asrob-uc3m/impresoras-asrob/README.md

# impresoras-asrob
Ficheros de configuración e issues de las impresoras Blacky e Hija Resurrection

Actualmente existe un grupo de trabajo activo trabajando en ellas. Para más información, visitar: [Printer One: A Clone Wars Story](https://asrob.uc3m.es/workgroups/2017-05-28-printer-one.html)
