asrob-uc3m/impresoras-asrob/Spicy/Marlin/RADME.md

Ficheros de configuración para Marlin 1.1.9: https://github.com/MarlinFirmware/Marlin/releases/tag/1.1.9
