asrob-uc3m/impresoras-asrob/Reto Clone Wars OSHWDem 2018/Readme.md

# Reto Clone Wars OSHWDem 2018

En esta carpeta se alojaran los diseños para la OSHWDem 2018
