asrob-uc3m/impresoras-asrob/Backup S.O configuraciones y aplicaciones de equipos de impresion/README.md

## Backup de Sistema Operativo, configuraciones y aplicaciones de los equipos de impresión de Blacky e Hija Resurrection





Este obra está bajo una licencia de [Creative Commons Reconocimiento-NoComercial-CompartirIgual 3.0 Unported.
](http://creativecommons.org/licenses/by-nc-sa/3.0/deed.es_ES)

Para llevar a cabo el proceso de restauración o backup del sistema completo, se ha empleado la herramienta Clonezilla. Clonezilla es un software libre de recuperación ante desastres, sirve para la clonación de discos y particiones. Clonezilla está diseñado por Steven Shaiu y desarrollado por el NCHC Labs en Taiwán.
Durante el proceso de restauración backup, la versión empleada fué "stable - 2.5.2-31", sin embargo, para procesos posteriores de backup y/o restauración, puede emplearse la versión actual, dado que se trata de un sofware retrocompatible.
Clonezilla puede descargarse en caso de ser necesario desde el acceso ( [descargar](http://clonezilla.org/downloads.php) ). 

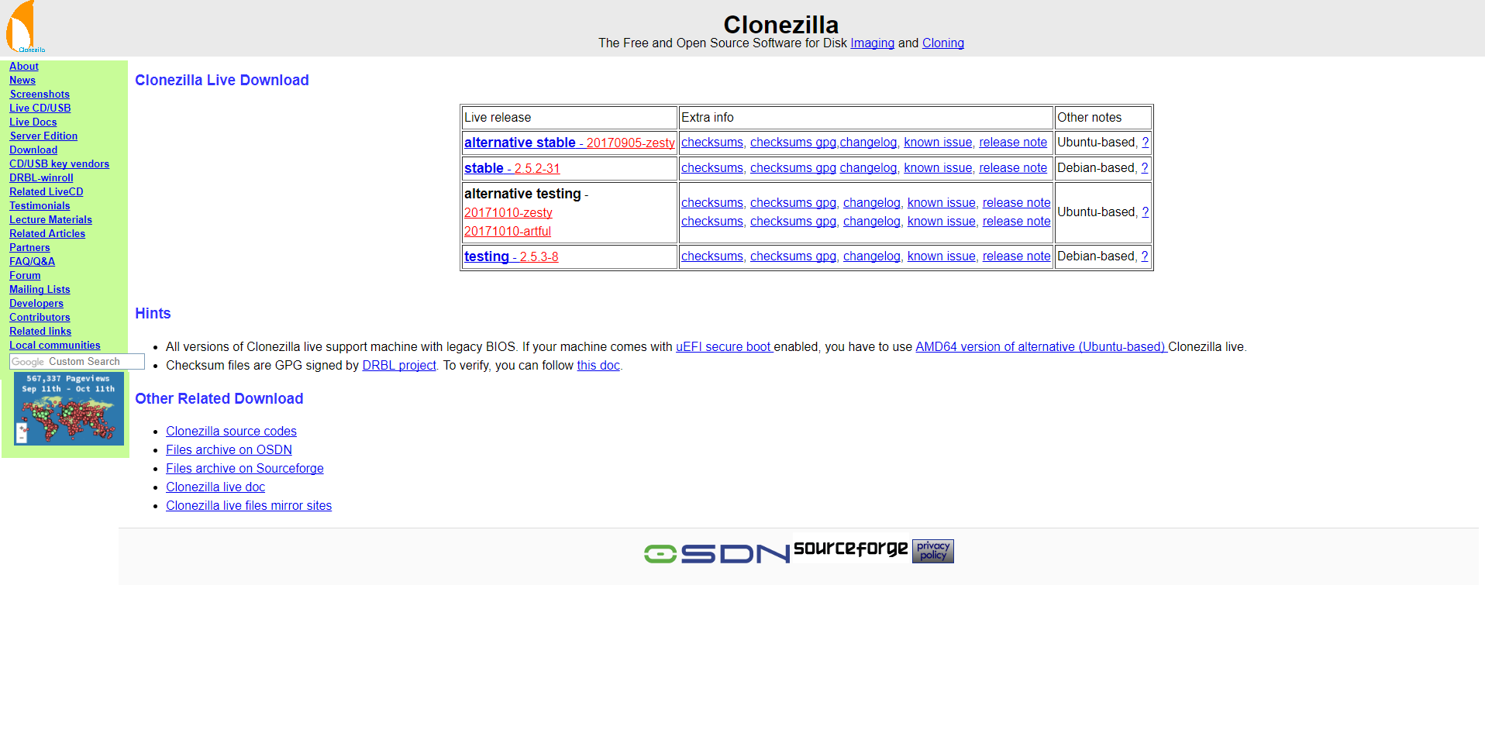
[picture p1: Backup S.O configuraciones y aplicaciones de equipos de impresion/Clonezilla.png]


*Figura 1: Descarga de DVD Live Clonezilla*

### 1- Backup del sistema

Para acceder a la imagen de backup del sistema operativo, configuraciones y aplicaciones de los ordenadores ASROB de control de las impresoras Blacky e Hija Resurrection haga clic ( [descargar](https://sourceforge.net/projects/asrob/files/Backup_OS_3D_Printers_PCs/) ). 

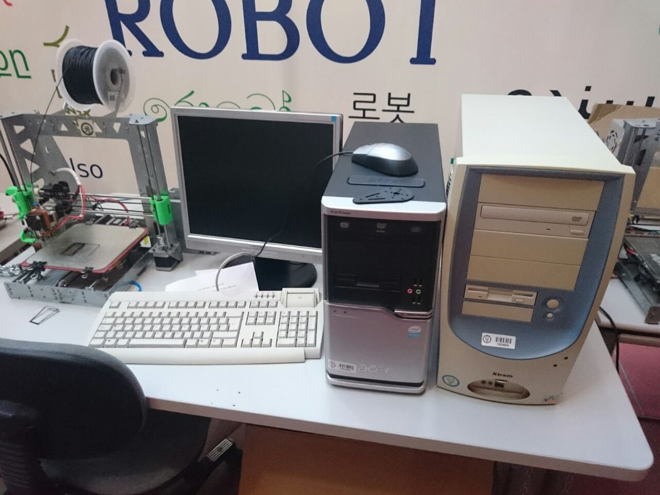
[picture p2: Backup S.O configuraciones y aplicaciones de equipos de impresion/PC.jpg]


*Figura 2: Backup del sistema*

### 2- Reinstalación del backup 

Para llevar a cabo la reinstalación de un Backup ya realizado, por favor, consulte el manual de mantenimiento de las impresoras, en el ANEXO 3, mediante( [acceder](https://github.com/asrob-uc3m/impresoras-maintenance-manual-i3/blob/master/anexo_3_reinstalacion_de_sistema_operativo_software_y_configuraciones_desde_backup.md) )

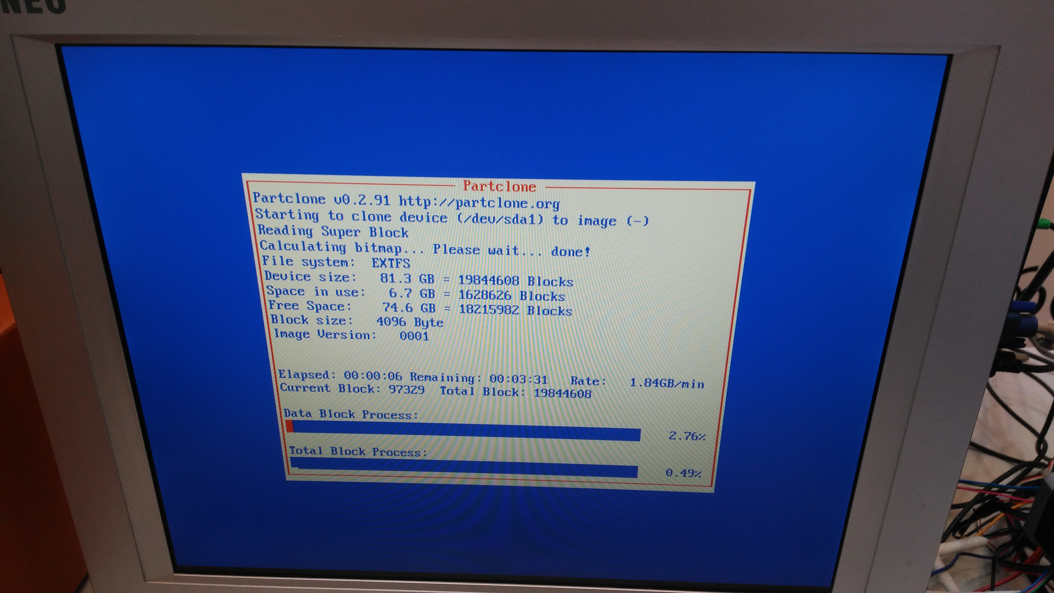
[picture p3: Backup S.O configuraciones y aplicaciones de equipos de impresion/Proceso_de_backup_19.jpg]


*Figura 3: Reinstalación del Backup*

### 3- Realizar un nuevo backup del sistema

Para llevar a cabo la un nuevo  Backup del sistema, por favor, consulte el manual de mantenimiento de las impresoras, en el ANEXO 4, facilitado, mediante( [acceder](https://github.com/asrob-uc3m/impresoras-maintenance-manual-i3/blob/master/anexo_4_proceso_de_backup_del_s.o_configuraciones_y_software.md) )

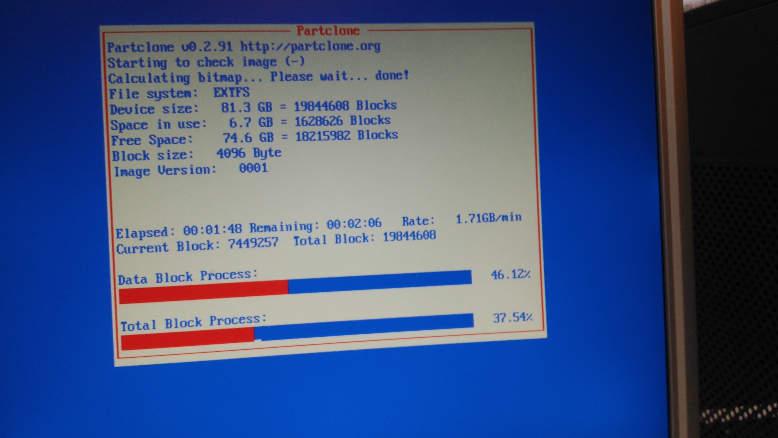
[picture p4: Backup S.O configuraciones y aplicaciones de equipos de impresion/Proceso_de_backup_20.jpg]


*Figura 4: Proceso de backup*

Para más información, fuente ( [Clonezilla](http://clonezilla.org/clonezilla-usage/general-live-use.php) ).
