asrob-uc3m/impresoras-asrob/Backup_Codigo-Web_Operadores/README.md

## Backup código sito web Operadores

Se adjuntan los backup del sitio web de la lista de operadores autorizados.
Adjuntos dos formatos:

1. Sitio web antes del 18/10/2017
2. Sitio web actualizado el 18/10/2017
