asrob-uc3m/impresoras-asrob/Hija Resurrection/README.txt

ARCHIVOS DE CONFIGURACIÓN DE LA IMPRESORA HIJA RESURRECTION:

Configuration.h -> Fichero de configuración de Marlin Firmware (a bordo de la Arduino). Contiene
parámetros imprescindibles para el correcto funcionamiento de la impresora.

config.ini -> Archivo de más importante de configuración de impresión, exportado desde Slic3r,
para usarlo seguir las siguientes instrucciones dentro del programa Repetier-Host ->
Slic3r/Configure/-> File -> Load Config...

slic3r.ini - Repetier-Host
custom.ini -> Repetier-Host/data
mlib.ini -> Repetier-Host/python/Lib/numpy/core/lib/npy-pkg-config
npymath.ini -> Repetier-Host/python/Lib/numpy/core/lib/npy-pkg-config
docutils.conf -> Repetier-Host/python/Lib/numpy ->f2py/docs
ParserDetails.ini -> Repetier-Host/Slic3r/lib/std/XML/SAX

ARCHIVOS DE CONFIGURACIÓN DEL PC DE LA IMPRESORA HIJA RESURRECTION:

guest-session-auto.sh -> Script de generación de usuario en sesión de invitado, creación al inicio de sesión y autodestrución con el logout de la misma.
