asrob-uc3m/impresoras-asrob/Blacky/Slic3r/1.3.0/README.md

Fichero de configuración para Slic3r 1.3.0: https://github.com/slic3r/Slic3r/releases/tag/1.3.0
