asrob-uc3m/impresoras-asrob/Backup S.O configuraciones y aplicaciones de equipos de impresion/proceso_de_backup.png

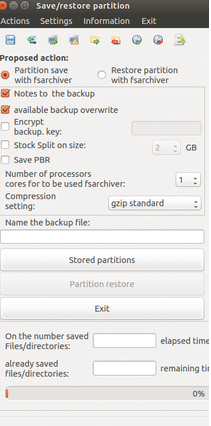
Backup S.O configuraciones y aplicaciones de equipos de impresion/proceso_de_backup.png
