asrob-uc3m/impresoras-asrob/Backup S.O configuraciones y aplicaciones de equipos de impresion/restaurar_backup.png

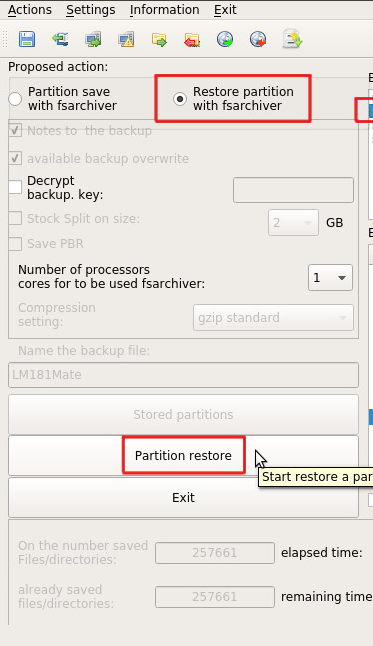
Backup S.O configuraciones y aplicaciones de equipos de impresion/restaurar_backup.png
