asrob-uc3m/impresoras-asrob/Hija Resurrection/Parts/Readme.md

# Información sobre las Piezas (orden alfabético)

* Extruder:
  * Extrusor.

* LCD:
  * Caja pantalla Full Graphic.

* Power Supply:
  * Piezas para la fuente de alimentación.

* X axis: 
  * Tensor eje X.
  * Carro eje X.

* Z axis: 
  * Ajuste fino de altura de Z.
