asrob-uc3m/impresoras-asrob/Dedalo/Parts/Readme.md

# Información sobre las Piezas (orden alfabético)

* 160mm_spool_holder_prusa.stl -> Soportes de sujección de la bobina de filamento. [Thingiverse](https://www.thingiverse.com/thing:91724).

* Bed leveling.stl -> Pieza de calibracion de la cama caliente. En ella van encajadas tuercas M3 para su fácil movimiento, y posterior ajuste de cama. [Thingiverse](https://www.thingiverse.com/thing:2333767).

* Cubierta Ventilador Externo Dédalo.stl -> Es la protección y sujección del ventilador más grande que posee Dédalo, que actualmente se necuentra ventilando la electrónica. (Diseño de [@daavm](https://github.com/daavm)). No disponible en Thingiverse.

* S26_Jonaskuehling_gregs_wade_v3_arcol_jhead_x1.stl -> Cuerpo del extrusor con agujeros para mejor anclaje del extrusor. [Thingiverse](https://www.thingiverse.com/thing:141915).

* frame-vertex-no-foot.stl -> Uniones superiores de las varillas del triángulo. Pendiente añadir enlace a Thingiverse.

* frame-vertex.stl -> Uniones inferiores de las varillas del triángulo. Pendiente añadir enlace a Thingiverse.

* mounting_plate.stl -> Pieza de sujección del extrusor. [Ya no forma parte de Dédalo](https://github.com/asrob-uc3m/impresoras-asrob/issues/31#issuecomment-343311065). Pendiente añadir enlace a Thingiverse.

* wade_custom_obijuan.stl -> Engranaje grande del extrusor. Pendiente de añadir enlace a Thingiverse.

* x-carriage.stl -> Carro del eje X. [Thingiverse](https://www.thingiverse.com/thing:181524). ATENCIÓN, antes de imprimir esta pieza de nuevo, revisar [esto](https://github.com/asrob-uc3m/impresoras-asrob/issues/31#issuecomment-336418170).
