asrob-uc3m/impresoras-asrob/Hija Resurrection/Parts/Extruder/Readme.md

# Información sobre las Piezas (orden alfabético)

* Bearing_Washer.stl -> Arandela para el rodamiento que va junto al engranaje grande. [Thingiverse](https://www.thingiverse.com/thing:512338).

* Blower_duct.stl -> Conducto para el ventilador de capa. Diseñado para blower 40x40x20. [Siotma](https://github.com/Siotma).

* Body_E3dv6_Washer.stl -> Arandela para ajutar el hotend en el hueco. [Siotma](https://github.com/Siotma).

* Gregs_Wade_Big_Gear_47.stl -> Engranaje grande del extrusor.

* Gregs_Wade_Small_Gear_9.stl -> Engranaje pequeño del extrusor.

* Idler.stl -> Apriete del filamento contra el Hobbed Bolt. [Thingiverse](https://www.thingiverse.com/thing:1855673).

* Idler_holder.stl -> Pestaña para ajustar el Idler. [Thingiverse](https://www.thingiverse.com/thing:1855673).

* Wade_L3K_custom_body_1.75_centered.stl -> Cuerpo del extrusor. Remix de [L3K](https://www.thingiverse.com/thing:512338).

* Wade_L3K_custom_flange_1.75_v2_mirrored.stl -> Apriete del hotend. Remix de [L3K](https://www.thingiverse.com/thing:512338).

* Extra: [Enlace a la issue de montaje](https://github.com/asrob-uc3m/impresoras-asrob/issues/84).
