asrob-uc3m/impresoras-asrob/Hija Resurrection/Parts/LCD/Readme.md

# Información sobre las Piezas (orden alfabético)

* case_top.STL -> Tapa superior de la caja de la pantalla LCD Full Graphic. [Thingiverse](https://www.thingiverse.com/thing:638833).

* case-bottom.stl -> Tapa inferior de la caja de la pantalla LCD Full Graphic. [Thingiverse](https://www.thingiverse.com/thing:638833).

* rotary_knob.STL -> Pomo de la ruleta giratoria de la pantalla LCD Full Graphic. [Thingiverse](https://www.thingiverse.com/thing:638833).
