asrob-uc3m/impresoras-asrob/Hija Resurrection/Parts/Power Supply/Readme.md

# Información sobre las Piezas (orden alfabético)

* Power_Supply_cover-P3steel.STL -> Cubierta de los contactos e interruptor de la fuente de alimentación. [Thingiverse](https://www.thingiverse.com/thing:2158480).

* Extra: [enlace a la issue de montaje](https://github.com/asrob-uc3m/impresoras-asrob/issues/68).
