asrob-uc3m/impresoras-asrob/Hija Resurrection/Parts/X axis/Readme.md

# Información sobre las Piezas (orden alfabético)

* x_carriage_holder_jg7.stl -> Apriete de la correa del carro del eje X. [Thingiverse](https://www.thingiverse.com/thing:701087).

* x_carriage_jg7.stl -> Carro del eje X. Hay que insertar una tuerca durante la impresión. [Thingiverse](https://www.thingiverse.com/thing:701087)

* xaxis_idler.stl -> Cuerpo del tensor del eje X. [Thingiverse](https://www.thingiverse.com/thing:247992)

* xaxis_idler_holder_rev02.stl -> Montura de la polea de la correa del eje X. [Thingiverse](https://www.thingiverse.com/thing:247992)

* xaxis_idler_tensioner_rev02.stl -> Tensor del eje X. [Thingiverse](https://www.thingiverse.com/thing:247992)
