asrob-uc3m/impresoras-asrob/Hija Resurrection/Parts/Z axis/Readme.md

# Información sobre las Piezas (orden alfabético)

* Z_Level_Adjstment_Foot_PFM.STL -> Pie del tornillo de ajuste fino de altura. [Thingiverse](https://www.thingiverse.com/thing:1776429).

* Z_Level_Adjstment_Switch_Mount_PFM.STL -> Montura del endstop de ajuste fino de altura. [Thingiverse](https://www.thingiverse.com/thing:1776429).

* Z_level_Fine_Adjustment_Leg_PFM.STL -> Montura del tornillo de ajuste fino de altura. [Thingiverse](https://www.thingiverse.com/thing:1776429).
