asrob-uc3m/impresoras-asrob/Blacky/Parts/README.MD

Aquí podremos encontrar las piezas de recambio para **Blacky**:
https://www.thingiverse.com/thing:371842

_Originalmente son para la impresora "Prusa I3 Hephestos"._
