asrob-uc3m/impresoras-asrob/Blacky/Parts/Extruder/Blower_duct_v2.stl

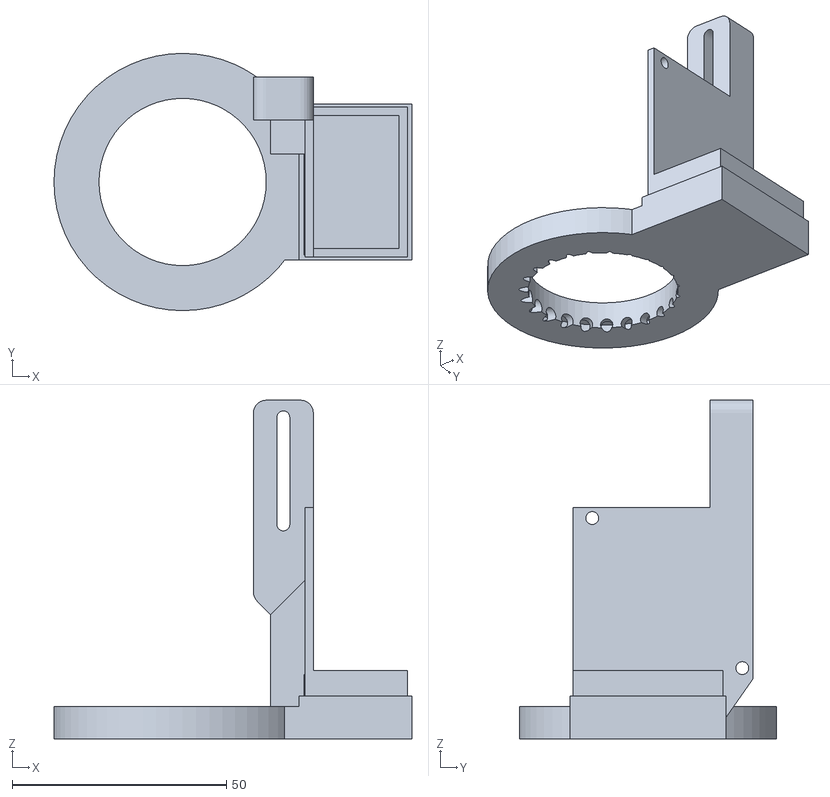
[picture p34: CAD file, 2019-01-30]
Blacky/Parts/Extruder/Blower_duct_v2.stl
83.5 x 60.0 x 79.0
