asrob-uc3m/impresoras-asrob/Blacky/Parts/LCD/lcd-hinge.stl

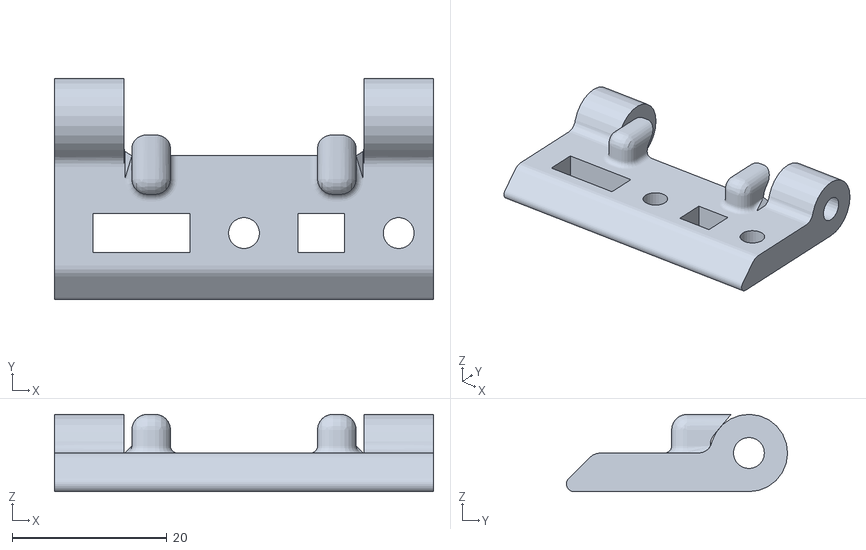
[picture p35: CAD file, 2017-12-14]
Blacky/Parts/LCD/lcd-hinge.stl
49.0 x 28.6 x 10.0
