asrob-uc3m/impresoras-asrob/Dedalo/Parts/S26_Jonaskuehling_gregs_wade_v3_arcol_jhead_x1.stl

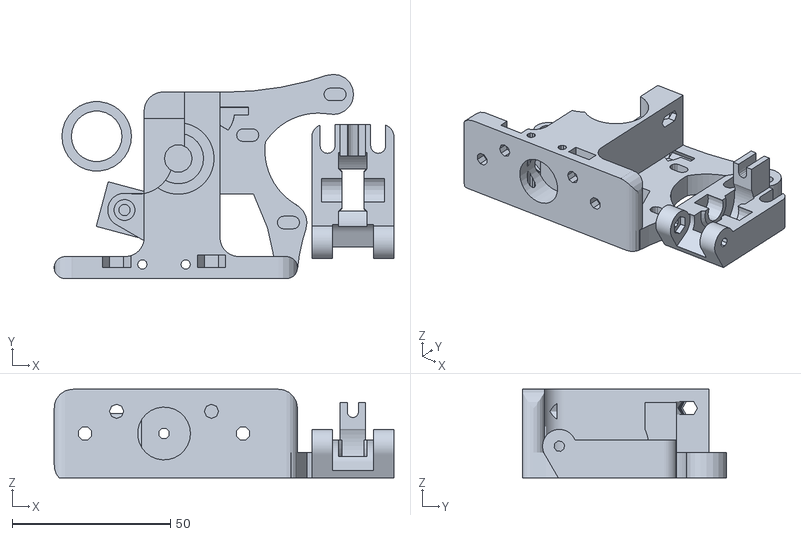
[picture p36: CAD file, 2017-12-09]
Dedalo/Parts/S26_Jonaskuehling_gregs_wade_v3_arcol_jhead_x1.stl
107.5 x 64.6 x 28.0
