asrob-uc3m/impresoras-asrob/Geonosis/Parts/equerre_moteur_X.STL

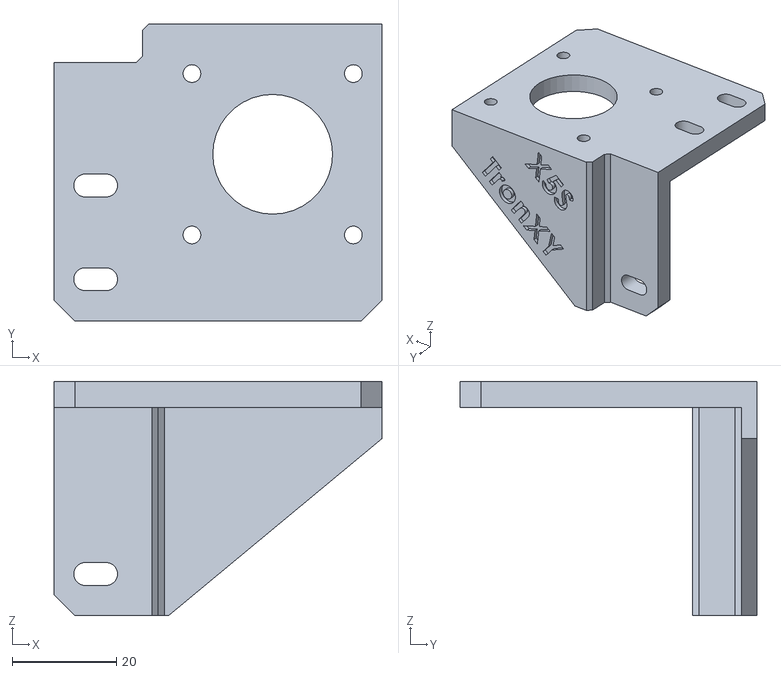
[picture p37: CAD file, 2018-09-19]
Geonosis/Parts/equerre_moteur_X.STL
63.0 x 57.0 x 45.0
