asrob-uc3m/impresoras-asrob/Hija Resurrection/Parts/Extruder/Wade_L3K_custom_flange_1.75_v2_mirrored.stl

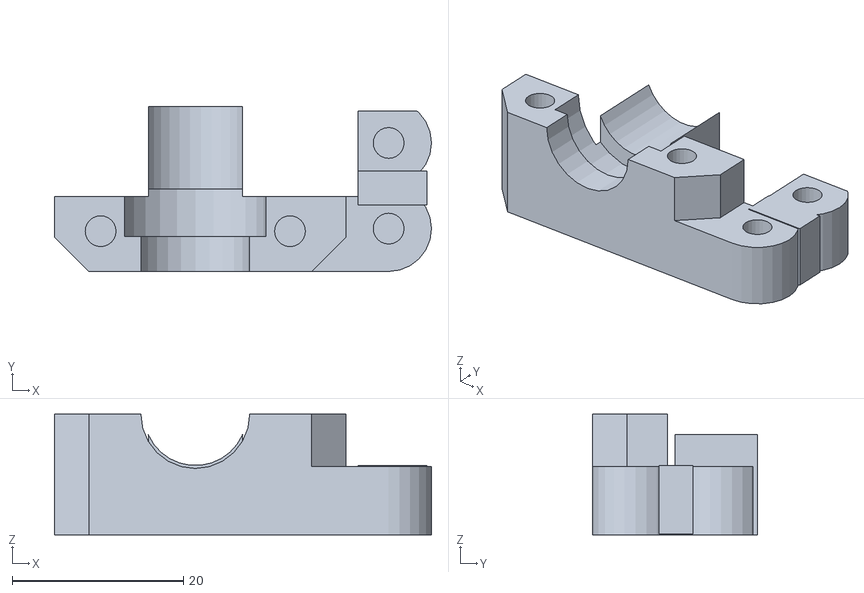
[picture p38: CAD file, 2018-10-14]
Hija Resurrection/Parts/Extruder/Wade_L3K_custom_flange_1.75_v2_mirrored.stl
44.0 x 19.3 x 14.1
