asrob-uc3m/impresoras-asrob/Hija Resurrection/Parts/LCD/case-bottom.stl

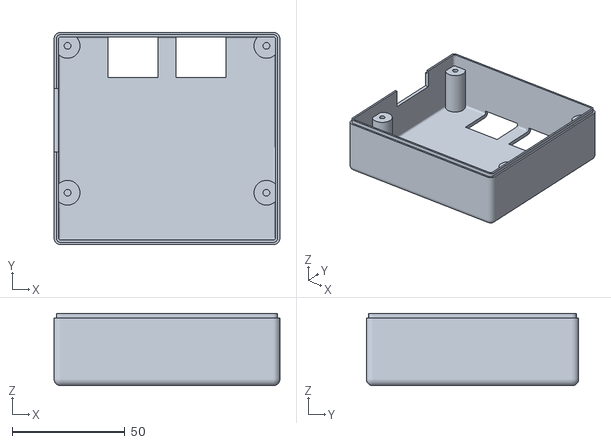
[picture p39: CAD file, 2018-10-14]
Hija Resurrection/Parts/LCD/case-bottom.stl
100.0 x 94.0 x 32.0
