asrob-uc3m/impresoras-asrob/Hija Resurrection/Parts/Power Supply/Power_Supply_cover-P3steel.STL

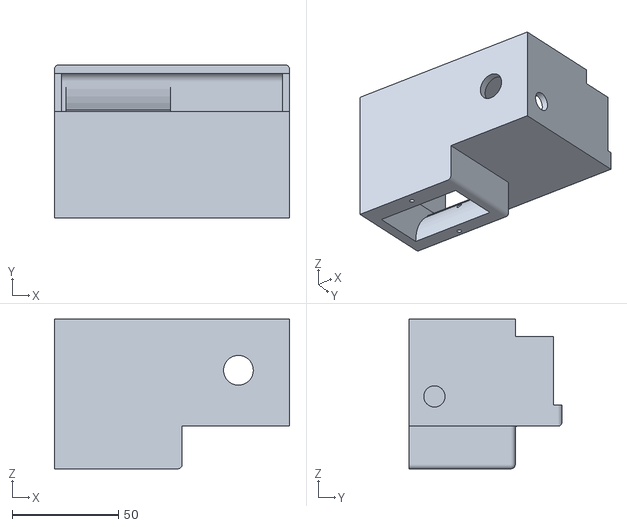
[picture p40: CAD file, 2018-10-14]
Hija Resurrection/Parts/Power Supply/Power_Supply_cover-P3steel.STL
110.4 x 72.0 x 70.3
