asrob-uc3m/impresoras-asrob/Hija Resurrection/Parts/X axis/x_carriage_holder_jg7.stl

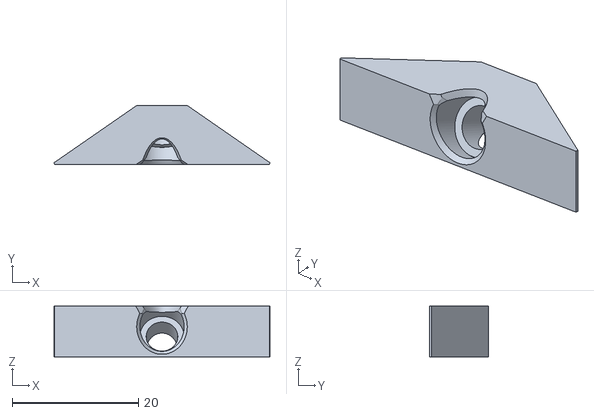
[picture p41: CAD file, 2018-10-14]
Hija Resurrection/Parts/X axis/x_carriage_holder_jg7.stl
34.2 x 9.35 x 8.00
