asrob-uc3m/impresoras-asrob/Hija Resurrection/Parts/Z axis/Z_Level_Adjstment_Foot_PFM.STL

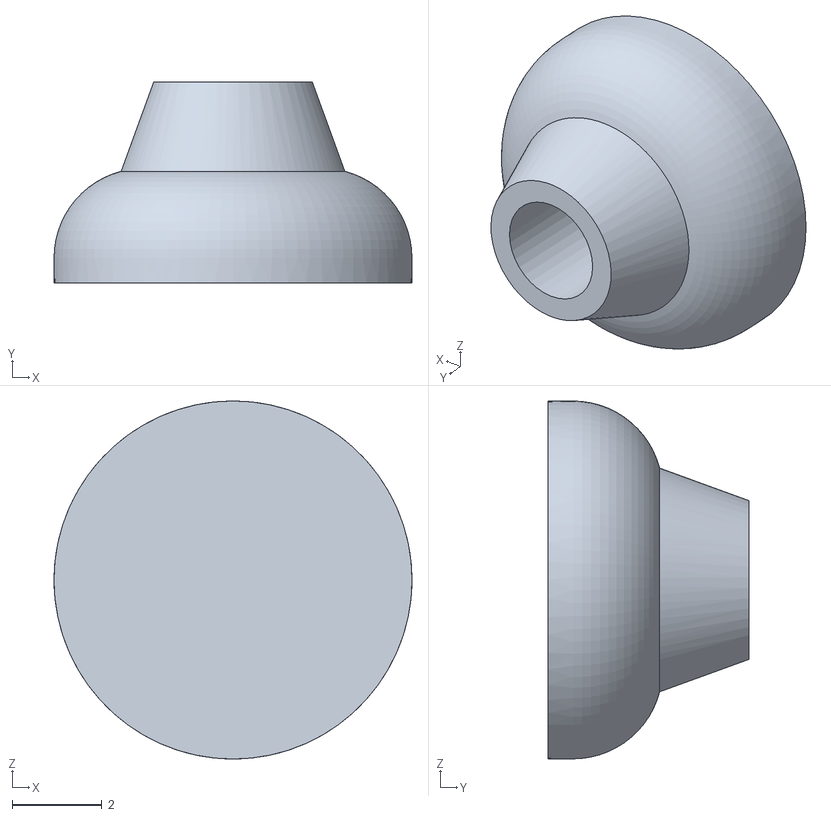
[picture p42: CAD file, 2018-10-14]
Hija Resurrection/Parts/Z axis/Z_Level_Adjstment_Foot_PFM.STL
8.00 x 4.50 x 8.00
