asrob-uc3m/impresoras-asrob/Reto Clone Wars OSHWDem 2018/N-34 ASROB_repaired.3mf

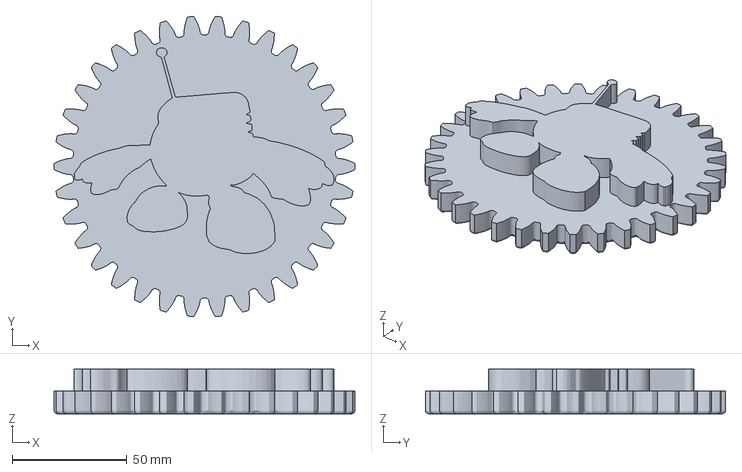
[picture p43: CAD file, 2018-10-24]
Reto Clone Wars OSHWDem 2018/N-34 ASROB_repaired.3mf
131.4 x 131.1 x 19.5 mm
