asrob-uc3m/impresoras-asrob/Spicy/Parts/Anet_A8_Fan_Optimized.stl

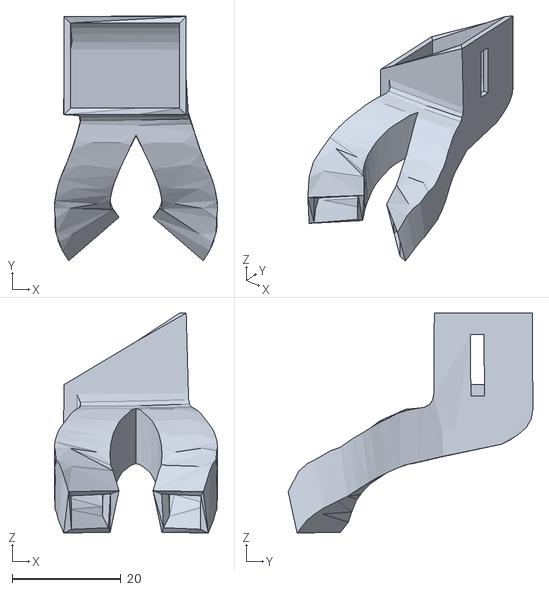
[picture p44: CAD file, 2018-09-19]
Spicy/Parts/Anet_A8_Fan_Optimized.stl
30.0 x 45.0 x 40.4
