asrob-uc3m/impresoras-asrob/Blacky/Parts/LCD/Soporte_lcd.stl

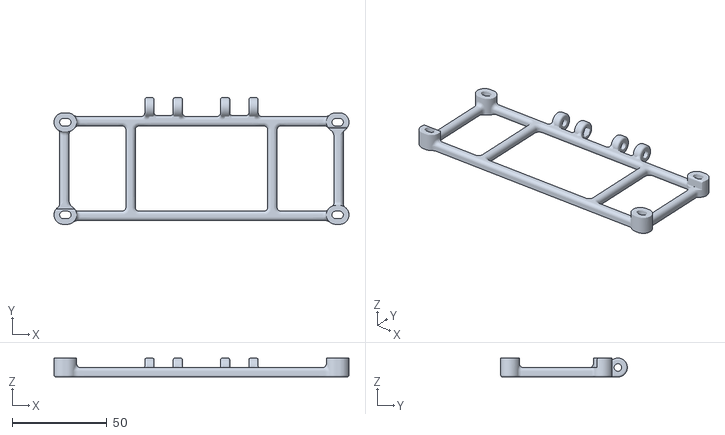
[picture p45: CAD file, 2017-12-14]
Blacky/Parts/LCD/Soporte_lcd.stl
156.0 x 67.0 x 10.0
