asrob-uc3m/impresoras-asrob/Dedalo/Parts/x-carriage.stl

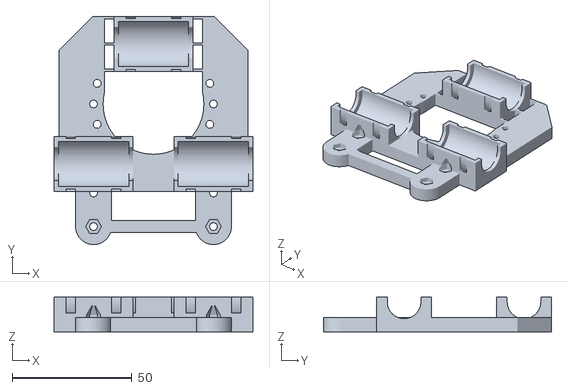
[picture p46: CAD file, 2017-12-09]
Dedalo/Parts/x-carriage.stl
83.0 x 95.2 x 14.5
