asrob-uc3m/impresoras-asrob/Geonosis/Parts/Sym_equerre_moteur_X.STL

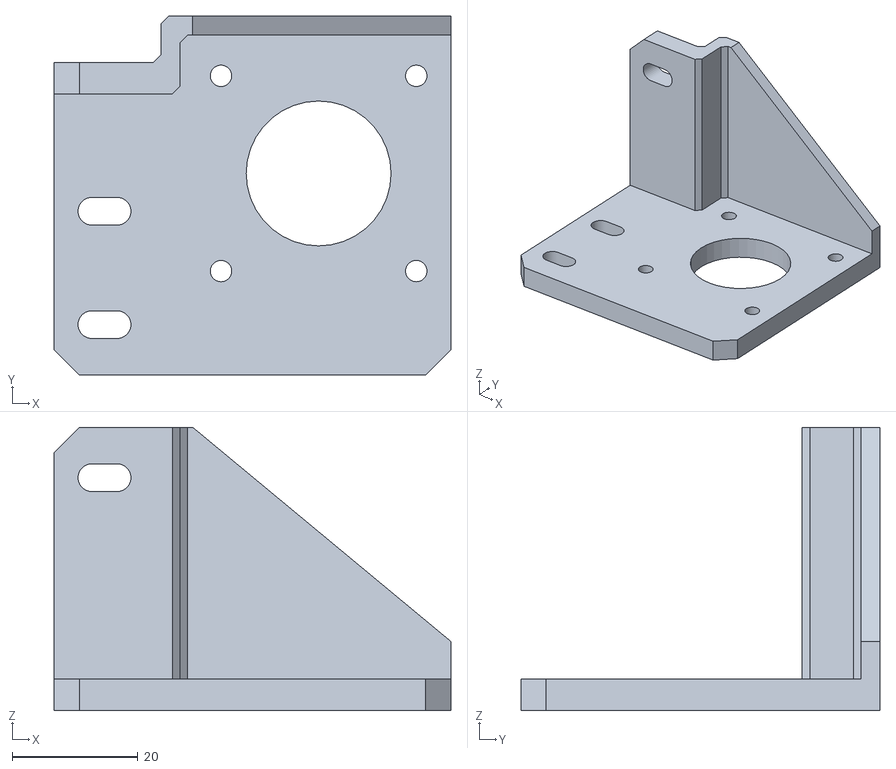
[picture p47: CAD file, 2018-09-19]
Geonosis/Parts/Sym_equerre_moteur_X.STL
63.0 x 57.0 x 45.0
