asrob-uc3m/impresoras-asrob/Hija Resurrection/Parts/Extruder/Wade_L3K_custom_body_1.75_centered.stl

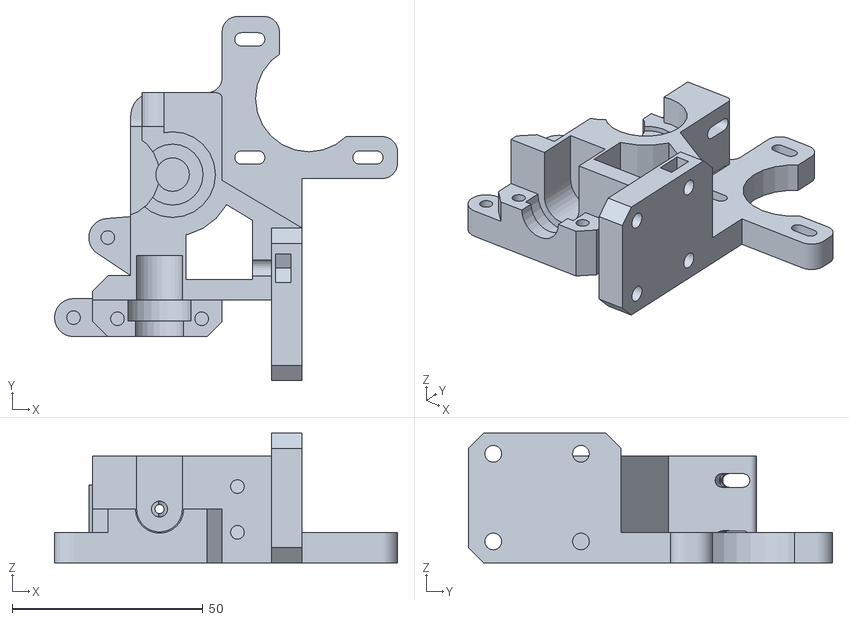
[picture p48: CAD file, 2018-10-14]
Hija Resurrection/Parts/Extruder/Wade_L3K_custom_body_1.75_centered.stl
90.0 x 95.5 x 34.0
