asrob-uc3m/impresoras-asrob/Hija Resurrection/Parts/LCD/case_top.STL

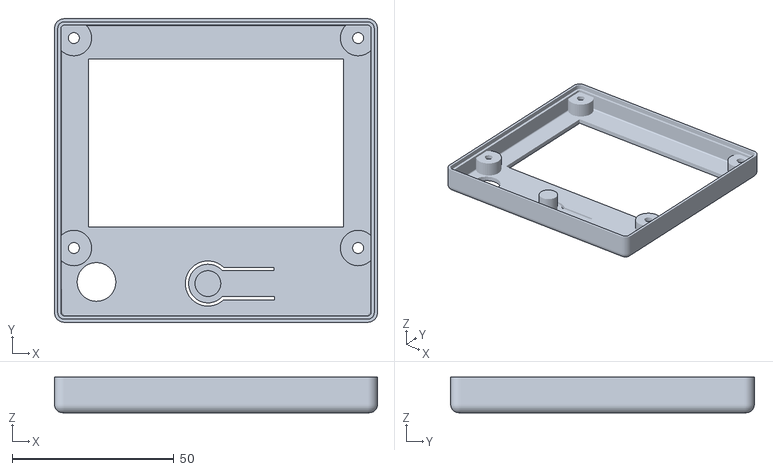
[picture p49: CAD file, 2018-10-14]
Hija Resurrection/Parts/LCD/case_top.STL
100.0 x 94.0 x 11.0
