asrob-uc3m/impresoras-asrob/Hija Resurrection/Parts/X axis/xaxis_idler.stl

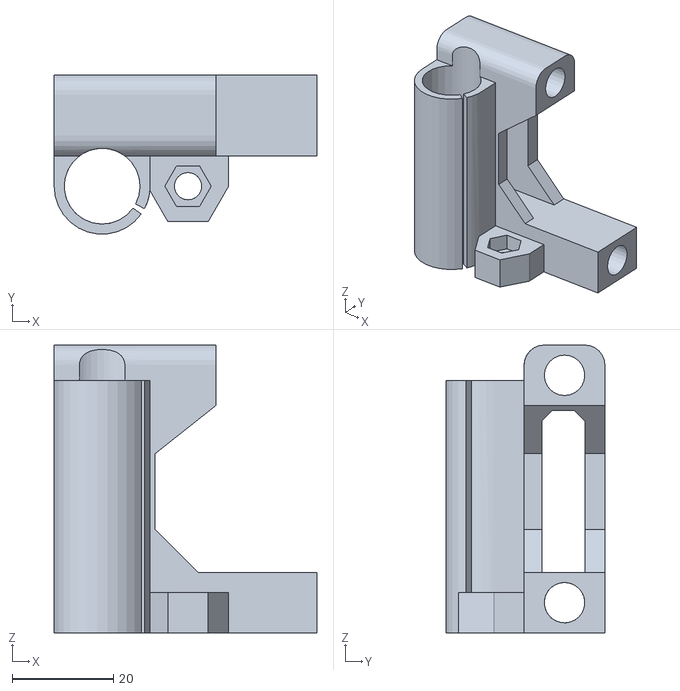
[picture p50: CAD file, 2018-10-14]
Hija Resurrection/Parts/X axis/xaxis_idler.stl
52.0 x 31.5 x 57.0
