asrob-uc3m/impresoras-asrob/Hija Resurrection/Parts/Z axis/Z_level_Fine_Adjustment_Leg_PFM.STL

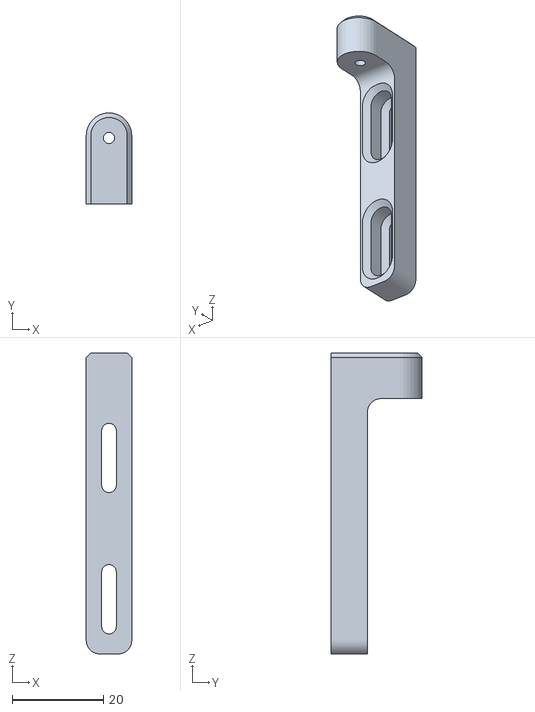
[picture p51: CAD file, 2018-10-14]
Hija Resurrection/Parts/Z axis/Z_level_Fine_Adjustment_Leg_PFM.STL
10.00 x 20.0 x 66.0
