asrob-uc3m/impresoras-asrob/Reto Clone Wars OSHWDem 2018/N-34 Printer_repaired.3mf

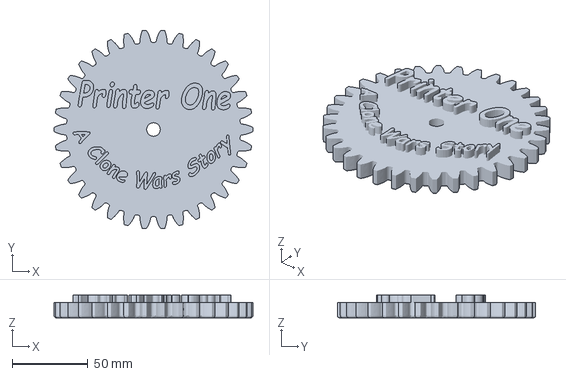
[picture p52: CAD file, 2018-10-24]
Reto Clone Wars OSHWDem 2018/N-34 Printer_repaired.3mf
131.4 x 131.1 x 15.0 mm
