asrob-uc3m/impresoras-asrob/Blacky/Parts/Extruder/Idler_hodler.stl

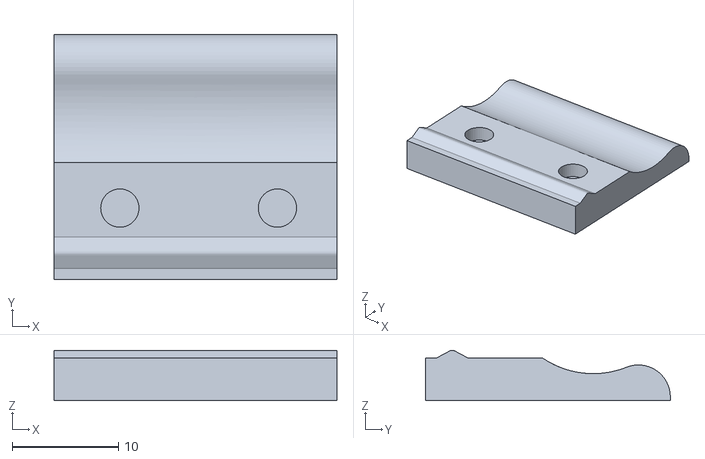
[picture p53: CAD file, 2018-10-14]
Blacky/Parts/Extruder/Idler_hodler.stl
26.6 x 23.0 x 4.73
