asrob-uc3m/impresoras-asrob/Dedalo/Parts/160mm_spool_holder_prusa.stl

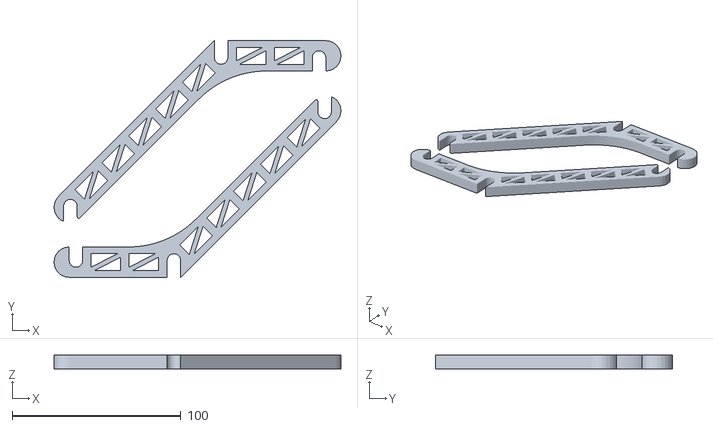
[picture p54: CAD file, 2017-12-09]
Dedalo/Parts/160mm_spool_holder_prusa.stl
169.9 x 140.2 x 8.00
