asrob-uc3m/impresoras-asrob/Hija Resurrection/Parts/LCD/rotary_knob.STL

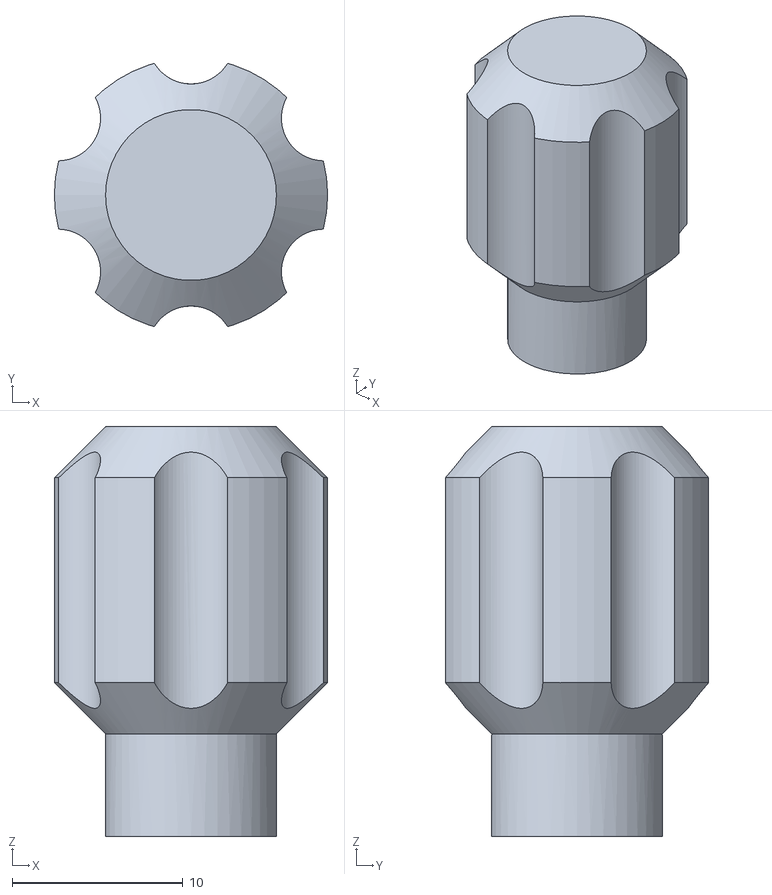
[picture p55: CAD file, 2018-10-14]
Hija Resurrection/Parts/LCD/rotary_knob.STL
16.0 x 15.4 x 24.0
