asrob-uc3m/impresoras-asrob/Hija Resurrection/Parts/X axis/xaxis_idler_holder_rev02.stl

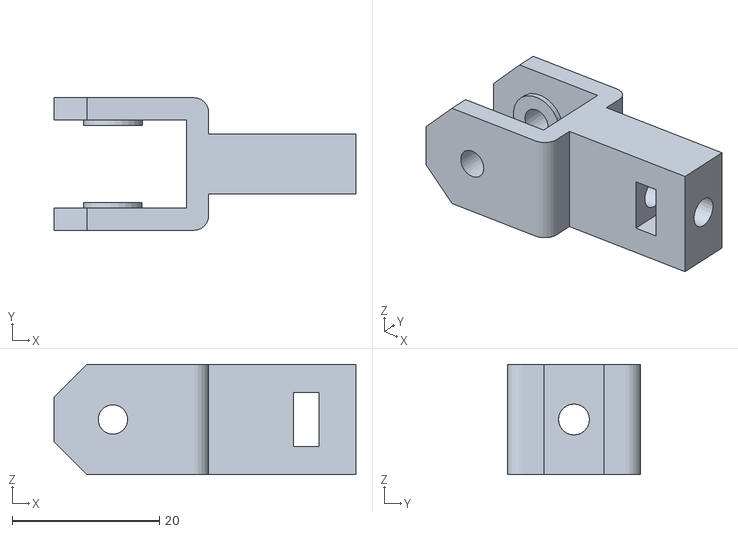
[picture p56: CAD file, 2018-10-14]
Hija Resurrection/Parts/X axis/xaxis_idler_holder_rev02.stl
41.0 x 18.0 x 15.0
