asrob-uc3m/impresoras-asrob/Hija Resurrection/Parts/Z axis/Z_Level_Adjstment_Switch_Mount_PFM.STL

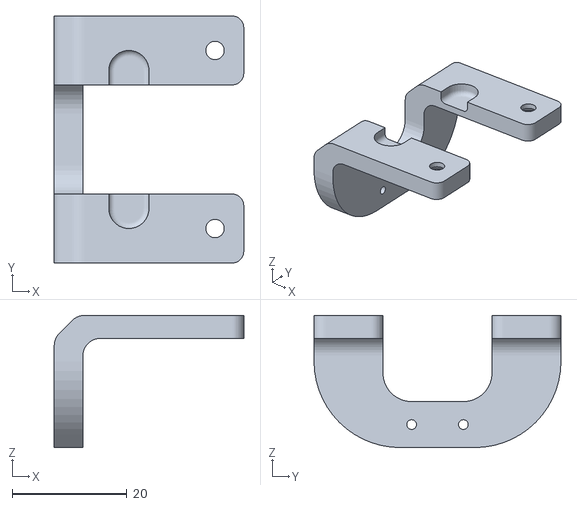
[picture p57: CAD file, 2018-10-14]
Hija Resurrection/Parts/Z axis/Z_Level_Adjstment_Switch_Mount_PFM.STL
33.0 x 43.0 x 23.0
