asrob-uc3m/impresoras-asrob/Reto Clone Wars OSHWDem 2018/N34-ASROB.FCStd

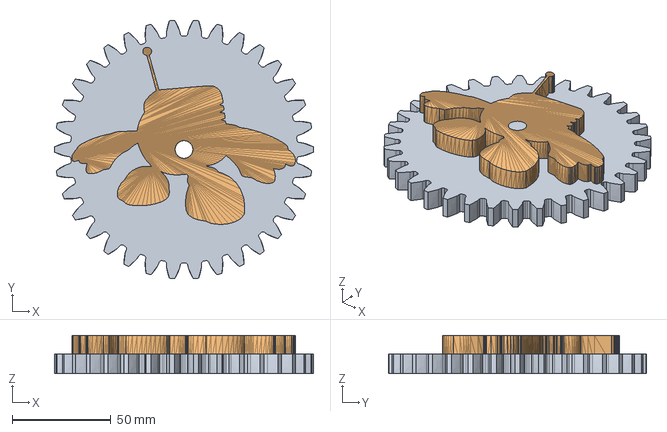
[picture p58: CAD file, 2018-10-24]
Reto Clone Wars OSHWDem 2018/N34-ASROB.FCStd
131.4 x 131.1 x 19.5 mm
