asrob-uc3m/impresoras-asrob/Dedalo/Parts/mounting_plate.stl

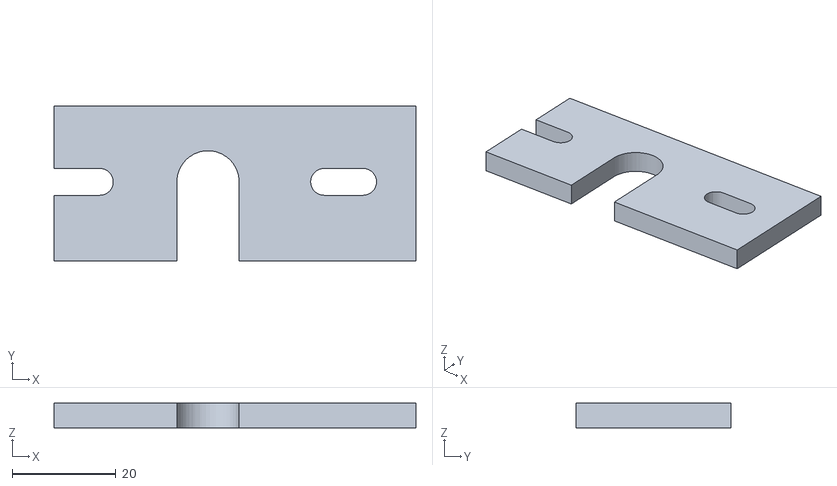
[picture p59: CAD file, 2017-12-06]
Dedalo/Parts/mounting_plate.stl
69.8 x 29.8 x 4.76
