asrob-uc3m/impresoras-asrob/Hija Resurrection/Parts/Extruder/Gregs_Wade_Small_Gear_9.stl

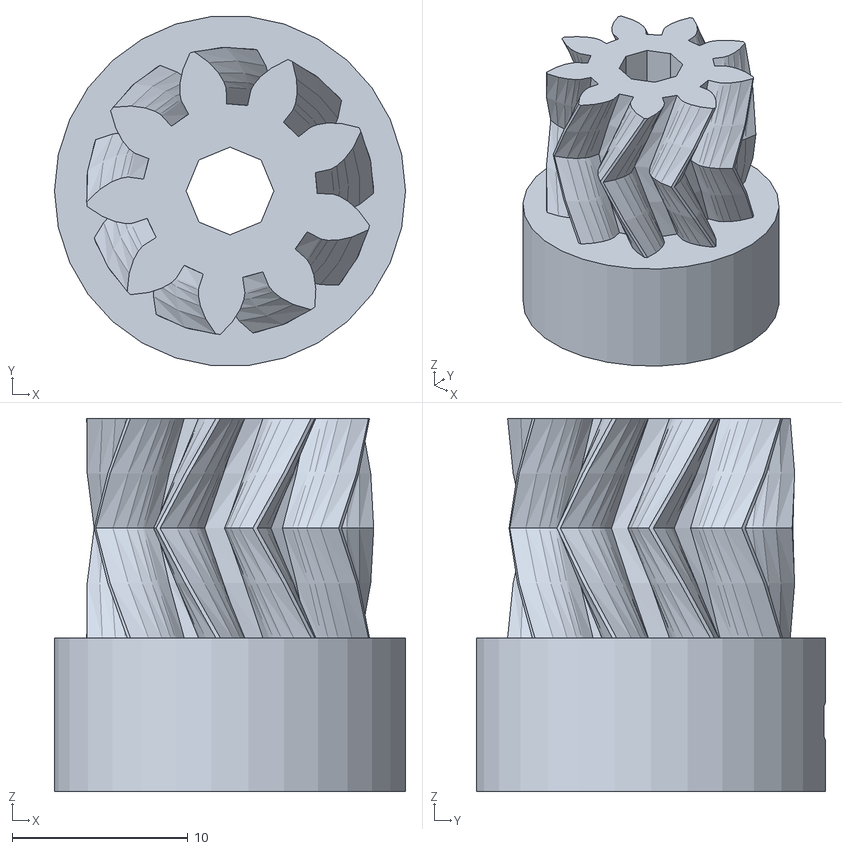
[picture p60: CAD file, 2018-02-02]
Hija Resurrection/Parts/Extruder/Gregs_Wade_Small_Gear_9.stl
20.0 x 19.9 x 21.3
