asrob-uc3m/impresoras-asrob/Hija Resurrection/Parts/X axis/x_carriage_jg7.stl

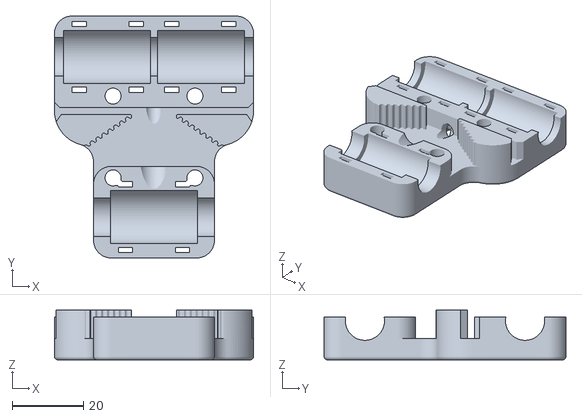
[picture p61: CAD file, 2018-10-14]
Hija Resurrection/Parts/X axis/x_carriage_jg7.stl
56.0 x 68.0 x 14.0
