asrob-uc3m/impresoras-asrob/Reto Clone Wars OSHWDem 2018/N34-Printer.FCStd

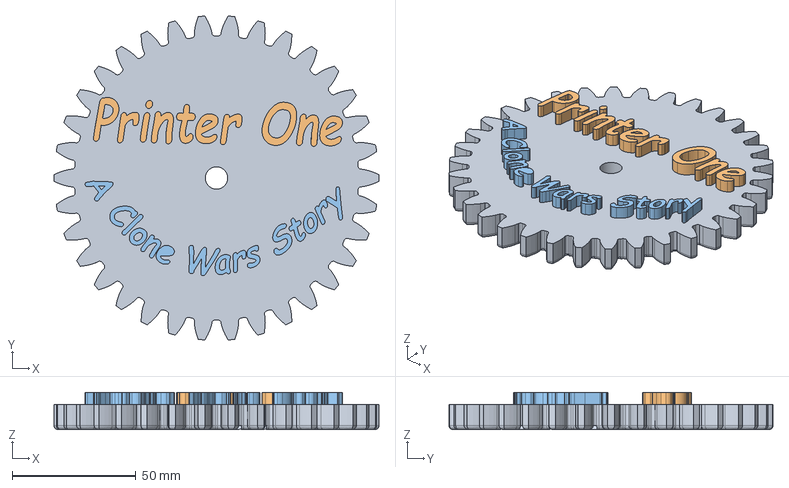
[picture p62: CAD file, 2018-10-24]
Reto Clone Wars OSHWDem 2018/N34-Printer.FCStd
131.4 x 131.1 x 15.1 mm
Clone of Fusion
Clone of Fusion001
