asrob-uc3m/impresoras-asrob/Blacky/Parts/Extruder/Idler.stl

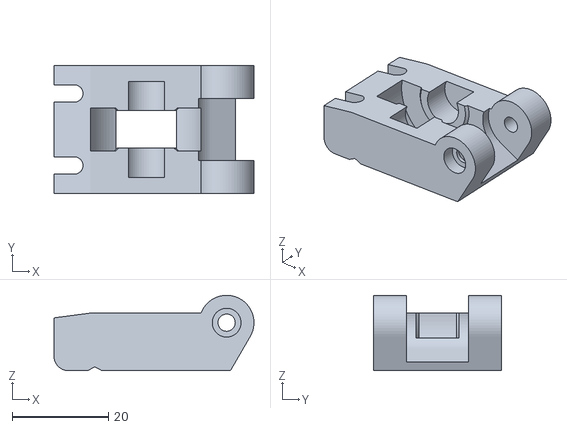
[picture p63: CAD file, 2018-10-14]
Blacky/Parts/Extruder/Idler.stl
41.7 x 26.6 x 15.7
