asrob-uc3m/impresoras-asrob/Dedalo/Parts/wade_custom_obijuan.stl

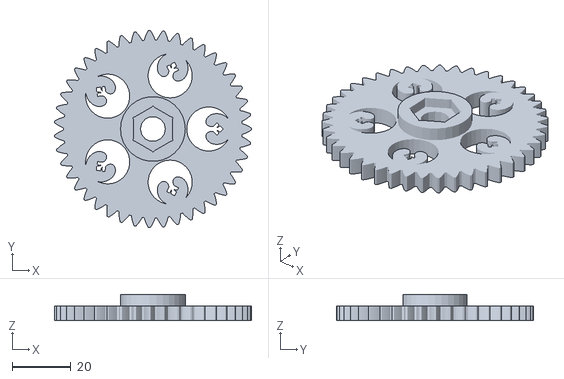
[picture p64: CAD file, 2017-12-06]
Dedalo/Parts/wade_custom_obijuan.stl
66.9 x 67.0 x 9.00
