asrob-uc3m/impresoras-asrob/Hija Resurrection/Parts/Extruder/Gregs_Wade_Big_Gear_47.stl

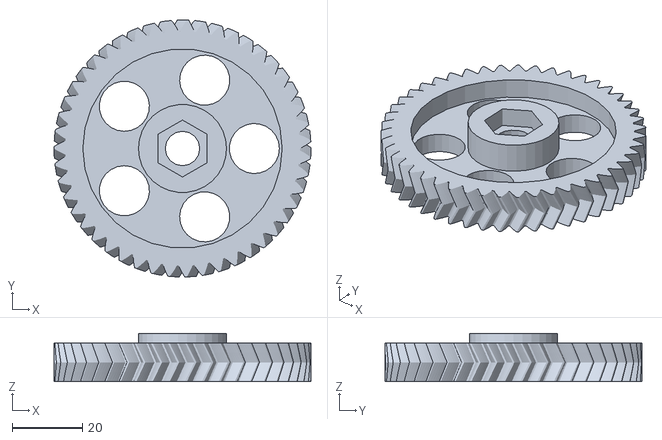
[picture p65: CAD file, 2018-02-02]
Hija Resurrection/Parts/Extruder/Gregs_Wade_Big_Gear_47.stl
73.0 x 73.0 x 13.8
