asrob-uc3m/impresoras-asrob/Hija Resurrection/Parts/X axis/xaxis_idler_tensioner_rev02.stl

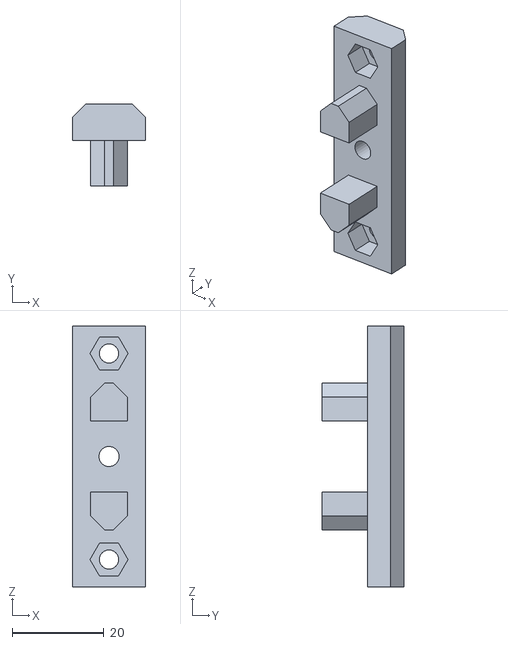
[picture p66: CAD file, 2018-10-14]
Hija Resurrection/Parts/X axis/xaxis_idler_tensioner_rev02.stl
16.0 x 18.0 x 57.0
