asrob-uc3m/impresoras-asrob/Dedalo/Parts/frame-vertex.stl

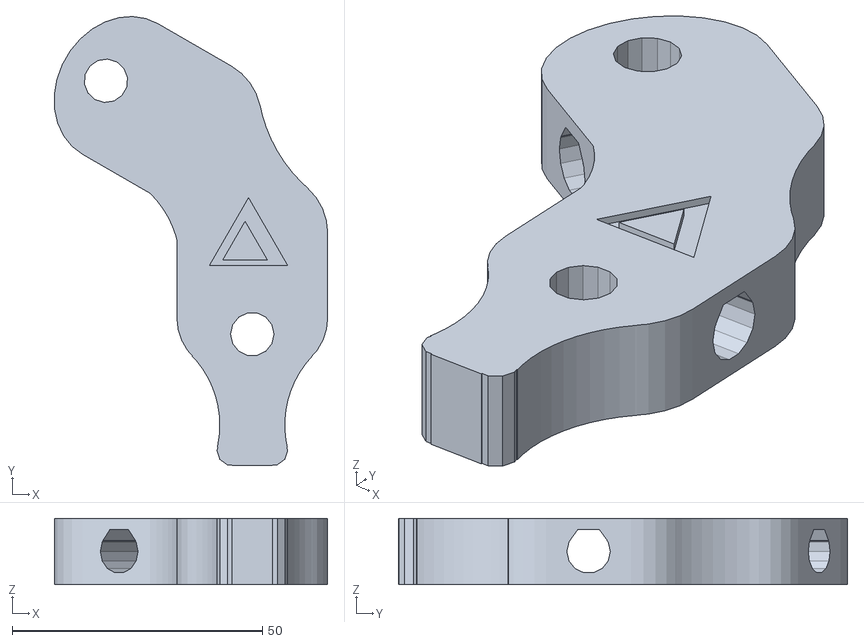
[picture p67: CAD file, 2017-12-06]
Dedalo/Parts/frame-vertex.stl
54.7 x 89.8 x 13.2
