asrob-uc3m/impresoras-asrob/Dedalo/Parts/frame-vertex-no-foot.stl

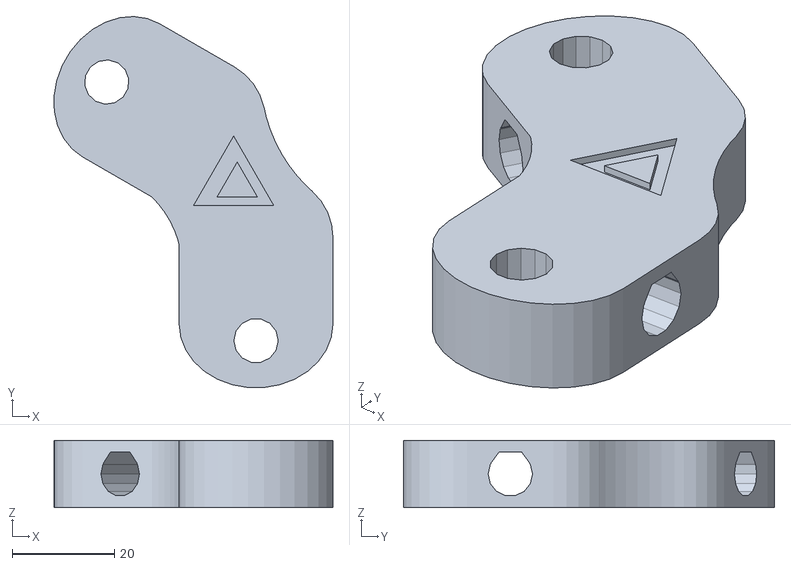
[picture p68: CAD file, 2017-12-06]
Dedalo/Parts/frame-vertex-no-foot.stl
54.7 x 72.7 x 13.2
