asrob-uc3m/impresoras-asrob/Dedalo/Parts/Bed leveling.stl

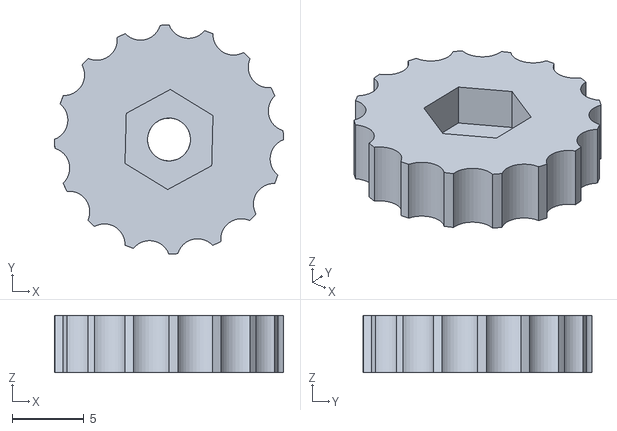
[picture p69: CAD file, 2017-12-06]
Dedalo/Parts/Bed leveling.stl
16.0 x 16.0 x 4.00
