asrob-uc3m/impresoras-asrob/Dedalo/Parts/Cubierta Ventilador Externo Dédalo.stl

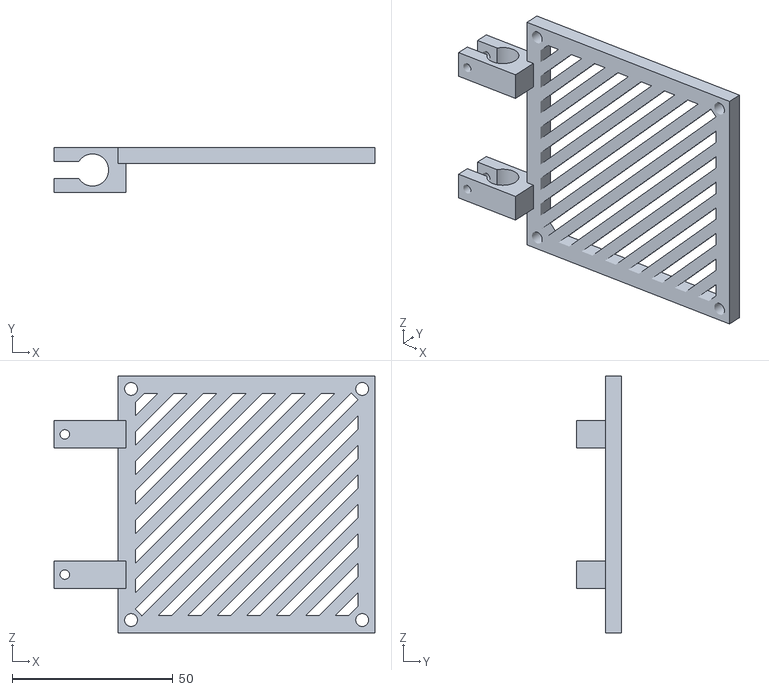
[picture p70: CAD file, 2017-11-13]
Dedalo/Parts/Cubierta Ventilador Externo Dédalo.stl
100.0 x 14.0 x 80.0
