asrob-uc3m/impresoras-asrob/(list of files, cad)

Other CAD files:
Hija Resurrection/Parts/Extruder/Blower_duct.stl
Blacky/Parts/Extruder/Bearing_Washer.stl
Blacky/Parts/Extruder/Body_E3dv6_Washer.stl
Reto Clone Wars OSHWDem 2018/N-34 ASROB.stl
Reto Clone Wars OSHWDem 2018/N-34 Printer.stl
