asrob-uc3m/impresoras-asrob/(threads)

Thread 1 (2016-06-06):

Queremos actualizar versión software de control

kleiren, 2016-06-06:
Las versiones de Repetier y de los generadores de G-Code en los PC de control de las impresoras son bastante antiguas, ¿hay alguna razón para eso? ¿Podrían ser actualizados?.
La cuestión de seguir teniendo Windows XP en esos PC también es discutible.

jgvictores, 2016-06-07:
Hi @kleiren,
En la actualidad estamos mejorando la documentación de lo que existe y funciona: [Manual de usuario de los i3](https://www.gitbook.com/book/asrobuc3m/impresoras-user-manual-i3/details), [Manual de mantenimiento de los i3](https://www.gitbook.com/book/asrobuc3m/impresoras-maintenance-manual-i3/details).
Para llevar a cabo una tarea de actualización, hará falta tener respuesta a las siguientes preguntas:
- [ ] ¿Qué software debemos instalar (OS, generador G-Code...)?
- [ ] ¿Quién lo instala y se encarga de que funcione?
- [ ] ¿Quién lo documenta?

David-Estevez, 2016-06-07:
Dado que los PCs no son exactamente de última generación, yo optaría por GNU/Linux con un gestor de ventanas ligero como [LXDE](http://lxde.org/).

Para el Slicer, lo más user-friendly (y rápido) que conozco es [Cura](https://ultimaker.com/en/products/cura-software), para el que se pueden crear perfiles de configuración de nuestras impresoras y compartirlos, en caso de que alguien quiera generar el gcode en su PC y usar los PCs de la nave sólo como host.

Rodriwp, 2016-06-08:
Me parece perfecto actualizar las impresoras aunque antes haria una copia de seguridad de las configuraciones que subiria al repositorio por si acaso.

Siotma, 2017-02-08:
Propongo actualizar las versiones del Marlin de ambas impresoras. Me ofrezco a configurarlo.

También propongo utilizar Repetier + Slic3r ya que es lo que uso a nivel particular y tengo gran experiencia. También me ofrezco a configurar los perfiles de impresión fileteo de Slic3r.

Documentar su instalación es fácil. Pero a hacer manuales de uso no estoy dispuesto, ya que hay mucha información en las páginas oficiales. Creo que alguien podría hacer estos manuales a modo de ejercicio de iniciación en el mundo de las impresoras.

Lanzo la propuesta de una reunión de gente de la asociación que esté interesada en impresoras en  #12. Pretendo que cuantos más mejor sepamos hace estas cosas.

Siotma, 2017-03-02:
Acabo de commitear el firmware de Hija Resurrection ([Marlin 1.0.2-2](https://github.com/MarlinFirmware/Marlin/releases/tag/1.0.2-2)) dentro de nuestro repositorio para que esté siempre disponible y se pueda trabajar sobre él en la medida de lo necesario hasta que quede perfectamente afinado. La idea más importante es no perder todos los parámetros de configuración únicos que están almacenados en el fichero Configuration.h, pero creo que es interesante guardar una copia de todo por las interrelaciones que pueda tener con otros ficheros y que puedan cambiar en futuras verisones.

Además, he de destacar que tal y como se ha reflejado en #2 , el software instalado en el ordenador de Blacky ha sido Repetier ([RepetierHost 1.6.2](https://www.repetier.com/download-now/)). La idea es usarlo junto a Slic3r pero también tiene integración con Cura. Ahora mismo es perfectamente funcional desde la cuenta de invitado de Lubuntu.

Próximamente trabajaremos en la configuración de los perfiles de fileteo para obtener mejores resultados de impresión.

David-Estevez, 2017-03-02:
Hombre, igual lo más interesante hubiese sido hacer un fork del repositorio. Para tener una versión concreta es suficiente con hacer checkout en el commit que nos interese.

En teoría con tener los Configuration.h de las impresoras y apuntar el commit de esa release deberíamos poder restaurarlo todo a como estaba en caso de fallo catastrófico.

Siotma, 2017-03-05:
Lo he estado valorando y tienes toda la razón.

En breve haré los cambios necesarios para dejarlo como tú dices.

Siotma, 2017-03-06:
Hecho.

Siotma, 2017-10-17:
En el día de hoy, se ha probado la funcionalidad del nuevo ordenador de Hija Resurrection desde la sesión de invitado ( #3 ). Así pues, considero que esta issue está totalmente cubierta:
- Ambos PCs cuentan con Lubuntu 14.4, y está documentada su [instalación](https://asrob-uc3m.gitbooks.io/impresoras-maintenance-manual-i3/content/anexo_1_sistema_operativo_y_sofware.html), [backup](https://asrob-uc3m.gitbooks.io/impresoras-maintenance-manual-i3/content/anexo_4_proceso_de_backup_del_s.o_configuraciones_y_software.html) y de [reinstalación](https://asrob-uc3m.gitbooks.io/impresoras-maintenance-manual-i3/content/anexo_3_reinstalacion_de_sistema_operativo_software_y_configuraciones_desde_backup.html)).
- Ambos PCs cuentan con Repetier 1.6.2, y está documentada su [insatalación](https://asrob-uc3m.gitbooks.io/impresoras-maintenance-manual-i3/content/anexo_1_sistema_operativo_y_sofware.html) y su [utilización](https://asrob-uc3m.gitbooks.io/impresoras-user-manual-i3/content/primeros_pasos.html). En este punto, podría ser interesante actualizar las capturas de pantalla para la nueva versión, pero es un detalle menor porque aunque el aspecto visual es distinto, los controles siguen siendo idénticos. He puesto una issue específica [aquí](https://github.com/asrob-uc3m/impresoras-user-manual-i3/issues/1) para que esto no se olvide.
- Ambos PCs pueden imprimir desde la sesión de invitado, y está documentada su [configuración](https://asrob-uc3m.gitbooks.io/impresoras-maintenance-manual-i3/content/anexo_1_sistema_operativo_y_sofware.html).
- Ambas impresoras cuentan con una versión de Marlin actualizada en marzo de este año, y los ficheros de configuración están en el repositorio.

Dada la antigüedad de esta issue, en caso de que en un futuro se quieran realizar nuevas actualizaciones, se debería abrir una nueva.

Closed 2017-10-17.

Thread 2 (2016-06-30):

Se debe configurar y documentar configuración PC nuevo de Blacky

jgvictores, 2016-06-30:
Se están configurando los PCs nuevos de Blacky e Hija Resurrection (véase [1](https://github.com/asrob-uc3m/impresoras-maintenance-manual-i3/blob/master/anexo_1_archivos_de_configuracion.md) y [2](https://github.com/asrob-uc3m/impresoras-maintenance-manual-i3/blob/master/anexo_2_sistema_operativo_y_sofware.md)).
Tareas pendientes:
- [ ] Documentar chmod (hasta que se haga un rules.d)
- [x] Documentar instalación de Repetier (versión, etc)
- [x] Mejorar resolución de pantalla
- [x] Instalar Slic3r para Repetier

Siotma, 2017-02-19:
Este PC tiene Lubuntu, tal y como se explica en el [manual de mantenimiento](https://github.com/asrob-uc3m/impresoras-maintenance-manual-i3/blob/master/anexo_2_sistema_operativo_y_sofware.md). En el mismo manual también se especifica que tiene instalado el siguiente software:

- Cura. Efectivamente, aparece entre los programas instalados, pero no fui capaz ni siquiera de conectar con la impresora.
- Repetier. O yo soy un negado, o no fui capaz de encontrar el Repetier. Intenté instalarlo el jueves pasado con ayuda de @David-Estevez pero el resultado no fue positivo.

En definitiva, solicito ayuda de alguien experimentado con este sistema operativo que nos pueda ayudar a dejar los programas funcionando sobre este sistema operativo que, por cierto, creo que **es un gran acierto** ya que la sesión de invitado se autodestruye al salir, lo que va en la línea de su utilidad.

David-Estevez, 2017-02-19:
Me dio la sensación de que Repetier se instaló, pero no generó iconos de acceso directo. Porque cuando lo probamos arrancaba.

Siotma, 2017-02-19:
Perdón, no he sido todo lo explicativo que debería:
Efectivamente, corrimos el Script de instalación de Repetier, y llegó a iniciarse. Incluso conectó con la impresora una vez. Sin embargo, poco después de irte, de repente crasheó y se cerró solo. A partir de ese momento, Repetier no duró abierto más de 5 segundos antes de cerrarse súbitamente...
De ello desprendo que la instalación no fue correcta...

David-Estevez, 2017-02-19:
Vale, en ese caso sí que habría que echarle un ojo...

Siotma, 2017-02-19:
Me imagino que la manera más rápida de echarlo a funcionar sería conectar el ordenador a internet y que descargue todos los paquetes que vaya necesitando, el script de la instalación decía que había algo desactualizado en el sistema. No debe ser muy difícil, pero de verdad que yo soy un negado y no quiero hacerlo mal...
Poner en marcha ese ordenador implicaría tener una impresora totalmente operativa, ya que Hija Resurrection podría donar su espejo hasta que reparemos su calentador.

David-Estevez, 2017-02-19:
Para conectarlo se me ocurren dos formas:
* Un cable de red muuuuy largo.
* Mover la torre temporarmente cerca del switch de red más cercano en la nave.

PD: Mono son las librerías que permiten ejecutar programas .NET (cosas de Windows).

Siotma, 2017-02-19:
Yo había pensado en algún pincho WiFi y conectarlo a la red abierta de la universidad.

Vale, pues si necesita esas librerías para funcionar, y las que tiene no le valen, normal que crashee.

Igual que antes, dejo por aquí algo de info que he encontrado: http://www.mono-project.com/docs/getting-started/install/linux/

David-Estevez, 2017-02-19:
Tiene pinta de ser eso, le hacen falta las Mono y se las intenta descargar, pero como no tiene red no puede, y por eso crashea.

Lo del pincho es una buena idea, pero si no lo pilla porque le faltan los drivers no hay interné para bajárselos :sweat_smile: Como es sencilo de probar, sería cosa de intentarlo como primera opción y si no funciona probar con las que he puesto antes.

Siotma, 2017-02-23:
Lamento no haberlo comunicado antes, el trabajo realizado con el PC de Blacky realizado el día 21 de febrero se puede encontrar en #11 , concretamente [aquí](https://github.com/asrob-uc3m/impresoras-asrob/issues/11#issuecomment-281401624).

Siotma, 2017-03-02:
Hoy se ha completado la instalación de Repetier. Ahora mismo se puede lanzar tanto desde la sesión de ASROB como desde la de invitado. Sin embargo, aún no es funcional en la cuenta de invitado.
Tal y como se ha mencionado en #11, el sistema operativo no permite a la sesión de invitado acceder a los puertos serie. Este es el último paso necesario para que la impresora se pueda utilizar por externos.
@jgvictores habla de "crear un fichero rules de udev (por no meter un chmod cutre)"

David-Estevez, 2017-03-02:
¿Y no se podrá resolver añadiendo al usuario invitado al grupo `dialout`? (como hay que hacer con el IDE de Arduino para poder programar las placas sin sudo)

jgvictores, 2017-03-02:
Metí un `/etc/udev/rules.d/80.guest-printer.rules`:
```
SUBSYSTEM=="tty", ATTRS{idVendor}=="0403", ATTRS{idProduct}=="6001", GROUP="dialout", MODE="0666"
```

Y ya conecta desde `guest`!

Siotma, 2017-03-02:
En relación al comentario de @David-Estevez , resaltar el detalle de que la cuenta de invitado se crea una distinta cada vez que se inicia sesión, con distinto nombre de usuario. Por ello no hay ningún usuario al que añadir al grupo, sino que debe ser hecho en cada inicio de sesión. Así pues la solución de @jgvictores es maravillosa.

David-Estevez, 2017-03-02:
no tenía ni idea, gracias por la aclaración!

Siotma, 2017-03-03:
Problemas encontrados con el PC durante la mañana de hoy:

1. La sesión de invitado no puede ver los perfiles de Slic3r creados por la sesión de ASROB, por tanto no se puede imprimir con ellos como invitado. Especifico el problema:
	a. La sesión de invitado sí puede lanzar Repetier.
	b. La sesión de invitado sí puede conectar Repetier con la impresora.
	c. La sesión de invitado sí pude lanzar Slic3r desde Repetier.
	d. La sesión de invitado NO puede utilizar los perfiles creados previamente por el usuario ASROB para Slic3r.

Idealmente, la sesión de invitado debería poder VER y UTILIZAR los perfiles de Slic3r creados y afinados para Blacky, es decir, permisos de lectura, pero no MODIFICARLOS, es decir, de escritura.

2. El PC de Blacky se puede utilizar sin problemas para imprimir usando la sesión de ASROB pero durante la impresión, la sesión se bloquea automáticamente pasado un tiempo. Esto no afecta a la impresión, que continúa aunque la sesión esté bloqueada.
3. Al desbloquear la sesión, el PC de Blacky se ha quedado pillado con la pantalla en blanco permanente, aunque la impresión no se ha detenido.

Así pues, propongo lo siguiente:

- [ ] Eliminar el bloqueo de sesión por tiempo de la configuración de las cuentas de usuario.
- [ ] Permitir de alguna manera que la sesión de invitado pueda acceder a los ajustes de Slic3r. Tal vez con un fichero .ini de por medio, o recurriendo a las rules mágicas de @jgvictores otra vez...

Siotma, 2017-03-03:
Documentación gráfica para el post anterior:

Pieza impresa con la sesión de ASROB (hubo un problema de adhesión a la cama, pero ninguno relacionado con el PC):
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

Pieza impresa con la sesion de invitado:
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

Vídeo del ordenador de Blacky frito con luces de discoteca (perdón por el ZIP, pero GitHub no me deja adjuntar el vídeo tal cual):
[PC_Blacky_frito.zip](https://github.com/asrob-uc3m/impresoras-asrob/files/816538/PC_Blacky_frito.zip)

Siotma, 2017-03-09:
Hoy, @David-Estevez y yo hemos estado intentando enlazar las sesiones de ASROB e invitado con éxito parcial.

Hemos descubierto que existe un script (no recuerdo ahora mismo la ruta ni el nombre) que se ejecuta con cada inicio de sesión de la sesión de invitado. Este script se puede modificar con permisos de sudo y añadir los pasos necesarios para enlazar la configuración de Repetier y Slic3r con la sesión de invitado mediante archivos .ini
Además, también se puede utilizar este script para confeccionar el escritorio de la sesión de invitado de manera que aparezcan por defecto algunas cosas como el acceso directo a Repetier o una carpeta con piezas de ejemplo.

Poco a poco, vamos avanzando.

Siotma, 2017-04-04:
Hoy tenemos reunión de Printer One ( #12 ) y mi idea es retomar lo dicho en el último comenario. Si podéis pasaros @David-Estevez o @jgvictores durante la tarde para repasar esto sería genial.

David-Estevez, 2017-04-04:
Como ya hemos quedado esta tarde en la nave, os puedo echar un cable cuando terminemos la reunión con Javi

Siotma, 2017-04-04:
Creemos que el tema está en copiar los archivos values.xml

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

Se puede añadir código en el script guest-session-auto.sh que está dentro de la carpeta usr/lib/lightdm para realizar las copias siempre que se inicie sesión.

David-Estevez, 2017-04-04:
y no se podría copiar directamente el registry del repetier de un user a otro? y así dejamos de tener que controlar tanto archivo suelto...

Siotma, 2017-04-05:
No sé lo que es el registry... pero cualquier prueba es bienvenida! :D

Yo creo que todos tenemos claro el objetivo:
Que la sesión de invitado inicie Repetier con todo listo para darle al botón de Slic3r y al de imprimir y funcione.

La forma de conseguirlo, es lo que estamos buscando y, por cierto, el primero que lo consiga, se llevará una gran admiración general 🤣

David-Estevez, 2017-04-05:
Seguramente no me expliqué bien. Quería decir la carpeta  `repetier` de dentro de la carpeta `registry` de mono (que según la imagen que has puesto parece que contiene todos los archivos `values.xml`.

Imagino que esta carpeta lo que hace es emular el registro de Windows, que no existe en GNU/Linux.

Siotma, 2017-04-05:
Ah, comprendo, sí sí, totalmente de acuerdo. Yo incidí en los archivos xml porque son lo realmente importante pero obviamente una sola copia de la carpeta repetier cumple con todos los requisitos.

Siotma, 2017-06-07:
Hoy, he conseguido darle vida a la sesión de usuario, tras echarle unas cuantas horas.

Voy a describir lo que he hecho para que no se me olvide. La intención es que se pueda programar un script que lo haga todo automáticamente, pero para eso hoy no tengo tiempo ni conocimiento. Ahí va:

1. La sesión de usuario necesita 3 carpetas:

- `/home/asrob/.Slic3r` Es donde se guardan los perfiles de Slic3r: carpetas print, printer y filament.
- `/home/asrob/.mono/registry/CurrentUser/software/repetier` Es donde se guarda la configuración de Repetier, para que según se abra, todas las opciones aparezcan preseleccionadas.
-  `/home/asrob/.local/share/RepetierHost` Es donde se guarda la configuración de Cura, entre otras cosas. No hace falta para que funcione con Slic3r.

2. Dichas carpetas deben copiarse a una intermedia a la que tenga acceso la cuenta de invitado. En nuestro caso estamos usando `/usr/share/asrob` .

- Para evitar conflictos con las rutas, deben eliminarse los siguientes campos de los siguientes archivos:

| Nombre del campo | Nombre del archivo | Ruta del archivo |
|---|---|---|
| `lastLoadGCodeFolder` | `values.xml` | `~/.mono/registry/CurrentUser/software/repetier` |
| `lastLoadModelFolder` | `values.xml` | `~/.mono/registry/CurrentUser/software/repetier` |
| `workdir` | `values.xml` | `~/.mono/registry/CurrentUser/software/repetier` |
| `soundTemperature` | `values.xml` | `~/.mono/registry/CurrentUser/software/repetier/window` |
| `soundSoundCommand` | `values.xml` | `~/.mono/registry/CurrentUser/software/repetier/window` |
| `fileHistory` | `values.xml` | `~/.mono/registry/CurrentUser/software/repetier/window` |
| `soundError` | `values.xml` | `~/.mono/registry/CurrentUser/software/repetier/window` |
| `soundPrintPaused` | `values.xml` | `~/.mono/registry/CurrentUser/software/repetier/window` |
| `soundPrintFinished` | `values.xml` | `~/.mono/registry/CurrentUser/software/repetier/window` |

- Todos estos valores tienen en común que son rutas a las que no tiene acceso la sesión de invitado. Repetier al detectar que faltan, los regenera con valores correctos en la primera ejecución.

- Todas las tareas descritas en el punto 2 deben automatizarse con un script que se tendría que ejecutar con privilegios de administrador (para realizar las copias y modificaciones de los archivos).

3. Dichas carpetas deben copiarse a la carpeta local del invitado, mediante las siguientes instrucciones al final del script `guest-session-auto.sh`, que es el que crea la sesión de usuario y está localizado en `/usr/lib/lightdm` ; mediante el código:

 `# cp -r /usr/share/asrob/RepetierHost ~/.local/share/ #en principio solo para cura`
 `mkdir -p ~/.mono/registry/CurrentUser/software`
 `cp -r /usr/share/asrob/repetier ~/.mono/registry/CurrentUser/software`
 `cp -r /usr/share/asrob/.Slic3r ~/`

Ahora mismo la sesión de invitado es funcional para imprimir! 🎉

Siotma, 2017-06-08:
Tal y como comenta @pamarinp en https://github.com/asrob-uc3m/impresoras-asrob/issues/12#issuecomment-306917681 , la sesión de invitado tiene activado el auto log-out. Esto hace que sea técnicamente imposible volver a la sesión ya que si se inicia de nuevo como invitado creará otra cuenta distinta. Aunque la impresión sigue funcionando, el Repetier desaparece de la pantalla por lo que no es posible realizar tareas básicas como cancelar o parada de emergencia.

Habría que buscar la línea de comandos necesaria para desactivar el auto logout y añadirla al script de creación de la sesión de invitado `guest-session-auto.sh`.

Siotma, 2017-09-28:
En la reunión de Printer One de la semana pasada, se añadió una línea adicional al script para desactivar al auto-logout; `export TMOUT=0`, tal y como aparece con una búsqueda rápida en Google.

Sin embargo, hoy, @davidvelascogarcia y yo hemos descubierto tras varias pruebas, que esta línea no cancela los temporizadores, que mantienen su valor por defecto (ver foto), por lo que no es válida por si sola.
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

Hemos localizado el comando que controla los temporizadores en el fichero `tmp/guest-xxxxx/.config/autostart/screensaver-settings.desktop` (ver foto) y hemos añadido una nueva línea que los cancela `xset s 0 dpms 0 0 0` en el script de creación de la sesión de invitado `guest-session-auto.sh`. Con esta nueva línea, los temporizadores se desactivan correctamente y el auto-logout ya no salta nunca.

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

En esta issue hay actualmente toda la información necesaria para configurar el PC por lo que ya se puede comenzar con la configuración del PC de Hija Resurrection (ver #3 ).

Únicamente quedan dos mejoras que hacer al script, desde mi punto de vista:
- Programar la copia o creación en el escritorio de la sesión de usuario de un acceso directo a Repetier.
- Programar la copia o creaciónen el escritorio de la sesión de usuario de una carpeta con piezas de muestra y de calibración.

Además, quedaría automatizar la exportación de los perfiles desde la sesión de administrador hasta la sesión de invitado, mediante un script tal y como indiqué en este mensaje: https://github.com/asrob-uc3m/impresoras-asrob/issues/2#issuecomment-306881958

David-Estevez, 2017-10-01:
No sé si esto está hecho ya o no, pero creo que sería bueno tener una copia del script `guest-session-auto.sh` y de todos los archivos de configuración que se hayan modificado en este repo por si las moscas.

davidvelascogarcia, 2017-10-03:
@David-Estevez
El Script guest-session-auto.sh, ya está disponible en el repositorio en el apartado de Blacky, con un añadido además en el readme.txt, comentando la funcionalidad del Script.
El Script se encuentra en el ordenador que controla la impresora Blacky, pero a su vez, dado que se ha clonado el disco duro de este ordenador al nuevo ordenador que controlará Hija Resurrection, también se encuentra incorporado en ese.

davidvelascogarcia, 2017-10-03:
Tras haberlo consultado con @Siotma , podría ser una buena incorporación de seguridad, realizar un backup del sistema operativo con todos los programas instalados y configuraciones en el estado actual, en formato ISO.
En caso de suceder cualquier tipo de problema con alguno de los ordenadores, dado que son clones, se podría re instalar rápidamente para que volvieran a ser funcionales en el menor tiempo posible.

David-Estevez, 2017-10-03:
Ocupa mucho la ISO del PC?

jgvictores, 2017-10-03:
En todo caso, recomiendo fsarchiver (fsa), pese a que en RobotDevastation tiremos por dd. :smile:

davidvelascogarcia, 2017-10-04:
@David-Estevez , creo recordar que con el S.O, datos y configuraciones ocupaba al rededor de 8 GB. Podría servir para luego hacer re-instalaciones desde un USB booteable, o desde un DVD de doble capa.
@jgvictores , sí, además con fsarchiver, no habría ningún problema de licencias al ser open source, y con el añadido de que el resultado lo da en un fichero comprimido. Lo único, como puede dar problemas al hacer un backup desde una unidad montada, habría que usar otro PC de apoyo como con el clonado de disco de Blacky a Hija Resurrection, pero no debería de durar más de 30 minutos el proceso,

David-Estevez, 2017-10-04:
Siendo 8GB, si se podría tener el backup y además tenerlo subido a algún sitio online. (Incluso, a unas malas, subirlo al drive de ASROB en UC3M que tiene espacio infinito).

Gran trabajo, @davidvelascogarcia !! :clap: :clap:

jgvictores, 2017-10-04:
> como puede dar problemas al hacer un backup desde una unidad montada, habría que usar otro PC de apoyo como con el clonado de disco de Blacky a Hija Resurrection, pero no debería de durar más de 30 minutos el proceso

Lo habitual es arrancar de una distro Live (cualquier USB instalador de Ubuntu Xenial o anterior), y hacer el fsa/dd/etc desde ahí. Sobre todo, para no tener que estar conectando/desconectando discos duros. :-)

davidvelascogarcia, 2017-10-04:
@David-Estevez
Si, pienso lo mismo, en un disco duro, DVD o USB, podría acabar perdiéndose. Había pensado que junto al Drive, subirlo al github, pero desconozco la capacidad ahora mismo. Por tenerlo en varios sitios.
@jgvictores
Totalmente de acuerdo, y así hay menos complicaciones.
Ayer tuvimos problemas al bootear desde USB, aunque la placa lo permite. De todos modos acabo de acordarme de que tengo varias distritos de Ubuntu live en DVD RW, por lo que podría llevarlas y añadir alguna versión particular para estar seguros de poder hacerlo a la primera.

David-Estevez, 2017-10-04:
Quizá https://git-lfs.github.com/ ? O el SVN de ASROB, @jgvictores ?

jgvictores, 2017-10-04:
My preferences, de más a menos:
1. https://git-lfs.github.com/ suena bien, a ver si lo podemos usar.
1. Directamente como fichero (sin SVN tan siquiera) en https://sourceforge.net/projects/asrob/files/?source=navbar
1. Ojo que he metido ficheros enormes sin problema en SVN, así que en SVN de https://sourceforge.net/projects/asrob
1. Y ya lo peor, tirar de algo del server que a fecha de hoy aloja asrob.uc3m.es (del que me gustaría dejar de depender).

davidvelascogarcia, 2017-10-09:
@Siotma
En la sesión de hoy, se ha comenzado el proceso de backup del sistema operativo, aplicaciones y configuraciones con el fin de generar una ISO con la cual restaurar los ordenadores, aprovechando la ventaja de ser clones, en caso de que surgiera cualquier tipo de problema.
En un inicio, se comenzó con la carga de un DVD Live, distro Ubuntu 14.04 i686 x32 bit, así como añadió el repositorio de manera temporal con el fin de instalar el fsarchiver del mismo modo. Sin embargo, al no encontrar el packcage, se procedió con el método secundario, la creación de copia desde las unidades de disco, encontrando a su vez el error de ficheros.
Por último, se procedió con un método funcional desde el terminal, la generación de una copia con el comando dd. El proceso de copiado, tuvo que detenerse, dado que en ese método se desconocía el porcentaje de progreso, el cual al finalizar se descubrió que era de aproximadamente el 50%, a costa de un largo tiempo.
Aprovechando la sesión del día de mañana para organización y limpieza, dado que los equipos estarán disponibles, y no se requerirá de supervisión de los mismos, se procederá con el backup en segundo plano.
Para evitar inconvenientes, se ha buscado un sustituto también en CD Live, también Open Source, concretamente, Clonezilla, que permitirá realizar el backup en formato ISO, y así será más sencilla su reinstalación.
Tras haber consultado los manuales del software, en principio mañana no deberían de surgir problemas adicionales, y podría guardarse el backup en los servidores.

Morgloz, 2017-10-09:
Hay un par de opciones para monitorizar el comando dd, nunca recuerdo cuál, en la próxima reunión las explico

jgvictores, 2017-10-09:
De memoria, diría que `ddrescue` con alguna opción verbose `-v`, aunque también había hacks de consola sobre `dd`.
`fsarchiver`, pese a que Clonezilla no está mal, me sigue pareciendo la mejor opción. En trusty (14.04) simplemente hay que tener activados loa repositorios Universe, ¿podéis comprobarlo?

David-Estevez, 2017-10-09:
A `dd` le puedes mandar una señal SIGUSER1 para que te muestre el progreso.

Conociendo

David-Estevez, 2017-10-09:
Fallo mío, confundí "close" con "cancel" :sweat_smile:

davidvelascogarcia, 2017-10-11:
@jgvictores @Siotma @David-Estevez
En la sesión extraordinaria de ayer, en paralelo con la limpieza y organización, se continuó con el proceso de backup, esta vez de forma exitosa. Dado que ayer aún no entendía del todo bien, como emplear fsarchiver, con vistas a una medida temporal, hasta entender como emplearlo procedí con el backup desde Clonezilla.
Se realizó el backup del PC de Hija Resurrectión, posteriormente, tras cambiar el lector del DVD del ordenador antiguo de Hija Resurrection al de Blacky dado que este lector estaba dañado, se procedió con el backup de Blacky.
Tras comprobar que en PC de Blacky funcionaba con ambas impresoras correctamente, y con el fin de probar que funcionan correctamente los backups, y aprovechando que son clones, se restauró el PC de Hija Resurection con el backup de Blacky, sin dar ningún problema.
Actualmente ambos ordenadores controlan sin problemas ambas impresoras en modo administrador, por otro lado en modo invitado Blacky controla ambas, pero Hija Resurrection, solo la impresora de Blaky y no la de Hija Resurrection.
En la próxima sesión se podría realizar el backup adicionalmente con fsarchiver, que había sido la primera idea, dado que he conseguido entender un poco mejor el funcionamiento.
De todos modos, por seguridad podría guardarse además el backup hecho con Clonezilla que solo ocupa 2.1 GB.
He intentado subirlo a sourgeforge, pero no tengo usuario ASROB en esa plataforma, por otro lado, en  https://git-lfs.github.com/ , no entiendo muy bien como hacerlo.
De momento he optado por subirlo al drive de alumno de la universidad, por si hubiera un drive de ASROB, pasarlo directamente o compartirlo.
Por cierto, he documentado el ANEXO 3 y el ANEXO 4 explicando con detalle el proceso de backup y de restauración en el manual de mantenimiento, y en la carpeta de backup de impresoras hecho un índice para redirigir a la descarga cuando este del backup y los anexos.
Quedo a la espera de vuestra respuesta.
Un saludo.

Siotma, 2017-10-13:
Añadir que la imagen ya se encuentra en el Drive de ASROB (dominio UC3M) y se ha enlazado desde el repo vía 4679c574c4e6e30baf7de19aec925fd5b912a3cf .

Siotma, 2017-10-17:
A mi ver, lo único que queda para tener los ordenadores perfectamente configurados es que la sesión de invitado se inicie con un par de cosas en el escritorio:
- Un accceso directo a Repetier, con logo y todo, para que se vea bien.
- Una carpeta con piezas de prueba. Pueden ser piezas típicas de calibración y como mucho alguna figura pequeña.

jgvictores, 2017-10-17:
Re @davidvelascogarcia
> He intentado subirlo a sourgeforge, pero no tengo usuario ASROB en esa plataforma, por otro lado, en https://git-lfs.github.com/ , no entiendo muy bien como hacerlo.

Si te creas un usuario en sf.net, te puedo agregar al proyecto.

Re @Siotma
> Un accceso directo a Repetier, con logo y todo, para que se vea bien.

En robotDevastation, usamos un `.desktop` en `~/Desktop`: véase [robotDevastation.desktop](https://github.com/asrob-uc3m/robotDevastation/blob/2646b3079ac4d84904a2a8a3d8bd992293fb3718/scripts/gnome/robotDevastation.desktop) que a su vez enlaza con el [icono 64x64](rd-icon-64x64.png) (que debería instalarse en otro lado, pero así nos es más cómodo por cómo está montado).

Siotma, 2017-10-18:
Sí, el .desktop de Repetier ya existe, lo crea automáticamente con la instalación. La cosa es sacar un ratillo para configurar el script del inicio de sesión para que se copie en el escritorio. Gracias aún así por el apunte!

davidvelascogarcia, 2017-10-18:
@jgvictores
He creado el usuario en Sourceforge. El nombre de usuario es davidvelascogar.
Link:
https://sourceforge.net/u/davidvelascogar/profile/

Un saludo y gracias.

jgvictores, 2017-10-18:
Añadido!

davidvelascogarcia, 2017-10-18:
@jgvictores
Perfecto, muchas gracias.

jgvictores, 2017-10-28:
Respecto a [mis propuestas para almacenar ficheros grandes](https://github.com/roboticslab-uc3m/tiago-lfs), resulta que https://git-lfs.github.com/ no es excesivamente difícil de usar (se instala, se define mediante una línea de comando la extensión del tipo de fichero que va a ser grande, y luego es git vía consola normal), pero tiene una **limitación de 1-2 GB por fichero** (más comentarios míos [aquí](https://github.com/roboticslab-uc3m/best-practices/issues/13)). No nos valdría.
Por tanto, https://sourceforge.net/projects/asrob/ sigue teniendo sentido de momento.

davidvelascogarcia, 2017-10-29:
@jgvictores he creado una carpeta en Sourceforge, con nombre Backup_OS_3D_Printers_PC, para subir ahí el backup.
Los ficheros de configuración de la copia ya están subidos, sin embargo da limitación con el fichero grande de 2 GB, lo he dividido en 3 partes de 700 MB y una de 27 MB, ya está en proceso de subida.
Solo habría que descomprimir para unir esos 4 ficheros.
[https://sourceforge.net/projects/asrob/files/Backup_OS_3D_Printers_PCs/](url)

jgvictores, 2017-10-29:
¿Estás a tiempo de detener la subida? La limitación (que yo sepa/recuerde) es en GitHub, no en Sourceforge... 😅

davidvelascogarcia, 2017-10-29:
Está aproximadamente, como al 60%.

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

Lo subo dónde prefiráis. :)

jgvictores, 2017-10-29:
Bueno, está bien. No conocía esa limitación de la subida vía interfaz web. De todas formas, dará menos problemas a la hora de descargárselo.

davidvelascogarcia, 2017-10-29:
Me ha dado problemas con la subida, respuesta del servidor con código 0.

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

jgvictores, 2017-10-29:
Ahora mismo veo un poco de caos en https://sourceforge.net/projects/asrob/files/Backup_OS_3D_Printers_PCs/
¿Podrías instalarte el Cliente de FTP de Filezilla (https://filezilla-project.org/download.php?type=client) y tratar de gestionar todo desde ahí?

De https://sourceforge.net/p/forge/documentation/SFTP/ entiendo que el servidor al que te conectas es **frs.sourceforge.net** y las credenciales las tuyas.

davidvelascogarcia, 2017-10-29:
He hecho limpieza en la carpeta del backup, he borrado todos los ficheros.
Lo estoy subiendo todo en un único Zip como el de Drive,  desde el cliente Filezilla.
Tardará un poco, tengo poca velocidad de subida.
@jgvictores , tienes razón, desde subida FTP, no hay limitaciones de tamaño, al menos no me ha notificado nada al subirlo.
He tardado un poco, porque no me aparecía directamente la carpeta del proyecto.
La ruta era /home/pfs/project/asrob/...
:).

jgvictores, 2017-10-29:
Cierto! Una vez conectado, hay que dar un par de rodeos en la estructura de carpetas del servidor hasta encontrar el proyecto en cuestión... ¡Bien visto!

davidvelascogarcia, 2017-10-29:
Ya esta subido.

davidvelascogarcia, 2017-11-16:
Copio el otro hilo dado que es el mismo para los dos.

@Siotma
El nuevo backup de los ordenadores de ASROB, ya se encuentra disponible en Sourceforge. A su vez, se ha modificado el link del readme del repositorio de impresoras de Github para la descarga y sustituir la descarga de drive por la del repositorio de Sourceforge.
He aprovechado, y he pasado los anexos 3 y 4 del manual, de como realizar el backup o restaurar, a ficheros PDF, intentando dejarlos algo más preparados y subido al repositorio de Sourceforge junto al backup. A su vez,también hay una copia en el repo de Github de impresoras.

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

Figura 1. Ficheros Sourceforge

Adjunto los links:

Backup en Sourceforge:
[Backup](https://sourceforge.net/projects/asrob/files/Backup_OS_3D_Printers_PCs/?upload_just_completed=true)

Fichero PDF de proceso de Backup
[PDF](https://github.com/asrob-uc3m/impresoras-asrob/blob/master/Backup%20S.O%20configuraciones%20y%20aplicaciones%20de%20equipos%20de%20impresion/Proceso%20de%20backup.pd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)

Fichero PDF de restauración de Backup
[PDF](https://github.com/asrob-uc3m/impresoras-asrob/blob/master/Backup%20S.O%20configuraciones%20y%20aplicaciones%20de%20equipos%20de%20impresion/Reinstalacion%20de%20sis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)

jgvictores, 2017-11-16:
@davidvelascogarcia Todo esto formato petición/recomendación....
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

Thread 3 (2016-06-30):

Se debe configurar y documentar PC nuevo de Hija Resurrection

jgvictores, 2016-06-30:
Se están configurando los PCs nuevos de Blacky e Hija Resurrection (véase [1](https://github.com/asrob-uc3m/impresoras-maintenance-manual-i3/blob/master/anexo_1_archivos_de_configuracion.md) y [2](https://github.com/asrob-uc3m/impresoras-maintenance-manual-i3/blob/master/anexo_2_sistema_operativo_y_sofware.md)).
Tareas pendientes:
- [x] Replicar lo hecho hasta ahora en Blacky.
- [ ] Replicar lo que se haga en #2.

Siotma, 2017-02-19:
Si con "replicar lo hecho hasta ahora en Blacky", se pretende instalar Lubuntu y quitar Windows, me parece bien, ya que el sistema de sesiones de invitado es una gran ventaja.
Aún así, creo que es mejor primero completar la configuración del PC de Blacky y documentarlo bien, ya que al menos este PC ahora funciona.

jgvictores, 2017-02-19:
@Siotma Sí, se pretendía instalar Lubuntu y quitar Windows. Totalmente de acuerdo, primero completar la configuración del PC de Blacky y documentarlo bien.

Siotma, 2017-06-24:
Ahora que ya sabemos configurar Lubuntu ( #2 ), resucito este hilo para hacer lo propio con el PC de Hija Resurrection.

jgvictores, 2017-06-24:
Ok, en uno de los armarios debería estar un PC similar al que ahora mismo tiene Lubuntu, para replicar el proceso (y dar de baja el equipo que ahora mismo lleva Windows).

David-Estevez, 2017-06-26:
El PC del armario tiene RAM? No se la llevó el ex-tesorero al recibir la donación?

jgvictores, 2017-06-26:
Mmm creo que había ocurrido eso, y entre Fernando el técnico y yo lo habíamos tratado de solucionar. Por favor revisadlo, y si no, volvemos a comentar con Fernando.

Siotma, 2017-09-28:
Esto hay que resucitarlo urgentemente. Ahora que tenemos gente en Printer One hay muchas manos para pocas cosas que hacer, podríamos encargarnos de esto en la próxima reunión.

Si hay que utilizar un nuevo equipo, agradecería que se nos indicara cual es, y también dónde localizar el disco o los medios de instalación del sistema operativo Lubuntu.

Siotma, 2017-09-30:
@David-Estevez y @jgvictores . Necesitaríamos de vuestra colaboración!

jgvictores, 2017-09-30:
Hi!
Lo comentado arriba: en uno de los armarios debería estar un PC similar al que ahora mismo tiene Lubuntu. Sólo hay que revisar si tiene RAM. En cuanto a cómo instalar el sistema operativo, aquí enlace: https://asrob-uc3m.gitbooks.io/impresoras-maintenance-manual-i3/content/anexo_1_sistema_operativo_y_sofware.html

daavm, 2017-10-03:
Holi,
Tras clonar los discos y conseguir que Lubuntu funcionase en la nueva torre, y tras ver que Repetier no conectaba con la impresora, hemos optado por instalarlo de nuevo (Repetier) y aprovechar para poner una versión más actualizada (2.0.5). El problema después ha sido el hacerlo funcionar en la sesión de invitado. Al haberlo instalado usando el AppImage (fallo por mi parte, porque necesita permisos para ejecutar), ha sido un dolor de cabeza que no he sabido resolver.
Sin embargo, creo tener la solución y espero que el próximo dia podamos solucionarlo. Con esto, y si no me equivoco, creo que el PC estaría listo para su uso y disfrute.

Siotma, 2017-10-05:
El contenido de este mensaje se sitúa cronológicamente antes que el de @daavm.

En la [última reunión de Printer One](http://asrob.uc3m.es/index.php/Printer_One:_A_Clone_Wars_Story:_Cuaderno_de_Bitacora#3_de_octubre_de_2017) decidimos sacar el nuevo PC de Hija Resurrection y empezar a configurarlo.

En primer lugar lo abrimos para comprobar que es exactamente igual que el de Blacky:
- Torre Acer con 1GB de RAM DDR2 (2 ranuras, queda una libre); y procesador Pentium D de doble núcleo a 3GHz.
- Venía con WinXP, procedente de los laboratorios de los autómatas industriales. Se ha intentado instalar [Lubuntu](https://help.ubuntu.com/community/Lubuntu/GetLubuntu) mediante USB bootable pero no ha sido posible al no poder ejecutarlo durante el arranque.
- finalmente, se ha optado por clonar el Disco Duro que tiene el PC de Blacky, dado que ambas torres son idénticas. Para ello se ha utilizado un tercer PC con winXP y Easeus TODO Backup. Satisfactoriamente.
- La versión clonada de Lubuntu es totalmente funcional salvo porque al intentar conectar con Hija Resurrection esto no ha sido posible. Por ello se ha optado por sustituir la antigua versión de Repetier por una más moderna, y más facil de manejar, en formato AppImage. Actualmente estamos trabajando en la puesta a punto de esta, tal y como explica @daavm en el anterior comentario.

Actualmente, ambas torres se encuentran sobre la mea de Hija Resurrection.

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

Siotma, 2017-10-13:
Dicho por @daavm :

> En la sesión del lunes 9, y dado que usando el appimage de Repetier no estaba dando resultados, nos decidimos por reinstalarlo con la versión habitual. Se consiguió poner un ".sh" en el escritorio de la cuenta guest pero el acceso directo no acababa de funcionar como queríamos, así que el próximo día se pretende o terminar de apañar el sh o buscar otra solución.
El martes 10, dado que al final restauramos todo el sistema del pc de blacky, la cuenta guest ya tiene repetier totalmente funcional. Nos falta darle acceso a la cuenta al usb de la impresora hija a través del archivo rules, lo cual haremos en la próxima reunión.

Ambos PCs vuelven a ser clones ya que se usó Clonezilla para restaurar la imagen obtenida del PC de Blacky. Hija Resurrection conecta perfectamente desde la sesión de administrador, pero no desde la sesión de invitado. Enseguida nos hemos dado cuente de que se trata de un problema de permisos y nos hemos acordado del fichero rules.

Hemos utilizado como inspiración [este maravilloso comentario](https://github.com/asrob-uc3m/impresoras-asrob/issues/2#issuecomment-283737116) de @jgvictores .

El problema que hemos encontrado es que, mientras que la placa Arduino de Blacky se reconoce como un dispositivo `dev/tty/USB0`, la placa Arduino de Hija Resurrection aparece con un nombre mucho más largo, algo así como `serial/usb/by-id/XXXXXXXXXXXXXXXXXXXXXXXXXXXXXXXXXXXXX`. Hemos actualizado los números de idProducto y de idVendor, pero no ha sido suficiente. Yo imagino que en vez de poner `SUBSYSTEM=="tty"` habrá que poner otra cosa, pero no hemos sido capaces de acertar con lo que poner en el fichero rules para que se active al conectar la impresora.

¿Ideas @David-Estevez @jgvictores @Morgloz ?

jgvictores, 2017-10-15:
¿Habéis probado con simplemente omitir `SUBSYSTEM=="tty", `?

Siotma, 2017-10-15:
🤣 No, eso no lo probamos. Gracias por la idea 😊

daavm, 2017-10-17:
Dicho por @jgvictores:

>¿Habéis probado con simplemente omitir SUBSYSTEM=="tty", (además de actualizar los números de idProduct y idVendor)?

Efectivamente, hemos quitado el atributo SUBSYSTEM y la cuanta guest ya ha reconocido y conectado a la impresora. Así mismo, se ha probado a mandar una impresión y la ha empezado. La impresora hija quedaría totalmente funcional pendiente del cambio/arreglo de la fuente.

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

Siotma, 2017-10-17:
Además de lo dicho en https://github.com/asrob-uc3m/impresoras-asrob/issues/2#issuecomment-337302357 , en este PC queda también por hacer:
- Actualizar los perfiles de impresión de Slic3r por los que hemos recuperado de su antiguo PC. Creo que al final nos hemos ido sin hacerlo @daavm corrígeme si me equivoco.

davidvelascogarcia, 2017-10-18:
@Siotma
No sabía muy bien donde comentarlo, dado que no hay una issue como tal para ello.
Respecto a lo que estuvimos hablando el último día respecto de la nueva fuente para Hija Resurrection, la fuente de alimentación que era igual a la de Blacky.
Durante la sesión, se comprobó que la alimentación, era la correcta en todos los canales 3.3, 5, 12 V.
Tras separar el ventilador de la fuente, se comprobó que el fallo y el ruido era electrónico, y que al volver a soldar el ventilador, se incrementaba.
El ruido, me recordaba al de la bobinas a altas frecuencias, sin embargo, el fallo típico suele ser por condensadores, aunque a simple vista no estaban hinchados ni dañados.
Se me ha ocurrido, si os parece bien, para la próxima reunión.

1.  Aprovechando el osciloscopio de la nave, medir los condensadores y ver si hay picos en la señal y el condensador esta dañado y no filtra correctamente.
2. En caso de no ser el condensador, y ser las bobinas, intentar identificar el origen del ruido y calzar el solenoide en cuestión para disminuir el ruido.

¿Que os parece?.

jgvictores, 2017-10-18:
En el armario hay más fuentes, preferiría que se usasen frente al peligro de uno `refurbished`. ¿Serviría alguno del armario?

Siotma, 2017-10-19:
Como dice @jgvictores , la opción de utilizar la fuente tras haberla manipulado, a mi tampoco me convence. Las impresoras manejan mucha potencia y no queremos que constituyan un peligro. Las fuentes seleccionadas son las que mayor potencia nominal tienen en el canal de 12V, y por tanto si funcionan correctamente son las que menor peligro representan ya que creo que son las únicas que cubren totalmente las necesidades de las impresoras.

He leído en foros, que las fuentes de alimentación a veces producen sonidos electrónicos cuando trabajan sin carga porque les cuesta estabilizarse. Aprovechando las resistencias que ha traído @JorFru en https://github.com/asrob-uc3m/impresoras-asrob/issues/33#issuecomment-337376829 , podemos comprobar este hecho, y si la fuente de alimentación sigue sonando seguramente acabemos buscando otra aunque no tenga tanta potencia.

JorFru, 2017-10-19:
En la siguiente reunión instalaremos las resistencias y comprobaremos con
osciloscopio si la salida de la fuente está bien regulada.
Las fuentes funcionan oscilando y algunos componentes pueden vibrar. En
principio estás vibraciones están fuera de rango audible, generalmente por
encima de los 300KHz.
Es posible que lo que estemos escuchando sea un subharmónico de la
frecuencia de oscilación. Lo comprobaremos próximamente.

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

davidvelascogarcia, 2017-10-19:
Perfecto, se puede probar a conectar con carga. Quizá lo que propuso @Siotma del lector de DVD también pueda servir para esta prueba.
Por mí parte @JorFru , si no te importa me uno a las comprobaciones y en lo que pueda te echo una mano. Así aprovecho, aprendo y aplicó desde un plano más práctico.

Siotma, 2017-10-30:
Respecto a lo que se ha venido comentando en los últimos comentarios, mejor seguir en #35 .

Vengo a contar que hoy, después de un buen rato, he conseguido perfeccionar el [script de la sesión de invitado de Hija Resurrection](https://github.com/asrob-uc3m/impresoras-asrob/blob/master/Hija Resurrection/guest-session-auto.sh).

Ahora, el script copia en el escritorio una carpeta con piezas de calibración de ejemplo, y también un acceso directo funcional a Repetier. Además, he perfeccionado el mensaje de aviso de que se trata de una sesión temporal.

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

La única cosa fea que tiene la sesión de invitado es que nada más crearse, envía un mensaje de error diciendo que no se encuentra un proceso con un PID determinado (cada vez uno distinto).

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

No he sido capaz de hacer que este mensaje no aparezca, pero no da problemas, simplementa se da en Ok y la sesión es totalmente funcional.

Si os gusta cómo lo he dejado, el próximo día se puede replicar en Blacky en mucho menos tiempo.

Lo único que le queda a este PC es hacerle un backup en Clonezilla 😊

davidvelascogarcia, 2017-11-16:
@Siotma
El nuevo backup de los ordenadores de ASROB, ya se encuentra disponible en Sourceforge. A su vez, se ha modificado el link del readme del repositorio de impresoras de Github para la descarga y sustituir la descarga de drive por la del repositorio de Sourceforge.
He aprovechado, y he pasado los anexos 3 y 4 del manual, de como realizar el backup o restaurar, a ficheros PDF, intentando dejarlos algo más preparados y subido al repositorio de Sourceforge junto al backup. A su vez,también hay una copia en el repo de Github de impresoras.

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

Figura 1. Ficheros Sourceforge

Adjunto los links:

Backup en Sourceforge:
[https://sourceforge.net/projects/asrob/files/Backup_OS_3D_Printers_PCs/?upload_just_completed=true](url)

Fichero PDF de proceso de Backup
[https://github.com/asrob-uc3m/impresoras-asrob/blob/master/Backup%20S.O%20configuraciones%20y%20aplicaciones%20de%20equipos%20de%20impresion/Proceso%20de%20backup.pd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](url)

Fichero PDF de restauración de Backup
[https://github.com/asrob-uc3m/impresoras-asrob/blob/master/Backup%20S.O%20configuraciones%20y%20aplicaciones%20de%20equipos%20de%20impresion/Reinstalacion%20de%20sis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](url)

davidvelascogarcia, 2017-12-06:
@jgvictores El README.md esta actualizado. He borrado la carpeta, y he dejado solamente el README.md con los ficheros de backup, adjunto [link](https://sourceforge.net/projects/asrob/files/Backup_OS_3D_Printers_PCs/).

jgvictores, 2017-12-07:
> El README.md esta actualizado. He borrado la carpeta, y he dejado solamente el README.md con los ficheros de backup, adjunto [link](https://sourceforge.net/projects/asrob/files/Backup_OS_3D_Printers_PCs/).

@davidvelascogarcia Está realmente genial. Gracias!

davidvelascogarcia, 2017-12-07:
Me alegro. Con tal de ayudar.

dmarcosm, 2018-09-19:
Para evitar tener issues duplicadas, cierro esta issue y continuamos en https://github.com/asrob-uc3m/impresoras-asrob/issues/78, donde seguiremos con la configuración y documentación del PC que tenemos actualmente.

Closed 2018-09-19.

Thread 4 (2016-11-30):

HIJA RESURRECTION problema con pasos por mm

jgvictores, 2016-11-30:
Nota: Issue puesta hace 28 días por @jorgerc21 migrada desde https://github.com/asrob-uc3m/impresoras-maintenance-manual-i3/issues/2

Today @Rodriwp and me have been testing Hija Resurrection trying to fix it, these are the problems we have found:

- Excesive amount of material extruded: To solve it we have decreased the extrusion speed (From 250 to 150 -recommended value- and then to 50) It improved the printing quality, but not enough.

- Second layer is printed "inside" the first one, the extrusor does not lift to keep printing.

- Noisy motors

- Printer miss-recognizes dimensions

@Siotma suggested changing some config in Configuración/Configurar Firmware EEPROM in the fields Pasos por mm form 80-80-400-775 to 160-160-8000-315 and it worked perfectly, but these changes although being saved, are dismissed when the printer is reconnected.

Additionally, we have replaced the init files in the PC by the ones in the guide before knowing this info.

Pending to be done:

- [ ] Make EEPROM changes persistent

- [ ] Get further information of why this problem happen and document it

jgvictores, 2016-11-30:
Esto es, la solución actual es: cambiar `Configuración/Configurar Firmware EEPROM` en los campos `Pasos por mm` de `80-80-4000-775` a `160-160-8000-315`. Esto debe hacerse cada vez que se reinicia el PC.

David-Estevez, 2016-11-30:
Curiosamente, la configuración actual es de `165-165-4200-800`, pero sigue sin poder cambiarse... ¿Ha cambiado alguien dicha configuración?

UAVs --> @andrespy
City of ... --> @Rodriwp

Rodriwp, 2016-11-30:
City of Robots no ha cambiado configuraciones en la impresora en su horario de reunion.

David-Estevez, 2016-11-30:
:+1:

Es sobretodo para que nos diga cómo diantres lo ha conseguido, que estamos intrigados :joy:

Dani191995, 2016-12-01:
Estuve un par de dias intentando arregrarlas lo que hice fue meterles el marlin que hay en kitprinter, y usar pronterface y cura, con respecto al marlin la impresora extruia mucho por lo que le cambie los valores que no podeis cambiar, lo que me fije es que el eje z no subia lo necesario cambiase lo que cambiase, el eje x e y parecen ir bien, el tema de que no lo podais cambiar me imagio que es usando repetier o pronter si no me equivoco, entonces a lo mejor no os deja cambiarlo  por algo en el codigo, no se porque no os deja cambiar los valores.

Siotma, 2017-02-08:
Hoy he probado Hija Resurrection y no parece que siga teniendo este problema. Aún así no lo he comprobado del todo. Sugiero que alguien lo compruebe y cierre esta Issue.

David-Estevez, 2017-02-08:
Mencionaremos a nuestro actual responsable ( @jorgerc21 ) para que se pase por allí cuando pueda y lo compruebe.

Siotma, 2017-02-16:
Efectivamente, la configuración actual es 165, 165, 4200. Los ejes X e Y imprimen bien aunque un pelín grandes (yo creo que lo suyo es 160), y el eje Z imprime aproximadamente la mitad, por lo que yo apostaría por 8000.

@Dani191995 entonces, ¿tú cogiste y pusiste un firmware que pillaste por ahí o como? ¿Tienes una copia del firmware que pusiste?

Dani191995, 2017-02-16:
Cogí el firmware de la página kitprinter, porque iban mal los pasos y
después como iba igual cambie los valores.

El 16 feb. 2017 4:29 p. m., "Manu" <notifications@github.com> escribió:

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

Siotma, 2017-02-16:
De acuerdo, gracias por aclararlo. Esto enlaza con la issue #1. Desconozco si los firmware de las impresoras están documentados en algún sitio. En caso negativo, en el grupo de trabajo ( #12 ) lo tenemos como uno de los objetivos principales.

Siotma, 2017-03-02:
Hoy, hemos flasheado este código a Hija Resurrection.

No hemos podido realizar pruebas de impresión aún, pero animamos a todos los usuarios a que las hagan.
[Marlin-1.0.2-2_Hija_Resurrection_2_Marzo.zip](https://github.com/asrob-uc3m/impresoras-asrob/files/814002/Marlin-1.0.2-2_Hija_Resurrection_2_Marzo.zip)

Siotma, 2017-03-02:
Las pruebas de impresión realizadas por @JorFru y reflejadas en #11 demuestran que el problema finalmente se ha subsanado al flashear el nuevo firmware.

Closed 2017-03-02.

Thread 5 (2016-11-30):

HIJA RESURRECTION Impresora atascada

jgvictores, 2016-11-30:
Nota: Issue puesta hoy por @David-Estevez migrada desde asrob-uc3m/impresoras-maintenance-manual-i3#3

La  impresora que no es negra (la Steel) está atascada.

Cuando llegamos el racor de la entrada estaba quitado.

Al intentar colocar el nuevo filamento, nos dimos cuenta de que ya había uno colocado, pero cortado a una altura justo por debajo de los engranajes. Calentando el hotend a 200ºC e intentando sacar / meter el trozo de filamento que hay dentro, el filamento no se mueve en absoluto.

Lo que viene siendo un atasco total.

jorgerc21, 2017-02-01:
Impresora desatascada, queda pendiente comprobar si funciona correctamente, reordenar el cableado y de algún modo enganchar la tapa del ventilador del extrusor que está suelta en la parte superior. Abro issue para arreglar el resto de problemas.

Closed 2017-02-01.

Thread 6 (2016-11-30):

BLACKY no se sabe lo que le pasa

jgvictores, 2016-11-30:
En fin, que no se sabe lo que le pasa.

Siotma, 2017-02-08:
Ya se sabe lo que le pasa. Consultar #11. Cierro.

JorFru, 2017-03-07:
Blacky dió problemas las dos veces que fui a imprimir con ella.
La primera capa la imprime bien. Al pasar a la segunda, parece que no sube lo suficiente en el eje Z. Atropella lo que había impreso antes, y cuando intenta hacer la tercera capa todavía peor. Parada de emergencia antes de romper algo.
Se probó cambiando la altura de capa a casi el doble y nada. Se revisó la configuración de pasos/mm y no aparecían valores en la pantalla. Se puso en pasos/mm del eje Z el mismo valor que tiene Hija y tampoco hemos conseguido que suba de altura para hacer la segunda y sucesivas capas.

Actualmente inoperativa a no ser que quieras imprimir algo de una capa.

andrespy, 2017-03-07:
Los pasos por mm estan bien puestos en el Marlin? Podria ser una causa

Siotma, 2017-03-07:
La cuestión es que el viernes pasado estuve imprimiendo sin errores,
entonces es un fallo que ha aparecido entre el viernes por la mañana y el
lunes.
Este jueves investigaremos y probablemente le flashearemos un firmware
nuevo para tener las dos impresoras con la misma versión.

Enviado desde Android

El 7 mar. 2017 15:29, "andrespy" <notifications@github.com> escribió:

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

Morgloz, 2017-03-09:
Era un problema con Slicer, estaba configurado con un offset de -4. Ya está corregido
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

JorFru, 2017-03-09:
Ayer probé a imprimir con un perfil de Slic3r que hice a posta y llamé
JorFru-prueba. Ajusté el parámetro Zoffset a 0 y aunque mejoró un poco la
cosa, seguía arrastrando mucho el extrusor por la pieza. Parada de
emergencia a la tercera capa por riesgo de rotura.

Si decís que está bien cojonudo. Igual que el problema llegó, se puede ir:
fugazmente.

Qué desajustes más raros le ocurren a esa máquina...

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

Closed 2017-03-09.

Thread 7 (2016-11-30):

Mejoras en página de "Gestión de Impresoras" de asrob.uc3m.es

jgvictores, 2016-11-30:
Estamos mejorando http://asrob.uc3m.es/index.php/Gestión_Impresoras

- [x] Enlazar con el grupo de Telegram
- [x] Implementando algo como el diagrama de flujo de la figura.
- [x] Implementando scripts que automaticen este proceso ( #8 )

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

andrespy, 2016-12-01:
Ya es hora de contribuya un pelin
Aqui esta el diagrama:
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

Si alguien quiere dejarlo más bonito, tengo el archivo del programa dia, que es software gratuito.

andrespy, 2016-12-01:
Ya es hora de que contribuya un pelin
Aqui dejo el diagrama:
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

Esta hecho con el programa dia que es software gratuito asi que si alguien quiere mejorar el diagrama cuando sepa donde poner el archivo lo subo para que lo haga.

jgvictores, 2016-12-05:
Enlazado con grupo de telegram en wiki: http://asrob.uc3m.es/index.php/Gesti%C3%B3n_Impresoras

Siotma, 2017-12-09:
@David-Estevez , @jgvictores . Esta issue es muy antigua y no está en el repo que debe. Sin embargo creo que a día de hoy, ya está más que resuelta.

David-Estevez, 2017-12-10:
Yo movería los "enlaces útiles" al manual de usuario, pondría el cartel enlazando a la nueva página y con eso daría esta issue por cerrada.

jgvictores, 2017-12-10:
1. Teníamos la idea de sólo poder reservar si está logueado un operario. ¿Esto está hecho?

2. Nunca hice nada parecido, pero en GitBook puedes acceder con una cuenta de GitHub (aparte de Google, etc). Si lo de (1) no está hecho, sería una opción, no?

Siotma, 2017-12-10:
> Teníamos la idea de sólo poder reservar si está logueado un operario. ¿Esto está hecho?

Actualmente, está hecho que únicamente personas identificadas con una cuenta de correo UC3M en Google pueden reservar.

> Nunca hice nada parecido, pero en GitBook puedes acceder con una cuenta de GitHub (aparte de Google, etc). Si lo de (1) no está hecho, sería una opción, no?

No entiendo cuál es el objetivo de utilizar cuentas de GitBook. Sin embargo, creo que las propuestas para perfeccionar el sistema de reservas deberían hacerse [aquí](https://github.com/asrob-uc3m/printers-status-webpage/issues/4).

jgvictores, 2017-12-10:
> No entiendo cuál es el objetivo de utilizar cuentas de GitBook. Sin embargo, creo que las propuestas para perfeccionar el sistema de reservas deberían hacerse [aquí](https://github.com/asrob-uc3m/printers-status-webpage/issues/4).

Sí, me referí a GitBook pero el del Issue mover es igual, como propones [en la issue correspondiente](https://github.com/asrob-uc3m/printers-status-webpage/issues/4#issuecomment-350535856). Totalmente de acuerdo con seguir los desarrollos ahí.

@Siotma Cierra esta issue sin problema, ¡gracias!

Siotma, 2017-12-10:
Wiki actualizada: http://asrob.uc3m.es/index.php/Gesti%C3%B3n_Impresoras

Manual de usuario actualiado: https://asrob-uc3m.gitbooks.io/impresoras-user-manual-i3/content/enlaces_utiles.html

Closed 2017-12-10.

Thread 8 (2016-11-30):

Software de automatización de estado de impresoras

David-Estevez, 2016-11-30:
Se desea desarrollar un software que corra en el servidor de ASROB y que realice la laboriosa tarea de automatizar la página de impresoras de la wiki (ver issue #7 ).

Para ello, propongo desarrollar un bot que viva en el servidor de ASROB. Su funcionamiento será muy sencillo:

1. Cuando se estropee una impresora, el usuario deberá poner una issue en este repositorio, con las etiquetas "no funciona" y la etiqueta de la impresora.
2. Github notificará con un webhook a nuestro bot que se ha creado una issue nueva.
3. El bot usa la API pública de Github para encontrar los datos de la issue, y los escribe en dos páginas plantilla (template) de la wiki, una por cada impresora actual. En esa template se escribirá un número:
    * Si la impresora funciona correctamente, -1
    * Si la impresora no funciona, el número de la issue en la que se detalla el error (Siempre >0)
4. La wiki usa esa plantilla para generar automáticamente una página según lo descrito en #7

David-Estevez, 2017-04-11:
A modo de primera aproximación, he creado https://github.com/asrob-uc3m/printers-status-webpage

Es una web estática, lo que significa que habría que hacer un cron job periódico para mantenerla actualizada. Como sólo implica una petición a la api de github, no creo que haya problema por actualizar la página 3/4 veces al día.

En el futuro se podría integrar con los webhooks de GitHub para que GitHub informase de nuevas issues o issues resueltas y la página se actualizase al nuevo estado.

Si os mola la página, me coordino con @jgvictores para integrarla lo antes posible en la web de ASROB.

David-Estevez, 2017-04-12:
Ya lo tenemos funcionando! http://asrob.uc3m.es/printers/

Se debería actualizar cada hora de las 8h a 22h (por si hay alguna incidencia durante el día). No es instantáneo pero debería servir por ahora.

Siotma, 2017-04-15:
Pequeños comentarios al trabajo realizado:

1. La web es una pasada total. Me encanta el aspecto, lo bien que se maneja con el móvil... todo!
2. El texto correspondiente al apartado "manual de operador" no es el adecuado, ya que es el mismo que el de "incidencias".
3. La hoja de excel a la que dirigen los botones de reserva es en ambos casos la misma, esto puede permitir que la gente realice reservas en una impresora no disponible.
4. La hoja de excel está desactualizada en fecha y en disponibilidad de impresoras.

5. Pese a que el sistema de la hoja de cálculo ha demostrado históricamente cumplir con su cometido, se trata de algo totalmente arcaico, y ya que hemos dado un lavado de cara a la página de gestión, propongo ir más allá y mejorar esa parte también.

Ideas:

- Programar una página con un formulario (por ejemplo, en [html](https://www.w3schools.com/html/default.asp)) en el que sea necesario introducir un correo de dominio uc3m. Se enviará un correo de confirmación a esa dirección para confirmar la reserva. De esta manera llevaremos un control de quién y cuánto uso se hace de las impresoras. En caso de que alguien sin cuenta uc3m quiera utilizar las impresoras, el usuario deberá incluir un texto explicando el motivo del uso y el sistema además de enviar el correo de confirmación, remitirá otro correo a algún miembro de ASROB para obtener autorización.
- Crear una base de datos que será atacada desde los formularios para realizar las reservas. En esta base de datos estará almacenada la información histórica de las reservas desde el momento de su creación. Cada semana, se programará la creación de nuevas entradas en la base de datos para dar cabida a las reservas de la siguiente semana.
- Esta base de datos será leida cada vez que la página del formulario se cargue, y mostrará en una tabla similar al documento excel los huecos libres para cada impresora. Sería genial que la forma de reservar fuera pulsando sobre las distintas celdas de la tabla, al igual que se seleccionan las fechas de una estancia en un hotel, o un viaje...

Logrando esto, habremos conseguido realmente automatizar la gestión de las impresoras y la cerveza que nos tomemos sabrá mucho mejor.

David-Estevez, 2017-04-15:
Muchas gracias por los halagos, @Siotma , realmente animan a seguir trabajando en ello :smile:

Sobre los fallos que comentas (2, 3 y 4), voy a crear issues correspondientes en el [repositorio de la web de impresoras](https://github.com/asrob-uc3m/printers-status-webpage) para tenerlas centralizadas.

Sobre el punto 5, también pondré una issue, pero seguramente no se lleve a cabo de forma inmediata. Te explico, en mi opinión, por qué no es tan fácil de implementar:

* Al depender del correo, se introduce una dependencia en una persona de la asociación, que se tiene que encargar de ello. Si ya nos cuesta llevar al día el correo y las redes sociales, o incluso mantener al día la hoja de reservas, introducir una nueva responsabilidad creo que va a ser contraproducente.
* La base de datos ya existe (la hoja de reservas antigua) y no me consta que se haya consultado ninguna vez para un uso a posteriori (análisis, investigación de incidencias...).
* La página actual es una página estática. Se genera automáticamente cada hora a partir de las issues de GitHub. Las mejoras que tú dices estarían muy bien, pero tendríamos que pasar a una página dinámica, con un backend y una web. Habría que buscar o pensar en una buena interfaz para la reserva. Que sea intuitiva y que ya esté hecha, a ser posible. En definitiva, no es un "hotfix", es algo que llevaría bastante curro.

Por todo ello, creo que el sistema que propones molaría, pero no es algo que vaya a estar listo a corto plazo. Crear una página nueva de forma semanal es algo que lleva muy poco tiempo (y que se podría incluso automatizar). Como solución intermedia, si deseamos un mayor control de las reservas, mi propuesta es crear la hoja de reservas en la cuenta de la uni de ASROB, lo cual permite que sólo personas con cuenta UC3M puedan acceder al documento de reserva. O que se pueda ver de forma pública, pero sólo editar por gente de la UC3M.

¿Qué te parece esta propuesta?

Siotma, 2017-04-18:
@David-Estevez , no era consciente de que la página tuviera su propio repositorio, a futuro realizaré los comentarios en las issues correspondientes.

Suscribo totalmente los comentarios que haces. Yo hacía las propuestas con vistas a futuro, y obviamente sujetas a debate previo, pensando en que en la asociación hay gente no solo de electrónica y automática, sino también de informática y otras disciplinas para los que realizar algo como lo descrito puede requerir mucho menos esfuerzo.

En un futuro optimista, con un grupo de trabajo activo en impresoras y un sistema de gestión más optimizado, las impresoras tendrán mucho más uso del que tienen ahora y por tanto, limitar el uso a personas de la UC3M tendría valor de cara a poder usar un seguimiento de las reservas e identificar los usuarios más activos y los menos activos. Utilizando las cuentas de correo UC3M se evita que un usuario cree múltiples cuentas para reservar un número de horas mayor, y el sistema de correos de confirmación refuerza este filtro de forma activa (que tal vez se pudiera automatizar) limitando las horas de reserva y comprobando que el usuario que pretende reservar es un operador o no. Fuera de la ventaja de evitar duplicación de cuentas, no tiene mayor sentido limitar el acceso a la hoja de reservas, máxime cuando no hemos tenido problemas de este tipo todavía. Como ya he explicado, esta propuesta hace frente a problemas que aún no han surgido, pero que si conseguimos atraer más gente a usar las impresoras, puede que surjan. Por ello no veo necesario restringir el acceso a la hoja en este momento.

Por otro lado, sí existe una clara ventaja en sacar estadísticas de uso de impresoras, ya que podría valer para justificar los gastos relacionados con ellas, pedir subvenciones, obtener financiación desde el Departamento, optimizar su rendimiento (detectar problemas más frecuentes, escuchar sugerencias de usuarios), e incluso plantear mejoras funcionales o ampliación del número de impresoras disponibles.

En mi línea de coordinador de grupo de trabajo de Printer One, quiero aprovechar este nuevo tirón de gente para implementar cualquier mejora que pueda facilitar el acceso a las impresoras y reducir las tareas de mantenimiento para intentar garantizar buena salud para las mismas durante mucho tiempo.

David-Estevez, 2017-04-18:
No problem! Yo me ofrezco para todas estas cosillas informáticas, pero son cosas que se irán haciendo muuuuy poco a poco (en los ratos libres que tenga, básicamente :sweat_smile: ).

¿Damos pues por cerrada esta issue?

Siotma, 2017-04-18:
Cierra sí 👍 ya duplico yo lo que he escrito en su sitio, y que esta Issue descanse en paz.

David-Estevez, 2017-04-18:
Guay! Cerrando issue entonces...

Closed 2017-04-18.

Thread 9 (2017-02-01):

Problemas pendientes en la reparación de HIJA

jorgerc21, 2017-02-01:
Solucionado el problema del atasco en el extrusor, queda pendiente comprobar si funciona correctamente, reordenar el cableado que ha habido que desensamblar y de algún modo enganchar la tapa del ventilador del extrusor que está suelta en la parte superior.

jorgerc21, 2017-02-01:
PD: Problema anterior: #5

Siotma, 2017-02-08:
Hay una lista más detallada de problemas en #11

Closed 2017-02-08.

Thread 10 (2017-02-02):

Cambiar el cable de alimentación del extrusor

Morgloz, 2017-02-02:
Tras tener que desatornillar el extrusor para desatascarlo llegamos a la conclusión de que habríamos tardado la mitad si el cable que va del circuito al extrusor acabara en un conector, en vez de ir directamente al extrusor.

David-Estevez, 2017-02-04:
¿¿¿El cable estaba soldado a la placa???

Morgloz, 2017-02-07:
No, estaba conectado a una clema, pero el cable atravesaba el armazón y estaba sujeto con bridas en varios puntos. Sacarlo nos costó más de 20 minutos, y ponerlo de vuelta más o menos lo mismo.

David-Estevez, 2017-02-07:
Ah, pues entonces la clema hace de conector :wink:

Desmontar el extrusor es algo que no se hace muy a menudo (o no debería hacerse a menudo en condiciones normales), por lo que 20 minutos no me parece demasiado tiempo. Ahora que sabéis cómo va conectado seguramente tardéis menos incluso.

El problema de añadir un conector es que se añade también otra forma en la que puede fallar la impresora, ya sea de tanto conectar/desconectar o en las uniones del cable con el conector. Me da la impresión que a la larga daría más problemas de los que solucionaría.

Siotma, 2017-02-08:
Imagino que esta Issue es para Hija Resurrection.

En vez de cambiar el cable, hoy he estado haciendo pruebas y he comprobado que el cable está dañado, puesto que dependiendo de su curvatura el calentador calienta o no. Esa es la causa de los atascos: durante la impresión al desplazarse el eje X, el cable se mueve y la temperatura oscila. Tengo una foto que lo demuestra.
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

Sugiero hacer pruebas con el extrusor desmontado y un polímetro para medir resistencia. En caso de que sea muy difícil localizar o reparar el problema sugiero comprar un nuevo calentador.

Siotma, 2017-02-19:
Tal y como comenté en #11 , hemos confirmado que el calentador del extrusor está dañado, por lo que se debe proceder a su sustitución.

JorFru, 2017-02-21:
He hecho uso de un multímetro y he hallado que el problema estaba en los cables. @Siotma me ha ayudado a encontrarlo.

He saneado los cables, retirando la parte que daba problemas (roto el cable por dentro) y poniendo un fragmento nuevo.

He probado durante diez minutos con la impresora en movimiento y parece que ya no da problemas.

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

Ahora bien, he puesto una clema para sujetar la cinta de kapton vieja y que a su vez sujeta el termistor. Habría que ponerle cinta nueva antes de que mi solución temporal salga ardiendo.

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

Siotma, 2017-02-21:
Gracias, @JorFru.

jgvictores, 2017-02-22:
@JorFru Thanks!!!

Closed 2017-02-21.

Thread 11 (2017-02-08):

Revisión minuciosa de impresoras

Siotma, 2017-02-08:
En la mañana de hoy realicé lo siguiente:

Pasos realizados con Hija Resurrection.

	1. Introducción del filamento en Hija Resurrection
	2. Recolocación del Endstop Y de Hija Resurrection para que no estorbe al cable de alimentación de la base caliente.
	3. Recolocación de los cables del termistor de Hija Resurrection para que no toquen con la cama durante la impresión.
	3. Prueba de impresión de Hija Resurrection: fallida por atasco.
	4. Observo que el filamento se extruye con dificultad. Subo la temperatura de impresión a 200 ºC.
	4. Advierto que la temperatura del extrusor de Hija Resurrection cae a pesar de tener la consigna de calentar.
	5. Tras varias pruebas, confirmo que el calentador del extrusor de Hija Resurrection está dañado y dependiendo de la posición de los cables funciona o no: ¿Cable seccionado?
	6. Tras asegurar el cable procedo a una nueva prueba de impresión.
	7. Prueba de impresión satisfactoria.

El diagnóstico de Hija Resurrection es:
- [x] 1. Cable del calentador del extrusor dañado: recomiendo desmontarlo y evaluar daños y/o cambiarlo por uno nuevo.
- [x] 2. Temperatura de impresión demasiado baja: recomiendo usar 200ºC
- [x] 3. También recomiendo fijar el termistor del extrusor con Kapton ya que se mueve mucho en su agujero y eso puede falsear las lecturas de temperatura. Pese a ello estoy seguro de que el cable del Extrusor está dañado (he usado los dedos para asegurarme).
- [ ] 4. Además, el ventilador de la electrónica está suelto.
- [x] 5. Además, el ventilador del extrusor está semi suelto.

Pasos realizados con Blacky.

	1. Introducción de filamento: fallido: extrusor atascado.
	2. Desatasco del extrusor con el siguiente proceso.
		1. Retirar el ventilador del disipador.
		2. Aumentar la temperatura del extrusor.
		3. Introducción repetida de un alambre fino por la parte superior para eliminar el atasco.
		4. Pruebo a introducir de nuevo el filamento: éxito. Saco el filamento ya que el extrusor está muy caliente.
		5. Recoloco el ventilador y procedo a enfriar el extrusor antes de meter de nuevo el filamento.
	3. Con el extrusor frío introduzco de nuevo el filamento: éxito.
	4. Prueba de impresión utilizando la siguiente configuración:
		a. Mi propio ordenador portátil, ya que el suyo no se puede utilizar porque el monitor no tiene fuente de alimentación.
		b. El cristal de la base de Hija Resurrection porque Blacky no tenía cuando llegué.
		c. El soporte de filamento de Hija Resurrection porque Blacky no tenía cuando llegué.
	5. Éxito de la prueba de impresión.

El diagnóstico de Blacky es:
- [x] 1. Le falta el cristal de la base.
- [x] 2. Le falta un soporte para el filamento.
- [x] 3. No se puede utilizar su ordenador al carecer el monitor de fuente de alimentación.
- [x] 4. La impresora estaba atascada, la he desatascado.
- [x] 5. La prueba de impresión ha demostrado que la base de Blacky y/o el eje X están desnivelados
- [ ] 6. Además, Blacky carece de ventilador para la electrónica.
- [x] 7. Además, el cable del Endstop Y de Blacky está muy tirante y estorba el movimiento de la base.

David-Estevez, 2017-02-08:
Simplemente decir que esta issue es de lo mejorcito en calidad que hemos tenido en ASROB en mucho tiempo. :clap: :clap: :clap:

Muchas gracias por acercarte a echarnos un cable con las impresoras, @Siotma

Siotma, 2017-02-16:
Esto es lo que hemos hecho hoy con Hija Resurrection:

1. Yo, he donado una bobina de filamento ABS verde a HIJA RESURRECTION. Imprimir a 220ºC extrusor y 100ºC base.
2. Prueba del extrusor de HIJA RESURRECTION con polímetro. No parece estar dañado. Hemos mejorado las conexiones en la placa: cable saneado y estañado.
3. Prueba de impresión de HIJA RESURRECTION: éxito parcial
	Los pasos por mm del eje Z siguen estando mal, se deben cambiar a 8400 pasos por mm, ver #4
	La base está desnivelada. La he nivelado.
4. Hemos sujetado bien el termistor utilizando Kapton que he llevado yo.
5. Prueba de impresión de HIJA RESURRECTION: éxito.
6. Tras sucesivas pruebas, el error del calentador del extrusor ha vuelto a aparecer, por lo que vamos a pedir uno nuevo. Jorge se encargará de realizar el pedido.
7. Hemos afianzado el ventilador del extrusor.

Y con Blacky:
1. Colocación del filamento ABS amarillo de ASROB a Blacky, y del soporte de madera.
2. Se han realizado pruebas positivas de impresión con Blacky utilizando el ABS amarillo, por lo que lo hemos dejado puesto.
3. Aún no se puede utilizar porque carece de cristal en la base.
4. Hemos conectado la fuente de alimentación (12V, 3.3A) al monitor previa consulta a Rodrigo, quien asegura que es la suya. No he sido capaz de encontrar ninguna referencia al monitor por internet.
5. El PC carece de software de impresión (o al menos no lo hemos encontrado), por tanto hay que hacer caso a #2

jgvictores, 2017-02-16:
Re: Blacky (4):
- Buscar buscar buscar.
- https://www.alibaba.com/product-detail/17-Inch-LCD-Monitor_10801015.html
- http://www.freewtc.com/products/17-inch-lcd-monitor-528134-61531.htm
- Y no pensar en hacer cosas como: http://www.forosdeelectronica.com/f27/monitor-necesita-transformador-12v-puedo-ponerle-uno-19v-45988/

Siotma, 2017-02-21:
Hoy, de 13:00 a 15:00, hemos estado trabajando con Blacky:

1. La base donada por @jgvictores queda preciosa en Blacky. Le hemos quitado el Kapton y limpiado con limpiacristales. Ya le hemos echado bien de laca y funciona a la perfección. Cuidémoslo entre todos para que dure!
2. He donado 3 pinzas para sujetar el cristal a la base, pues solo había puesta en Blacky cuando llegamos.
3. Hemos cambiado de lado el endstop del eje Y, y alargado el cable utilizando un alargador de servos para evitar enganches durante la impresión.

Además, hemos trabajado con su ordenador:

1. Hemos descargado las librerías Mono utilizando [este tuto](http://www.mono-project.com/docs/getting-started/install/linux/#debian-ubuntu-and-derivatives).
2. Luego las hemos instalado `apt install mono-complete`.
3. Tras su instalación, el instalador de Repetier aún detectaba un problema con la versión, por lo que hemos limpiado instalaciones anteriores.
4. Hemos realizado sucesivas pruebas con Repetier y crasheaba siempre. Lo hemos lanzado con la consola y parecía ser un problema con las librerías X (XRead...).
5. Hemos añadido el usuario asrob al grupo dialout con `sudo usermod -a -G dialout asrob`
6. Hemos vuelto a lanzar Repetier desde la consola y no ha habido problema: en su directorio creo que hay que ejecutar `mono RepetierHost.exe`.
7. Comportamiento absolutamente estable del programa y prueba de impresión positiva utilizando Cura por defecto.
8. Durante la impresión hemos descargado Slic3r y lo hemos dejado listo para empezar a calibrar la impresora y a configurar los perfiles de impresión.

Hay que destacar, que no estamos seguros de qué era lo que fallaba, ni si volverá a hacerlo.

Créditos a @Morgloz y a @Honru por su ayuda e ideas durante este proceso.

Siotma, 2017-02-21:
No quito la etiqueta de Blacky porque, aunque ya funciona, aún no debe ser utilizada por externos, ya que no se encuentra configurada. De esta forma no se permitirá realizar reservas.

JorFru, 2017-03-02:
En la reunió de hoy se ha flasheado [este](https://github.com/asrob-uc3m/impresoras-asrob/issues/4#issuecomment-283662186) firmware a Hija Resurrection.
Se han nivelado las camas de ambas, Hija y Blacky.
El ajuste de pasos por mm de Hija se ha resuelto y ya imprime con las dimensiones correctas.
Y se han hecho algunas pruebas de impresión y se añaden las fotos a continuación.
Respecto al software del ordenador de blacky, se sigue trabajando en ello, falta por terminar de configurar Slicer para trabajar en el usuario invitado.
Se ha descubierto un error en Hija que consiste en que salta error de temperatura de la cama por salirse fuera del rango de trabajo (ahora puesto a 100°). Pensamos que es por el uso de un relé para controlar la resistencia, por eso la temperatura cambia de forma abrupta y por eso detecta error.
La calidad de la impresión en mejorable. Y por eso estamos aquí!

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

JorFru, 2017-03-02:
Las piezas están saliendo bien en cuanto a medidas.
El problema de error en la temperatura creemos que está ya resuelto. Hemos cambiado el tiempo de refresco de la lectura de temperatura de la cama (de 5000 a 1000ms) y hemos activado la función de histéresis para que el control sea mejor.
Damos por cerrada la issue, ya que esto funciona y abriremos otra para añadir mejoras y pijadas a las máquinas.

Closed 2017-03-02.

Thread 12 (2017-02-08):

Reunión de gente interesada en impresoras.

Siotma, 2017-02-08:
Creo que las impresoras nos gustan a todos los miembros de ASROB, pero me temo que por miedo o desconocimiento no disfrutamos de ellas todo lo que se podría.

Propongo una reunión de gente interesada en este asunto, conmigo como instructor y resolvedor de dudas. En caso de tener tirón se podría crear grupo de trabajo activo y creo que sería justificable que tuviéramos pleno acceso a las impresoras para perfeccionarlas y trastear todo lo que queramos... que van súper lentas XD.

Mi disponibilidad es de cualquier día (preferiblemente miércoles) por la mañana. Dentro de dos meses también podré por la tarde pero hasta entonces no...

Contestad con vuestra opinión y/o disponibilidad. En caso necesario crearé un Doodle para acordar una fecha.

Saludos.

Morgloz, 2017-02-08:
Yo puedo por las mañanas también

Siotma, 2017-02-10:
Hola, @Morgloz. Gracias por tu respuesta!

En vista de que la issue no ha tenido mucho tirón he creado un Doodle donde podemos concretar la primera reunión. De esta manera espero que pueda llegar a más gente.

Utiliza el siguiente enlace para especificar tu disponibilidad.

http://doodle.com/poll/nt87w6ppyrppas5m

Siotma, 2017-02-13:
El doodle se ha cerrado ya.

La fecha seleccionada es el próximo jueves día 16 de febrero.

Yo estaré en la nave desde las 9:00 horas. De esta manera, podré dedicar un buen tiempo tanto a Jorge como a Alejandro explicando cosas. De 13:00 a 14:00 horas será la "reunión de grupo" para tratar temas como los intereses, líneas de investigación y disponibilidad de los miembros.

¡Animo a todo el mundo a pasarse por la nave durante la mañana!

Se informará por esta issue de los resultados.

Siotma, 2017-02-16:
Tras la reunión de hoy, hemos llegado a la conclusión de que hay gente en ASROB que está interesada en:

1. Aprender más sobre impresoras.
2. Mejorar las impresoras de la asociación.
3. Llevar un seguimiento de su estado, y ser capaces de realizar un mantenimiento.
4. Documentar todo lo anterior.

En concreto, entre otras cosas hemos hablado de:

1. Documentar y actualizar el firmware de las impresoras.
2. Calibrar los pasos por mm de los ejes de las impresoras.
3. Realizar mejoras estructurales como la colocación de ventiladores

Hemos propuesto una segunda reunión para el próximo martes a las 13:00, aunque voy a dejar un Doodle por aquí: http://doodle.com/poll/2idnnvxa5dbhb95s

Siotma, 2017-02-20:
El doodle se ha cerrado. La reunión tendrá lugar mañana de 13:00 a 15:00 en la nave 1.0.B06.
Recuerdo que en caso de que lleguéis y esté cerrado, os asoméis por la barandilla del primer piso para comprobar si estamos dentro y avisarnos para que se os abra.
Será útil que traigáis vuestros portátiles, en la medida de lo posible.

Como siempre, todo el que quiera venir está invitado!

Los resultados se postearán aquí.

Siotma, 2017-02-21:
En la reunión de hoy se ha trabajado con Blacky (ver #11).

Hemos trabajado en la estructura de la impresora y también hemos estado jugando con Linux para instalar las librerías y echar a andar Repetier.

Además, @JorFru ha estado trabajando con el calentador del extrusor de Blacky.

Habrá una reunión la semana que viene. Doodle: http://doodle.com/poll/cgp9r294tnbk23f8

Siotma, 2017-02-27:
El doodle se ha cerrado. La reunión tendrá lugar el jueves día 2 de marzo de 13:00 a 15:00 en la nave 1.0.B06.
Recuerdo que en caso de que lleguéis y esté cerrado, os asoméis por la barandilla del primer piso para comprobar si estamos dentro y avisarnos para que se os abra.
Será útil que traigáis vuestros portátiles, en la medida de lo posible.

Trabajaremos en la calibración de ambas impresoras con el objetivo de dejarlas operativas:

- Aprenderemos a configurar los parámetros de Repetier y Slic3r para obtener buenos resultados en las impresiones.
- Aprenderemos a configurar el firmware de las impresoras (Marlin) y flashearemos la última versión para corregir los pasos por mm de Hija Resurrection.

Como siempre, todo el que quiera venir está invitado!

Los resultados se postearán aquí.

Siotma, 2017-03-02:
En la reunión de hoy se ha trabajado con ambas impresoras (ver #11 )
@Morgloz , @jorgercobo , @LuciaHonrubia y @JorFru (menciono para que se suscriban automáticamente al hilo) hemos estado nivelando las impresoras y mejorando la instalación de Repetier en Linux. Además hemos aprendido a configurar el firmware de Hija Resurrection para arreglar el problema de pasos por mm, aunque ha aparecido otro nuevo relacionado con un sistema de seguridad que se activa de manera demasiado estricta ante cambios de temperatura en la base de impresión. Seguimos trabajando en ello.

Para ello he hecho un nuevo **Doodle** para la semana que viene: http://doodle.com/poll/7u782whypyuacmp8

Adicionalmente, y a nivel personal, mañana estaré durante la mañana en la nave haciendo pruebas con las impresoras, aproximadamente de 10 a 13 horas. Todo el que pueda acercarse será bienvenido :)

David-Estevez, 2017-03-02:
Llamadme pesado, pero... http://goo.gl/forms/movrqVPe6k :see_no_evil:

Siotma, 2017-03-05:
El doodle se ha cerrado. La reunión tendrá lugar el jueves día 2 de marzo de 13:00 a 15:00 en la nave 1.0.B06.
Recuerdo que en caso de que lleguéis y esté cerrado, os asoméis por la barandilla del primer piso para comprobar si estamos dentro y avisarnos para que se os abra.
Será útil que traigáis vuestros portátiles, en la medida de lo posible.

Trabajaremos en la calibración de ambas impresoras con el objetivo de mejorar su funcionamiento:

1. Aprenderemos a configurar los parámetros de Repetier y Slic3r para obtener buenos resultados en las impresiones.
2. Debatiremos las posibilidades de formalizar el grupo de trabajo activo #16

Como siempre, todo el que quiera venir está invitado!

Los resultados se postearán aquí.

Siotma, 2017-03-09:
En la reunión de hoy hemos hecho lo siguiente:

- Nos hemos constituido como grupo de trabajo activo, tras valorar si teníamos la motivación y cumplíamos los estatutos (ver #16 ).

- Realizado una prueba de impresión en Hija Resurrection. El resultado ha sido satisfactorio salvo porque la impresión se ha interrumpido debido a un nudo en el filamento. Ya ha sido resuelto, y esperamos que no vuelva a pasar.

- Investigado los motivos por los que a Blacky no se sabía lo que le pasaba ( #6 ). El problema ha resultado ser el offset de Z en los perfiles de slic3r. Slic3r generaba el gcode para que la impresión empezara en la coordenada Z=-4, sin embargo la impresora está configurada para nunca alcanzar una posición de Z menor que 0, lo cual es muy lógico y necesario si tenemos en cuenta que existe un límite físico llamado endstop.
Así pues, cuando el gcode envía la impresora a una posición menor que 0, esta se limita a no moverse. De esta manera, hemos calculado que las primeras 15 capas aproximadamente se imprimirían al mismo nivel, hasta que la coordenada Z del gcode fuera superior a 0 y la impresora comenzara a subir.
Lo desconcertante es que este parámetro ya había sido cambiado en reuniones anteriores, por lo que debemos hacer es descubrir por qué ha vuelto a ponerse mal.
Tras solucionar el problema, se ha realizado una prueba de impresión satisfactoria.
- Además, se ha añadido a la base de impresión de Blacky, una pieza de cartón por debajo, a modo de aislante, de manera que se acelere el proceso de calentamiento de la base antes de una impresión.
- Por último, hemos estado repasando algunos conceptos importantes de los perfiles de Slic3r que seguiremos comentando en la próxima reunión.

En la próxima reunión:

- Hablaremos mucho de Slic3r por lo que recomiendo leer acerca de este programa en el siguiente enlace: http://manual.slic3r.org/ , o ver algún vídeo en youtube como https://www.youtube.com/watch?v=AVf6GUcxiJU.
Incluso podéis descargar el programa en http://slic3r.org/ , instalarlo e investigar en los distintos menús para familiarizaros con su aspecto. La interfaz es bastante autoexplicativa.

- Además, flashearemos la última versión de Marlin en Blacky, dados los problemas encontrados a la hora de obtener sus ajustes.

He creado un nuevo Doodle, al que se puede acceder en dos formatos:

- Tabla: http://doodle.com/poll/kq2rzkfu3ykmm7ys#table
- Calendario: http://doodle.com/poll/kq2rzkfu3ykmm7ys#calendar

Animo a todos los interesados a participar en la votación.

Siotma, 2017-03-13:
El doodle se ha cerrado. La reunión tendrá lugar el martes día 14 de marzo de 13:00 a 15:00 en la nave 1.0.B06. Además, he seleccionado el día de hoy y el jueves en el mismo horario como días adicionales para que otros miembros del grupo de trabajo puedan acercarse a trastear con Slic3r.

Recuerdo que en caso de que lleguéis y esté cerrado, os asoméis por la barandilla del primer piso para comprobar si estamos dentro y avisarnos para que se os abra. Si no os es posible acceder en los horarios marcados, pedid ayuda por el grupo horizontal para que alguien pueda abriros.

Será útil que traigáis vuestros portátiles, en la medida de lo posible, sobre todo el martes.

- Trabajaremos en la configuración de los parámetros de Repetier y Slic3r para obtener buenos resultados en las impresiones.

- El martes, también, flashearemos un nuevo Marlin en Blacky

Como siempre, todo el que quiera venir está invitado!

Los resultados se postearán aquí, y en el [Cuaderno de Bitácora](http://asrob.uc3m.es/index.php/Printer_One:_A_Clone_Wars_Story:_Cuaderno_de_Bitacora).

jgvictores, 2017-03-13:
@Siotma Enhorabuena por la cantidad de curro que le estáis echando, y sobre todo... ¡Muchas Muchas GRACIAS y ENHORABUENA por estar documentando con tanto detalle!

cc: @Morgloz @jorgercobo @LuciaHonrubia @JorFru et al. [at] Printer One.

David-Estevez, 2017-03-13:
Su cuaderno de bitácora tiene muchísima mejor pinta que el nuestro... habrá que aprender de ellos!!

Siotma, 2017-03-14:
En la reunión de hoy, hemos trabajado con ambas impresoras:
En Blacky:
- Hemos flasheado la última versión de Marlin.
- Hemos realizado una prueba de impresión satisfactoria.

En Hija Resurrection:
- Hemos realizado dos pruebas de impresión satisfactorias (ver imagen)
- Hemos colocado el cartón por debajo de la base para reducir la pérdida de energía.
- Hemos retirado la brida y hemos puesto un trozo nuevo de kapton en el extrusor para sujetar el termistor.

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

En la próxima reunión veremos lo siguiente:

- Mejorar los finales de carrera.
- Aprender a editar la Wiki.
- Dejar unos perfiles de Slic3r definitivos, haciendo hincapié en la impresión de puentes.

El link del doodle es:
- Tabla: http://doodle.com/poll/kwbv2gz54ewt5vym#table
- Calendario: http://doodle.com/poll/kwbv2gz54ewt5vym#calendar

Todos a votar.

Siotma, 2017-03-19:
El doodle se ha cerrado. La reunión tendrá lugar el viernes día 24 de marzo de 13:00 a 15:00 en la nave 1.0.B06.

Recuerdo que en caso de que lleguéis y esté cerrado, os asoméis por la barandilla del primer piso para comprobar si estamos dentro y avisarnos para que se os abra.

Será útil que traigáis vuestros portátiles, en la medida de lo posible.

    Trabajaremos en la configuración de los parámetros de Repetier y Slic3r para obtener buenos resultados en las impresiones. También realizaremos trabajos estructurales en cuanto a la ubicación de los finales de carrera, y aprenderemos a editar la Wiki.

Como siempre, todo el que quiera venir está invitado!

Los resultados se postearán aquí, y en el [Cuaderno de Bitácora](http://asrob.uc3m.es/index.php/Printer_One:_A_Clone_Wars_Story:_Cuaderno_de_Bitacora).

Siotma, 2017-03-24:
En la reunión de hoy, hemos trabajado con ambas impresoras:
En Blacky:

1. Hoy hemos nivelado el final de carrera de Z.
2. Impresión de pieza de calibración para comprobar que las dimensiones de impresión son correctas y los ángulos entre el eje X y Y están a 90º.
3. Se comprueba que los ejes están a 90º y las dimensiones tienen un error menor del 0.7%. (ver imagen)

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

En Hija de Resurreción:

1. Se ha visto que el Kapton recientemente adquirido se ha quemado a temperaturas a las que esto no debería ocurrir (220 grados). (ver imagen)
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

2. Impresión de pieza de calibración para comprobar que las dimensiones de impresion son correctas y los ángulos entre el eje X y Y están a 90º.
3. Se comprueba que los ejes están a 90º y las dimensiones tienen un error menor del 0.6%. (ver imagen)

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

Además, hemos buscado ideas en Thingiverse para mejorar los finales de carrera. Próximamente se intentarán implementar estas mejoras.

Siotma, 2017-03-27:
He creado un Doodle para la presente semana.
Como ya comenté, esta semana me será imposible acudir a la reunión, aun así ya acordamos que yo no soy tan importante y que podéis tirar sin mi  :stuck_out_tongue_winking_eye:

He propuesto dos objetivos para que sigamos avanzando, aunque al final la última palabra la tendréis los que vayáis:

- Mejorar los textos de la Wiki y adaptarla al formato de otros grupos.
- Realizar nuevas pruebas de impresión y mejorar los perfiles de Slic3r.

El link del nuevo Doodle es: http://doodle.com/poll/72dbbxw5ssk2wzgq

Siotma, 2017-03-30:
El doodle se ha cerrado. La reunión tendrá lugar mañana viernes día 31 de marzo de 13:00 a 16:00 en la nave 1.0.B06.

Recuerdo que en caso de que lleguéis y esté cerrado, os asoméis por la barandilla del primer piso para comprobar si estamos dentro y avisarnos para que se os abra.

Será útil que traigáis vuestros portátiles, en la medida de lo posible.

Trabajaremos en la configuración de los parámetros de Repetier y Slic3r para obtener buenos resultados en las impresiones. También se trabajará en mejorar la información proporcionada por la página de la Wiki del grupo de trabajo: http://asrob.uc3m.es/index.php/Printer_One:_A_Clone_Wars_Story

Como siempre, todo el que quiera venir está invitado!

Los resultados se postearán aquí, y en el [Cuaderno de Bitácora](http://asrob.uc3m.es/index.php/Printer_One:_A_Clone_Wars_Story:_Cuaderno_de_Bitacora).

jorgercobo, 2017-03-31:
En la reunión de hoy, hemos trabajado en:

- En la wiki:
 Hemos puesto a Printer One y a G.A.M.E en portada como grupos activos
- En Hija de Resurreción:
1. Prueba de impresión con soportes generados por Slicer fallida.
    Cambio de configuración en Slicer: Interface layers: de 3 a 0.
2. Segunda prueba de impresión con soportes generados por Slicer. Soportes impresos correctamente, aunque debido a un fallo ha habido que pararla.
    **Problema**: Solo la última capa del soporte se hace maciza. Al imprimirse la primera capa apoyada, esta capa de soporte se suelta.
    **Ñapa/solución**: poner un punto de pegamento termofusible para que se imprima sobre este.
    **Solución fetén**: que las x últimas capas de soporte sean macizas para que no se suelten.
    **PENDIENTE DE IMPLEMENTACIÓN**

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

David-Estevez, 2017-03-31:
> Ñapa/solución: poner un punto de pegamento termofusible para que se imprima sobre este - @JorFru

Como habréis descubierto empíricamente, esa solución no funciona muy bien. Dado que estáis imprimiendo en ABS, hay un par de soluciones más eficaces y extendidas entre la comunidad:
1. Usar la famosa "pasta de acetona". Disolver un trozo de ABS en acetona (lo más pura posible) y aplicar, o bien a la base antes de imprimir, o bien a la pieza en la zona que se está despegando. Al secarse se funde con el ABS y se pega que da gusto.
2. Configurar el slicer para hacer la pieza con "Raft" o "Brim". "Raft" es una base extensa de ABS que cubre todo el inferior de la pieza y ayuda a que se pegue cuando la pieza tiene poca superficie de contacto (como vuestro pinguino de la imagen). "Brim" son perímetros extra en la primera capa, que aumentan la superficie de contacto y evitan el warping, ya que lo que warpea es el "Brim" y no la pieza.

Siotma, 2017-04-01:
Mis experiencias con ABS confirman que el Brim es una muy buena opción para mejorar la adhesión a la base de impresión.

He creado un Doodle para semana que viene.
Esta semana mi disponibilidad cambia y tengo algunas tardes libres, lo que hará que podamos realizar reuniones más extensas.

Como objetivos podemos tener los siguientes:

- Mejorar los textos de la Wiki y adaptarla al formato de otros grupos.
- Realizar nuevas pruebas de impresión y mejorar los perfiles de Slic3r. Probar la opción de Brim.
- Completar la instalación de Repetier en Linux y su integración con la sesión de invitado.

El link del nuevo Doodle es: http://doodle.com/poll/mhnrae4u2cgdpg42

Siotma, 2017-04-01:
Asimismo, puntualizo que al haber sustituido el enlace de la portada, la antigua página de impresoras se ha quedado huérfana (http://asrob.uc3m.es/index.php/Impresora-3D_Open_Source).

Además de utilizar la información que contiene para crear la nuestra, habría que enlazarla desde la sección antiguos proyectos...

Siotma, 2017-04-04:
El doodle se ha cerrado. La reunión tendrá lugar hoy martes 4 de abril de 13:00 a 19:00 en la nave 1.0.B06.

Puntualizar que no es necesario venir durante todo el horario, que cada uno se acerque según vaya pudiendo. Yo, por ejemplo, iré a las 14:00.

Recuerdo que en caso de que lleguéis y esté cerrado, os asoméis por la barandilla del primer piso para comprobar si estamos dentro y avisarnos para que se os abra.

Será útil que traigáis vuestros portátiles, en la medida de lo posible.

Trabajaremos en la configuración de los parámetros de Repetier y Slic3r para obtener buenos resultados en las impresiones. También se trabajará en mejorar la información proporcionada por la página de la Wiki del grupo de trabajo: http://asrob.uc3m.es/index.php/Printer_One:_A_Clone_Wars_Story
Además, intentaremos completar la instalación de Repetier en Linux y su integración con la sesión de invitado

Como siempre, todo el que quiera venir está invitado!

Los resultados se postearán aquí, y en el [Cuaderno de Bitácora](http://asrob.uc3m.es/index.php/Printer_One:_A_Clone_Wars_Story:_Cuaderno_de_Bitacora).

jorgercobo, 2017-04-05:
En la reunión de hoy (14:00 a 21:00 horas), hemos trabajado en:
- En Blacky:
1. Se ha avanzado en la configuración de su PC. #2
2. Se ha intentado imprimir un Hairy Lion: el tiempo de fileteado tardaba demasiado, así que hemos optado por no seguir. Posible tema de reunión: Modelos 3D y tiempo de fileteado.
3. Prueba de impresión satisfactoria: tornillo y tuerca moleteados.
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

- En Hija Resurrection: Mejora en el endstop del eje Z
1. Comprobamos que la escala de las piezas era la correcta imprimiendo las primeras capas de cada pieza y tomando medidas.
2. Hemos impreso las piezas para el montaje.
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

3. Se han desatornillado de los puntos necesarios: el motor izquierdo del eje Z y 2 puntos del motor del eje Y. Una de las uniones del primero estaba desgastada y sujeta por una vara de metrica tres. Se ha repuesto la tapa superior de este motor con un recambio de Andres, que muy amablemente nos ha cedido esa parte y un tornillo que era necesario. Tambien se ha soltado el primer motor para trabajar con él.
4. Hemos hecho que los tornillos necesarios para la regulación se ajustasen a la pieza: se escoje un tornillo de metrica superior al agujero y se calienta con el soldador y se atornilla --force. Se ha realizado tanto para la zapata como para el soporte superior.
5. Hemos colocado y atornillado las piezas y el motor.
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

6. Hemos recalibrado manualmente el eje Z y hemos impreso dos cubos de calibrado con resultado satisfactorio.

- Tambien hemos ayudado en la limpieza del armario de la asociación.

jorgercobo, 2017-04-17:
El doodle se ha cerrado. La reunión tendrá lugar el miercoles 19 de abril a partir de las 16:00 en la nave 1.0.B06.

Recuerdo que en caso de que lleguéis y esté cerrado, os asoméis por la barandilla del primer piso para comprobar si estamos dentro y avisarnos para que se os abra.

Será útil que traigáis vuestros portátiles, en la medida de lo posible.

Trabajaremos en la configuración de los parámetros de Repetier y Slic3r para obtener buenos resultados en las impresiones. También se trabajará en ajustar el movimiento y los finales de carrera de la cama para conseguir la máxima área de impresión e indicarle a la máquina lo que realmente mide el espejo para que no pueda imprimir fuera. Además, intentaremos completar la instalación de Repetier en Linux y su integración con la sesión de invitado

Como siempre, todo el que quiera venir está invitado!

Los resultados se postearán aquí, y en el [Cuaderno de Bitácora](http://asrob.uc3m.es/index.php/Printer_One:_A_Clone_Wars_Story:_Cuaderno_de_Bitacora).

Siotma, 2017-04-24:
En la última reunión (miércoles 19 de 17:00 a 21:00) trabajamos en lo siguiente:

En Blacky:

- Se ha querido imprimir una pierna de Zowi: el resultado ha sido erróneo dos veces:
1. La primera vez el ordenador cerró sesión por tiempo de inactividad y al recuperarla el proceso Repetier crasheó. Se han deshabilitado todos los temporizadores de inactividad en este PC para que esto no vuelva a ocurrir. Antes de fallar, además, esta impresión se estaba deformando por no usar Brim.
2. La segunda vez, la impresora perdió pasos (ver siguiente foto).

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

En Hija Resurrection:

- Se imprimió un Hairy Lion, con resultado satisfactorio salvo por una pérdida de pasos. en la mitad de la impresión (ver siguientes fotos)

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

Ambas pérdidas de pasos pueden relacionarse en mi opinión con una nula o insuficiente ventilación de la electrónica de la impresora (Pololus muy calientes pierden precisión).

He creado un Doodle para la presente semana.

Como objetivos podemos tener los siguientes:

- Poner y fijar ventiladores a la electrónica de ambas impresoras.
- Modificar los perfiles de Slic3r para que todos tengan Brim.
- Ajustar el movimiento y los finales de carrera de la cama para conseguir la máxima área de impresión. Indicarle a la máquina lo que realmente mide el espejo para que no pueda imprimir fuera.
- Investigar el error de thermal runaway y en caso necesario desactivarlo.

El link del nuevo Doodle es: http://doodle.com/poll/m9372rahkarexukr#table

Siotma, 2017-04-26:
El doodle se ha cerrado. La reunión tendrá lugar el viernes 28 de abril de 15:00 a 17:00 en la nave 1.0.B06.

Puntualizar que no es necesario venir durante todo el horario, que cada uno se acerque según vaya pudiendo. Si alguien va a llegar entre las 13:00 y las 15:00 que avise para que se le abra. Yo calculo que me quedaré hasta las 19.

Recuerdo que en caso de que lleguéis y esté cerrado, os asoméis por la barandilla del primer piso para comprobar si estamos dentro y avisarnos para que se os abra.

Será útil que traigáis vuestros portátiles, en la medida de lo posible.

Como objetivos podemos tener los siguientes:
- Poner y fijar ventiladores a la electrónica de ambas impresoras.
- Ajustar el movimiento y los finales de carrera de la cama para conseguir la máxima área de impresión. Indicarle a la máquina lo que realmente mide el espejo para que no pueda imprimir fuera.
- Investigar el error de thermal runaway y en caso necesario desactivarlo.

Como siempre, todo el que quiera venir está invitado!

Los resultados se postearán aquí, y en el [Cuaderno de Bitácora](http://asrob.uc3m.es/index.php/Printer_One:_A_Clone_Wars_Story:_Cuaderno_de_Bitacora).

Siotma, 2017-04-28:
En la reunión de hoy (de 15:00 a 19:00) trabajamos en lo siguiente:

En Blacky:

- Se han querido imprimir soportes para ventilador de electrónica:
1. Se ha impreso [este](https://www.thingiverse.com/thing:770533) modelo para usarlo con el ventilador de 80mm de Hija Resurrection, pero es un diseño para 60mm por lo que no servirá.
2. Luego se ha impreso [este otro](https://www.thingiverse.com/thing:704418/#files) que sí es para 80mm y tiene buena pinta. Pendiente ponerlo en la siguiente reunión.

En Hija Resurrection:

- Se ha modificado el Marlin:
1. Se ha aumentado la tolerancia de la detección de Thermal Runaway a 10 grados durante 60 segundos, por lo que ya no debería volver a saltar fuera de contexto.
2. Se han ajustado las dimensiones de impresión, perfeccionando también la posición de los finales de carrera. Actualmente puede imprimir en XY = 200x180mm. Se podría aumentar a 200x200 pero esto implicaría cambiar el carro del extrusor.

- Se han realizado dos pruebas de impresión:
1. Una cadeneta portacables. El resultado ha sido impresionante, si no fuera porque el ABS utilizado (bobina negra puesta recientemente en #13 ) parece plastilina. Las paredes finas se han deshecho y la pieza se ha roto por completo.
2. Un carro de eje X para @andrespy . Próximamente se actualizará el post con el resultado.

Asrobot ha creado un Doodle para la semana que viene: http://doodle.com/poll/svq5wypfp7bp2pb6#table

Como objetivos podemos tener los siguientes:

1. Terminar de imprimir las piezas de sujección y montar los ventiladores en la electrónica. Se proponen estas piezas:

        Blacky: Dos ventiladores de 40mm usando: http://www.thingiverse.com/thing:1052196

        Hija Resurrection: Un ventilador de 80mm que ya está conectado: https://www.thingiverse.com/thing:704418/#files

2. Replicar en Blacky lo hecho en Hija Resurrection para el Thermal Runaway y las dimensiones de impresión.

El link del nuevo Doodle es: http://doodle.com/poll/svq5wypfp7bp2pb6#table

Siotma, 2017-05-03:
En la reunión de hoy (de 17:00 a 19:00) trabajamos en lo siguiente:

En Blacky:

- Se han terminado de imprimir los soportes para ventilador de electrónica:

1. Se ha impreso [este](http://www.thingiverse.com/thing:1052196) que soporta dos ventiladores de 40mm y tiene buena pinta. Pendiente de colocar de momento.

- Se ha modificado el Marlin:
1. Se ha aumentado la tolerancia de la detección de Thermal Runaway a 10 grados durante 60 segundos, por lo que ya no debería volver a saltar fuera de contexto.
2. Se han ajustado las dimensiones de impresión, perfeccionando también la posición de los finales de carrera. Actualmente puede imprimir en XY = 188x158mm. Se podría aumentar a 200x200 pero esto implicaría cambiar el carro del extrusor y redistribuir la estructura de la impresora.

En Hija Resurrection:

- Se ha colocado el ventilador de la electrónica con las [piezas impresas el último día en versión 80x80mm](https://www.thingiverse.com/thing:704418/#files):

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

- Se ha aumentado la temperatura de impresión del ABS negro a 240º en vez de 220.
- Se ha realizado una prueba de impresión (pendiente de ver resultado) de una pieza diseñada por @andrespy para hacer concéntrico el rollo de filamento con el eje de sujección y facilitar el giro:

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

Siotma, 2017-05-04:
Asrobot ha creado un Doodle para la semana que viene: http://doodle.com/poll/vvu9witzzwbe4mre#table

Como objetivos podemos tener los siguientes:

1. Buscar el mejor lugar para soldar, soldar y colocar los ventiladores de la electrónica de Blacky.

2. Imprimir un final de carrera de Z  como [este ](http://www.thingiverse.com/thing:1776429) para Blacky. Igual que el que le pusimos a Hija Resurrection. Y colocarlo y calibrarlo.

3. Imprimir alguna pieza de Zowi: https://github.com/asrob-uc3m/zowi/issues/3

El link del nuevo Doodle es: http://doodle.com/poll/vvu9witzzwbe4mre#table

jgvictores, 2017-05-08:
¿Sería mucho pedir que entre los objetivos se fuese sumando el mejorar/actualizar los manuales? :smile:
- https://www.gitbook.com/book/asrob-uc3m/impresoras-user-manual-i3
- https://www.gitbook.com/book/asrob-uc3m/impresoras-maintenance-manual-i3

jorgercobo, 2017-05-09:
Como se nos van acumulando objetivos poco a poco, he creado un proyecto en este repositorio en el que organizar los objetivos: [Printer One: A Clone Wars Story](https://github.com/asrob-uc3m/impresoras-asrob/projects/1)

David-Estevez, 2017-05-09:
Mola!! Pro tip: puedes importar también directamente issues que ya estén creadas al tablón, y te muestra el estado (abierta o cerrada) de la issue, y te pone el link automáticamente :wink:

jorgercobo, 2017-05-09:
Muchas gracias, queda mucho mejor así

Siotma, 2017-05-09:
Me encanta :')
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

Thread 13 (2017-02-08):

Faltan filamentos

Siotma, 2017-02-08:
Esta Issue puede valer para informar de cuándo falta filamento en alguna impresora.

Siotma, 2017-02-08:
En este momento, no hay filamento ni en Blacky ni en Hija Resurrection.

David-Estevez, 2017-02-08:
Hay ABS amarillo, pero va a ser un infierno conseguir imprimir con eso, creo yo. Se debería comprar algo de PLA, que es muchísimo más sencillo de usar para newbies.

Siotma, 2017-02-10:
Estoy totalmente de acuerdo con David, mi experiencia con PLA supera de lejos al ABS.

En mi impresora propia utilizo PLA de bq, que creo tiene una excelente relación calidad precio, y mucha variedad de colores. Además lo imprimo a 160ºC, lo que reduce el consumo energético y el esfuerzo de la electrónica de potencia para alimentar el extrusor.

Propongo que se realice un pedido a bq con cargo a la asociación de una bobina para cada impresora.

Siotma, 2017-02-16:
A este respecto, debo decir que esta mañana hemos dotado de filamento a las dos impresoras:

- Blacky está utilizando el rollo de ABS amarillo de ASROB, con el soporte de madera, queda pendiente hacer pruebas para calibrar las temperaturas óptimas de impresión.
- HIJA RESURRECTION está utilizando un rollo de ABS verde que he donado a la asociación. Imprimir a 220ºC extrusor y 100ºC base.

Tenemos la intención de utilizar estos filamentos al menos de forma provisional hasta que ambas impresoras funcionen correctamente. Una vez logrado, procederemos a realizar un pedido de PLA previa consulta para que se autorice la compra.

Siotma, 2017-02-16:
Cierro hasta que vuelva a faltar filamento.

Siotma, 2017-04-22:
El filamento que doné a Hija Resurrection está en sus últimos metros. Cómo podemos conseguir más?

David-Estevez, 2017-04-22:
Asigno a Juan para que nos diga cómo proceder.

Por cierto, cuidado con las etiquetas de las issues, porque con un "NO FUNCIONA" se desactivan las impresoras en la web :wink:

jgvictores, 2017-04-22:
1. Entiendo que hablamos de rollo de ABS verde (mencionado para HIJA RESURRECTION arriba).
1. Serviría el de [la foto](https://cloud.githubusercontent.com/assets/4448588/24302566/64402598-10b3-11e7-8e00-5488756174ad.jpg) de https://github.com/asrob-uc3m/actas/issues/69?

Siotma, 2017-04-23:
¡¡Claro que serviría!!

Había olvidado que existía. El primero que acabe con el rollo actual que ponga ese.

Gracias Juan, qué velocidad para dar soluciones!

jgvictores, 2017-04-24:
Cerrar issue? 😄

JorFru, 2017-04-24:
Me nombro responsable de gastar hasta el último centímetro!
Y también de reponerlo. Esta tarde cae!

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

JorFru, 2017-04-24:
Prueba de que el filamento antiguo se ha gastado
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
Prueba de que el filamento nuevo se ha instalado.
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

Closed 2017-04-24.

Thread 14 (2017-02-08):

El bote de laca está vacío.

Siotma, 2017-02-08:
Pues eso. Si lo que tenemos en la nave es ABS, un bote de laca es primordial.

David-Estevez, 2017-02-08:
El rollo amarillo de la nave es ABS, comprobado al 100% por mi.

jgvictores, 2017-02-09:
Yo disponía de un bote pequeño de laca, pero le faltaba la pieza de salida (plástico blanco difusor). He donado este bote y le he puesto la pieza de salida del bote grande vacío. Ahí queda en la nave para su uso con las impresoras de ASROB.

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

Closed 2017-02-09.

Thread 15 (2017-02-17):

Uso externo de las impresoras

kleiren, 2017-02-17:
Buenas,
un compañero del departamento de materiales me pregunta si podría utilizar las impresoras de la asociación. Necesita una pieza para su tesis y la quiere imprimir en polipropileno, se traería el filamento él.
¿Sería posible?

Siotma, 2017-02-17:
Ahora mismo ninguna impresora es funcional, estamos intentando ponerlas en marcha pero estaban muy dejadas.
Si es algo urgente me temo que va a tener que buscar otra impresora, en caso de que pueda esperar, es posible que en una semana o 2 se pueda usar una de ellas.

Distinto es el tema de las condiciones de uso de nuestras impresoras que no estoy seguro de cuáles son.

jgvictores, 2017-02-17:
Cierro, migrando issue a actas para debate general: https://github.com/asrob-uc3m/actas/issues/61

Closed 2017-02-17.

Thread 16 (2017-02-24):

Formalización de grupo de trabajo activo

jgvictores, 2017-02-24:
Reuniones periódicas, documentación... ¡este grupo lo está haciendo muy bien!

Propongo que:
- [x] Se rellene [el formulario correspondiente](http://goo.gl/forms/movrqVPe6k).
- [x] Si el grupo cumple [los criterios de los Estatutos](https://asrob-uc3m.gitbooks.io/estatutos/content/definiciones.html#grupo-de-trabajo-activo), suba a tal categoría en [la wiki](http://asrob.uc3m.es/index.php/Main_Page).

Siotma, 2017-02-24:
Hola Juan!
Te agradezco la propuesta, actualmente es algo que valoramos. Lo comentaremos en la siguiente reunión.

David-Estevez, 2017-02-28:
Yo también os animo a que os constituyáis como grupo activo, tenéis mucho potencial y estáis haciendo las cosas realmente bien, realmente os merecéis todas las ventajas de ser un grupo activo.

De todas formas, y aunque no seáis grupo activo todavía, os he incluído en la portada de la wiki de ASROB junto a G.A.M.E para que tengáis la visibilidad que os merecéis: http://asrob.uc3m.es/index.php/Main_Page

(He puesto la fecha de la próxima reunión y la página antigua del grupo de impresoras, si no os mola podéis actualizarla :smile: )

Siotma, 2017-03-02:
Con retraso, te agradezco mucho el detalle David. De momento estamos documentando con Issues porque es más rápido y no tenemos mucho tiempo. Por ese mismo motivo, hoy no hemos podido comentar este tema. Próximamente tendréis más noticias nuestras.

Luciahonrubia, 2017-03-09:
En la reunión de hoy, hemos comentado la idea de formalizar un grupo de trabajo. Todos hemos estado de acuerdo; el responsable de impresoras será Jorge y el del grupo será Manuel.
Se espera buena cooperación entre nosotros y progreso en el grupo.

JorFru, 2017-03-09:
No estuve en la reunión pero apoyo la idea! MAGA

On Mar 9, 2017 15:23, "Luciahonrubia" <notifications@github.com> wrote:

En la reunión de hoy, hemos comentado la idea de formalizar un grupo de
trabajo. Todos hemos estado de acuerdo; el responsable de impresoras será
Jorge y el del grupo será Manuel.
Se espera buena cooperación entre nosotros y progreso en el grupo.

—
You are receiving this because you are subscribed to this thread.
Reply to this email directly, view it on GitHub
<https://github.com/asrob-uc3m/impresoras-asrob/issues/16#issuecomment-285364104>,
or mute the thread
<https://github.com/notifications/unsubscribe-auth/AKgbgNtsTJPa84Hc6VsqFScWLG9apQ9Oks5rkAtQgaJpZM4MLCph>
.

David-Estevez, 2017-03-09:
Genial!! :clap: :clap:  para finalizar el proceso, seguid los pasos que se explican en #68

Closed 2017-03-09.

Thread 17 (2017-03-03):

El bote de laca ha desaparecido

Siotma, 2017-03-03:
Esto es un serio problema, ya que es de los pocos recursos de la asociación que se dejan fuera del armario...

Hasta hoy no recuerdo que hubiera pasado nunca, pero ayer ya no estaba, y no lo encuentro en ningún armario.

David-Estevez, 2017-03-03:
El bote se lo dejé yo el otro día a los del departamento, que habían comprado laca que no era Nelly y la suya no pegaba nada... Pero se nos olvidó bajarla después de usarla :sweaty_smile:

Estoy gestionando si devolución.

Siotma, 2017-03-03:
Sin problema, David, lo importante es saber dónde está. Mi preocupación era que alguien la hubiera mangado pero ya veo que no :)

La laca ha sido devuelta, la he dejado junto a las impresoras.

Issue cerrada en tiempo récord.

Closed 2017-03-03.

Thread 18 (2017-03-16):

Logo para wiki y otras cosas

Rodriwp, 2017-03-16:
He estado jugueteando con gimp, y tengo dos propuesta de logo para la wiki ? Que os parecen ?

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

Hacemos un doodle para votar cual poner en la wiki de asrob? 1, 2 o ninguno ?

David-Estevez, 2017-03-16:
:open_mouth:  Molan!!

El segundo se lee un poco mal, ¿no? Yo probaría a cambiar el color de las letras de "printer one" o difuminar un poco el fondo a ver si se lee mejor :smile:

Siotma, 2017-03-16:
Creo que la primera está genial por ahora.

Contemplaría la posibilidad de hacer algo del estilo de la segunda pero creo que para eso deberíamos desanclar las impresoras y ponerlas con un fondo más uniforme. Se me ocurre imprimir alguna nave o soldado y ponerla también en forma decorativa.

David-Estevez, 2017-03-16:
Recordad subir los archivos fuente / vectorizados del logo molón a [recursos digitales](https://github.com/asrob-uc3m/recursos-digitales) para que se puedan usar en carteles, stickers y memorias cuando se necesite.

Siotma, 2017-04-01:
He añadido el logo a la página de la wiki.

http://asrob.uc3m.es/index.php/Printer_One:_A_Clone_Wars_Story

Siotma, 2017-04-15:
Me gusta mucho la idea del segundo logo, que también contenga las fotos de las impresoras, pero habría que hacerlo con un fondo uniforme que no despiste tanto.

Siotma, 2018-04-21:
Creo que el primer logo es perfecto tal y como está. Por el tiempo que lleva en uso, yo lo consideraría definitivo y en todo caso si se quiere cambiar abriría una nueva issue.

Lo he subido a https://github.com/asrob-uc3m/recursos-digitales/tree/develop/logos , pero creo que la he liado, porque lo de "develop" no me suena muy bien :sweat_smile:

@David-Estevez @jgvictores ayuda en esto último por favor! En el momento en que quede resuelto se podrá cerrar la issue.

David-Estevez, 2018-04-21:
Arreglado, siéntete libre de cerrar la issue :smile:

jgvictores, 2018-04-22:
> lo de "develop" no me suena muy bien

@Siotma Lo has hecho genial. Siguiendo [estas guías](https://github.com/roboticslab-uc3m/developer-manual/blob/22d4b931270712b12196f81bd32ec4233ce7c6ed/version-control.md) solemos seguir la metodología "gitflow" con un `develop` que luego va pasando a `master`.

En la misma guía, decimos que para respositorios que no son de código pueden ir con sólo `master`. Aprovechando que @David-Estevez hizo el merge de `develop` a `master`, hice el paso. En este repo, nos quedamos con `master` exclusivamente (aunque por supuesto, se pueden abrir branches para desarrollos específicos).

Thanks!

Closed 2018-04-21.

Thread 19 (2017-03-25):

Sensor autolevel

David-Estevez, 2017-03-25:
Ayer @Siotma me comentó que estábais interesados en ponerle un sensor capacitivo como el de la M-Prime (y muchas otras) a las impresoras para implementar un auto-nivelado.

He estado hablando con Diego Trapero, que fue el que me vendió la impresora, y que ha dicho que ya no le quedan en stock. Pero me ha dado el número de referencia del sensor: LJ12A3-4-Z/BY

Siotma, 2017-03-27:
Por lo que he leído, este modelo es de tipo inductivo:
- https://www.amazon.com/LJ12A3-4-Z-DC6-36V-Inductive-Proximity-Detection/dp/B01LWOS1VA
- http://www.marchantdice.com/worldofcnc/pdf/homeswitch_wiring.pdf
- http://www.ebay.es/itm/LJ12A3-4-Z-BY-Inductive-Proximity-Sensor-Detection-Switch-PNP-DC6-36V-/290671992278

Esto no tendría que ser un problema en sí mismo, ya que de dar buen resultado se puede comprar. He mirado capacitivos y creo que deben ser casi hermanos, aunque estos son más caros:
- http://www.ebay.es/itm/LJC18A3-H-Z-BX-1-10mm-Capacitance-Proximity-Sensor-Switch-NPN-NO-DC-6-36V-300mA-/142166146397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

Si finalmente nos decidimos por alguno, en 3DEspana tienen ambos tipos. Es una tienda que está aquí al lado y siempre da muy buena atención: www.3despana.com/74-sensores-autonivel

Tienen el Inductivo a 4€ y el capacitivo a 15€

David-Estevez, 2017-03-27:
Eso explicaría por qué la cama de la M-Prime es metálica... :sweat_smile:

Creo que con la configuración actual que tenemos el inductivo no funcionaría, pero la verdad es que me pierdo un poco con estos sensores.

Siotma, 2017-03-27:
Jajajajaja claro, con una cama metálica seguro que funciona a las mil maravillas. No obstante, el metal que llevan los espejos o las pistas de la propia cama caliente es posible que pudieran ser detectadas.

Yo creo que lo más sensato es hacer pruebas con algún sensor que pudiéramos pillar prestado y en función de los resultados programar la compra del que mejor nos venga.

Siotma, 2017-04-05:
De momento estamos mejorando los finales de carrera mecánicos que tenemos ( ver [este comentario](https://github.com/asrob-uc3m/impresoras-asrob/issues/12#issuecomment-291723846), con muy buenos resultados.
A futuro, cuando otras mejoras más urgentes estén completas, se acometerá la investigación de este tipo de sensores.

Siotma, 2017-04-15:
Dejo este enlace por aquí ya que parece una buena opción. Al ser mecánico nos olvidamos de los problemas derivados del material de la cama.

**http://www.3despana.com/sensores-autonivel/494-sensor-autonivel-3dtouch-bltouch-servo-switch.html**

David-Estevez, 2017-04-15:
Hombre, si queréis algo mecánico y más artesanal, hay servos de 9g en el armario, y finales de carrera. Y thingiverse tiene diseños de autolevel para ellos:
    - http://www.thingiverse.com/thing:330162
    - http://www.thingiverse.com/thing:1703665
Lo digo sobretodo por el valor didáctico de diseñar/montar tu propio sensor :wink:

daavm, 2018-03-08:
Estaría bien retomar esto como tarea para la próxima reunión. Si tenemos finales de carrera y 9g en el armario... Me lo pido!

Siotma, 2018-03-10:
Hay muchos servos pequeños en el armario, y finales de carrera seguro que también!

Todo tuyo :wink:

Siotma, 2018-04-29:
He encontrado dos modelos de sensor inductivo de un proveedor de confianza de eBay:

- [Uno](https://www.ebay.es/itm/M12-Sensor-Proximidad-Inductivo-PNP-DC-6-36V-LJ12A3-4-Z-BY-3D-Impresora-S0036-/201916693496)
- [Dos](https://www.ebay.es/itm/M18-Sensor-Proximidad-Inductivo-8mm-NPN-NO-DC-6-36V-LJ18A3-8-Z-BX-Arduino-S0042-/201993387311)

dmarcosm, 2018-05-06:
Estoy pensando que estos sensores funcionan por... detección del metal? distancia? Lo digo sobre todo por la tronxy, que la base es de acrílico

Siotma, 2018-05-06:
Los sensores inductivos como esos son sensibles a la presencia de otros metales.

La base de la tronXY es de plástico, pero debajo la cama tiene pistas de metal, y además creo recordar que estaba recubierta de una superficie lisa de aluminio. Yo apuesto por que sería perfectamente compatible.

David-Estevez, 2018-05-06:
También existen sensores capacitivos, que no requieren un material metálico para funcionar. Ejemplo: http://store.thingibox.com/es/electricidad/224-sensor_capacitivo.html

Siotma, 2018-05-11:
Recibí el paquete el miércoles, y el jueves llevé [el sensor](https://www.ebay.es/itm/M12-Sensor-Proximidad-Inductivo-PNP-DC-6-36V-LJ12A3-4-Z-BY-3D-Impresora-S0036-/201916693496) a la nave. Está disponible dentro de una caja en la balda de Printer One.

Siotma, 2018-10-11:
Teniendo en cuenta la antigüedad de la Issue, y teniendo en cuenta la [nueva política de issues](https://github.com/asrob-uc3m/impresoras-asrob/issues/89#issuecomment-422891053), doy la compra por finalizada. Para la instalación del sensor en las impresoras se deberá abrir una nueva.

Closed 2018-10-11.

Thread 20 (2017-04-08):

reajuste de pid de la cama caliente

andrespy, 2017-04-08:
La mejora de ponerle un material aislante térmico en la parte inferior de la impresora me parece muy buena idea para disminuir la disipación por la parte inferior y llegar a la temperatura "meta" más rápido.

Ayer imprimiendo, algunas piezas se despegaban y diría que es debido a que al no ser igual la disipacion por la parte superior de la impresora que por debajo el NTC mide una temperatura que ya no es comparable a la superior y por tanto propongo:

* aumentar la temperatura "meta", para ello estudiaría la temperatura superior con respecto de la inferior con un sensor aparte.

* cambiaría la temperatura en marlin para que no salte el error thermal runaway al imprimir

* volveria a correr el comando de gcode en el que la cama prueba su dinamica y saca unos valores de kp ki kd. http://reprap.org/wiki/PID_Tuning
Y los cargaría en el marlin

Siotma, 2017-04-15:
Lo que comentas de comprobar las temperaturas de superficie y bajo la cama caliente me parece muy interesante, se podría hacer con otro termistor.

Respecto al Thermal Runaway, si ha vuelto a saltar, se debería seguir ampliando la tolerancia sí.

Pero en cuanto al PID de la cama, me temo que es imposible puesto que va con relé y por ese motivo el PID está desactivado. Activar el PID de la cama convertiría la impresora en un timbre y el relé se estropearía rápidamente. Me temo que esta mejora no va a poder implementarse.

Las dos primeras, son grandes ideas para nuestras próximas reuniones. Muchas gracias Andrés! 👍

Siotma, 2017-05-28:
Esta issue se está volviendo un poco antigua. De las tres propuestas, dos ya se han resuelto:

- [x] Ya se amplió la tolerancia del thermal runaway en https://github.com/asrob-uc3m/impresoras-asrob/issues/12#issuecomment-298057269 y en https://github.com/asrob-uc3m/impresoras-asrob/issues/12#issuecomment-298969157

- [x] El PID de la cama caliente se encuentra desactivado y no se debe activar para evitar un rápido desgaste del relé.

- [ ] Faltaría hacer la prueba de temperatura de la cama caliente con un segundo termistor.

Yo tengo un termistor en casa con cables y todo que podría servir para esto. Voy a añadir la tarea al proyecto.
Añadido al proyecto.

Siotma, 2018-04-21:
Los problemas descritos en esta issue ya no se dan. Además, en caso de querer incrementar la temperatura superior de la cama, siempre se puede incrementar la temperatura objetivo. La misión del termistor no es, en mi opinión, tener exactitud en la medida, sino control.

Cerrado por antigüedad.

Closed 2018-04-21.

Thread 21 (2017-05-09):

Diseñar a medida e imprimir soportes de motores de Blacky

jorgercobo, 2017-05-09:
Una de las piezas que sujetan los motores de Blacky para evitar que vibren ha desaparecido. Creo que el diseño era de @Siotma

Siotma, 2017-05-09:
En efecto, el diseño inicial es mío, ya que yo diseñe [estas piezas](https://github.com/Siotma/developrints/tree/master/Soporte%20motor%20Z) para mi impresora.

Sin embargo, no ha desaparecido nada, puesto que únicamente se imprimió una pieza, no dos.

El motivo de que solo se imprimiera una es que por aquel entonces, Hija Resurrection tenía el problema de pasos por mm ( #4 ), y de hecho las medidas de la pieza que hay son erróneas, y la pieza es más grande de lo debido.

Por otra parte, para imprimir la pieza para Blacky, hay que escalarla en Z, ya que los motores están mucho más cerca de la mesa que en el caso de mi impresora.

Propongo como ejercicio, rediseñar la pieza en FreeCAD ahora que sabemos :P y hacerla a medida de Blacky.

jorgercobo, 2017-05-09:
Pues creo que está cambiada de sitio y al verla vibrar me he hecho un lio 😅

Siotma, 2017-05-18:
Hoy, he roto el único soporte que había, ya que ha demostrado ser demasiado grueso y desequilibrar a Blacky, actualizo la tarea a "Diseñar a medida e imprimir soportes de motores de Blacky".

Siotma, 2017-05-25:
Hoy hemos medido la distancia entre los motores y la mesa: 2mm aproximadamente, y he diseñado esta pieza: [Soporte motor Z Blacky.zip](https://github.com/asrob-uc3m/impresoras-asrob/files/1028841/Soporte.motor.Z.Blacky.zip)

Hemos impreso uno con Hija Resurrection (para que sea negro y haga juego con el resto de las piezas de Blacky):

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

Quedaría por imprimir otro idéntico. El archivo está en el ordenador de Hija Resurrection dentro de la carpeta Printer One, que está en el Escritorio:

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

Planeado para la siguiente sesión.

Siotma, 2017-06-07:
Hoy, se ha impreso la base que faltaba: https://github.com/asrob-uc3m/impresoras-asrob/issues/12#issuecomment-306869765

Closed 2017-06-07.

Thread 22 (2017-05-09):

Recalibrar Blacky y mejorar final de carrera

jorgercobo, 2017-05-09:
La cama caliente de Blacky está ligeramente desnivelada y es dificil recalibrarla ya que en la posición correcta los tornillos que la regulan:

- El delantero izquierdo necesita estar muy suelto por lo que la cama puede vibrar.
- El delantero derecho necesita estar muy apretado por lo que no deja libertad para ajustarlo.

Ademas el final de carrera cada día está más suelto y es necesario reposicionarlo en cada impresión.
Creo que es necesario aumentar la prioridad de mejorar el final de carrera del eje Z de Blacky y solucionar el tema de los tornillos.

Siotma, 2017-05-09:
Si mal no recuerdo, @andrespy ya imprimió las piezas para equiparar el final de carrera de Z de Blacky al de Hija Resurrection.

Como bien dices, primero final de carrera, y segundo nivelado de la impresora

Siotma, 2017-05-10:
Hoy he montado las piezas que imprimió @andrespy para el final de carrera, sin embargo, presentan dificultades que han impedido dejarlo funcionando.

Ahora mismo Blacky está sin rollo de filamento por seguridad (está en el armario). En la próxima reunión lo vemos más detenidamente.

Siotma, 2017-05-18:
En la reunión exprés de hoy (18:00 - 19:30), @andrespy y yo hemos terminado de colocar el final de carrera y nivelado correctamente la impresora. Ver https://github.com/asrob-uc3m/impresoras-asrob/issues/12#issuecomment-302496980

Closed 2017-05-18.

Thread 23 (2017-05-18):

Thermal runaway

pamarinp, 2017-05-18:
Mientras imprimia 4 ruedas del protobot se ha detenido la impresión a los 20 minutos aproximadamente en la segunda da capa. El fallo es debido a una caída de temperatura por parte del termistor del extrusor.
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

He intentado continuar la impresión sin éxito puesto que el programa se queda en calentando la impresión y no responder de ni a control manual de los motores.

Siotma, 2017-05-18:
Es un fallo que ha sido recurrente últimamente, ya que detecta variaciones grandes en las temperaturas y realiza una parada de emergencia para evitar que la impresora se autodestruya.

Aunque las últimas veces se había activado la protección de forma demasiado rigurosa ( #20 , https://github.com/asrob-uc3m/impresoras-asrob/issues/12#issuecomment-298057269 , https://github.com/asrob-uc3m/impresoras-asrob/issues/12#issuecomment-298969157 ); en este caso yo creo que se ha activado correctamente, a la vista de la gráfica de temperatura 🎉

Sospecho que el Kapton que sujeta el termistor del extrusor está cada vez más deteriorado y el termistor está empezando a moverse durante la impresión.

Recomiendo que se cambie el Kapton del extrusor por un trozo nuevo.

Gracias por la documentación @pamarinp , nos ponemos con ello!

Siotma, 2017-05-25:
Hoy hemos repuesto el Kapton en Hija Resurrection. He traído un poco del mío mientras se adquiere el de la asociación ( https://github.com/asrob-uc3m/actas/issues/62 ).

Ha quedado muy bien, afianza el termistor firmemente y sobre todo ¡¡No se chamusca!! XD

Adjunto imagen que muestra el estado en que se encontraba el extrusor:
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

Y ahora:
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

La impresora ha estado imprimiendo dos horas seguidas sin errores, por lo que damos por validado el arreglo:

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

Closed 2017-05-25.

Thread 24 (2017-05-25):

Soldar y colocar los ventiladores de la electrónica de Blacky

Siotma, 2017-05-25:
La posición más óptima parece ser crimpado directamente a los cables de la fuente de alimentación correspondientes al conector de 5A ( [ver imagen](http://www.reprap.org/wiki/File:Arduinomega1-4connectors.png) )

Siotma, 2017-10-13:
Dado que se cambió la fuente de alimentación ( #28 ), ahora debería ser mucho más fácil añadir los ventiladores utilizando una nueva línea de 12V y conectores apropiados.

GioSunrider, 2017-10-30:
Se han soldado y colocado los ventiladores a la electrónica.  Se han soldado a la fuente en paralelo en un extremo de un canal de 12V. Adjunto fotos de la colocación.
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

Siotma, 2017-10-30:
¿Qué ha pasado en esta Issue? Aparece un tal @ghost 😕  y se ha perdido el comentario de @GioSunrider...

Jorge, has eliminado tu usuario?

No entiendo nada...

Siotma, 2017-10-30:
Ya me aparece todo bien. Habrá sido un fallo de GitHub.

Lo has hecho fantástico: Asignar, cerrar y mover la ficha a Done.

GioSunrider, 2017-10-30:
Gracias 😊😊

Thread 26 (2017-05-31):

Thermal Runaway 2 en Hija Resurrection y problema de fijación de espejo en Blacky

pamarinp, 2017-05-31:
Incluso con el nuevo kapton y lo bien fijo que está el termistor, al imprimir dos ruedas del protobot, ha saltado el mensaje de thermal runaway de nuevo. Siento no haber hecho más fotos. Cerré el programa y lo volví a abrir rápido para aprovechar y poner sólo una rueda y funcionó bien.
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

Fijáos bien siempre antes de imprimir que el espejo de la plataforma esté fijo si no os va a pasar como a mi
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

Siotma, 2017-06-04:
Gracias por dejar constancia de este problema.

Dado que la captura del error de Thermal Runaway está hecha en Windows, deduzco que has intercambiado los nombres de las impresoras en el título de la issue:
- Hija Resurrection imprime en negro y usa windows xp.
- Blacky imprime en amarillo y usa lubuntu.

Tras un Thermal Runaway lo más importante es **registrar la curva de temperatura** para poder saber si se trata de un error de interpretación del software o si por el contrario el software ha actuado bien protegiendo a la impresora de un mal funcionamiento de algún componente.

Tengo entendido que en las últimas impresiones que habéis realizado no ha vuelto a aparecer este mensaje por lo que no hay razones para pensar que la impresora no funcione.

Propongo dejar esta issue abierta durante una semana más, y en caso de que se vuelva a producir un error, os ruego que capturéis la forma de la curva de temperatura.

Respecto al problema con la fijación del espejo, sin duda es para tenerlo en cuenta y que no nos pase 🤣

Siotma, 2017-06-24:
Ayer durante el taller de Zowimanoides me fue imposible imprimir piezas con Hija Resurrection por el problema de Thermal Runaway. Olvidé hacer fotos, pero describo lo que observé:

- El extrusor y la cama caliente son capaces de alcanza correctamente las temperaturas consignadas y las mantienen.

- Al comenzar a imprimir, y por tanto, a moverse la impresora, la curva de temperatura del extrusor fluctúa significativamente, lo que hace saltar el error.

- Hice una prueba extensiva, manteniendo la impresora caliente más de media hora, pero sin imprimir, y mantuvo las temperaturas correctamente.

Urge, por tanto, revisar la impresora para identificar el problema.

jgvictores, 2017-09-21:
@Siotma ¿Crees que esto se merece un "label: NO FUNCIONA"? ¿Quizás deberíamos añadir una etiqueta de valor intermedio estilo WARNING?

Siotma, 2017-09-22:
Gracias por retomar el hilo, @jgvictores .

En absoluto. Una etiqueta WARNING no tiene sentido, ya que en última instancia significaría lo mismo que la etiqueta NO FUNCIONA, es decir, que la impresora no puede ser utilizada por el público. Olvidé por completo colocar la etiqueta antes de irnos de vacaciones pero ya mismo lo hago.

Recalcar que en la [última reunión de Printer One](http://asrob.uc3m.es/index.php/Printer_One:_A_Clone_Wars_Story:_Cuaderno_de_Bitacora#15_de_septiembre_de_2017) tratamos de imprimir dos piezas con resultado erróneo, por tanto, procede colocar la etiqueta "No funciona"

Siotma, 2017-09-28:
Hoy se han hecho nuevas pruebas en Hija Resurrection.

Se ha descubierto una posible causa del problema del Thermal Runaway, y es que la fuente de alimentación de Hija Resurrection únicamente tiene 17A en el canal de 12V. Este amperaje es muy reducido para alimentar cama caliente y extrusor, que llegan a demandar corrientes cercanas a los 30A.

Ello se puede comprobar en la siguiente imagen, en la que se ve cómo el sistema es incapaz de mantener el extrusor caliente mientras se calienta la cama; tardando todo ello mucho tiempo.

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
Además, se ha comprobado que la impresora no es capaz de alcanzar 240 grados en el extrusor, siendo únicamente posible alcanzar 210, de lo que se deduce también falta de potencia.
Teniendo esto en cuenta, se ha analizado el comportamiento de las temperaturas en cama caliente y extrusor y se ha detectado que en los intervalos de tiempo en los que el relé está activo, la temperatura del extrusor cae, y únicamente se recupera en los intervalos del relé apagado. Ello se observa bien en la siguiente imagen.
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

Así pues proponemos como solución al Thermal Runaway cambiar la fuente de alimentación por otra idéntica a la utilizada en #28 , que ha demostrado tener potencia suficiente para calentar Blacky sin problemas.

Siotma, 2017-11-13:
Hoy se ha colocado una nueva fuente de alimentación en Hija Resurrection ( ver https://github.com/asrob-uc3m/impresoras-asrob/issues/35#issuecomment-344007565 ).

Se ha modificado la configuración de Marlin vía 83d843e02ac85237739cad3ec4fa42780e4ceed3 para aumentar la frecuencia de refresco de la temperatura de la cama.

Se han realizado dos pruebas de impresión, la primera de un cubo, satisfactoria:

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

La segunda prueba de impresión de una pieza de calibración, ha sido insatisfactoria por desplazamiento del eje Y:

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

Sin embargo, en ninguna de las dos ocasiones ha saltado el error de Thermal Runaway, y a la luz de las curvas de temperatura parece que también se ha corregido la falta de potencia:

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

Siotma, 2017-11-13:
Dada la antigüedad de esta Issue, queda sustituida por #35

Closed 2017-11-13.

Thread 27 (2017-06-07):

Error de envío de datos por puerto USB

pamarinp, 2017-06-07:
Esta vez ha sido un error de conexión. A mitad de la impresión ha saltado el siguiente error.
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

Siotma, 2017-06-24:
Los errores de conexión son mucho más comunes al imprimir desde el PC. Imprimiendo desde tarjeta SD se suelen minimizar.

También creo que sería interesante actualizar la versión de Repetier a la última versión ya que creo que tienen mejoras para evitar estos errores.

David-Estevez, 2017-06-26:
En el caso de mi impresora de casa, los errores de conexión se resolvieron al usar cables USB con ferrita. No me he fijado en si los cables de las impresoras de la nave tienen o no ferrita, pero si no la tienen debería mejorar la conexión al cambiarlos.

Siotma, 2017-09-22:
Este error se volvió a manifestar en la [última reunión de Printer One](http://asrob.uc3m.es/index.php/Printer_One:_A_Clone_Wars_Story:_Cuaderno_de_Bitacora#15_de_septiembre_de_2017). Por tanto, urge repararlo.

Siotma, 2017-10-24:
La actualización en el software del ordenador de Hija Resurrection ( #3 ) debería haber solucionado este problema.

Closed 2017-10-24.

Thread 28 (2017-09-15):

La fuente de Blacky ha muerto

Siotma, 2017-09-15:
La fuente de alimentación de PC que estaba instalada en Blacky, ha dejado de funcionar.

Hemos intentado imprimir con la impresora, pero la fuente no se encendía.

Hemos identificado que la fuente estaba rota y la hemos tirado a la basura.

Recomendamos, cambiar la fuente por una nueva del armario.

Siotma, 2017-09-16:
Aprovechando el cambio de la fuente de alimentación, sería bueno mejorar el uso de los cables, en la línea de lo que comenzó a hacer @Morgloz ayer.

En la fuente antigua únicamente se habían dejado dos canales de 12V que llegaban directamente a la RAMPS. Sin embargo, las necesidades de 12V de la impresora también pasan por la conexión de ventiladores y el relé de la cama caliente. Por ello, se había recurrido a puentear las conexiones, soldando varios cables en paralelo bajo el conector. Este tipo de instalaciones dificultan el mantenimiento de la impresora.

De esta forma, sería bueno aprovechar los múltiples cables de 12V de la nueva fuente para que cada uno de servicio a un sistema concreto de la impresora. Además, sería muy positivo utilizar conectores para facilitar la desconexión o sustitución de algún componente en caso de mantenimiento.

Asimismo, recuerdo la intención de poner ventiladores a la electrónica de Blacky #24 , por lo que recomiendo que esto se tenga en cuenta a la hora de dejar un canal de 12V libre y accesible para este fin.

Siotma, 2017-09-28:
Se ha colocado una nueva fuente de alimentación en Blacky.

No se ha utilizado la fuente que comenzó a modificar @Morgloz, ya que aquella tenía poca potencia en el canal de 12V, solamente 21A. La fuente finalmente utilizada estaba en el armario y tiene dos canales de 12V de 18A cada uno, lo que hacen un total de 36A, por lo que tiene potencia suficiente para calentar cama y extrusor rápidamente. Por comparar con la fuente anterior, tenía únicamente 20A en el canal de 12V.

La única pega es que la fuente nueva tarda en encenderse desde que se activa el interruptor, y por eso puede parecer que algo está mal conectado. Únicamente se debe tener paciencia y esperar unos segundos.

La siguiente imagen muestra la curva de temperatura de un calentamiento simultáneo de cama y extrusor, y se puede comprobar la gran velocidad a la que se produce.
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

Finalmente, se ha impreso satisfactoriamente un cubo de calibración, que se muestra a continuación.
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

Siotma, 2017-09-28:
Créditos a @JorFru por coordinar el proceso de soldado y realizar el cable management. Creo que te has ganado cerrar esta issue.

JorFru, 2017-09-28:
Blacky ya funciona!

Siotma, 2017-11-29:
Finalmente, Blacky ha vuelto a un funcionamiento fiable con una fuente de alimentación distinta a la documentada en esta issue (ver problemas y resolución en #33 )

Closed 2017-09-28.

Thread 29 (2017-09-21):

Actualizar lista de operadores

jgvictores, 2017-09-21:
La [lista de operadores](http://asrob.uc3m.es/index.php/Operadores) no parece muy actualizada. Deberíamos de actualizarla. :-)

davidvelascogarcia, 2017-10-07:
@jgvictores
Perfecto, por mí parte podría encargarme de ello si no hay nadie disponible.
Comentándolo con @Siotma lo único que necesitaría sería una cuenta para poder editar, el listado de nuevas incorporaciones y creo que nada más dado que @Siotma , me ha facilitado un documento con el lenguaje para editarlo.

jgvictores, 2017-10-08:
@davidvelascogarcia Te he creado una cuenta wiki con el mismo nombre de usuario que el de github, te llegará un email con contraseña aleatoria a cambiar al email que tengo asociado a tí.

davidvelascogarcia, 2017-10-08:
@jgvictores Perfecto, muchas gracias. He seguido el proceso de configuración, me he estado adaptando al entorno de la wiki y al lenguaje de edición. He empezado a actualizar la lista de operadores, de momento solo me he incluido porque no tengo los datos del resto de las nuevas incorporaciones a la lista. No obstante, ya se manejarme un poco con la edición, así que podría incorporar todos los demás datos en cuanto consiga el listado.
Por lo demás, si se requiere alguna modificación adicional a parte de actualizar el listado, podría encargarme de ello.
Un saludo.

Siotma, 2017-10-13:
Hoy, me he tomado la libertad de auto-añadirme a la lista.

jgvictores, 2017-10-13:
Gracias @davidvelascogarcia @Siotma !!

Creo que la lista aun así no está actualizada del todo. Ideas:
1. Orden: ((Invertir la lista daría más visibilidad a los más nuevos y por tanto mayor posibilidad de seguir activos... peero debemos fiarnos de que se siga esta práctica, que editando la wiki es un lío de cuidado, es mucho más fácil anexar al final)). Mi propuesta es ordenar un operario por fila, y se pueden poner más datos, como fecha de hacerse operario, operarios formados, y por último definir la tabla como class="wikitable sortable", véase https://www.mediawiki.org/wiki/Help:Sorting#Sorting_rows_of_a_table
1. Limpieza: Enviar emails a los operarios preguntando si quieren seguir. Puede ser largo y tedioso, creo que con implementar el punto anterior bastaría.

¿Cómo lo veis?

David-Estevez, 2017-10-13:
> Limpieza: Enviar emails a los operarios preguntando si quieren seguir. Puede ser largo y tedioso, creo que con implementar el punto anterior bastaría.

Existe una lista de [antiguos miembros](http://asrob.uc3m.es/index.php/Antiguos_Miembros) en la que encontrar a gente que estuvo en la asociación y ya no está. Se puede usar como punto de partida para quitar a esa gente de la lista de operadores y evitar mandar tanto email.

davidvelascogarcia, 2017-10-13:
@jgvictores  @Siotma  @David-Estevez

Por mi parte, estoy de acuerdo con las propuestas, me parece muy interesante añadir datos como el número de operarios formados o la fecha de fin de formación. Al situarlo por filas, puede parecer más organizado, lo único siendo tantos puede extenderse mucho la longitud en la web, a lo mejor de dos en dos.
He preparado un boceto, para ver que os parece algo del estilo.

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

Figura 1. Boceto lista de operadores

Respecto al orden, e invertirlo, puede ser buena idea, pero quizá, no solo situar por novedad, sino por disponibilidad y actividad, me refiero:
En el momento que un nuevo interesado, quiera formarse como operador, bien por tener acceso a las impresoras, para proyectos o derivados, o que quiera formar posteriormente a nuevas incorporaciones, se desplazará a la web y por comodidad salvo que conozca a alguno de los operadores previamente, es posible que se decante por las primeras líneas.
Dado que hay antiguos miembros en la lista, quizá el orden en sentido descendente pueda ser de mayor a menor nivel de actividad y disponibilidad, para reducir los tiempos.
En el punto de limpieza, podría usarse la lista de antiguos miembros y preguntar si siguen interesados y si retomaran el papel de operador y si están interesados en formar...

Siotma, 2017-10-13:
El formato de la tabla que propones me parece muy bueno. Tal vez se puede añadir un nuevo campo que contenga la última actividad del operador, y que ese sea el criterio de ordenación descendente. En caso de que el operador se encuentre inactivo durante mucho tiempo, este mismo parámetro puede servir para sacarlo de la lista y que ésta se auto-mantenga fácilmente. La disponibilidad siempre es un poco relativa, y creo que es mejor que cada persona interesada la consulte en el momento del contacto.

jgvictores, 2017-10-13:
Si veis el tipo de tabla que propongo (en el móvil sólo me funciona en modo PC), está guai porque lo puedes reordenar según el criterio que quieras. Pero claro, sería un operario por fila. https://www.mediawiki.org/wiki/Help:Sorting#Sorting_rows_of_a_table

Siotma, 2017-10-14:
Me gusta mucho ese tipo de tabla. Sería muy interesante probar qué se puede hacer con él.

davidvelascogarcia, 2017-10-18:
@jgvictores @Siotma @David-Estevez

He estado mirando el formato de tabla propuesta por @jgvictores , y he preparado un pequeño boceto y un poco el código, basado en la propuesta para ver que os parece como punto de partida. Tiene usuario por linea.

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
Figura 1. Boceto operadores

Aproximadamente, el código podría ser como el siguiente:

`{| class="wikitable sortable"
|-
! style="background-color:navajowhite" | Foto!! style="background-color:navajowhite" | Nombre!! style="background-color:navajowhite" | Apellidos!! style="background-color:navajowhite" | Correo!! style="background-color:navajowhite" | Sitio web!! style="background-color:navajowhite" | Fecha de formación!! style="background-color:navajowhite" | Nº de operadores formados
|-
| 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 || Nombre1 || Apellido1 Apellido2 || Correo1 || [http://example.com] || 18/10/2017|| 1
|-
| 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 || Nombre2 || Apellido12 Apellido22 || Correo2 || [http://example.com]|| 18/10/2017 || 6
|-
| 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 || Nombre3 || Apellido13 Apellido23 || Correo3 || [http://example.com]|| 18/10/2017 || 7
|-
| 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 || Nombre4 || Apellido14 Apellido24 || Correo4 || [http://example.com]|| 18/10/2017 || 15
...
|}`

jgvictores, 2017-10-18:
@davidvelascogarcia Buena pinta!
PD: Te edité el markdown en tu comentario, de comilla simple a triple, que es el que sirve para múltiples líneas.

davidvelascogarcia, 2017-10-18:
@jgvictores
Perfecto, muchas gracias.
Lo estoy mirando en previsualización, sin tocar el código original, pero de todos modos he hecho un backup de todo el código por si acaso.

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

Figura 1. Tabla en previsualización

Voy a finalizar el código con los datos de todos los operadores para dejarlo listo con este formato, que en 15 minutos aproximadamente esta terminado, y subo por este hilo una previsualización de como sería.
Me quedo a la espera de vuestra respuesta, para ver si lo termino de subir, o dejo el formato actual y debajo el nuevo...

jgvictores, 2017-10-18:
Muy buena pinta. Dale sin miedo, en wiki queda el histórico y es fácil de revertir (rollback) en caso de hacer algo mal.

davidvelascogarcia, 2017-10-18:
@jgvictores
Perfecto, muchas gracias. Voy a extenderlo a todos los operadores.
He estado haciendo pruebas y funciona todo bien, correos y sitios web incluídos.

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

Figura 1. Prueba de tablas

davidvelascogarcia, 2017-10-18:
@jgvictores @Siotma  @David-Estevez

He terminado con las actualizaciones de la web de operadores. Añado una foto y adjunto el link, para ver que os parece. He estado haciendo pruebas y en principio funciona todo correctamente, si encontráis algo extraño se cambia en un momento.

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

Figura 1. Web de operadores

Link:
http://ieee.uc3m.es/index.php/Operadores#Operadores_Autorizados

Lo único que haría falta ahora serían las fechas de formación y número de formados, aunque fuera orientativo.

jgvictores, 2017-10-18:
Está genial!
Como única mejora, bajar los honoríficos al final, que confunde un poco.

davidvelascogarcia, 2017-10-18:
Muchas gracias.
Listo, ya esta actualizado.

davidvelascogarcia, 2017-10-18:
@jgvictores Por cierto, he hecho un par de backups del antes y el después por seguridad, no vaya a ser que haya algo mal, aunque se puede revertir. Son 14.7 KB, como ocupa nada, esta en un txt, lo he subido en una carpeta a Sourceforge y en otra en Impresoras en Github.
Espero que no os importe, sino lo borro.

Siotma, 2017-10-19:
Me encanta el resultado!! Sin embargo, creo que sigue siendo necesario una limpieza de esta lista, ya que aunque todos los operadores que figuran en ella supieron, en algún momento, utilizar las impresoras, creo que es importante resaltar el detalle de que las impresoras disponibles actualmente, así como los softwares que las controlan han cambiado desde que ellos se formaron.

Tal vez podamos implantar algún modelo de "reválida" aprovechando la casilla "Fecha de formación", de manera que ningún operador pueda tener una antigüedad superior a un año, por ejemplo. Para renovar el rango, podemos plantear una pequeña prueba bajo la supervisión de algún otro operador con rango en vigor, de que efectivamente sabe manejar las impresoras. De esta forma, en caso de haberse producido cambios en el manejo, el operador puede ponerse al día con la ayuda del otro. Tras pasar la prueba, la fecha de formación se actualizaría.

Este es solo un ejemplo, pero creo que podría servir. Siempre pienso que este tipo de cosas que se hacen una vez pero según pasa el tiempo se quedan obsoletas necesitan un método de automantenimiento definido, de forma que los que vengan después puedan mantenerlas actualizadas para que sigan cumpliendo su función.

En caso de aprobarse algo así, debería reflejarse en los [Estatutos de la Asociación](https://asrob-uc3m.gitbooks.io/estatutos/content/definiciones.html) y notificarse a todos los operadores de la lista.

Qué os parece.

David-Estevez, 2017-10-19:
Por lo que veo, de toda esa lista en activo sólo hay 4 personas, las demás dejaron la Asociación/Universidad/no han impreso nunca con nuestras impresoras. Esto se puede comprobar mirando la lista de [antiguos miembros](http://asrob.uc3m.es/index.php/Antiguos_Miembros) y comparando nombres y correos.

Respecto a lo que propone @Siotma, me parece bien que "caduque" el título de operador, pero no por fecha de formación, sino por fecha de última impresión. No tiene mucho sentido que alguien que se formó hace un año pero ha impreso de forma asídua y sabe como funcionan las impresoras pierda el título de operador porque sí que sabe hacer uso de ellas.

PD: kudos a @davidvelascogarcia por el curro de la nueva tabla

davidvelascogarcia, 2017-10-19:
@Siotma @David-Estevez

Muchas gracias, me alegro de que os guste.

Coincido con los dos,  podría aprovecharse las casillas de formación.
Respecto a la limpieza estoy de acuerdo. Lo siento, no tenía conocimiento de que la gran mayoría ya no se encuentran en la universidad y por lo tanto no están disponibles para realizar formaciones ni tener constancia de las actualizaciones del software, método de uso...
Podrían pasarse a una nueva pestaña como antiguos operadores, sería muy simple y el código el mismo. Y así dejar la web de operadores para activos.
Sugiero la web de antiguos operadores que sin problema podría encargarme yo, suponiendo que posiblemente algunos operadores en su momento fueron muy activos y formaron a muchos miembros y aportaron a la asociación, por otorgarles un reconocimiento.
Me podría poner en contacto con ellos para preguntarles por el número de miembros que han formado y fechas orientativas.
¿Qué os parece?.

Siotma, 2017-10-19:
> me parece bien que "caduque" el título de operador, pero no por fecha de formación, sino por fecha de última impresión.

La idea, es que la renovación del título de operador la realice un tercero, de manera que haya más control. Controlar el momento en que una persona realizó su primera impresión es difícil. Si hay un supervisor que "da fé" puede ser más fácil.

> Podrían pasarse a una nueva pestaña como antiguos operadores, sería muy simple y el código el mismo. Y así dejar la web de operadores para activos.

A favor de una página de antiguos operadores, y que se trate de dar crédito a cada uno de ellos por sus contribuciones.

Como aportación propia, y aprovechando que ya se ha hablado de migrar la página de operadores a la [Web](http://asrob-uc3m.github.io/), quiero compartir una idea que se me ha ocurrido: A lo mejor es deformación, pero creo que las Issues serían un sistema ideal para gestionar la formación y renovación de operadores. Todos los interesados podrían abrir una issue para solicitar formación, los operadores disponibles se podrían poner en contacto para concertar la sesiones y se podrían subir fotos de las impresiones realizadas durante el proceso. Por eso, si finalmente se hiciera una página de operadores en la [Web](http://asrob-uc3m.github.io/), propongo que se haga al estilo de la [página de impresoras](http://asrob.uc3m.es/printers/), de manera que haya un repo dedicado donde se encuentre el código de la página así como las issues que gestionen la formación de los operadores.

David-Estevez, 2017-10-19:
Entendido, en ese sentido estoy totalmente de acuerdo con tu idea.

La [página de impresoras](http://asrob.uc3m.es/printers/), como tú dices, podría ampliarse para mostrar información sobre los operadores  y tomar esa información de un repositorio. Ahora mismo estoy a tope con subvenciones y memorias, pero cuando pase la tempestad se puede mirar cómo implementar esa mejora. Es más, si tú tienes ya alguna idea de cómo sería, lo puedes proponer en ese repo mediante [una issue](https://github.com/asrob-uc3m/printers-status-webpage/issues).

davidvelascogarcia, 2017-10-19:
Durante la tarde, he estado preparando la página de Antiguos Operadores, basándome en la propuesta de @David-Estevez  de la lista de antiguos miembros.
Link: [http://ieee.uc3m.es/index.php/Antiguos_Miembros](url)

Todos los operadores incluidos en Antiguos Miembros, han sido trasladados a la página Antiguos Operadores.
Link: [http://asrob.uc3m.es/index.php/Antiguos_Operadores](url)

Ahora están separados en dos web.
Operadores, para los no incluidos en antiguos miembros.
Link: [http://ieee.uc3m.es/index.php/Operadores](url)

¿Qué os parece?¿se os ocurre alguna mejora hasta incorporar el código y las issues?

davidvelascogarcia, 2017-10-20:
Acabo de añadir un enlace en cada una las páginas para poder acceder de una a otra sin problema.
Gracias por la revisión @Siotma .

Siotma, 2017-11-29:
La [nueva página de operadores](http://asrob.uc3m.es/printers/operators.html) está activa y funcionando.

En este momento, nos enfrentamos a un proceso de transición en el que se abren distintas tareas:

- [ ] Hacemos el cambio ya o damos un tiempo de latencia para detectar bugs?
- [ ] Si se decide hacer la transición, habría que indicar con una nota en la antigua página que ya no se actualizará más, y poner un link a la nueva.
- [ ] Si se decide hacer la transición, habría que establecer una fecha límite para que los operadores que figuran en la actual lista migren automáticamente a la nueva al estilo de https://github.com/asrob-uc3m/operadores/issues/4
- [ ] Asimismo, habría que establecer la duración máxima del título de operador entre renovaciones.
- [ ] Por último, habría que detallar, el procedimiento de formación, tanto para el nuevo operador como para el formador, e indicarlo claramente en la web y en el repo de https://github.com/asrob-uc3m/operadores/

Pregunta: ¿migramos esta discusión a https://github.com/asrob-uc3m/operadores/ ?

jgvictores, 2017-11-29:
> Pregunta: ¿migramos esta discusión a https://github.com/asrob-uc3m/operadores/ ?

Sin duda! https://github-issue-mover.appspot.com/ funciona muy bien!

jgvictores, 2017-11-29:
PD: Soy muy dado a hacer la transición, para forzar a ponernos en modo beta-testers. :-)

Siotma, 2017-11-29:
> Sin duda! https://github-issue-mover.appspot.com/ funciona muy bien!

No me refería tanto a migrar totalmente la issue, sino a cerrar esta dándola por finalizada y abrir otra en https://github.com/asrob-uc3m/operadores/ para aclarar los puntos de https://github.com/asrob-uc3m/impresoras-asrob/issues/29#issuecomment-347841784

Siotma, 2017-11-29:
Discusión migrada a: https://github.com/asrob-uc3m/operadores/issues/14

 Creo que @davidvelascogarcia tiene el derecho más que ganado de cerrar esta issue.

davidvelascogarcia, 2017-11-29:
@Siotma muchas gracias. Dado que se ha migrado y estamos de acuerdo, cierro la issue.

Closed 2017-11-29.

Thread 30 (2017-09-30):

Propuesta: Préstamo de uso de Dédalo

David-Estevez, 2017-09-30:
Actualmente tengo una Prusa i2 ([clon 28, Dédalo](http://reprap.org/wiki/Clone_Wars:_El_imperio_de_los_clones/es#Jedis)) cogiendo polvo en casa porque desde que me compré una [m-prime](http://mprime.io/) ya no la uso.

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

Usa plástico de 3mm y necesita un buen calibrado, pero por lo demás funciona. El principal problema que tiene es que, al usar plástico de 3mm, la fuerza del hilo de plástico al entrar en el hotend hace que el mismo oscile, dejando un patrón característico en las piezas que imprime.

Abro este hilo para preguntaros si estaríais interesados en un préstamo de la misma y para negociar las condiciones del mismo. Mi propuesta es la siguiente:

* Yo cedería temporalmente la impresora y todo el plástico de 3mm que me queda a ASROB para uso y disfrute de los miembros de la Asociación. Pero me reservo el derecho a terminar la cesión y llevarme la impresora cuando me apetezca.
* Si en su estado actual no se puede imprimir con ella, o consideráis que necesita alguna mejora como cambiar el hotend para usar hilo de 1.75mm o añadir LCD, yo correría con los gastos de la mejora, previa consulta a mi persona de dichos gastos.
* Los gastos de mantenimiento derivados de su uso en la Asociación correrían a cargo de la Asociación. (Estoy abierto a otras propuestas para este punto)

Comentadme qué opináis sobre la propuesta.

Siotma, 2017-10-01:
Teniendo en cuenta la gran cantidad de gente interesada en impresoras este año, cualquier nueva contribución es bienvenida. Lo más importante es disponer de la máquina y de filamento. Estoy de acuerdo con los criterios que propones, al fin y al cabo, quien pague cada cosa será su propietario.

Por otra, parte, en caso de que lo creas necesario, te recomendaría que hiciersas una copia de seguridad de los archivos de configuración si aún los tienes así como los parámetros de impresión, para que los guardes y también para nosotros podamos utilizarlos como punto de partida.

Sobre el tema de modificaciones te quería hablar. En Printer One una de las máximas es que se pueden realizar abiertamente modificaciones en la impresora a nivel de software o de hardware siempre que:
1. Sean reversibles.
2. Se documenten los motivos, pasos realizados y resultado final.

Me gustaría que lo valorases, ya que creo que, si finalmente prestases la impresora, su utilidad más clara sería utilizarla para investigar el uso de distintas piezas o configuraciones, así como aprendizaje de los nuevos.

Dado que dices que necesita un buen calibrado, imagino que estarás de acuerdo en que se pueda modificar su firmware, y ajustar la mecánica, pero igual quieres acotar las posibles modificaciones a nivel de hardware (piezas, electrónica, etc) que se practiquen sobre ella.

David-Estevez, 2017-10-01:
Totalmente de acuerdo con la experimentación! Como ya he dicho, es una impresora que ya prácticamente no uso, así que podéis experimentar con ella todo lo que queráis. Eso incluye cambiar piezas y mecánica, ajustes, etc.

Con el firmware, lo mismo, yo os busco el `Configuration.h` de la impresora y vosotros hacéis las modificaciones que veáis oportunas. Hace tanto que no toco el firmware que ya ni me acuerdo de cómo estaba configurado, así que cambiad todo a vuestro gusto.

Respecto a limitaciones de modificaciones, la única que tengo es el presupuesto que le puedo dedicar a esta impresora. Por ello, lo mejor es que me comuniquéis las mejoras que proponéis y negociamos quién se hace cargo del gasto. Como criterio preeliminar propongo lo que os he comentado antes, que los gastos necesarios para el funcionamiento inicial (cambio de hotend, pantalla LCD, etc) corran a cargo mío y el mantenimiento derivado de su uso a cargo de ASROB. Para modificaciones que no sean ni una cosa ni la otra siempre podemos negociar quién lo financia.

¿Estáis de acuerdo con estas condiciones?

David-Estevez, 2017-10-04:
Aquí os dejo el Configuration.h de mi impresora. Al final resulta que iba a 115200 baudios (my bad).

[Configuration.h.tar.gz](https://github.com/asrob-uc3m/impresoras-asrob/files/1355328/Configuration.h.tar.gz)

Tratádmela con cariño!!

Siotma, 2017-10-05:
> ¿Estáis de acuerdo con estas condiciones?

Totalmente! 🎉

> Aquí os dejo el Configuration.h de mi impresora. Al final resulta que iba a 115200 baudios (my bad).

¡Muchas gracias por buscarlo!, como puedes ver [aquí](https://github.com/asrob-uc3m/impresoras-asrob/tree/master/Dedalo) , ayer ya estuvimos trasteando y sacamos algunos valores por si no encontrabas ese fichero 👍 Lo suyo sería disponer de ese fichero en la carpeta correspondiente del Repo. Súbelo tú mejor para que quede constancia de que es el original.

> Tratádmela con cariño!!

Pues claro! De hecho, voy a abrir una nueva Issue para gestionar su puesta a punto.

Dado que el préstamo ya se ha realizado, cierro esta Issue.

David-Estevez, 2017-10-05:
Archivo subido en fe378824ab6218fd56dc411012a1c01a6bfdb569

David-Estevez, 2017-10-05:
Resulta que en la wiki de ASROB hay más información sobre la impresora!

http://asrob.uc3m.es/index.php/Clone_wars:Impresora_Dedalo

Siotma, 2017-10-07:
Enlazado desde el [cuaderno de Bitácora](http://asrob.uc3m.es/index.php/Printer_One:_A_Clone_Wars_Story:_Cuaderno_de_Bitacora#3_de_octubre_de_2017)

Closed 2017-10-05.

Thread 31 (2017-10-05):

Puesta a punto de Dédalo

Siotma, 2017-10-05:
Tras el préstamo de la impresora, descrito en #30 , es momento de comenzar a trabajar con ella.

En esta Issue se debe centralizar el trabajo hecho sobre Dédalo hasta que se encuentre operativa.

En la última reunión se propusieron las siguientes líneas de trabajo iniciales:

- [x] Investigar la placa: versión, firmware que lleva incorporado y configuración.
- [x] Perfeccionar la mecánica: el carro del eje X oscila mucho y ello es inadmisible en una impresora 3D.

Además, cuando la impresora cobre vida, también sería importante:

- [x] Calibrarla, para que los movimientos de los ejes sean fieles a las dimensiones reales.
- [ ] Limpiarla: quitarle el polvo y engrasar los ejes.
- [x] Realizar pruebas de impresión.

EDIT, más cosas que hacer dichas en https://github.com/asrob-uc3m/impresoras-asrob/issues/31#issuecomment-338821130 :

- [x] Tensar correas, ya que están algo sueltas y creemos que puede afectar a la impresión
- [x] Cambio pieza de una de las varillas del eje Z, que básicamente, se cae y está medio suelta
- [x] Revisión motores eje Z. Revisaremos la configuración de Marlin, ya que sospechamos que la aceleración puede estar causando algunos problemas.
- [x] Mejora de calibración cama caliente. Quizá usar muelles en lugar del sistema que tiene ahora ayudaría a la hora de calibrar más rápido y mejor.

EDIT2, aún más cosas que hacer dichas en https://github.com/asrob-uc3m/impresoras-asrob/issues/31#issuecomment-339027099 :

- [x] Flashear la última versión de Marlin con los parámetros óptimos encontrados.

EDIT3, aún más cosas que hacer dichas en https://github.com/asrob-uc3m/impresoras-asrob/issues/31#issuecomment-339178313 :

- [x] Revisar eje Y para intentar evitar ese movimiento en las impresiones.
- [ ] Configurar Rules de PC para Dédalo.
- [x] Imprimir o buscar un soporte para el filamento, para colocárselo a Dédalo. Tener el filamento colgado de uno de los motores...no es una opción D:
- [ ]  Estaría bien añadir algún tipo de tensor a la correa del eje Y. Lo de darle la vuelta a la impresora y pelearse con los tornillos me parece un poco chapuza. Seguro que hay alguna pieza por ahí que nos ayudaría ;)

Si me he dejado algo, habría que añadirlo en este mensaje para que queden todas las tareas a realizar juntas.

Siotma, 2017-10-05:
En la [última reunión de Printer One](http://asrob.uc3m.es/index.php/Printer_One:_A_Clone_Wars_Story:_Cuaderno_de_Bitacora#3_de_octubre_de_2017) comenzamos a trabajar con Dédalo:
- Se sabe que dispone de una placa Sanguinololu de las primeras versiones.
- Se ha investigado al configuración del firmware que tiene actualmente esta placa:
-- Funciona a 115200 Baudios
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
-- Aquí se relacionan los parámetros del Configuration.h obtenidos a través de Repetier
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
- Asimismo, se han comenzado los trabajos para sustituir el carro del eje X por uno más estable. @gonzalojs1 y @mmartinezt49 han encontrado [estas piezas](https://www.thingiverse.com/thing:181524/#files) y ya hemos impreso la primera con Blacky.

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

gonzalojs1, 2017-10-12:
Después de imprimir el carro para el eje x, se fijó este a Dédalo junto con unas patillas nuevas para juntar la correa a dicho carro. La falta de estabilidad en ela dirección x ya esta solucionada para esta impresora.

Siotma, 2017-10-13:
Efectivamente, se montaron las nuevas piezas y también se imprimió una nueva polea para la correa del eje X. Lamentablemente, el montaje realizado provocó que la correa roce con el motor del extrusor y hubo que insertar una tuerca adicional (ver imágenes).

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

Sin embargo, yo solo me he auto resuelto este problema, dándome cuenta de que los extrusores de las impresoras Prusa-i2 van casi siempre torcidos (ver [aquí](http://asrob.uc3m.es/images/thumb/2/24/Dedalo_final.JPG/602px-Dedalo_final.JPG)). Rotar el extrusor debería resolver el problema.

Por otra parte, aunque el carro de X ahora no baila, el extrusor sí lo hace, ya que la fijación es muy pobre, yo propondría imprimir una nueva pieza de extrusor como [esta](https://www.thingiverse.com/download:279662) sacada de [aquí](https://www.thingiverse.com/thing:141915/#files) que permita la fijación mediante tornillos.

Siotma, 2017-10-13:
Como apunte, destacar que la pieza del eje X impresa, sacada de [aquí](https://www.thingiverse.com/thing:181524/#files), está diseñada para rodamientos LM10UU, mientras que los de Dédalo son LM8UU. He encontrado [estas otras piezas](https://www.thingiverse.com/thing:173339), que parecen ser las mismas, pero para los rodamientos correctos, de manera que de ahora en adelante sería mejor imprimir estas.

GioSunrider, 2017-10-17:
Hoy @Sulphie, @carlosmgomezj y @metroid2010 y yo, hemos solucionado el problema de rozamiento del motor con la correa. Para ello se ha cambiado de posicion el lado derecho (segun foto adjunta) colocandolo en el agujero delantero.

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

Una vez colocado esto @Siotma se ha percatado de que la correa no estaba alineada y se han colocado nuevos tornillos mas largos con unas tuercas para ejercer presión y fijar de nuevo el motor.

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

De esta manera la correa tampoco roza con las paredes laterales, evitando su desgaste.
Posteriormente se ha procedido a su encendido, se ha probado con el Repetier, el movimiento de los motores manualmente (con la útima version de cura no se podia), y a calentar la cama caliente y el extrusor, que aparentemente funciona correctamente. Nos hemos quedado a medias de la configuración de la misma en uno de los portátiles.
También al final de la sesión, nos hemos percatado del estado de la pieza que encaja en el rodamiento del eje Z, contrario a donde se encuentra la placa.

daavm, 2017-10-23:
Hoy hemos calibrado la cama e impreso las primeras pruebas. Con esta impresión nos hemos dado cuenta de algunos cambios y revisiones que todavía necesita Dedalo para su puesta a punto:
- Tensar correas, ya que están algo sueltas y creemos que puede afectar a la impresión
- Cambio pieza de una de las varillas del eje Z, que básicamente, se cae y está medio suelta
- Revisión motores eje Z. Mañana revisaremos la configuración de Marlin, ya que sospechamos que la aceleración puede estar causando algunos problemas.
- Mejora de calibración cama caliente. Quizá usar muelles en lugar del sistema que tiene ahora ayudaría a la hora de calibrar más rápido y mejor.
Posiblemente me deje algo, en tal caso lo añadimos mañana tras la reunión!

David-Estevez, 2017-10-23:
No sé si lo comenté, pero tengo un par de acoples de estos para el eje Z (una mejora que nunca llegué a instalar). Mañana los llevo para que los podáis usar.

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

De hecho debería revisar la caja de repuestos por si hubiese algo más que daros.

Siotma, 2017-10-24:
Sin duda estos acoples mejorarían el funcionamiento del eje Z 😊

Siotma, 2017-10-24:
Para solucionar el patinaje del eje Z, he estado mirando el fichero [Configuration.h](https://github.com/asrob-uc3m/impresoras-asrob/blob/master/Dedalo/Configuration.h) disponible en este repositorio, concretamente esta parte:

```
#define DEFAULT_AXIS_STEPS_PER_UNIT   {80.0801, 79.9306, 2560 , 568.18*15/11}  // default steps per unit for ultimaker
#define DEFAULT_MAX_FEEDRATE          {500, 500, 5, 45}    // (mm/sec)
#define DEFAULT_MAX_ACCELERATION {5000,3000 /*5000*/,50,5000} // X, Y, Z, E maximum start speed for accelerated moves. E default values are good for skeinforge 40+, for older versions raise them a lot.
```

Según veo, el valor de aceleración del eje Z es conservador, solo 50 mm/s2. Podría bajarse más para evitar patinajes, pero yo creo que lo más crítico es la velocidad máxima, que está puesta en 5mm/sec.

Yo recomendaría bajar la velocidad a 1mm/sec antes de tocar la aceleración.

Para flashearle un nuevo firmware:
1. Entrad en el [repositorio de Marlin](https://github.com/MarlinFirmware/Marlin/releases) y descargad la última Release (1.1.6).
2. Una vez descargada, descomprimid todo en una carpeta y abrid el fichero Marlin.ino con la IDE de Arduino.
3. En el fichero Configuration.h que se abrirá, copiad todos los valores del fichero que tenemos en el Repositorio.
4. Subir el firmware en la placa de la impresora, por USB, conectada como si fuera un Arduino Mega.
5. Comprobad si los cambios han corregido el problema.

daavm, 2017-10-25:
En la sesión de hoy hemos avanzado bastante con dédalo:

- @metroid2010 ha instalado los nuevos acoples del eje Z que @David-Estevez ha traído. Este cambio ha parecido mejorar el movimiento del eje z. Anteriormente, este eje se bloqueaba cuando lo intentabamos desplazar en incrementos de 10 a traves de Repetier. Esto ahora no pasa.

- Hemos tensado las correas del eje Y, ya que se veían ciertas ondulaciones en las impresiones en dicho eje. Se ha impreso otra pieza de prueba y, aunque esas ondulaciones ya no estaban, hemos notado cómo el eje Y parecía desplazarse poco a poco (ver foto). De momento desconocemos por qué pasa esto (el extrusor está un poco suelto quizá?)

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

- Uno de los cables de alimentación de la placa (el amarillo, creo recordar), se ha roto. Tenía fácil solución así que ya está arreglado.

- Hemos probado a disminuir la velocidad y aceleración del eje Z, pero a través de la configuración EEPROM del Firmware, en Repetier. En mi opinión la impresion ha mejorado, pero tampoco teníamos muchas pruebas anteriores con las que comparar.

- Respecto a las pruebas de impresión de ayer lunes, el resultado final es notablemente mejor, veanse videos y fotos:

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
(No juzguéis la calidad del GIF, si queréis el video está en telegram!)

Dejamos para la próxima reunión pendiente de hacer:

- Revisar eje Y para intentar evitar ese movimiento en las impresiones
- Buscar PC para Dédalo. Hemos hablado @davidvelascogarcia y yo de la posibilidad de usar el que estaba antes con la impresora hija. No tiene mucha ram (1GB) y el lector de discos no funciona, pero podríamos intentar meterle Linux y usarlo de forma provisional para Dédalo.
- Imprimir o buscar un soporte para el filamento, para colocárselo a Dédalo. Tener el filamento colgado de uno de los motores...no es una opción D:

De momento no creo dejarme nada, corregidme los que habéis estado hoy si no! :+1:

JorFru, 2017-10-25:
Sugiero destensar un pelín la correa de Y. Puede que ese problema de
desplazamiento sea a causa de pérdida de pasos porque el carro no corre
bien al tener la correa tan tensa.

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

davidvelascogarcia, 2017-10-25:
Lo comento, a ver que os parece.
Ayer, @daavm y yo , hablamos del hecho de que dado que no hay otro tercer monitor para el futuro PC que controlará Dédalo, se podría utilizar un KVM, y emplear el mismo monitor, teclado y ratón que controla o bien Hija Resturrection o bien Blacky, y alternar de uno a otro con una sola tecla.

Siotma, 2017-10-25:
Muy buen trabajo chicos.

He condensado todas las tareas que habéis ido escribiendo en el primer comentario. Al utilizar el formato de task list cualquiera puede ir marcando las tareas como completadas.

Creo poder aportar luz en la parte de las imprecisiones del eje Y. Hay que tener en cuenta lo siguiente:
- El extrusor oscila un poco, por lo que puede producir errores si se mueve durante la impresión, para eso habría que imprimir un soporte con agujueros para anclarlo con tornillos como [este](https://www.thingiverse.com/download:279662) sacado de [aquí](https://www.thingiverse.com/thing:141915/#files).
- La correa de un eje debe estar tensa pero sin pasarse, como bien dice @JorFru más arriba.
- La corriente que suministra el pololu al motor debe ser suficiente como para que este no pierda pasos. Creo que [este vídeo de Obijuan](https://www.youtube.com/watch?v=iEf7EnCCUao) es perfecto para ello.

Estas tres mismas circunstancias pueden afectar igualmente al eje X. Sería interesante evaluarlo también.

GioSunrider, 2017-10-25:
He añadido a la lista de cosas de por hacer, la mejora que comentamos @daavm y yo que era buscar la manera de mejorar la calibracion de la cama con muelles, porque lo de los tornillos que hay ahora nos ha estando dando guerra en las dos sesiones de esta semana.

David-Estevez, 2017-10-25:
Dos cosillas:

* Respecto al eje Y, le he echado un ojo y lo que parece es que la correa roza con uno de los idlers (el que está por la parte de atrás del extrusor) por lo que se engancha y le cuesta más moverse. Esta puede ser una causa para los problemas en ese eje.

* Respecto a lo de la pantalla + KVM, yo propongo desempolvar el display LCD que hay en el armario y colocárselo a alguna de las dos impresoras que tienen RAMPS. De esta forma se podría empezar a experimentar con la idea que se gestó [aquí](https://github.com/asrob-uc3m/actas/issues/93#issuecomment-335903419) (y que muy probablemente se debería convertir en una issue independiente) y se liberaría un PC que se podría usar en Dédalo. Esto es importante sobre todo porque la idea es reducir el número de PCs, no aumentarlo :sweat_smile:

GioSunrider, 2017-10-30:
Voy por partes que hoy ha sido provechoso, lo primero que he estado haciendo ha sido mirar la configuración de Marlin, he bajado la nueva version y he pasado lo valores uno a uno. Adjunto el nuevo Configuration.h para que simplemente se copie para futuras pruebas. Ya que no se ha conseguido subirlo a la placa, debido a que daba error de velocidad. Se estaba cargando con el IDE de Arduino con la placa Sanguino de Configuracion y a distitas velocidades (16 y 8 MHz). El procesador de la placa es un Sanguino 644p, suponemos que la mejor velocidad es la de 16, pero no hemos conseguido subirlo. Los cambios realizados en Marin vienen marcados con un //DEDALO
```
/**
 * Marlin 3D Printer Firmware
 * Copyright (C) 2016 MarlinFirmware [https://github.com/MarlinFirmware/Marlin]
 *
 * Based on Sprinter and grbl.
 * Copyright (C) 2011 Camiel Gubbels / Erik van der Zalm
 *
 * This program is free software: you can redistribute it and/or modify
 * it under the terms of the GNU General Public License as published by
 * the Free Software Foundation, either version 3 of the License, or
 * (at your option) any later version.
 *
 * This program is distributed in the hope that it will be useful,
 * but WITHOUT ANY WARRANTY; without even the implied warranty of
 * MERCHANTABILITY or FITNESS FOR A PARTICULAR PURPOSE.  See the
 * GNU General Public License for more details.
 *
 * You should have received a copy of the GNU General Public License
 * along with this program.  If not, see <http://www.gnu.org/licenses/>.
 *
 */

/**
 * Configuration.h
 *
 * Basic settings such as:
 *
 * - Type of electronics
 * - Type of temperature sensor
 * - Printer geometry
 * - Endstop configuration
 * - LCD controller
 * - Extra features
 *
 * Advanced settings can be found in Configuration_adv.h
 *
 */
#ifndef CONFIGURATION_H
#define CONFIGURATION_H
#define CONFIGURATION_H_VERSION 010100

//===========================================================================
//============================= Getting Started =============================
//===========================================================================

/**
 * Here are some standard links for getting your machine calibrated:
 *
 * http://reprap.org/wiki/Calibration
 * http://youtu.be/wAL9d7FgInk
 * http://calculator.josefprusa.cz
 * http://reprap.org/wiki/Triffid_Hunter%27s_Calibration_Guide
 * http://www.thingiverse.com/thing:5573
 * https://sites.google.com/site/repraplogphase/calibration-of-your-reprap
 * http://www.thingiverse.com/thing:298812
 */

//===========================================================================
//============================= DELTA Printer ===============================
//===========================================================================
// For a Delta printer start with one of the configuration files in the
// example_configurations/delta directory and customize for your machine.
//

//===========================================================================
//============================= SCARA Printer ===============================
//===========================================================================
// For a SCARA printer start with the configuration files in
// example_configurations/SCARA and customize for your machine.
//

// @section info

// User-specified version info of this build to display in [Pronterface, etc] terminal window during
// startup. Implementation of an idea by Prof Braino to inform user that any changes made to this
// build by the user have been successfully uploaded into firmware.
#define STRING_CONFIG_H_AUTHOR "GioSunrider" // Who made the changes. //DEDALO
#define STRING_VERSION_CONFIG_H "2017-10-30" //Personal revision number for changes to THIS file. //DEDALO
#define SHOW_BOOTSCREEN
#define STRING_SPLASH_LINE1 SHORT_BUILD_VERSION // will be shown during bootup in line 1
#define STRING_SPLASH_LINE2 WEBSITE_URL         // will be shown during bootup in line 2

//
// *** VENDORS PLEASE READ *****************************************************
//
// Marlin now allow you to have a vendor boot image to be displayed on machine
// start. When SHOW_CUSTOM_BOOTSCREEN is defined Marlin will first show your
// custom boot image and then the default Marlin boot image is shown.
//
// We suggest for you to take advantage of this new feature and keep the Marlin
// boot image unmodified. For an example have a look at the bq Hephestos 2
// example configuration folder.
//
//#define SHOW_CUSTOM_BOOTSCREEN
// @section machine

/**
 * Select which serial port on the board will be used for communication with the host.
 * This allows the connection of wireless adapters (for instance) to non-default port pins.
 * Serial port 0 is always used by the Arduino bootloader regardless of this setting.
 *
 * :[0, 1, 2, 3, 4, 5, 6, 7]
 */
#define SERIAL_PORT 0

/**
 * This setting determines the communication speed of the printer.
 *
 * 250000 works in most cases, but you might try a lower speed if
 * you commonly experience drop-outs during host printing.
 * You may try up to 1000000 to speed up SD file transfer.
 *
 * :[2400, 9600, 19200, 38400, 57600, 115200, 250000, 500000, 1000000]
 */
//define BAUDRATE 250000 //DEDALO
#define BAUDRATE 115200 //DEDALO

// Enable the Bluetooth serial interface on AT90USB devices
//#define BLUETOOTH

// The following define selects which electronics board you have.
// Please choose the name from boards.h that matches your setup
#ifndef MOTHERBOARD
  #define MOTHERBOARD 62 //DEDALO
#endif

// Optional custom name for your RepStrap or other custom machine
// Displayed in the LCD "Ready" message
//#define CUSTOM_MACHINE_NAME "3D Printer"

// Define this to set a unique identifier for this printer, (Used by some programs to differentiate between machines)
// You can use an online service to generate a random UUID. (eg http://www.uuidgenerator.net/version4)
//#define MACHINE_UUID "00000000-0000-0000-0000-000000000000"

// @section extruder

// This defines the number of extruders
// :[1, 2, 3, 4, 5]
#define EXTRUDERS 1

// For Cyclops or any "multi-extruder" that shares a single nozzle.
//#define SINGLENOZZLE

/**
 * Průša MK2 Single Nozzle Multi-Material Multiplexer, and variants.
 *
 * This device allows one stepper driver on a control board to drive
 * two to eight stepper motors, one at a time, in a manner suitable
 * for extruders.
 *
 * This option only allows the multiplexer to switch on tool-change.
 * Additional options to configure custom E moves are pending.
 */
//#define MK2_MULTIPLEXER
#if ENABLED(MK2_MULTIPLEXER)
  // Override the default DIO selector pins here, if needed.
  // Some pins files may provide defaults for these pins.
  //#define E_MUX0_PIN 40  // Always Required
  //#define E_MUX1_PIN 42  // Needed for 3 to 8 steppers
  //#define E_MUX2_PIN 44  // Needed for 5 to 8 steppers
#endif

// A dual extruder that uses a single stepper motor
//#define SWITCHING_EXTRUDER
#if ENABLED(SWITCHING_EXTRUDER)
  #define SWITCHING_EXTRUDER_SERVO_NR 0
  #define SWITCHING_EXTRUDER_SERVO_ANGLES { 0, 90 } // Angles for E0, E1[, E2, E3]
  #if EXTRUDERS > 3
    #define SWITCHING_EXTRUDER_E23_SERVO_NR 1
  #endif
#endif

// A dual-nozzle that uses a servomotor to raise/lower one of the nozzles
//#define SWITCHING_NOZZLE
#if ENABLED(SWITCHING_NOZZLE)
  #define SWITCHING_NOZZLE_SERVO_NR 0
  #define SWITCHING_NOZZLE_SERVO_ANGLES { 0, 90 }   // Angles for E0, E1
  //#define HOTEND_OFFSET_Z { 0.0, 0.0 }
#endif

/**
 * Two separate X-carriages with extruders that connect to a moving part
 * via a magnetic docking mechanism. Requires SOL1_PIN and SOL2_PIN.
 */
//#define PARKING_EXTRUDER
#if ENABLED(PARKING_EXTRUDER)
  #define PARKING_EXTRUDER_SOLENOIDS_INVERT           // If enabled, the solenoid is NOT magnetized with applied voltage
  #define PARKING_EXTRUDER_SOLENOIDS_PINS_ACTIVE LOW  // LOW or HIGH pin signal energizes the coil
  #define PARKING_EXTRUDER_SOLENOIDS_DELAY 250        // Delay (ms) for magnetic field. No delay if 0 or not defined.
  #define PARKING_EXTRUDER_PARKING_X { -78, 184 }     // X positions for parking the extruders
  #define PARKING_EXTRUDER_GRAB_DISTANCE 1            // mm to move beyond the parking point to grab the extruder
  #define PARKING_EXTRUDER_SECURITY_RAISE 5           // Z-raise before parking
  #define HOTEND_OFFSET_Z { 0.0, 1.3 }                // Z-offsets of the two hotends. The first must be 0.
#endif

/**
 * "Mixing Extruder"
 *   - Adds a new code, M165, to set the current mix factors.
 *   - Extends the stepping routines to move multiple steppers in proportion to the mix.
 *   - Optional support for Repetier Firmware M163, M164, and virtual extruder.
 *   - This implementation supports only a single extruder.
 *   - Enable DIRECT_MIXING_IN_G1 for Pia Taubert's reference implementation
 */
//#define MIXING_EXTRUDER
#if ENABLED(MIXING_EXTRUDER)
  #define MIXING_STEPPERS 2        // Number of steppers in your mixing extruder
  #define MIXING_VIRTUAL_TOOLS 16  // Use the Virtual Tool method with M163 and M164
  //#define DIRECT_MIXING_IN_G1    // Allow ABCDHI mix factors in G1 movement commands
#endif

// Offset of the extruders (uncomment if using more than one and relying on firmware to position when changing).
// The offset has to be X=0, Y=0 for the extruder 0 hotend (default extruder).
// For the other hotends it is their distance from the extruder 0 hotend.
//#define HOTEND_OFFSET_X {0.0, 20.00} // (in mm) for each extruder, offset of the hotend on the X axis
//#define HOTEND_OFFSET_Y {0.0, 5.00}  // (in mm) for each extruder, offset of the hotend on the Y axis

// @section machine

/**
 * Select your power supply here. Use 0 if you haven't connected the PS_ON_PIN
 *
 * 0 = No Power Switch
 * 1 = ATX
 * 2 = X-Box 360 203Watts (the blue wire connected to PS_ON and the red wire to VCC)
 *
 * :{ 0:'No power switch', 1:'ATX', 2:'X-Box 360' }
 */
#define POWER_SUPPLY 0

#if POWER_SUPPLY > 0
  // Enable this option to leave the PSU off at startup.
  // Power to steppers and heaters will need to be turned on with M80.
  //#define PS_DEFAULT_OFF
#endif

// @section temperature

//===========================================================================
//============================= Thermal Settings ============================
//===========================================================================

/**
 * --NORMAL IS 4.7kohm PULLUP!-- 1kohm pullup can be used on hotend sensor, using correct resistor and table
 *
 * Temperature sensors available:
 *
 *    -3 : thermocouple with MAX31855 (only for sensor 0)
 *    -2 : thermocouple with MAX6675 (only for sensor 0)
 *    -1 : thermocouple with AD595
 *     0 : not used
 *     1 : 100k thermistor - best choice for EPCOS 100k (4.7k pullup)
 *     2 : 200k thermistor - ATC Semitec 204GT-2 (4.7k pullup)
 *     3 : Mendel-parts thermistor (4.7k pullup)
 *     4 : 10k thermistor !! do not use it for a hotend. It gives bad resolution at high temp. !!
 *     5 : 100K thermistor - ATC Semitec 104GT-2 (Used in ParCan & J-Head) (4.7k pullup)
 *     6 : 100k EPCOS - Not as accurate as table 1 (created using a fluke thermocouple) (4.7k pullup)
 *     7 : 100k Honeywell thermistor 135-104LAG-J01 (4.7k pullup)
 *    71 : 100k Honeywell thermistor 135-104LAF-J01 (4.7k pullup)
 *     8 : 100k 0603 SMD Vishay NTCS0603E3104FXT (4.7k pullup)
 *     9 : 100k GE Sensing AL03006-58.2K-97-G1 (4.7k pullup)
 *    10 : 100k RS thermistor 198-961 (4.7k pullup)
 *    11 : 100k beta 3950 1% thermistor (4.7k pullup)
 *    12 : 100k 0603 SMD Vishay NTCS0603E3104FXT (4.7k pullup) (calibrated for Makibox hot bed)
 *    13 : 100k Hisens 3950  1% up to 300°C for hotend "Simple ONE " & "Hotend "All In ONE"
 *    20 : the PT100 circuit found in the Ultimainboard V2.x
 *    60 : 100k Maker's Tool Works Kapton Bed Thermistor beta=3950
 *    66 : 4.7M High Temperature thermistor from Dyze Design
 *    70 : the 100K thermistor found in the bq Hephestos 2
 *    75 : 100k Generic Silicon Heat Pad with NTC 100K MGB18-104F39050L32 thermistor
 *
 *       1k ohm pullup tables - This is atypical, and requires changing out the 4.7k pullup for 1k.
 *                              (but gives greater accuracy and more stable PID)
 *    51 : 100k thermistor - EPCOS (1k pullup)
 *    52 : 200k thermistor - ATC Semitec 204GT-2 (1k pullup)
 *    55 : 100k
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

Thread 32 (2017-10-13):

Mejorar la precisión de las impresoras utilizando la compensación en XY

Siotma, 2017-10-13:
@carlosmgomezj y @diegodevigo propusieron en la [última reunión](http://asrob.uc3m.es/index.php/Printer_One:_A_Clone_Wars_Story:_Cuaderno_de_Bitacora#9_de_octubre_de_2017) mejorar el ajuste de la compensación en XY para conseguir medidas más precisas para las piezas impresas, lo cual es una gran idea.
Se pueden hacer pruebas por ejemplo con [esta pieza](https://www.thingiverse.com/thing:916214) hasta conseguir que la moneda encaje correctamente.

diegotrap, 2017-11-16:
Veo que este issue va a estar programado para los próximas sesiones, así que me gustaría dar mi opinión.

Yo creo que este tipo de calibración es incorrecta, para los ejes X, Y lo mejor es usar los valores nominales de steps per mm. Es un tema que suele salir de vez en cuando en impresión 3D y hay dos escuelas de pensamiento, pero dejo el vídeo de Thomas Sanladerer donde justifica por qué no es una buena manera de calibrar los ejes: https://www.youtube.com/watch?v=Mbn1ckR86Z8

Siotma, 2017-11-16:
He visto el vídeo entero y ahora entiendo bien tu comentario. Como dices, los pasos por mm no deben ser modificados, y no es nuestra intención hacerlo.

Lo que queremos utilizar es la opción de Slic3r de "Compensación en XY", la cual es mencionada en el vídeo al final como "la forma correcta de realizar la calibración".

Probablemente, el poco texto que hay en el primer comentario te haya conducido a error.

Aun así, muchísimas gracias por el vídeo, he visto que tiene algunos consejos y enlaces muy interesantes! 👍

diegotrap, 2017-11-16:
Vaya, pues ahora yo quiero aprender a usar esa función de Slic3r =)

Siotma, 2018-01-27:
Creo que ahora que Blacky y Dédalo funcionan tan bien, sería muy interesante comenzar a investigar en esta issue.

GioSunrider, 2019-11-15:
Actualmente Blacky no imprime en las medidas correctas porlo que esto podria ser la solucion correcta.

JorFru, 2019-11-16:
Compensación en XY se llama "horizontal expansion" en Cura. Hay ajuste de expansión para la primera capa, que corrige el "pie de elefante", y para el resto de capas, que corrige el tamaño de los agujeros.

Adjunto un pequeño croquis, sacado de https://www.spainlabs.com/foros/tema-Ender-3D

- cubo grande + agujero grande = muchos pasos
- cubo pequeño + agujero pequeño = pocos pasos

- cubo grande + agujero pequeño = poca compensación XY
- cubo pequeño + agujeros grande = mucha compensación XY

Modificar pasos/mm actua en todas las dimensiones de la pieza, es un multiplicador de dimensiones.
Compensación en XY (expansión horizontal) lo que hace es mover las paredes hacia dentro o hacia fuera, el número son milímetros. El signo define si es hacia dentro o hacia fuera.

JorFru, 2019-11-16:
Habría que identificar qué es lo que necesitamos.

Closed 2023-09-28.

Thread 33 (2017-10-13):

Investigar el encendido de la nueva fuente de alimentación de Blacky

Siotma, 2017-10-13:
La nueva fuente de alimentación de Blacky (instalada en #28 ) parece requerir un mínimo de carga para arrancar. Se debe comprobar cuál la resistencia necesaria (probablemente lo sean en el canal de 5V, según he encontrado en [el paso 10 de este tutorial](https://makezine.com/projects/computer-power-supply-to-bench-power-supply-adapter/)) e instalarla para que la fuente sea fácilmente utilizable.

La instalación de la resistencia debería realizarse preferiblemente de manera interna para reducir las posibilidades de rotura y al mismo tiempo facilitar la ventilación.

Solo para cerciorarme, @David-Estevez @jgvictores , ¿habría posibilidad de obtener una resistencia de potencia de 10ohm / 10W de la asociación o del departamento? ¿O debería abrir una issue para comprarla?

Siotma, 2017-10-13:
Cuando se realicen estas pruebas, sería interesante replicarlas en la otra fuente de alimentación idéntica a la de Blacky que hay en el armario. Una vez se haya resuelto esta incidencia, el siguiente paso será colocar la nueva fuente en Hija Resurrection.

David-Estevez, 2017-10-13:
He estado mirando en RS y no son muy caras, yo creo que sí que sería posible conseguir una del departamento. Pero que nos confirme @jgvictores a ver qué le parece a él.

JorFru, 2017-10-15:
Yo dono las resistencias.
Serán dos de 4R7 10W

No puedo comprometerme a llevarlas la próxima reunión, pero será pronto.

On Oct 13, 2017 13:58, "David Estévez Fernández" <notifications@github.com>
wrote:

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

JorFru, 2017-10-15:
Llevo cuatro. Dos para cada máquina.

On Oct 15, 2017 12:36, "JORGE FRUTOS DE MINGO" <100317402@alumnos.uc3m.es>
wrote:

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

Siotma, 2017-10-17:
Hoy se han realizado pruebas con la fuente de alimentación, aunque no se ha dispuesto de las resistencias de potencia que prometió @JorFru.

En su lugar, se ha probado con resistencias de 470ohm / 1W disponibles en el armario. Se han realizado pruebas colocando estas resistencias en los distintos canales de la fuente de alimentación, incluso se han conectado varias en paralelo, pero sin éxito.

La mayor carga que podemos conectar a la fuente ahora mismo es la propia impresora, y se ha determinado un comportamiento curioso:
- Tras largo tiempo sin usarla si se intenta encender la fuente mediante el interruptor incorporado, ésta no se inmuta, permaneciendo apagada.
- Si se activa el calentador del extrusor, tras varios intentos de activación - desactivación la fuente acaba arrancando.
- Si se activa el calentador de la cama caliente en este momento, se puede comprobar cómo el relé no engancha y empieza a sonar.
- Tras varios intentos de activación y desactivación de la cama caliente, al fin el relé engancha y la impresora es funcional.
- Una vez alcanzado este punto, no pasa nada por apagar y encender la fuente en un corto espacio de tiempo, ya que la fuente de alimentación seguirá funcionando correctamente.

Da por tanto la sensación de que la fuente tiene algún tipo de memoria que condiciona su comportamiento. Por tanto, **para realizar una correcta resolución de esta Issue, se debe valorar el arreglo con un largo tiempo de inactividad de por medio.**

Finalmente, leyendo algunos foros, he encontrado una idea provisional para poner una carga en la fuente: conectar un disco duro o una unidad de CD. Este tipo de unidades deberían demandar suficiente corriente como para que la fuente de alimentación arranque. Se puede añadir esta ide a la idea de la resistencia previamente comentada.

JorFru, 2017-10-17:
Hay disponibles ahora mismo dos resistencias en la caja de Printer One,
dentro del armario.

Una de 47Ohm 10W, pensada para instalarse en el raíl de 12V
Una de 10Ohm 10W, pensada para el raíl de 5V.

Acabo de acordarme de que esa fuente lleva dos raíles de 12V, igual hace
falta otra de 47. Probaremos.

PD: despiste remediado y promocionado por Jupi, su tienda de desconfianza.

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

Siotma, 2017-10-18:
Gracias, JorFru!

Siotma, 2017-10-24:
En la reunión de ayer estuvimos haciendo más pruebas con esta fuente de alimentación. A continuación voy a intentar exponer los descubrimientos más importantes, y en mi opinión, más fiables.

En primer lugar quiero incidir en los dos problemas conocidos que tiene actualmente esta fuente:

1. No sabemos exactamente qué requiere la fuente de alimentación para encenderse.
2. Una vez encendida, la fuente de alimentación no siempre es capaz de entregar potencia suficiente para alimentar la cama caliente, provocando un sonido de timbre en el relé.

Durante la reunión de ayer realicé innumerables pruebas, casi todas infructuosas, sin embargo saqué algunas conclusiones y hoy he vuelto 10 minutos esta mañana para contrastar los resultados de ayer. Son los siguientes:

- La fuente de alimentación de Blacky no necesita ninguna carga para encenderse.
- Para encenderse, la fuente parece requerir un orden específico de acontecimientos:
1. Encendido del interruptor de la fuente. El puente entre el cable verde y negro del [conector ATX](https://es.wikipedia.org/wiki/ATX) **no** debe estar hecho.
2. Espera de un tiempo, unos 30 segundos.
3. Conexión del puente entre el cable verde y negro. La fuente debe arrancar y el ventilador empezará a girar.
4. Si no arranca, es que el tiempo de espera ha sido corto. Sacar el puente, esperar otro poco y volver al paso 3.

*Este comportamiento concuerda con un uso habitual de la fuente de alimentación, ya que cuando está instalada en un PC, la fuente siempre tiene el interruptor activado y es el cable verde del botón de encendido el que la activa. Por tanto, es posible que la fuente necesite un tiempo para prepararse hasta que pueda entregar potencia, y que hasta que no esté preparada, el cable verde no funciona, o incluso puede que _evite_ que funcione.

*No lo he comprobado, pero es posible que el momento en que la fuente pueda ser encendida, coincida con un valor correcto en el cable violeta (5Vsb) del [conector ATX](https://es.wikipedia.org/wiki/ATX).

*Sí he comprobado que una vez la fuente ha arrancado, el valor de cable gris (Power OK) del [conector ATX](https://es.wikipedia.org/wiki/ATX) toma un valor de 5V.

- Una vez en marcha, siguiendo el proceso anterior, se debe probar a calentar la impresora, pueden ocurrir diferentes escenarios:
1. Si se intenta calentar solamente el extrusor, es posible que lo haga, aunque también es posible que la fuente se apague al detectar un pico de consumo muy alto.
2. Si se intenta calentar solamente la cama caliente, seguramente la fuente se apague al detectar el pico de consumo.
3. Es posible que al intentar calentar la cama caliente, el relé suene como un timbre. Esto se produce porque la fuente de alimentación en vez de apagarse, se queda reiniciándose continuamente debido al súbito pico de consumo que supone la cama caliente. Este escenario debe evitarse rápidamente si se produce ya que puede dañar la fuente.
4. Si se intentan calentar ambas partes simultáneamente, puede ocurrir cualquier combinación de lo anterior.
5. Si el relé de la cama caliente se queda fijo, es señal de que la protección de pico de corriente no ha saltado y que la fuente sigue encendida.
6. Para comprobar que la fuente es capaz de alimentar correctamente la impresora, se debe verificar que puede calentar simultáneamente el extrusor y la cama (sin que el relé suene como un timbre), y además mover los motores. Para un comprobación más fiable, se puede incluso imprimir una pieza pequeña.

*Sin embargo, el único escenario que debería darse es el número 6, evitando todos los anteriores, por ello se realizaron pruebas

- Se ha comprobado que se puede propiciar el escenario 6 colocando cargas en los raíles de la fuente, concretamente:
1. 10ohm en el raíl de +5V
2. 47ohm en el raíl de +12V2 con cables negros y amarillos
3. 3 resistencias en paralelo de 470ohm en el raíl de +12V1 con cables totalmente amarillos
4. Un lector de CD conectado al conector de alimentación SATA que utiliza tensiones de +5V, +3,3V y +12V1

*Es posible que el lector de CD no sea necesario si se coloca una carga mayor en el raíl de +12V1. Sin embargo, el lector es útil para conocer el comportamiento dinámico de la fuente ya que se abre y se cierra cada vez que la fuente se reinicia.

Este lector de CD se encuentra en la balda de Printer One, y las resistencias expuestas anteriormente se encuentran en la caja de recambios.

Además, abrí la fuente de alimentación hermana de esta y estuve haciendo peluquería de cables, aunque soldé el cable verde al negro antes de saber que esto iba a ser un problema, ahora mismo esta fuente no puede arrancar, lo que concuerda con el proceso de encendido expuesto al principio del mensaje. Lo que sí saqué en claro cuando abrí la fuente y quité unos cuantos cables, es que los raíles de 12V1 y 12V2 son efectivamente independientes, por lo que para debe utilizarse una resistencia para cada uno.

Ruego que en la reunión de hoy comprobéis el contenido de este comentario, pero aún no realicéis modificaciones irrecuperables en el cableado de la fuente de alimentación de Blacky. Postead las conclusiones y el próximo día, tras un triple check, la metemos mano.

Recuerdo el hecho de que una vez que la fuente ha arrancado del todo, es más fácil volver a hacerla arrancar, de modo que una vez que esté en marcha las pruebas que se hagan no serán tan fiables como las primeras. Por ello recomiendo que tras haberse pegado un poco con esto, se de paso a #32

Siotma, 2017-10-24:
A continuación, un poco de imagen a tanto texto.

Lector de CDs utilizado:

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

Durante la peluquería de la fuente de alimentación que tiene sonido electrónico, únicamente aprecié a nivel visual un condensador hinchado:

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

Finalmente, también pude comprobar cómo la fuente de alimentación tiene espacio suficiente en el interior para colocar las resistencias de carga que decidamos instalar finalmente:

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

David-Estevez, 2017-10-24:
@Siotma  Me quito el sombrero ante tu capacidad de documentación... :tophat:

JorFru, 2017-10-25:
Leñe!
Estuve leyendo todas las issues mientras comía, pero no leí esta, es posterior.
Lamento comunicaros que: Hemos perdido el tiempo realizando las comprobaciones que tú habías hecho por la mañana.

Sin embargo, algo más en claro habremos sacado, esperemos...
Hemos hecho prácticamente todo lo que tú has probado.
Resistencias de carga de la siguiente manera:
- 10Ohm en 12V1
- 10Ohm en 12V2
- 4.7Ohm en 5V

Como diferencia no hemos instalado la disquetera, aunque la carga resistiva era mayor que la de Manu.
Pues bien, no hemos notado ninguna mejoría respecto a que el ventilador gire cuando se lo pides, ni tampoco a la fiesta que se monta el relé.

PERO! Ahora que te leo, a posteriori y con detenimiento, todo me encaja.
La fuente se está reseteando continuamente. Ideas para solucionarlo:
1. Instalar una resistencia en serie con la cama para restarle potencia. No me convence, poco eficiente.
2. Instalar una bobina en serie con la cama. Lo cual aporta alta impedancia durante la avalancha de corriente al encender, y no lastra el rendimiento de la cama en régimen estacionario. Contras: desconocemos el comportamiento de la fuente frente a cargas inductivas (no debería de comportarse mal en teoría). posiblemente la bobina a instalar sea bastante grande queda pendiente calcular el tamaño.

@davidvelascogarcia estuvo conmigo y quizás pueda aportar algo que se me escape.

JorFru, 2017-10-25:
Le he dado más vueltas al asunto.
Ayer comprobé con el osciloscopio lo que pasaba en el raíl de 12V de la fuente cuando el relé oscilaba. No tengo foto de ello. Pero era un pico de 10-11V seguido de silencio a 0V. Por supuesto al mismo ritmo del clickeo.

Me percaté de que el LED que lleva la RAMPS y que indica que la salida del MOSFET está activada también parpadeaba al mismo ritmo. ¡Entonces empecé a pensar que era el propio Arduino que le mandaba encenderse y apagarse todo el rato! Pero acabo de buscar el esquemático de la RAMPS y me he heshecho de esa idea.
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
El Arduino se alimenta con el ordenador, no se va a apagar durante el reseteo de la fuente, y el mosfet que activa el relé funciona correctamente.
La luz se enciende cuando el mosfet cierra el circuito, sin embargo, cuando no hay 12V en la fuente, el LED no se puede encender ni aunque el mosfet esté cerrado. Esto explicaría este funcionamiento.
El contactor del relé tiene un muelle que fuerza a la posición abierta el relé, desconecta la cama y la fuente se vuelve a encender pensndo que el peligro ha pasado.
La fuente se resetea porque a priori ve un cortocircuito.
Esto en cuanto al problema del clickeo.

Sobre el problema de que a veces le cuesta arrancar, leyendo lo que dice David y Manu, la fuente tiene que estar conectada durante unos segundos antes de estar peparada para puentear el cable verde.
Sugiero instalar un interruptor nuevo qu puentee el cable verde y sirva para encender la fuente fácilmente. El interruptor que corta la alimentación AC se puede quedar siempre activado por comdidad o se puede desactivar cada vez, pero anotando el "modus operandi" para los no informados.

Sobre el tema de si son necesarias o no la cagas resistivas (o lector de discos) todavía no está comprobado. Pero estando al tanto de que el osciloscopio de ASROB funciona bien, se podría comprobar el rizado de la alimentación en ambos casos. Lo propongo para la siguiente reunión.

JorFru, 2017-10-25:
El gran Iceflow, Aisflow, me comenta por el canal de Telegram de
Staticboards que es muy recomendable instalar un diodo en serie con la
cama. Así lo monta la RAMPS1.4SB de diseño nacional.
No garantiza un arranque más suave, sin embargo garantiza que la corriente
no circule en el sentido contrario, lo cual puede dejar KO la fuente. Y
esto puedo ocurrir si la carga (la cama) tiene algo de componente
inductiva, lo cual seguro que es cierto viendo que el circuito de la cama
caliente parece un pantallazo del Snake en el último nivel.
Igual con  esta solución deja de reiniciarse.
Se probará en la siguiente reunión.

Saludos!

On Oct 25, 2017 1:14 PM, "David Velasco Garcia" <notifications@github.com>
wrote:

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

Siotma, 2017-10-25:
Veo que en líneas generales estamos todos de acuerdo. Comentarios:

@davidvelascogarcia dijo:
> Para encender la fuente, como comentas, en caso de que no arranque a la primera, desconectar el puente y volverlo a poner, y funciona sin problema.

Hurra, hemos conseguido encenderla!

@davidvelascogarcia dijo:
>  invirtiendo el orden de encendido, no da ningún problema, me refiero, a encender primero el extrusor, y posteriormente la cama, habiendo esperado al menos que el extrusor alcance los 45-50ºC.
Es un tanto curioso, que únicamente por encender uno antes que el otro salte o no.

Me alegro de que hayais encontrado esta situación. Desde mi punto de vista no es en absoluto curioso, sino que puede explicarse con el mismo motivo por el que yo identifiqué que la fuente se apaga súbitamente cuando pides calentar. Debe tener algún tipo de protección contra picos de corriente, o si no, un apagado automático cuando detecta que no es capaz de dar la tensión nominal (ie detección de cortocircuito). Teniendo en cuenta que el extrusor demanda unos 3A y la cama unos 10A, como mínimo; si la fuente arranca en vacío, un pico súbito de 0->10A le puede ser más difícil de realizar que si es de 3->13A.

Por eso yo tengo fe en que al usar resistencias de carga que demanden una cantidad notable de corriente, estos escalones desde vacío se eliminen y funcione siempre, aunque según dijo @JorFru:

> 10Ohm en 12V1; 10Ohm en 12V2; 4.7Ohm en 5V
Como diferencia no hemos instalado la disquetera, aunque la carga resistiva era mayor que la de Manu.
Pues bien, no hemos notado ninguna mejoría respecto a que el ventilador gire cuando se lo pides, ni tampoco a la fiesta que se monta el relé.

No parece que las resistencias eliminen el problema.

@JorFru dijo:
> El contactor del relé tiene un muelle que fuerza a la posición abierta el relé, desconecta la cama y la fuente se vuelve a encender pensndo que el peligro ha pasado.

Eso mismo pienso yo. Al encenderse el peligro regresa y entra en bucle.

@JorFru dijo:
> Sugiero instalar un interruptor nuevo qu puentee el cable verde y sirva para encender la fuente fácilmente. El interruptor que corta la alimentación AC se puede quedar siempre activado por comdidad o se puede desactivar cada vez, pero anotando el "modus operandi" para los no informados.

Yo también había pensado en colocar un nuevo interruptor. En mi opinión el que ya hay se puede dejar encendido y tapado con una pieza de plástico. En caso de emergencia se tira del cable y listo.
También colocaría un par de leds de estado para simplificar su uso si confirmamos la función de los cables violeta y gris:
- Led "Ready" rojo de baja luminosidad conectado al cable violeta del [conector ATX](https://es.wikipedia.org/wiki/ATX), que indicaría que la fuente está preparada para encenderse.
- Lez "ON" verde de alta luminosidad conectado al cable gris del [conector ATX](https://es.wikipedia.org/wiki/ATX), que indicaría que la fuente está funcionando correctamente y las tensiones están en rango.

@JorFru dijo:
> es muy recomendable instalar un diodo en serie con la cama.

En serie me parece raro, ya que debería admitir más de 10A y un diodo de 10A es muy gordo y se calienta con unos `10A * 0,7V = 7W 😨` . Imagino que te refieres a un diodo en antiparalelo para que descargue la cama al apagarse. Sin embargo, es posible que el relé ya disponga de un diodo de este tipo, ya que los relés suelen tener diodos para evitar chispazos cuando conectan y desconectan motores u otras cargas inductivas.

Siotma, 2017-10-25:
En mi opinión, la idea del interruptor en el cable verde unida a la bobina en serie con la cama más diodo en antiparalelo son nuestra mejor baza. Aunque me gustaría prescindir de la bobina en serie, no sé si vamos a poder prescindir de ella...

David-Estevez, 2017-10-25:
Pregunta tonta... la carga inductiva que hace saltar la fuente es la cama o la bobina del relé? el relé tiene actualmente algún diodo de flyback?

Siotma, 2017-10-26:
A eso me refiero con diodo en antiparalelo. Es cierto que el relé también es una carga inductiva, aunque está activado por un mosfet así que la fuente no lo tan directamente como la cama. Aun así, revisaremos ambas cosas.

JorFru, 2017-10-26:
Esto dice Javier de Staticboards

"@JorFru el diodo hace que la carga electrica tenga un camino de retorno y
no salga de la cama caliente
se queda atrapada dentro de la cama caliente hasta que desaparece."

Con tranquilidad asimilaré estas palabras.

On Oct 26, 2017 20:04, "Manu" <notifications@github.com> wrote:

A eso me refiero con diodo en antiparalelo. Es cierto que el relé también
es una carga inductiva, aunque está activado por un mosfet así que la
fuente no lo tan directamente como la cama. Aun así, revisaremos ambas
cosas.

—
You are receiving this because you were mentioned.

Reply to this email directly, view it on GitHub
<https://github.com/asrob-uc3m/impresoras-asrob/issues/33#issuecomment-339749950>,
or mute the thread
<https://github.com/notifications/unsubscribe-auth/AKgbgMCnrnRZaw06rBW0MGVD7S3pO_9Dks5swMnKgaJpZM4P4VgO>
.

Siotma, 2017-10-29:
Eso me suena a diodo en antiparalelo.

jgvictores, 2017-10-29:
Sólo viendo estas referencias en diagonal...

- https://en.wikipedia.org/wiki/Flyback_diode
- https://en.wikipedia.org/wiki/Antiparallel_(electronics)

...diría que la terminología correcta es la que usa @David-Estevez (flyback). Yo lo conocía como freewheeling, que esa entrada de wikipedia pone como sinónimo. La intención y el efecto será parecido, sólo que antiparalelo tiene más sentido con algo que tiene polaridad (p.ej. un transistor), y un poco menos en una carga inductiva tipo bobina.

Siotma, 2017-10-29:
Comprendo, y coincido contigo @jgvictores 👍

Al final, todos nos referíamos a lo mismo, pero es más correcto llamarlo por su nombre ☺️

Siotma, 2017-10-30:
Hoy no hemos conseguido que el relé enganche en toda la mañana.

Eso ha podido ocurrir porque se ha partido una de las patas de una de las resistencias y no hemos podido utilizarla... Además, tampoco tenemos diodos de potencia en el armario, que yo pensaba que sí.

En la próxima sesión se podrán seguir haciendo pruebas, pero cada vez me desmotiva más esta fuente de alimentación ya que está lastrando el uso de Blacky.

En caso de mantenerse esta situación habrá que cambiar otra vez la fuente de alimentación.

Siotma, 2017-11-03:
Ayer por la mañana me pasé por la nave e hice lo siguiente:

1. Quitar el puente de la fuente de alimentación.
2. Encender el interruptor de la fuente de alimentación.
3. Esperar mucho tiempo, al menos 20 minutos.
4. Poner el puente. La fuente arrancó a la primera.
5. Calentar el extrusor.
6. Cuando el extrusor iba por 50 grados, puse a calentar la cama.

La impresora calentó maravillosamente, sin saltar el relé ni una vez:

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

Seguiremos investigando.

Siotma, 2017-11-10:
Ayer en la reunión de Printer One, hice lo siguiente:

1. Quitar el puente de la fuente de alimentación.
2. Encender el interruptor de la fuente de alimentación.
3. Esperar mucho tiempo, al menos 30 minutos.
4. Poner el puente. La fuente arrancó a la primera.
5. Encender el ordenador.
6. Conectar Repetier a la impresora y poner a calentar la cama.

El relé enganchó a la primera ante mi atónita mirada. @javii9 y yo imprimimos una pieza para celebrarlo:

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

Por tanto, la teoría de que la fuente necesita estar encendida largo tiempo para "prepararse", "cargar condensadores", "inicializarse", o lo que sea, cobra mucha fuerza.

Así pues, @javii9 y yo hemos hecho un poco de bricolaje a la fuente con intención de que este proceso sea más sencillo para el usuario:

1. Hemos soldado un interruptor entre el cable verde y negro.
2. Hemos soldado unos leds (con sus resistencias de 680ohm):
- Led azul al cable violeta (5Vsb). Este led se enciende mientras la fuente esté enchufada y con el interruptor principal encendido. Tarda unos segundos en encenderse.
- Led verde al cable gris (Power Ok). Este led se enciende cuando la fuente está en marcha.

La idea es que la fuente quede finalmente con el interruptor principal permanentemente encendido y con una pieza de plástico evitando que nadie lo toque. El interruptor del cable verde puesto ayer, estará montado de forma firme en la fuente para que cualquiera que lo vea entienda que es ese el que debe usarse. Además, los leds darán en todo momento feedback del estado de la fuente, lo cual teniendo en cuenta los problemas que nos ha dado, sería muy útil.

Merece la pena decir que no es buena idea soldar los leds porque se estropean con el calor, así que habrá que crimparlos en un futuro si los queremos dejar puestos.

Al irnos, por precaución, ayer dejamos ambos interruptores apagados, de modo que para encender la fuente el próximo día habría que encender primero el general y un rato después el nuevo. Si la próxima sesión somos capaces de replicar el proceso de encendido, haremos permanentes los cambios.

Y ahora, unas fotitos:

Interruptor apagado: modo ready con led azul encendido.

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

Interruptor encendido: modo on con ambos led encendidos.

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

JorFru, 2017-11-13:
Genial trabajo.
Muy buena documentación

Siotma, 2017-11-13:
En la reunión de hoy, ha sido totalmente imposible que enganche el relé, así que seguimos sin saber cómo usar la fuente. Menuda decepción, a este paso, tendremos que desechar esta y utilizar otra con menos potencia...

Siotma, 2017-11-16:
En la reunión de ayer, tras varios intentos, el relé enganchó y se imprimieron unos soportes para filamento para Dédalo.

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

Siotma, 2017-11-23:
Ayer, sustituimos la fuente de alimentación por una distinta que había en el armario, con las siguientes características:

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

Thread 34 (2017-10-17):

Smooth con baño de acetona.

carlosmgomezj, 2017-10-17:
En esta sección se testeará con diferentes métodos de realizar el baño de acetona con las piezas de abs.
Principalmente se usará el suavizado por medio del contacto del vapor de acetona en vez de contacto directo con ésta.

carlosmgomezj, 2017-10-17:
En la primera sesión se ha usado un bote de conservas normal de cristal como contenedor para el baño, hay que tener cuidado al ser la base convexa de fijar bien la base a la que se colocará la pieza.
Este método ha consistido en:
1: Rellenar el fondo del bote a una altura de unos 5mm con Acetona industrial líquida.
2: Colocación de una base metálica para aislar la pieza del contacto directo.
3: Poner la pieza
4: Tapar el botte.
5: Esperar....y esperar.

Durante el proceso se ha observado que el vapor de acetona ataca de manera mucho más significante la mitad inferior de la pieza, por lo que se ha dado la vuelta para igualar resultados. Pasado un tiempo se cayó accidentalmente la pieza dentro de la acetona, convirtiéndolo en un verdadero "baño de acetona", se ha sacado rápidamente la pieza y dejado secar.
La suerte ha hecho que el Link (pieza en ABS) haya quedado al límite en lo que a observabilidad de detalles se refiere.

En la próxima sesión se probará a meter la pieza directamente en acetona en vez de esperar tanto tiempo.
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

carlosmgomezj, 2017-10-17:
ERROR!!

Despues de que @diegodevigo  imprimiera un par de piezas diseñadas por él mismo asemejando a dos "LEGOS" que no encajaban para nada, se ha intentado hacer un  suavizado con acetona metiéndo la pieza directamente y luego sacarla para el secado.

No hay ningún tipo de control fino con éste método y ha ocurrido además el problema de que la acetona se ha quedado atascada en algunos huecos interiores, derritiendo todo el ABS a su paso.

El resultado final ha  sido pésimo y se ha confirmado que tiene que ser siempre que se pueda con vapor.

carlosmgomezj, 2017-10-17:
Hoy se ha aplicado un nuevo método, siguiendo las instrucciones de este video: [Smooth ABS](https://www.youtube.com/watch?v=6xFUNFG-UKE)
Consiste en que la acetona esté en la parte de arriba de la pieza, por lo que el vapor ( más pesado que el aire) bajará hasta abajo sin salir gracias a una capa de agua en la base.

Se ha realizado con el mismo bote de vidrio de las pruebas anteriores colocando papel de cocina en la parte inferior y dándole la vuelta. Después de aproximadamente dos horas de contacto con el vapor ( no estaba herméticamente cerrado) el resultado ha sido mejor del esperado.

Una cosa a tener en cuenta es que el proceso termina bastante después del paso de sacarlo del bote, con la precaución importante de no tocar la pieza ya que en ese momento es fácilmente moldeable o sensible a huellas, etc.

En la siguiente sesión se intentará hacer una base parecida a la del video con un ventilador que haga que sea más uniforme el suavizado y más rápido.

En las siguientes fotos se ve como el baño de acetona ha ayudado además a disimular la cicatriz de unión entre las dos mitades del Pokémon:

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

Siotma, 2018-04-21:
Cerrando por inactividad. Si se retoman las actividades con acetona se podrá reabrir.

Closed 2018-04-21.

Thread 35 (2017-10-26):

Problemas de potencia en Hija Resurrection

Siotma, 2017-10-26:
Creemos que la solución a #26 pasa por aumentar la potencia de alimentación de Hija Resurrection. Vistas las dificultades encontradas en #33 con la nueva fuente de alimentación de Blacky, y teniendo en cuenta que la fuente hermana de esta hace ruido electrónico y no nos podemos fiar de ella para la impresora, propongo, aunque sea de forma temporal:

# Instalar una segunda fuente de alimentación en Hija Resurrection.

Mi idea es que la nueva fuente únicamente alimente el secundario del relé para calentar la cama cuando la Ramps lo requiera. De esta manera se libera a la fuente actual de más de 100W, por lo que el resultado debería ser un calentamiento más ágil y la desaparición de errores de Thermal Runaway.

Para esta actuación se puede utilizar una fuente de alimentación que @Morgloz dejó casi preparada para Blacky en su día. Está en el armario en la balda inferior a la izquierda. Creo que esta issue se puede resolver en una sola sesión y ganaríamos una impresora que funciona y está calibrada, pero que ahora mismo no estamos utilizando en absoluto por los problemas de alimentación que tiene.

Siotma, 2017-11-13:
En la reunión de hoy, se ha instalado una nueva fuente de alimentación en Hija Resurrection.

Se trata de una fuente de alimentación con 8A para el canal 12V1 y 14A para el canal 12V2.

He conectado el canal 12V2 a la cama caliente de Hija Resurrecion utilizando bananas de 3,5mm disponibles en el armario.

La fuente antigua de Hija Resurrection aún alimenta el resto de elementos (incluido el relé), por tanto ahora hay dos fuentes en Hija Resurrection.

La nueva fuente de alimentación carece de interruptor y por tanto para encenderla es necesario poner el puente.

Además, se ha modificado la configuración de Marlin vía 83d843e02ac85237739cad3ec4fa42780e4ceed3 para aumentar la frecuencia de refresco de la temperatura de la cama.

Se han realizado dos pruebas de impresión, la primera de un cubo, satisfactoria:

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

La segunda prueba de impresión de una pieza de calibración, ha sido insatisfactoria por desplazamiento del eje Y:

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

Sin embargo, en ninguna de las dos ocasiones ha saltado el error de Thermal Runaway, y a la luz de las curvas de temperatura parece que también se ha corregido la falta de potencia:

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

Únicamente es notable un escalón en las medidas de temperatura en el momento en que comienza la impresión. Se me ha ocurrido que el momento en que empiezan a moverse los motores, haga caer la potencia de la fuente antigua, y que eso tumbe las referencias de los ADCs. Esto además concuerda con el desplazamiento del eje Y...

Seguiremos haciendo pruebas. Aunque, al menos parece, que hemos cerrado #26

Siotma, 2017-11-13:
Aunque esta impresora continúa teniendo la etiqueta "NO FUNCIONA", con los resultados de hoy estaríamos cerca de tenerla operativa.

Lo que necesita ahora es, sin duda, **pruebas de impresión**. Así que... AL TURRÓN!

Siotma, 2017-11-16:
En la reunión de ayer se realizaron nuevas pruebas de impresión: un cubo y una polea dentada, ambas satisfactorias.

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

Además, adjunto una imagen de la configuración actual de la impresora con las dos fuentes de alimentación. Ayer utilizamos un carrete vacío que llevé para enrollar un poco de filamento amarillo que tiene bastante mejor calidad de impresión que el negro que había antes.

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

Siotma, 2017-11-29:
En la reunión de ayer, se comenzó el proceso para soldar conectores a la nueva fuente de alimentación para dejar a Hija Resurrection con una sola de ellas. Sin embargo, no dio tiempo a completar el proceso por lo que actualmente se encuentra sin fuente (están en el armario, en la balda de Printer One).

Siotma, 2017-11-29:
Asimismo, se realizó una revisión minuciosa de los sensores de temperatura que incluyó un re-soldado, y re-termorretractilado del termistor del extrusor, y la colocación de una pieza de cartón bajo la cama caliente para disminuir la disipación. El sensor de temperatura de la cama caliente pareció estar en buen estado y por tanto no fue necesario realizar ninguna operación sobre él.

Relacionado con esto, los cables de ambos sensores de temperatura estaban realmente tirantes y puede que ello fuera la causa de los problemas de lectura de temperatura. Se descubrió que estos cables se encontraban enrollados adrede para reducir su longitud, aunque tal vez demasiado. Se ha dado un poco más de juego a los cables de ambos sensores para reducir su tensión y las posibilidades de desconexión fortuita y/o rotura.

Siotma, 2017-12-02:
Ante la posibilidad de necesitar las impresoras para formar nuevos operadores la próxima semana, ayer me acerqué un rato a la nave para finalizar la instalación de la nueva fuente de alimentación de Hija Resurrection y así dejarla operativa. Sin embargo, aunque parecía sencillo en un principio no resultó serlo tanto:

- Tras conectorizar la fuente de alimentación y conectarla a la impresora, realicé una prueba de calentamiento insatisfactoria: el calentador del extrusor no funcionaba, como ya pasó en otra ocasión. Dado que pretendemos que la impresora sea fiable y aprovechando que teníamos otro calentador nuevecito en el armario, lo cambié.

- Para cambiarlo, me tocó desmontar el extrusor puesto que el prisionero que afianza el calentador era inaccesible ya que estaba orientado hacia arriba. Finalmente, monté el extrusor de nuevo, dejando el prisionero orientado hacia abajo para facilitar su accesibilidad en un futuro.

- Realicé una nueva prueba de calentamiento de cama y extrusor, satisfactoria, aunque el extrusor calentaba muy lentamente.

- Lo más preocupante vino cuando intenté mover los motores: al moverse, provocan una caída de potencia considerable en el resto de la impresora, y mientras están alimentados, la fuente de alimentación emite un ruido poco recomendable. Incluso, si se insiste mucho con el movimiento, la fuente acaba apagándose, imagino que por seguridad.

Con la información de los dos últimos puntos, me he dado cuenta de que nunca hemos evaluado la calidad de la electrónica de esta impresora: calidad de la RAMPS, calidad de los MOSFET  y calidad de los pololu, principalmente. Sospecho que unos MOSFET de baja calidad pueden provocar un calentamiento lento e ineficiente del extrusor y que si alguno, de los pololu estuviera defectuoso podría interferir en el funcionamiento del resto de los componentes.

Dado que tenemos en el armario otra RAMPS nuevecita de BQ (tiene 5 pololu y hasta pantalla LCD), he pensado que podemos evaluar la posibilidad de sustituir la actual por esa y ver si cambia el comportamiento de la impresora. Tengo confianza en que el cambio mejore globalmente el funcionamiento de nuestra querida Hija Resurrection. En dicho caso, además, podríamos dejar preparada la impresora para utilizarla con pantalla LCD y liberar un PC para Dédalo, por ejemplo.

Siotma, 2017-12-06:
En la reunión de ayer comprobamos que el problema de potencia no estaba relacionado con la RAMPS sino con la fuente de alimentación: la tensión cae enormemente cuando se enciende la cama caliente y ello perjudica el funcionamiento de los drivers paso a paso provocando fallos en el movimiento.

Se cambió la fuente por otra igual pero con mejores valores de tensión de salida. Asimismo se observó que el funcionamiento de la fuente mejoraba añadiendo una resistencia de 10Ohm al canal de 5V, por lo que se ha dejado conectada internamente.

Ahora mismo, Hija Resurrection dispone de una fuente de alimentación operativa y está lista para realizar pruebas de impresión.

Siotma, 2017-12-14:
Hoy, he realizado un agujero en el bloque calentador de Hija Resurrection para fijar el termistor con un tornillo y prescindir del Kapton. Ha quedado de maravilla:

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

Además, @danielo16 ha realizado varias pruebas de impresión satisfactorias. Los problemas de potencia han desaparecido tal y como muestra la siguiente curva de calentamiento. Se puede comprobar cómo la curva de calentamiento del extrusor es mucho más estable al estar el termistor bien sujeto.

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

Hija Resurrection ha vuelto a la vida, valga la redundancia 🤣

Issue cerrada

JorFru, 2017-12-15:
Mera curiosidad,
Me imagino que el agujero lo has hecho con las nuevas herramientas
rotativas de ASROB
Pero cómo has hecho la rosca? Tenemos machos de rosca y yo no lo sabía?

El 14 de diciembre de 2017, 19:53, Manuel Peña Fernández <
notifications@github.com> escribió:

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

--
*Jorge Frutos de Mingo*

Ingeniería Electrónica Industrial y Automática.
Asociación de estudiantes UC3Music.
Universidad Carlos III de Madrid.

Siotma, 2017-12-15:
El agujero con la rosca ya estaba hecho. Curiosamente este tipo de agujero en todas las impresoras que yo he visto viene roscado. Yo hice uno un poco más abajo para introducir el termistor. Y ese no necesita rosca.

JorFru, 2017-12-16:
Todo entendido!
Gracias Manu

2017-12-15 19:47 GMT+01:00 Manuel Peña Fernández <notifications@github.com>:

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

--
*Jorge Frutos de Mingo*

Ingeniería Electrónica Industrial y Automática.
Asociación de estudiantes UC3Music.
Universidad Carlos III de Madrid.

Closed 2017-12-14.

Thread 36 (2017-11-13):

Mejorar la calidad de nuestras impresiones

JorFru, 2017-11-13:
Creo que mejoraríamos notablemente nuestra calidad de impresión si cambiamos a plásticos PLA. Opino que el ABS está anticuado y además es muy difícil de imprimir.

Printer One lleva muchos meses trabajando en preparar las impresoras y ajustarlas para imprimir con calidad. Creo que hemos llegado al momento en el que el material nos limita para seguir mejorando.

Quizás @David-Estevez o @jgvictores nos pueden ayudar a conseguirlos a través del departamento.
¿Hacemos votación para decidir si continuamos con esta idea? ¿Votación del color?

David-Estevez, 2017-11-13:
Si consideráis que no se puede imprimir con suficiente calidad usando ABS, veo razonable pedir PLA. Se puede buscar incluso algún distribuidor de calidad y barato, como el plástico de BQ que vendían en PCComponentes, a ~15€/kg.

Links de ejemplo:
* https://www.pccomponentes.com/bq-bobina-de-filamento-pla-1-75-mm-azul-topacio
* https://www.pccomponentes.com/bq-bobina-de-filamento-pla-1-75-mm-violeta
* https://www.pccomponentes.com/bq-pla-premium-1-75-mm-amarillo-1kg-fabricado-en-espa-a

¿Qué opinas, @jgvictores ?

Siotma, 2017-11-16:
A mi me gusta mucho esta idea. Ayer @diegotrap nos ofreció traer recortes de PLA la próxima semana (Gracias Diego!). Podemos empezar por ahí, ya que no sabemos si los extrusores de las impresoras estarían preparados para PLA...

diegotrap, 2017-11-16:
Llevaré unos restos de bobinas que tengo por aquí, espero que no se me olvide.

Siotma, 2018-01-09:
Hoy, hemos colocado una bobina [Smartfil PLA Cobalt](http://smartmaterials3d.com/es/tienda-smart/51-smartfil-pla-cobalt.html#/tamano-m_750g/diametro-1_75_mm_0_03) adquirida en la última convocatoria de asociaciones en Blacky.

De momento hemos hecho una primera prueba con una pieza para la pantalla de Hija Resurrection, con muy buen resultado:

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

Como digo, se trata solo de una prueba:
- Hemos cambiado las temperaturas de extrusión a 210ºC extrusor y 50ºC cama caliente.
- Queda pendiente generar un perfil más ajustado, sobre todo para quitarle el Brim.

El resultado de hoy promete grandes impresiones con PLA en el futuro!

daavm, 2018-02-09:
La semana pasada probamos a usar el filamento flexible de 3mm que llevó @David-Estevez en Dédalo. No tuvimos que cambiar mucho, y las pruebas que hicimos (un cohete) salieron bastante bien. Subiré fotos cuando las tenga ^^

GioSunrider, 2018-09-13:
Esta issue me parece la mas indicada para plantear un nuevo metodo este año, idea de @Siotma. Se van a proponer retos semanales de impresion para asi mejorar la calidad de nuestras impresiones. De esta amnera en nuestra casa imprimiremos piezas necesarias para la implementacion de piezas en las impresoras. Todo se debe a que la calidad de las impresiones en nuestras casa es muy superior a la de la nave, y asi no estamos de brazos cruzados esperando a las impresiones terminesn, asi que doy por inaugurado el label de RETOS DE IMPRESION.

Siotma, 2018-09-14:
Acabo de crear un Project para gestionar los retos: https://github.com/asrob-uc3m/impresoras-asrob/projects/3

 También está disponible el primer reto en: https://github.com/asrob-uc3m/impresoras-asrob/issues/84

Siotma, 2018-11-09:
Hoy he subido perfiles para [Blacky](https://github.com/asrob-uc3m/impresoras-asrob/commit/5345085ce4c570454549ff38569d3621a9ac8971) e [Hija Resurrection](https://github.com/asrob-uc3m/impresoras-asrob/commit/b976956694d1994c347750beb9f09c914ec9e575) diseñados para Slic3r 1.3.0

Adjunto resultados de cada uno:

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

Thread 37 (2017-11-28):

Formacion de Operador

GioSunrider, 2017-11-28:
Hola, me gustaria constatar como operador de las impresoras, he hablado hoy con @Siotma del tema. En la actualidad formo parte del grupo de trabajo y con la formacion de Manu, he impreso alguna que otra pieza, mientras poniamos a punto a dedalo. Adjunto foto de tres de las piezas.

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

GioSunrider, 2017-11-28:
Vale, la he liado, me he equivocado de repositorio. cierro y la reabro en el otro lado.

Closed 2017-11-28.

Thread 38 (2017-11-29):

Problema de generación de nuevos perfiles de impresión

davidvelascogarcia, 2017-11-29:
Se ha detectado en los ordenadores de las impresoras Blacky e Hija Resurrection, que no permite la generación y almacenamiento de nuevos perfiles de impresión, tanto en los perfiles de invitado como en el perfil de administrador Asrob. Permite rellenar los campos y exportar el perfil, sin embargo no su almacenamiento.

davidvelascogarcia, 2017-11-29:
En la sesión de ayer @daavm , detecto que la ruta de almacenamiento, no era correcta y ni siquiera existía.

daavm, 2017-12-07:
En la última reunión este problema quedó resuelto. @Siotma y yo nos pusimos con ello y, aunque no descubrimos el fallo en concreto, al eliminar la carpeta .Slic3r de '/home/asrob' y forzar al propio Slic3r a crear esa carpeta de configuración de nuevo, se arregló el problema. En resumen, si vuelve a pasar, con reconfigurar Slic3r debería solucionarse.

Closed 2017-12-07.

Thread 39 (2017-11-30):

Incluir Piezas en los Archivos de Configuracion de las Impresoras

GioSunrider, 2017-11-30:
Como he propuesto en [#31](https://github.com/asrob-uc3m/impresoras-asrob/issues/31) creo que seria necesario incluir en el `master` de cada impreso las piezas de cada una. En Dedalo ya hay una carpeta `parts` dedicada a ello.
La finalidad de esto no es otra que en caso de rotura, mal-funcionamiento o aunque improbable perdida de alguna pieza, sepamos con exactitud la pieza que se encontraba. De esta manera, ademas de ser mas fácil encontrar las piezas, se evitan errores de cambio de piezas, facilitando así la reparación de las mismas impresoras.

Siotma, 2017-12-01:
A mi me parece muy buena idea. La mayor dificultad sería conocer qué piezas exactamente llevaban las impresoras antes de iniciarse Printer One. Sin embargo, todas las piezas que hemos instalado desde entonces sí que sería muy recomendable guardarlas 👍

En caso de que sean piezas sacadas de Thingiverse, yo también dejaría un enlace de la fuente de cada una (por ejemplo, en el [Readme](https://github.com/asrob-uc3m/impresoras-asrob/blob/master/Dedalo/Parts/Readme.md)) por si en un futuro se quisieran comprobar mejoras o nuevas versiones.

GioSunrider, 2017-12-03:
Pues solo queda manos a la obra. Creo que lo más difícil es como dices, conocer las piezas que se encuentran instaladas, pero bueno, poco a poco, la única que podríamos "completar" sería Dédalo, el resto abra que apañarselas.

David-Estevez, 2017-12-04:
De Dédalo tengo yo por ahí guardados un par de STLs de las piezas que yo personalicé. Son sólo modificaciones estéticas, pero puedo subirlas también si queréis tener todas las piezas originales.

GioSunrider, 2017-12-04:
Estaría bien, sobre todo por ver cuáles hemos cambiado y cuáles no, y dejar las que ahora mismo están instaladas. Sobretodo por si por ejemplo se parte una rueda dentada o algo, aunque improbable puede pasar.

davidvelascogarcia, 2017-12-06:
@GioSunrider Subo al repo el STL de las bed leveling, adunto [link](https://github.com/asrob-uc3m/impresoras-asrob/blob/master/Dedalo/Parts/Bed%20leveling.stl).

GioSunrider, 2017-12-06:
Perfecto, @Siotma ¿puedes también subir la pieza de sujeción del extrusor de Dedalo? Esa que imprimiste en casa.

David-Estevez, 2017-12-06:
Subidas las partes de Dédalo modificadas por mi (https://github.com/asrob-uc3m/impresoras-asrob/commit/d79c3a6ed4321783ab0c38bb067298bb184c71cd).

También he encontrado este zip, que imagino que serán las piezas de la i2 tal cual las descargué para imprimirlas:
[prusajr-PrusaMendel-d2fde50.zip](https://github.com/asrob-uc3m/impresoras-asrob/files/1536801/prusajr-PrusaMendel-d2fde50.zip)

Y un Configuration.h, que no puedo asegurar que fuese la última versión que usé:
[Configuration.h.zip](https://github.com/asrob-uc3m/impresoras-asrob/files/1536811/Configuration.h.zip)

Y como bonus, el gcode de la marcha imperial!
[imperial.gcode.zip](https://github.com/asrob-uc3m/impresoras-asrob/files/1536812/imperial.gcode.zip)

GioSunrider, 2017-12-06:
El Configuración.h dejaría el actual, ya que seguro que le tenemos actualizado y no da problemas por el momento y el resto genial, sobre todo el bonus track ajajajaja

David-Estevez, 2017-12-06:
Totalmente de acuerdo, si la versión que hay ahora funciona es mejor que se quede esa.

Siotma, 2017-12-09:
Del hilo de #31 he sacado las siguientes piezas (igual me he dejado alguna más)

- Carro X: https://github.com/asrob-uc3m/impresoras-asrob/issues/31#issuecomment-334395480 . Tener en cuenta [esto](https://github.com/asrob-uc3m/impresoras-asrob/issues/31#issuecomment-336418170).

- Extrusor: https://github.com/asrob-uc3m/impresoras-asrob/issues/31#issuecomment-342093484 .

- Soporte de filamento: https://github.com/asrob-uc3m/impresoras-asrob/issues/31#issuecomment-345018044 .

- Ruedas de nivelación de la cama: https://github.com/asrob-uc3m/impresoras-asrob/issues/31#issuecomment-347659805 (no sé de dónde los sacó @davidvelascogarcia, le invoco para que la añada ).

- Ventilador de capa: https://github.com/asrob-uc3m/impresoras-asrob/issues/31#issuecomment-346937941 (no sé de dónde lo sacó @daavm, le invoco para que la añada ).

He subido las tres primeras via 318703f53975232296e441800cad2fe794a34a0a .

Readme actualizado via 7072c2cc6ab2d733ed316ab6299c90debbba9c4e

dmarcosm, 2018-09-19:
Todas las impresoras tienen ya su carpeta de piezas con las piezas que hemos sabido reconocer, por lo que procedo a cerrar esta issue.

Closed 2018-09-19.

Thread 40 (2017-12-07):

LCD para las Impresoras

dmarcosm, 2017-12-07:
En la última reunión, decidimos ponerle una pantalla de BQ que teníamos en el armario. Se editó el Configuration.h (pendiente subir el actualizado) y se subió el nuevo firmware.

- [x] Actualizar el Configuration.h en GitHub.

Todo funcionó bien, pero a la hora de apagar el ordenador que controla a Blacky, la pantalla sigue encendida, ya que se alimenta a través del USB de la torre del ordenador. Trasteé un poco en la BIOS, pero no conseguí hacer que los puertos USB no reciban alimentación una vez el ordenador está apagado. Si alguien tiene idea de como evitar esto, que lo diga. La pantalla se queda encendida si no solucionamos eso, por lo que ahora mismo está desconectada y guardada en la caja blanca de Printer One.

- [x] Configurar el apagado de los USB de los PC.

- [x] LCD en Blacky
- [x] LCD en Hija
- [x] LCD en Dedalo

GioSunrider, 2017-12-14:
Para la proxima sesion imprimir el recubrimiento del LCD que ira en Hija Resurrection, en [este enlace](https://www.thingiverse.com/thing:275352/#files) se pueden encontrar.

GioSunrider, 2017-12-15:
Se imprimió y se coloco el LCD de Blacky. Adjunto fotos del soporte, que a su vez queda añadido a la carpeta de `parts` de Blacky, y del LCD instalado.
Admas se probo su funcionamiento y no da ningun problema.

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

daavm, 2017-12-15:
A la hora de intentar solucionar el tema de la alimentación de la placa cuando el ordenador está apagado, decidimos optar por modificar los cables de las impresoras para que fuesen data-only.
Para hacer esto, no hay más que abrir el cable, y sabiendo que de los 4 cables que tiene dentro (blanco, negro, verde y rojo?), el rojo es VCC, procedimos a cortar el rojo, cubrir los 2 trozos que quedan tras cortar con termoretractil, y cerrar el cable con cinta.
Tras hacer una prueba y ver que funcionaba, lo hicimos para las 3 impresoras.
Sin embargo, en la impresora hija no funcionó, imaginamos que por la placa, así que la propuesta fue que si no conseguimos que funcione, cambiar la placa por la nueva de BQ que hay en el armario, ya que tenemos una pantalla que queríamos poner en hija. No sin antes probar que la pantalla efectivamente se queda encendida al apagar el ordenador.

Siotma, 2017-12-15:
Respecto a la colocación de la pantalla sobre el marco de la impresora, yo puedo aportar que en mi experiencia **es un mal sitio**: si se interactúa con la pantalla durante la impresión es muy fácil hacer oscilar el marco de metacrilato, y ello puede hacer que el extrusor se mueva (suba o baje), dejando imperfecciones en la pieza. Este tipo de montajes son más apropiados para estructuras más robustas como la de Hija Resurrection o Dédalo. El problema de oscilación del marco es inherente al modelo de impresora, yo hace poco puse [estas piezas](https://www.thingiverse.com/thing:603953) a la mía para afianzar el marco.

Respecto al problema de alimentación de la RAMPS de Hija Resurrection por USB, habría que hacer pruebas pero a mi me pasó algo muy parecido y el problema era de la MEGA. No funcionaba correctamente el pin de Vin y por tanto los 12V no la encendían. Creo que antes de cambiar la placa deberíamos revisar con el multímetro tensiones en algunos puntos: http://www.reprap.org/wiki/RAMPS_1.4/es#D1.2C_D2_-_Diodos

Siotma, 2017-12-24:
En la reunión del día 21, pusimos a Blacky a imprimir desde la SD, obteniendo muy buenos resultados:

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

Ahora mismo, Blacky es totalmente funcional mediante la LCD, por tanto, urge, actualizar el [manual de usuario](https://github.com/asrob-uc3m/impresoras-user-manual-i3), ver la issue correpondiente: https://github.com/asrob-uc3m/impresoras-user-manual-i3/issues/4

daavm, 2017-12-27:
En la sesión del pasado jueves instalamos también la pantalla de Hija, en este caso una full graphics. Actualizamos el firmware y los nuevos archivos de configuración quedaron subidos al repo. El próximo día añado fotos :D

daavm, 2017-12-28:
Añado foto de Hija con pantalla :)

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

Siotma, 2018-01-04:
Alguna noticia del [LCD de Dédalo](https://github.com/asrob-uc3m/impresoras-asrob/issues/31#issuecomment-344561347) @David-Estevez ?

David-Estevez, 2018-01-04:
Pues algo me dice que la traerán los Reyes Magos....

David-Estevez, 2018-01-08:
Ya tenéis vuestro regalo de Reyes en el armario :wink:

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

Siotma, 2018-01-09:
> Ya tenéis vuestro regalo de Reyes en el armario 😉

Muchas gracias!

Hemos venido entusiasmados a la reunión para poder probarla, pero nos hemos dado cuenta enseguida de que no vamos a poder usarla con la Sanguinololu. En realidad, no sabemos si la pantalla es compatible o no, pero el adaptador, es decir, la pieza pequeña blanca señalada en la siguiente imagen, es para RAMPS. Además, en la pegatina del paquete de la pantalla también se indica que es una kit para RAMPS.

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

La dejamos donde estaba, no la hemos llegado a abrir. Seguramente puedas poner una reclamación al vendedor para que te envíe el adaptador correcto. Algo como esto:

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

Con un adaptador adecuado, tal vez esta pantalla funcione. Nos vas contando @David-Estevez .

David-Estevez, 2018-01-10:
Disputa abierta con el vendedor, le he pedido que me envíe el adaptador correcto o que me devuelva 3€ para que me pueda comprar otro a otro vendedor. Os mantengo informados de lo que me vaya diciendo.

Siotma, 2018-01-11:
En la última reunión, se imprimieron [estas piezas](https://www.thingiverse.com/thing:638833/#files) para hacerle una carcasa a la pantalla de Hija Resurrection.

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

Además, se practicó un agujero en la parte inferior de la carcasa para dejar la pantalla atornillada sobre la impresora:

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

David-Estevez, 2018-01-11:
El vendedor aceptó el reembolsarme 3€, con los que he comprado otro adaptador distinto en Aliexpress. En lo que llega os dejo la placa otra vez en el armario, por si se la queréis poner temporalmente a otra impresora o algo.

GioSunrider, 2018-02-20:
Issue que queda en stand-by, debido a que la pobre placa de dedalo cuando se le conecto la pantalla, el adaptador tenia los pines desalineados e hizo una mala conexion y salio ardiendo como se refleja en [#46](https://github.com/asrob-uc3m/impresoras-asrob/issues/46). Cuando evaluemos el problema se vera que hacer en esta issue.

GioSunrider, 2018-04-26:
Hoy hemos montado la placa de Dédalo (#48) y hemos conectado la pantalla que llevaba 2 meses en el armario. ~10 asrobcoins para @dmarcosm

Siotma, 2018-10-14:
Piezas LCD Hija actualizadas via 0363e391158485261eb205cfc239e86b738a5702

Closed 2018-04-26.

Thread 41 (2017-12-09):

Aprovechamiento de los nuevos puntos de luz y puertos Ethernet de la nave

Siotma, 2017-12-09:
Recientemente se ha añadido una instalación nuevecita en la nave, la cual incluye varias torres ancladas al suelo, cada una de ellas con:
- Enchufes de 220V.
- Puertos Ethernet.

Actualmente, las impresoras y los PCs que las controlan están enchufados mediante un árbol de regletas bastante poco robusto. Además, los PCs carecen de internet a no ser que se tire un cable de 20 metros. Se quiere mejorar la actual configuración de los PCs de las impresoras, aprovechando las nuevas posibilidades de la nave, para ello se debe:

- [x] Enchufar cada impresora a un punto de luz independiente cercano.
- [ ] Conectar cada PC a internet a través de un puerto Ethernet cercano.

Siotma, 2017-12-09:
En la última reunión, @jgvictores y yo modificamos la infraestructura de enchufes dejando la siguiente configuración:
- Monitor de Blacky, PC de Blacky, y Blacky, enchufados a un punto de luz **único** mediante una regleta de 4 tomas sin interruptor.
- Monitor de Hija Resurrection, PC de Hija Resurrection, e Hija Resurrection, enchufados a un punto de luz **distinto** mediante una regleta de 3 tomas con interruptor.

El enchufe del que colgaban antes ambas impresoras está libre y disponible para ser utilizado con mucha mayor libertad durante las reuniones.

Siotma, 2017-12-09:
Faltaría solicitar IPs al servicio de informática para poder conectar los PCs. Lo puedes mover tú @jgvictores ?

jgvictores, 2017-12-10:
Sí, me encargaré!

jgvictores, 2017-12-14:
Petición lanzada.

Siotma, 2017-12-14:
Ya disponemos de las IPs. No las pongo aquí por seguridad ¿Verdad @jgvictores?

Hoy, hemos conectado un PC con uno de los cables ethernet del router y hemos configurado la primera IP. Es muy sencillo. Hay que ir a:

`Inicio -> preferences -> network connections -> add -> Ethernet -> create -> ipv4 settings -> manual -> add address.`

Allí escribir: `address = IP asignada`. `Netmask = 255.255.255.0`. `Gateway = 163.117.150.2`

Clic en save y funciona.

Siotma, 2017-12-14:
Faltaría pedir un par de cables Ethernet al departamento. Ya que los que tenemos actualmente se usan para el router, y además, tienen las pestañas rotas por lo que no son muy robustos.

¿ Hace falta poner una issue en actas @David-Estevez @jgvictores ? O se puede gestionar internamente con el departamento...

Siotma, 2017-12-14:
Acaba de llegar @jgvictores con dos cables Ethernet como si fuera Moisés con las tablas de la ley.

Ya se encuentran ambos PCs configurados mediante el perfil Ethernet Connection 2 y conectados a internet correctamente.

Issue cerrada.

Closed 2017-12-14.

Thread 42 (2018-01-10):

Puesta a Punto de Hija

GioSunrider, 2018-01-10:
Visto el buen resultado que nos dio esta misma issue, abrimos una para Hija.
Antes de Navidad, se imprimieron dos árboles de navidad ([ver en issue #40](https://github.com/asrob-uc3m/impresoras-asrob/issues/40)) y comparando el impreso con Blacky y el de Hija se notó un gran cambio de calidad con el de Hija.
Por ello @Siotma ha propuesto una solución, ya que nos comentó el cambio de pasos por milímetro que anteriormente se cambió en Hija.

[EDIT]
Los cambios propuestos son los siguientes:
 - [x] Cambiar la placa, con los mínimos cambios posibles en el Marlin.
 - [x] Imprimir el mismo g-code exacto con Blacky e Hija para comprobar el resultado.
 - [ ] Cambio de la polea de la correa del eje X para que la correa vaya siempre en horizontal.
 - [x] Añadir un [tensor para el eje X](https://www.thingiverse.com/thing:247992).
 - [ ] Añadir un tensor para el eje Y.
 - [x] Ajustar el extrusor, que ahora mismo tiene fugas de plástico.
 - [x] Reducir holguras, si las hay, en la sujección del extrusor al eje X, que pueden ser también la fuente de la baja calidad de las impresiones.
 - [x] En caso de no poder mejorar la calidad de las impresiones, cambiar el extrusor directo actual por uno [tipo geared](https://www.thingiverse.com/thing:512338).
 - [ ] Replantear el cableado.

[EDIT 2]
 - [ ] Cambio de extrusor

Una vez realizado estos cambios y comprobación de validará la puesta a punto de Hija.

Siotma, 2018-01-11:
En realidad se pueden plantear aún más cambios:
- Cambio de la polea de la correa del eje X para que la correa vaya siempre en horizontal.
- Añadir un tensor para el eje X [este](https://www.thingiverse.com/thing:247992) va muy bien.
- Añadir un tensor para el eje Y.
- Ajustar el extrusor, que ahora mismo tiene fugas de plástico.
- Reducir holguras, si las hay, en la sujección del extrusor al eje X, que pueden ser también la fuente de la baja calidad de las impresiones.
- Engrasar.
- En caso de no poder mejorar la calidad de las impresiones, cambiar el extrusor directo actual por uno tipo geared como [este](https://www.thingiverse.com/thing:512338).
- Modificar el cableado que llega al extrusor. Cuando el eje Z sube demasiado, los cables se tensan demasiado y llegan a impedir el movimiento del eje X.
- Yo aún diría más: replantear todo el cableado.

Por cierto, se puede leer más sobre el problema de pasos por mm que comentas en #4

GioSunrider, 2018-01-11:
Me parece más que perfecto. A añadir lista de tareas entonces y manos a la obra.

GioSunrider, 2018-01-11:
Pregunta: respecto al problema de los pasos por mm, si cambiamos la placa por la de BQ, ¿se solucionaria?
P.D. Cambios añadidos al comentario inicial.

Siotma, 2018-01-14:
Posiblemente los Drivers de la placa de BQ acepten un mayor microstepping (mayor resolución) y por tanto sí que se puedan utilizar los números habituales. Esto es una suposición pero lo digo teniendo en cuenta que Blacky utiliza la misma placa y los mismos drivers, por lo que parece factible.

GioSunrider, 2018-01-14:
Yo es que tengo la duda si el problema es de la placa o de los motores, al fin y al cabo, los motores son los uqe se mueven, la placa solo manda "pulsos" no?

Siotma, 2018-01-14:
Eso es totalmente cierto. Para discernir esto, deberíamos probar a mover los motores de Hija desde la placa de Blacky (por ejemplo, con conectar el motor de X o Y y comparar el comportamiento sería suficiente).

GioSunrider, 2018-01-14:
Pues el próximo día investigamos a cerca de ellos, porque es algo que me lleva dando que pensar.

GioSunrider, 2018-01-24:
He venido a imprimir con hija la pieza que partió ayer de dedalo y me la he encontrado con un atasco de PLA curioso, sigue saliendo PLA plateado y no he conseguido desatascarlo, por lo que esta ahora mismo fuera de servicio hasta que lo consigamos arreglar.

Siotma, 2018-01-27:
Me extraña muchísimo que esté atascada con PLA cuando el último día imprimió una pieza de ABS amarillo durante dos horas 😕 .

GioSunrider, 2018-01-27:
Cuando fui a imprimir con ella salió plateado, además de la fuga por la parte de arriba del extrusor.

Siotma, 2018-01-28:
En la reunión del martes 23 comenzamos a imprimir piezas para el tensor del eje X.

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

También se propuso la posibilidad de recablear la impresora utilizando cadenas portacables para darle más robustez al cableado:

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

Para las piezas de la cadeneta, me he basado en [estas piezas](https://www.thingiverse.com/thing:1874802/#files) y he creado una versión parametrizable [aquí](https://github.com/Siotma/developrints/tree/master/Cable_chain_parametric).

Por último, y vistos los problemas del extrusor reportados por @GioSunrider , me ofrecí a donar las piezas necesarias para montar un extrusor geared tipo Jonas. Las llevaré en la próxima reunión.

Siotma, 2018-02-02:
En la reunión de ayer se sustituyó el extrusor MK8 de Hija por este otro tipo Gregs Wade. Aún no funciona porque no dio mucho tiempo a calibrarlo y además se partió un cable del motor, que aún está pendiente de reparar:

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

Se actualizó el Marlin para soportar el nuevo extrusor. Los cambios debidos al extrusor se han actualizado mediante 16e581b25ed1901dbd130e5e137c9286cd2ff612

Además, fue necesario sustituir el carro del eje X para dar compatibilidad a este extrusor, ver c02ba1170be563f307f5c064870bd085740b524f

Las piezas del extrusor y del carro que se han quitado, están guardadas en una bolsa hermética en el armario, dentro de una de las cajas de Printer One.

Por último, he creado un Readme para las piezas de Hija vía 800594e925fdd73a3a910fa833f13106423d8b61

Siotma, 2018-02-12:
En la reunión del pasado jueves, se reparó el cable roto del motor del extrusor y se ajustaron los pasos por mm en fa5c5e1739b1cd279aa2b05e3c58197001cbdaf8

Con la configuración actual, Hija Resurrection es funcional para imprimir como demuestra la siguiente imagen.

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

Siotma, 2018-02-17:
En la última reunión, se sustituyó la pieza de la parte derecha del eje X por [esta otra](https://www.thingiverse.com/thing:247992), que incorpora un tensor. La siguiente imagen muestra el resultado

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

Tras la sustitución se comprobó el correcto funcionamiento del tensor y se procedió a nivelar el ejeX, con resultado correcto. Sin embargo, las últimas pruebas de funcionamiento mostraron un extraño sonido de traqueteo en el movimiento del eje. Analizamos su origen durante la última parte de la reunión sin éxito.

Dado que este sonido puede significar un rozamiento que comprometería la salud mecánica de la impresora, Hija Resurrection queda fuera de servicio hasta que se solucione.

GioSunrider, 2018-02-22:
Se ha instalado la nueva placa de Ramps de BQ en hija, sustituyendola por la anterior que ha sido almacenada. @Siotma finalmente ha actualizado la configuracion del Marlin, por lo que Hija queda de nuevo operativa.

Siotma, 2018-02-26:
En la última reunión, tras cambiar la placa, se actualizó el Marlin tal y como refleja c8df68e5eb48b71d093aa41e5ddc5d0902caf728

Con la nueva configuraciíon, se imprimió una pieza para el extrusor de Blacky satisfactoriamente.

Hija queda de nuevo en servicio.

GioSunrider, 2018-02-27:
Se ha impreso el mismo gcode en hija y en blacky como se describe en [#45](https://github.com/asrob-uc3m/impresoras-asrob/issues/45).

GioSunrider, 2018-07-02:
En la ultima reunion se sello con termofusibles el agujero que existia en la carcasa de Hija.

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

JorFru, 2018-07-02:
Que no cunda el pánico pero...
HIJA NO FUNCIONA.

Cuando llegué, hija tenía un atasco importante a la altura del barrel. Tirando por arriba imposible. Aguja por abajo, imposible. Probé todo tipo de temperaturas diferentes, hasta 240ºC, imposible. Desmonté el hot end. El nozzle bien. El barrel atascado. Lo desatasqué calentando esta pieza introduciéndola completamente en el heatblock.

Problemas observados durante la manipulación:

- El barrel tiene la rosca marcada y no rosca del todo bien. No sé si fuí yo al desmontarlo/montarlo,  usé un trapo y mucho cuidado para evitar marcarlo con los alicates (necesarios porque estaba muy apretado). He vuelto a montar el conjunto y ha quedado como se puede ver en la foto. En teoría está bien ensamblado, al tacto lo está, pero se ve demasiada rosca fuera y da la impresión a la vista de que no está del todo metido.
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

- El sensor de temperatura (termistor) del hot end está en sus últimas. Los cables que salen de él no tienen ningún tipo de aislamiento eléctrico y posiblemente hagan cortocircuito entre sí. El resultado es que Marlin registra lecturas de 700, 800ºC de vez en cuando y dispara las protecciones por máxima temperatura a veces, durante la impresión.

- Durante los calentamientos para la extracción del atasco observé que el hotend no subía de 170-180ºC, y comprobé que esto se debía a que el ventilador de capa enfría en exceso el conjunto caliente. Lo retiré y obtuve un calentamiento normal. Al volver a poner el ventilador, la temperatura volvió a bajar. Comprobado que este ventilador produce un funcionamiento anormal de la máquina en su posición actual, debe recolocarse y posiblemente necesite un soporte nuevo. También esto ha podido ser la causa del atasco, por enfriar la parte inferior del bloque mientras que permite que el calor fluya por la parte de arriba. No estoy seguro, sólo son especulaciones.

Actualmente el conjunto caliente está ensamblado pero los ventiladores y tal están desmontados, colgando de su cable. Eran ya las nueve y pico, tuve que irme sin terminar. Lo siento.

GioSunrider, 2018-09-13:
Segun la idea de @Siotma se va a proceder a un cambio completo del extrusor. Le dejo por aqui escrito para que nos diga el que usa.

Siotma, 2018-09-14:
La idea de este extrusor es que lleva el filamento a través de un mismo tubo de teflón desde la zona de empuje directamente hasta la zona caliente, por lo que no hay interfaces donde pueda quedar atascado. Desatascar este extrusor es tan fácil como cortar el trozo de tubo donde esté el atasco, en el peor de los casos.
En mi experiencia esto no es necesario ya que el plástico desliza por el interior del tubo sin problema aunque esté frío: he llegado a quitarle el filamento a mi impresora sin calentar y solamente hay que hacer una pequeña tracción para conseguirlo.

El concepto es el siguiente:

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

Siotma, 2018-09-14:
Para devolver a Hija a la vida, ya está disponible el primer reto en: https://github.com/asrob-uc3m/impresoras-asrob/issues/84

GioSunrider, 2018-10-13:
Cierro esta issue por la nueva politica de issues, actualmente hija vuelve a estar operativa, por lo que ademas se le quita el label no funciona.

Siotma, 2018-10-14:
Piezas actualizadas via 0363e391158485261eb205cfc239e86b738a5702

Closed 2018-10-13.

Thread 43 (2018-01-24):

Pruebas de lijado y pulido con Dremel

GioSunrider, 2018-01-24:
Adjunto resultado final de las pruebas que realizamos @daavm y yo de diferentes cabezales de pulido con la dremel. Mas adelante especificare cual fue el resultado de los diferentes cabezales y a la conclusión que se obtuvo. La pieza a tratar fue un Low-Poli Totodile que traje de casa impreso con una Anet A8, con errores visibles en la pieza pero que no afectaron para el post-tratamiento de la pieza.

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

GioSunrider, 2018-02-20:
Despues de realizar distintos tipos de lijado con los distintos accesorios, los que mejor resultado dan son:

- La llamada "Piedra Pomez" que es de forma rosacea y con distintas formas para adaptarse a la forma deseada.
- La lija de arena, son tambien distintos cabezares, tiene color rojo oscuro con brillantes.
- El resto de accesorios calientan demasiado la pieza lo que se pueden deformar en el proceso.

Todas se deben utilizar a bajas revoluciones ya que si son elevadas, se producira un no deseado incremento de temperatura en la pieza.
Y con esto cierro la issue de pruebas de lijado, si en un futuro realizamos mas, se reabrira.

Closed 2018-02-20.

Thread 44 (2018-01-29):

Intervencion a Dedalo

GioSunrider, 2018-01-29:
Debido a que en la ultima reunión se nos rompió la pieza que sujetaba la correa del eje X. El pasado miércoles, decidí pasarme por la nave para no tener a Dedalo fuera de Servicio. Mi idea era imprimir con Hija otro rodamiento y colocárselo, pero debido al problema mencionado en [#42](https://github.com/asrob-uc3m/impresoras-asrob/issues/42) fui incapaz. Como medida provisional decidí colocar dos arandelas de gran tamaño para que sujetaran la correa como se muestra en la siguiente foto.

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

Como he dicho esta medida es provisional, aunque soy partidario de que si la correa no se mueve de ahi, se quede como permante ya que veo mas seguro unas arandelas que colocar otra pieza y que se vuelva a partir en un determinado tiempo.

GioSunrider, 2018-02-01:
Wiki actualizada y  dejamos las arandelas.

Closed 2018-02-01.

Thread 45 (2018-02-06):

Cambio de Extrusor de Blacky

GioSunrider, 2018-02-06:
En la pasada reunion se decidio cambiar el extrusor de Blacky debido a que el que se encuentra ahora mismo esta un poco roto. Se decidio, ya que habia que cambiarlo, @Siotma propuso el extrusor [Wade L3K Extruder](https://www.thingiverse.com/thing:512338) y decidimos cambiarlo. Se imprimio la pieza idle y faltaria el cuerpo del mismo.

GioSunrider, 2018-02-08:
Se ha impreso parte de las piezas del extrusor. Decir que la pieza de la foto es el resltado final, despues que por ansias y por bruto me cargara un pequeña parte de ella pero ya esta como nueva.

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

Siotma, 2018-02-11:
Para instalar este extrusor, hay que disponer de un carro del eje X que disponga de una configuración de agujeros compatible.

En mi impresora, monté este modelo: https://www.thingiverse.com/thing:701087

Me gusta mucho por el sistema de fijación de la correa que luego facilita el tensado. Presenta la dificultad de pausar la impresión a la mitad e introducir la tuerca en el interior de la pieza, pero no es muy difícil si se siguen las instrucciones que vienen en la propia página de Thingiverse.

En caso de que se decida no imprimir esta pieza por cualquier motivo, cualquier otra con la misma disposición de 4 agujeros M4 sería válida.

Siotma, 2018-02-18:
Dado que Blacky se atascó el último día al imprimir con PLA, propongo que el próximo día se desmonte el extrusor y se compruebe el estado del tubo de teflón interno al barrel. En caso de no tenerlo, es muy importante ponérselo. Creo recordar que en el armario había un barrel nuevecito con tubo de teflón

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

GioSunrider, 2018-02-22:
Se ha instalado el carro del extrusor, así como el nuevo extrusor. Aunque por lo visto no ha dado tiempo de su finalización, se quedara pendiente para la próxima sesión. Se le coloca la etiqueta 'No Funciona' hasta que se termine dicho proceso.

Siotma, 2018-02-26:
Tal y como dice @GioSunrider , tan solo falta instalar el motor del extrusor. Debe sujetarse con 3 tornillos. Como apunte, es muy importante que ambos engranajes queden bien alineados. Para conseguirlo, propongo utilizar tornillos M3 de 16mm y el número de arandelas que sean necesarias.

Una vez sujeto el motor, habrá que introducir el filamento y colocar las varillas roscadas con sus palometas y muelles, para fijar el idler. Se pueden utilizar las mismas que tenía el antiguo extrusor. Dejamos todas las piezas necesarias en un Tupper transparente.

Por último, es muy importante realizar pruebas de impresión para verificar el resultado final alcanzado.

Me gustaría destacar el detalle de que en la última reunión, **se cambió el barrel, que no tenía teflón, por otro que había en el armario, que sí lo tiene.** Así pues, confío en que pronto Blacky pueda imprimir correctamente con PLA sin atascarse.

GioSunrider, 2018-02-27:
@Tamayoo3 , @AlejandroAlv96 , @luisen30 y yo, hemos terminado de colocar el extrusor de Blacky. Adjunto fotos del resultado final.
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

GioSunrider, 2018-02-27:
Como se muestra en la foto el cambio de extrusor se ha completado. Por lo que Blacky vuelve a estar operativa. Ademas se han impreso el mismo gcode en blacky y en hija, con la conclusion de que necesitamos ajustar los perfiles de impresion. Adjunto foto de ambos calicats, el azul impreso por blacky y el gris por hija.

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

Siotma, 2018-03-10:
Añadidos @Tamayoo3 , @AlejandroAlv96 y @luisen30 al Team Impresoras

Siotma, 2018-03-10:
Aunque hace bastante tiempo de esto, lo comento para dejarlo documentado.

El día 27 de febrero imprimí con Hija Resurrection el Idler_holder sacado de [esta página de Thingiverse](https://www.thingiverse.com/thing:1855673/#files).

Para colocarlo en Blacky, limé un poco el Idler para hacerle una ranura y que quede bien encajado con el saliente del holder.  Una vez colocado, reemplacé las tuercas M3 de los tornillos de sujección por tuercas M3 autoblocantes.

El objetivo de esta pieza es simplificar el proceso de fijación del Idler. Al tirar del holder hacia arriba, el idler se libera y se puede acceder al filamento. Cuando se ha finalizado, es muy sencillo volver a colocar la pieza en su sitio tirando de ella hacia atrás. La principal ventaja es la **repetitividad del proceso**: como la pieza tiene una ranura siempre queda encajada en su sitio, y como las tuercas son autoblocantes, el idler siempre ejerce la misma presión una vez está todo colocado.

Una foto para ilustrar el resultado:

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

Closed 2018-03-08.

Thread 46 (2018-02-09):

Puesta a punto de Dédalo [RETURNS]

dmarcosm, 2018-02-09:
@David-Estevez nos trajo el adaptador para colocarle la pantalla a Dédalo, y nosotros super contentos corrimos a ponérsela. La buena noticia es que la pantalla funciona!! La mala es que uno de los pololus ardió, así que dédalo está sin funcionar ahora mismo.
Cuando se le cambie la placa a Hija, podremos usar los pololus de esa placa en la sanguino de Dédalo.
Por otra parte, intentamos actualizarle el software para que admitiese la pantalla, pero volvemos a tener el problema de la última vez, por lo que necesitaremos de nuevo un programador como el que nos prestó @David-Estevez la última vez (ISP).

- [ ] Cambiar pololu/s y probar si se vuelve a quemar algo
- [ ] Actualizar firmware

David-Estevez, 2018-02-09:
Os lo presto otra vez? 😂

daavm, 2018-02-09:
> Os lo presto otra vez? 😂

Por favor, jajajaja

GioSunrider, 2018-02-20:
@David-Estevez siento decir que es imposible cargar la placa después de que saliera ardiendo, así que creo que la conclusion fue dar la placa por muerta T.T

David-Estevez, 2018-02-20:
Si el microcontrolador no responde es probable que muriese al colocar el adaptador de forma incorrecta.

En ese caso yo propondría los siguientes pasos:
1. Asegurarse de que nada más se quemó (ver si hay algo negro en la placa además del microcontrolador).
2. (Antes o a la vez que el punto 1) Usar el microcontrolador antiguo, el que no era compatible con la LCD para descartar más fallos en la placa y volver a tener la impresora funcional lo antes posible.
3. El microcontrolador que usamos era una muestra gratuita de ATMEL. Si sólo se ha quemado el microcontrolador, propongo pedir más muestras o comprar uno de repuesto.

¿Qué os parece?

Siotma, 2018-02-21:
Me parece perfecto. Podrías facilitarnos otra vez el microcontrolador antiguo?

David-Estevez, 2018-02-21:
Os lo llevo mañana

GioSunrider, 2018-02-21:
A mi tambien me parece una muy buena solucion, se quemo tambien un pololu, pero creo que cuando cambiemos la ramps a hija quedara alguno libre. En la revision no parece nada mas quemado, pero sin micro poco hemos podido probar.

David-Estevez, 2018-02-22:
De momento seguimos con el plan porque aunque se cambie el pololu si no funciona el micro no hacemos nada. Si el micro va buscaremos repuesto.

David-Estevez, 2018-02-22:
Ya tenéis el micro antiguo en el armario.

GioSunrider, 2018-02-22:
Estoy con el, gracias @David-Estevez ! Pero sigo sin poder cargarle el Marlin, y no reconoce el programador, solo el puerto convencional y ese es imposible de cargarle.

GioSunrider, 2018-02-22:
Se ha determinado que la placa se encuentra en buen estado. Se ha dejado instalado el micro antiguo, con los parámetros de Dedalo de cuando se trajo, ya que es imposible actualizar el Marlin. Se va a sustituir uno de los pololus que se extralleron de la placa de ramps de Hija [ver issue #42](https://github.com/asrob-uc3m/impresoras-asrob/issues/42). Quedaria ver si con un nuevo micro volveria a quedar como nueva.

David-Estevez, 2018-02-22:
Respecto a esto... tengo malas noticias. Al parecer el modelo Atmega1280 se ha descontinuado, y ahora sólo se vende en sus versiones SMD.

Habrá que buscar a ver si alguna tienda tiene stock antiguo, pero la cosa no pinta demasiado bien...

Siotma, 2018-02-26:
Qué faena!!! :cry:

David-Estevez, 2018-02-26:
He encontrado un par de micros de repuesto del 1280p... un par de reliquias que vais a tener que tratar con mucho cuidado, porque no hay más...

GioSunrider, 2018-02-26:
Seran como nuestros hijos! jajajajaaj pero prometemos que no saldran ardiendo.

GioSunrider, 2018-03-08:
Despues de fallidos intentos, ha sido imposible hacer revivir a Dedalo. Conseguimos manejar la temperatura tanto de extrusor, pero los motores no quieren funcionar. Se ha verificado las conexiones, el estado de la placa e incluso sustituido el micro. Probando motores nuevos sin usar, con resultado fallido. Abro issue nueva con la propuesta de cambio de placa.

David-Estevez, 2018-03-08:
Me tiene tremendamente intrigado, porque en la  placa no hay nada roto a simple vista. Tras inspeccionar un poco más detenidamente el [esquemático](http://reprap.org/mediawiki/images/f/f5/Sanguinololu_1.3a.png), lo único que se me ocurre que puede afectar a todos los motores a la vez es:

* VDD (debería ir a 5V)
* VMOT( debería entregar 12V)
* X-STEP, Y-STEP, Z-STEP, E-STEP (conectados al micro)
* X-DIR, Y-DIR, Z-DIR, E-DIR (conectados al micro)
* STEP-ENABLE y STEP-ENABLE-Z (conectados al micro, lógica negada [1 siempre a través de pull-up, 0 forzado por el micro para desactivarlo])
* GNDVDD, GNDMOT

También habría que revisar cortos entre 12V y GND (condensadores estropeados) o VDD y GND (pistas cortocircuitadas).

Siotma, 2018-03-10:
Comento para añadir que en la última reunión se intentó quemar el bootloader en un micro Atmega1280 completamente nuevo utilizando el mismo programador USBtinyISP que utilizamos [la última vez](https://github.com/asrob-uc3m/impresoras-asrob/issues/31#issuecomment-344783262), así como el mismo procedimiento, sin éxito.

Esto complica el uso de Dédalo con la Sanguinololu, y también puede ser un síntoma de algún timpo de mal funcionamiento de la placa...

David-Estevez, 2018-03-14:
Y a unas malas....

https://www.youtube.com/watch?v=tzG5zHn_ysM
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

Siotma, 2018-04-21:
Viendo que #48 ha prosperado, cierro esta issue como wontfix, ya que no se va a seguir por esta vía de momento.

David-Estevez, 2018-04-21:
Le he cambiado el nombre a la issue para que se pueda localizar más fácilmente en el futuro, espero que no os importe.

Closed 2018-04-21.

Thread 47 (2018-02-28):

Extrusor de Blacky atascado

David-Estevez, 2018-02-28:
Esta tarde durante la reunión de RoboFactory hemos intentado imprimir unas piezas en ABS negro con Blacky.

La impresora no extruía nada, así que procedimos a intentar extruir a mano sin éxito. Al intentar extraer el filamento no salía, y lo hemos acabado partiendo.

GioSunrider, 2018-03-01:
Tiene, tanto extrusor como el barrel recién puestos, igual es el filamento ese negro que es muy mierda y le usamos como señuelo. Si vuelve a pasar, en el armario hay agujas para desatascar (son las de acupuntura) en el armario que nos trajo Diego. Aún así el próximo día le echaremos un vistazo a ver cuál es la causa.

David-Estevez, 2018-03-02:
Como se partió el filamento y había poco margen de maniobras preferimos no seguir tocando nada para no empeorar la situación. Pero sí que es posible que fuese por usar el plástico negro ese malucho.

GioSunrider, 2018-03-08:
Se ha limpiado el atasco. Este se debió a la mala, malisima calidad del teflón en el barrel. Solo quedan hacer las pruebas de impresión tras la limpieza.

daavm, 2018-03-08:
Añadir que se ha hecho una pequeña modificación en el barrel para poder usarlo en el extrusor que actualmente usa Blacky, la cual arregla el problema por el cual se producía el atasco.
El barrel que se utiliza en este tipo de extrusor es tal que así:

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

Este barrel tiene en la parte de arriba un trozo liso, sin rosca. Al tener los barrels que habíamos probado rosca hasta el final, no llegaba a entrar del todo, y quedaba un hueco en el cual el plastico se expandía, y, por tanto, se atascaba. Para solucionarlo hemos lijado la rosca sobrante para que entrase del todo. De esta forma Blacky quedaría (a falta de pruebas) operativa con PLA. La otra solucion era dejarle el barrel sin teflon que ya tenia ese trozo liso, pero solo serviría para usarla cn ABS.
No hay fotos, el próximo día :)

David-Estevez, 2018-03-08:
Ahhh, así que para eso era la Dremel... :joy: :joy:

daavm, 2018-03-16:
En la sesión de ayer pusimos a Blacky a imprimir una carcasa para la Raspberry Pi y lo hizo de maravilla, así que damos por solucionado este problema :+1:

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

GioSunrider, 2018-03-19:
Cabe destacar, que hoy me ha costado bastante colocar el filamento, esto se debe a la modificacion del barrel, ya que se nota donde choca por la cantidad de filamento introducida. Si el filamento no entra recto cuesta bastante de colocar, a pesar de todo, Blacky ha impreso correctamente como se puede demostrar en la siguiente foto.

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

Siotma, 2018-03-20:
Es importante que al introducir el filamento, la punta de este no sea demasiado ancha. Esto ocurre habitualmente cuando el filamento se saca del extrusor para guardar. La punta se ha ensanchado como producto del calor y al intentar volver a ponerlo le cuesta entrar. La solución de baja tecnología para esto es romper la punta.

Además, como tú dices, el filamento debe estar recto para entrar más fácilmente. Para ello se pueden enderezar fácilmente con los dedos.

GioSunrider, 2018-03-20:
Creeme que hice todo, pero bueno, quiero que quede reflejado que da problemas aun haciendo todo.

Closed 2018-03-16.

Thread 48 (2018-03-08):

Remplazar placa a Dedalo

GioSunrider, 2018-03-08:
Aprovechando el dinero de la subvención, propongo, ya que como se especifica mas detalladamente en [#46](https://github.com/asrob-uc3m/impresoras-asrob/issues/46), se compre una placa Arduino Mega y un nuevo juego de Pololus, para que Delalo vuelva a la vida. La Ramps hay una en el armario que funciona a la perfección que esta disponible después del remplazo de la misma a Hija.
¿Cual seria el método que habría que seguir?

David-Estevez, 2018-03-08:
Como es dinero de subvención, es dinero que gestionáis vosotros. No harían falta issues a nivel asociación, simplemente que os pongáis de acuerdo entre vosotros.

GioSunrider, 2018-03-08:
Pues... COMPAÑEROS DE PRINTER ONE! En nombre de Azazel YO OS INVOCO!
¿Os parece bien esta idea? y ¿alguno podría hacer cargo de los costes que supondría esta compra?

David-Estevez, 2018-03-08:
Respecto a los costes, yo puedo ofreceros un pacto... (:smiling_imp: )

Siotma, 2018-03-10:
A mi me parece perfecto. @GioSunrider , podrías hacer una pequeña búsqueda para comparar precios y hacer una propuesta? Así podemos saber cuánto nos costaría y poder opinar sobre ello. Si además dejas algunos links, sería fantástico.

GioSunrider, 2018-03-10:
Sin problema, me pongo a ello, preferimos que sea original o con una imitación nos vale?

Siotma, 2018-03-10:
El presupuesto es limitado, con una de imitación puede valer perfectamente. Si encuentras alguna original bien de precio, pásala también.

daavm, 2018-03-10:
Yo creo que mientras no arda nos vale. Si es imitación pero sabemos que no es mala, pues adelante

GioSunrider, 2018-03-12:
Voy con las placas que he mirado.
[OPCION 1](https://www.amazon.es/Tarjeta-Microcontrolador-ATmega2560-ATmega16U2-Compatible/dp/B06Y3ZHPWC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)
[OPCION 2](https://www.amazon.es/XCSOURCE®-Atmega2560-16AU-Tarjeta-Versión-TE629/dp/B01N51Y3EJ/ref=sr_1_11?ie=UTF8&qid=1520853461&sr=8-11&keywords=Arduino+mega)
[OPCION 3](https://www.amazon.es/SODIAL-desarrollo-ATMega16U2-Mega2560-Arduino/dp/B00PXOGG74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)
Esto para las placas Mega Imitación, deberíamos valorar tiempos, por eso lo pongo por Amazon.
Y estos los pololus.
[OPCIÓN 1](https://www.amazon.es/Popprint-DRV8825-Controladores-disipadores-impresora/dp/B06Y6536CB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)
[OPCION 2](https://www.amazon.es/BIQU-StepStick-Controlador-disipador-elevadores/dp/B06WVBMTKF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)
[OPCION 3](https://www.amazon.es/Stepper-Driver-Pololu-Impresora-stepstick/dp/B071DQ7Y45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)
Las diferencias entre las opciones son básicamente precio y entrega.

daavm, 2018-03-12:
Las opcion 1 de cada cosa pintan bien, en mi opiinión

GioSunrider, 2018-03-12:
A mí también me parecen las mejores.

David-Estevez, 2018-03-12:
Os habéis planteado algo más pro? (No sé si entrará en presupuesto)

Algo como esto: https://www.staticboards.com/products/ovm20-lite/

daavm, 2018-03-12:
Es una buena opción, y tampoco se va demasiado de precio.

GioSunrider, 2018-03-12:
Lo había planteado, y más que mirado. Me parece la mejor opción en cuanto a calidad, pero el tema del presupuesto no se si será viable, pero puede quedar como otra opción.

David-Estevez, 2018-03-14:
Y a unas malas...

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

Siotma, 2018-03-15:
Yo también veo bien la opción 1 de ambas cosas. El coste total son 24€ aprox :+1:

En cuanto a la placa OVM20 lite, a parte de que es más cara, a mi no me convence la idea de que tenga los drivers soldados, en cuanto haya algún problema en alguno, adiós placa...

Cuáles serían las ventajas de una OVM20 exactamente?

David-Estevez, 2018-03-15:
¿Alguna vez has tenido algún problema con algún driver? Yo la única vez que los he tenido han sido por conectarlos mal en su socket... Aparte de eso, la principal ventaja que veo yo es que la placa y los componentes son de calidad.

JorFru, 2018-03-15:
Propongo usar una Ramps 1.4 SB.
SB viene de StaticBoards.
Y ponerle un Arduino chinaco.

Ahorraríamos pasta y mantendríamos una electrónica de calidad, que lo
importante es la parte de potencia. Traen un MOSFET de cama correctamente
dimensionado a si que se podría usar sin relé, aunque no es obligatorio
quitarlo.
Luego a parte habría que comprar los drivers (otra razón por la que la OVM
renta, no hay que rallarse por comprar los drivers) y estos pueden ser
muuuuuy chinos o ser un poco mejores y comprar los de StaticBoards. (En ese
caso a estaríamos en el mismo precio de la OVM en sí)

El 15 mar. 2018 21:05, "David Estévez Fernández" <notifications@github.com>
escribió:

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

GioSunrider, 2018-03-15:
yo sinceramente no compraria la Ramps, precisamente es lo que tenemos. O la placa completa o elegir de las opciones.

Siotma, 2018-03-15:
Una RAMPS, ya tenemos, aunque pensándolo bien es muy china.

Teniendo en cuenta que Dédalo no tiene Relé, y que antes tenía una Sanguinololu, creo que una OVM20-Lite puede ser buena idea para mantener la filosofía de placa monolítica.

Yo tengo la experiencia de que un Driver se me estropeó de un momento a otro mientras imprimía en una Feria de Asociaciones de esto hace años. Otra experiencia más reciente es cuando ardió el Driver de Dédalo al conectar la pantalla.

Considero que si tenemos cuidado al instalar la placa, una vez instalada ya no tendremos que tocarla y probablemente nos dure mucho tiempo y nos de muchas alegrías. Teniendo en cuenta que las otras impresoras tienen placas de BQ, y que esta es la única placa que _presumiblemente_ vamos a comprar con la subvención, creo que puede merecer la pena tenerlas a todas con electrónica buena.

OVM20 :hand:

GioSunrider, 2018-03-15:
Pues ya esta, la OVM20 creo que practicamente por unanimidad. Solo queda pensar quien adelanta la pasta?

Siotma, 2018-03-18:
Según he visto, el precio de la placa OVM-20 son 42€ + 6 de envío = 48€ .

La puedo comprar yo esta noche. Hasta entonces, se admiten nuevas sugerencias :)

Siotma, 2018-03-18:
Parece ser que el precio de 34,71€ es sin IVA. En Orballo Printing la tienen al mismo precio, pero el envío es más barato: 42€ + 1,20€ = 43,20€.

Yo creo que esta opción es más económica y nos puede interesar.

GioSunrider, 2018-03-18:
voto por la opcion economica.

Siotma, 2018-03-19:
Ayer compré la placa por 43,20€. Hoy me han dicho que ya la han enviado, así que en la próxima reunión la tendremos :+1:

Siotma, 2018-04-07:
De momento la placa no llega y estoy empezando a preocuparme. Ya he escrito a la tienda para pedir explicaciones.

Siotma, 2018-04-21:
Os cuento:

El viernes día 13 llamé a Orballo Printing, la tienda donde había comprado la placa. Les expliqué que no me había llegado aún y que había pasado a preguntar por mi oficina de correos sin que pudieran darme ninguna solución. Al haberlo enviado por carta ordinaria no tenía número de seguimiento.
La persona que me atendió fue muy amable en todo momento y consultó con otros compañeros para tratar de darme una solución.
Sin que yo se lo pidiera, me dijo que no había ningún problema y que me iban a mandar otra placa, esta vez por correo registrado.
La placa llegó ayer a mi casa :tada: :tada:

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

En la próxima reunión tocará probarla. Mientras, aún espero la factura por lo que dejo la Issue abierta.

David-Estevez, 2018-04-27:
>  La conclusión que hemos sacado es que a los Drivers paso a paso no les gusta que se conecten o desconecten los cables de los motores "en caliente". Si detectan algún problema en un motor se desactivan.

Por si fuese útil:

## 8.3.7 Protection Circuits
The DRV8825 is fully protected against undervoltage, overcurrent, and overtemperature events.

### 8.3.7.1 Overcurrent Protection (OCP)
An analog current limit circuit on each FET limits the current through the FET by removing the gate drive. If this analog current limit persists for longer than the OCP time, all FETs in the H-bridge will be disabled and the nFAULT pin will be driven low. The device remains disabled until either nRESET pin     applied, or VM is removed and reapplied. overcurrent conditions on both high-side and low-side devices; that is, a short to ground, supply, or across the motor winding all result in an overcurrent shutdown. Note that overcurrent protection does not use the current sense circuitry used for PWM current control, and is independent of the ISENSE resistor value or xVREF voltage.

### 8.3.7.2 Thermal Shutdown (TSD)
If the die temperature exceeds safe limits, all FETs in the H-bridge will be disabled and the nFAULT pin will be driven low. After the die temperature has fallen to a safe level, operation automatically resumes.

### 8.3.7.3 Undervoltage Lockout (UVLO)
If at any time the voltage on the VM pins falls below the UVLO threshold voltage, all circuitry in the  device will be disabled and internal logic will be reset. Operation will resume when V(VMx) rises above the UVLO threshold.

Siotma, 2018-04-28:
Concuerda completamente con el comportamiento que observamos en la última reunión.

JorFru, 2018-09-18:
¿Esta placa OVM20 está colocada en Dédalo?
No se puede saber porque no hay foto!!!

Thread 49 (2018-03-11):

OctoPrint para nuestras impresoras!

dmarcosm, 2018-03-11:
Hace unas semanas @GioSunrider sugirió usar una sola raspberry para controlar todas las impresoras (actualmente, 2), usando lo que dicen en este link: http://thomas-messmer.com/index.php/14-free-knowledge/howtos/79-setting-up-octoprint-for-multiple-printers
Básicamente lo que propone este hombre es crear varias instancias de Octoprint, de forma que cada una de esas instancias controle cada una de tus impresoras.
Para esto se podría usar una de las Raspberry que hay en el armario si es posible usarlas. De todas formas, y aprovechando la subvención, compraría al menos una cámara para una de las impresoras (no se recomienda poner 2 camaras usb a la vez porque tiran de mucha CPU según he leído), así como un cable ethernet decente para conectarla a internet.
Comentad!

Siotma, 2018-03-11:
Disponiendo ahora mismo de placas RaspberryPi y tarjetas SD en la Asociación, yo propongo muy fuerte usar esas, al menos para poner a punto todo el sistema, y probar distintas alternativas.

Esto tiene la ventaja de que no tiene retrasos de compras o envíos, y además, el uso de las placas para este fin no va a poner en peligro su integridad. Propongo, de hecho, que esta vía se comience a investigar en la próxima reunión con los medios disponibles. En el momento en que se tenga clara la configuración definitiva y el número de placas necesarias, se puede revisar si estas eran necesarias para otros proyectos y hacer una compra para reponerlas.

Respecto a comprar una cámara web, te digo lo mismo que a @GioSunrider en #48, haz una búsqueda y propón opciones para valorar precios, y lo mismo te digo con los cables Ethernet :wink:

David-Estevez, 2018-03-11:
En RoboFactory disponemos de Raspberry Pis (y tarjetas) que no estamos usando actualmente y que os podemos ceder para que no tengáis que esperar a que os llegue el material para empezar a trabajar :smile:

GioSunrider, 2018-03-12:
El próximo dia, si tenemos MicroSD de sobra puedo ponerme a ello sin problema que tengo todo en el portátil de cuando lo hice en casa.

David-Estevez, 2018-03-12:
No tenéis más que recordarme qué día os reunís esta semana para que os deje preparado el material.

GioSunrider, 2018-03-12:
Esta por decidir @Siotma tiene hoy que cerrar el doodle jajajajaja cuando lo cierre que confirme por aquí.

daavm, 2018-03-12:
Jueves de 18.00 a 21.00 :)

GioSunrider, 2018-03-15:
Gracias a la RPi y a la microSD prestadas por @David-Estevez se ha instalado en ella Octoprint. Siguiendo la pagina oficial de [Octoprint](https://octoprint.org/) presenta un manual de instrucciones para su uso e instalacion en su [pagina de descagas](https://octoprint.org/download/).

Ademas se han impreso un protector para la RPi, como se ve en la foto.

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

Ademas se ha Configurado Octoprint para Hija. El proximo dia quedaria probar su funcionamiento, para posteriormente comenzar con la gestion de varias impresoras con la misma RPi.

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

GioSunrider, 2018-03-19:
Hoy se ha probado Octoprint con hija. Para ello se ha conectado el router al ordenador y a la RPi. La dirección IP de Octoprint conectada al router es: `222.1.1.54`
Ademas se ha instalado el Plugin de Telegram y @daavm a traves de `@BotFather`, ha creado un bot para gestionar Octoprint desde Telegram. Adjunto la imagen resultado del uso del comando `/status`.

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

Ademas se ha impreso, como se muestra en la foto, usando Ocoprint un cilindro para una de las bobinas ya que actualmente solo disponiamos de uno.

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

Queda pendiente para la próxima sesión ajustar la RPi para el uso de una segunda impresora (Blacky).

Y por ultimo abro una issue para la compra de dos cámaras de RPi (Una por balda de la granja), ya que para las pruebas realizadas hoy, se ha dispuesto de una que había en el armario perteneciente a Robofactory (creo).

Siotma, 2018-03-20:
Excelente trabajo! Esto marcha!

David-Estevez, 2018-03-21:
Añadiendo a lo que dice @jgvictores , no sé si este router lo soportará, pero hay algunos que tienen dns local y permiten definir dominios locales tipo "dedalo.local" o "blacky.local".

O si no gestionarlo a través de avahi o algo así para no tener que recordar las ips.

jgvictores, 2018-03-21:
En TEO simplemente recomendamos un cierto contenido en `/etc/hosts`, pero claro, eso lo tiene que configurar cada usuario.

David-Estevez, 2018-03-21:
Yo lo del dns lo tengo configurado en casa y va guay, y lo del avahi no recuerdo exactamente cómo se configuraba, pero también iba guay (aunque los dispositivos Android, por ejemplo, no lo soportaban).

jgvictores, 2018-03-21:
Hombre, lo del DNS mola muchísimo.

Siotma, 2018-04-28:
Recuperando esta issue, hago la misma pregunta que en #54 : deberíamos comprar nuestras propias RPis y tarjetas SD?

dmarcosm, 2018-09-28:
Bueno, como prometí estos días he estado trabajando en Octoprint para poder usarlo en varias impresoras con una sola raspberry. He conseguido que 2 instancias funcionen de forma simultánea, a falta de probar en la nave si es capaz de imprimir en las 2 a la vez sin generar muchísimo lag. Si funciona, y ya por curiosidad, intentaré ver si es capaz de tirar 3 a la vez. De esta forma, solo necesitaríamos 2 Pi's y 5 cámaras.
En caso contrario, necesitaremos 3 Pi's y 5 cámaras, ya que ahora tenemos 5 impresoras y estaría bien dejarlas ya todas controlables vía Octoprint.
Tengo pendiente hacer un script para generar la nueva instancia en cualquier raspberry (así nos ahorramos trabajo en el futuro). Lo subiré a una carpeta llamada "Octoprint" en el repositorio de impresoras, si os parece correcto.

GioSunrider, 2018-09-29:
No te compliques, 3Pi's mejor, así tenemos capacidad de extensión a otra impresora en caso de donación! Pero gran trabajo!

Siotma, 2018-09-30:
> Lo subiré a una carpeta llamada "Octoprint" en el repositorio de impresoras, si os parece correcto.

Me parece bien!

GioSunrider, 2018-10-02:
Necesitamos la compra de 3 RPi 3 y tres tarjetas microSD, @dmarcosm si puedes decidir tu la capacidad seria lo mejor, ya que eres el que ha hecho las pruebas.

GioSunrider, 2018-10-02:
Link compra Raspberries: https://es.rs-online.com/web/p/products/1373331/

GioSunrider, 2018-10-02:
Link compra Raspberries: https://es.rs-online.com/web/p/products/1373331/

dmarcosm, 2018-10-02:
> Necesitamos la compra de 3 RPi 3 y tres tarjetas microSD, @dmarcosm si puedes decidir tu la capacidad seria lo mejor, ya que eres el que ha hecho las pruebas.

Mañana compruebo, pero 8-16Gb deberían ser más que suficientes.

dmarcosm, 2018-10-05:
Me comenta @GioSunrider  (no tiene portátil a mano para comentar en la issue) que con las raspberries de GAME nos da de sobra, con SDs incluidas, así que no hace falta que las compres @Siotma

David-Estevez, 2018-10-05:
Como antiguo responsable de GAME confirmo la "cesión" del material.

GioSunrider, 2018-10-08:
Cierro issue y reabro para la intalacion de octoprint, dado que no se necesita la compra de ninguna de los componentes.

Closed 2018-10-08.

Thread 50 (2018-03-11):

Construir una estantería para colocar las impresoras 3D

Siotma, 2018-03-11:
Esta es una parte fundamental del proceso de creación de la Granja de impresoras.

En la propuesta del proyecto consideramos comprar perfiles y baldas metálicas. La idea es construir una estantería en la que quepan al menos 4 impresoras. Se realizaron medidas descubriendo que cada impresora mide unos 50x50x50cm. Tal vez esto habría que volver a medirlo.

Se encontraron perfiles de 2m y baldas de 100x60cm. La idea es construir una sola estantería utilizando 4 perfiles y tres o cuatro baldas. La idea es colocar una balda a ras de suelo y otra arriba del todo para que hagan de estructura, y luego dos intermedias para disponer de 3 huecos con una altura aproximada de 2m/3=66cm. Con esta configuración se pueden poner 4 impresoras en los 2 huecos superiores y dejar la parte inferior para almacenar materiales.

Enlace a baldas: http://www.leroymerlin.es/fp/14118923/balda-balda-gris-fondo-60-cm?pathFamilaFicha=220116

Enlace a perfiles: http://www.leroymerlin.es/fp/10913070/perfil-perfil-gris-40-x-40-mm

Además de esto, haría falta comprar tornillería para montar la estantería correctamente.

Propongo seguir la siguiente estructura:
- [x] Seleccionar las baldas y los perfiles.
- [x] Identificar la zona de la nave donde se instalará la estantería.
- [x] Comprar el material para construir la estantería.
- [x] Recepcionar el material en la Asociación.
- [x] Construir la estantería.

Probablemente se puedan valorar otras alternativas por lo que se abre el debate!

daavm, 2018-03-11:
Por sugerir, sugeriría buscar baldas algo más anchas para poder poner 2 impresoras por balda. No veo util poner una impresora en una supuesta 3ra o 4ta balda, sería muy incómodo usarla, no?

GioSunrider, 2018-03-11:
A mi modo de ver, lo primero a realizar seria medir el espacion en la nave donde vamos a colocar el parque, porque a raiz de ahi podremos decidir estanterias y demas. Dibujar un boceto y empezar a buscar todo lo que @Siotma menciona, tornilleria, baldas y perfiles.

daavm, 2018-03-12:
Anoche y hoy hemos estado hablando en el grupo sobre la posibilidad de usar mesas lack del IKEA apiladas. Puede sonar un poco a chapuza, pero dejo una foto por aquí de cómo quedaría:

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

Las piezas para unirlas las podríamos imprimir nosotros, y cubrirlas por los lados con metacrilato y ponerles una puerta que se cierre con un imán. Con 4 mesas iríamos sobrados y cuestan 10€ cada una, ahí dejo la idea.

Siotma, 2018-03-15:
Las mesas lack están bien, pero son endebles, están hechas de cartón y yo creo que se deteriorarían con el tiempo, especialmente con la humedad de la nave.

Yo propongo la configuración mostrada en la siguiente imagen, las unidades están en cm:
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

Utilizando las piezas de leroy merlin que puse en el primer comentario ([baldas](http://www.leroymerlin.es/fp/14118923/balda-balda-gris-fondo-60-cm?pathFamilaFicha=220116), [perfiles](http://www.leroymerlin.es/fp/10913070/perfil-perfil-gris-40-x-40-mm)), la estantería tendría 60cm de fondo, dejando 50x60x66cm para cada impresora. La estantería tendría capacidad para hasta 6 impresoras y costaría 75€ más tornillería, conque calculo que unos 80€.

Respecto a la posición en la nave, se proponen tres ubicaciones posibles:

1: junto a la columna de la lona de Robot:
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

2: en la zona del segundo armario (reubicando el segundo armario en alguno de los otros dos lugares):
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

3: junto a la pared de la nave:
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

Siotma, 2018-03-18:
A mi, la zona que más me gusta es la número 3. Pegada a esa pared se puede poner la estantería  de las impresoras y también una mesa para el PC donde generar el g-code.

Desde mi punto de vista tiene la ventaja de ser una zona apartada del paso, pero fácilmente visible.
La principal desventaja es que habría que reubicar (y/o desmontar) el terreno de juego para hacer hueco.

Visto que esta issue tiene poco movimiento, no sé si deberíamos tomar la justicia por nuestra mano, o replicarla en actas.

Opiniones?

JorFru, 2018-03-18:
¿La jurisdicción del Dohyo de peleas es completamente de ASROB?

El 18 mar. 2018 17:44, "Manuel Peña Fernández" <notifications@github.com>
escribió:

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

Siotma, 2018-03-18:
A qué te refieres exactamente?

JorFru, 2018-03-18:
Me refería a que si es 100% nuestro y no compartido con ningún departamento ni cosas de esas. Pero creo que sí, comenta @David-Estevez

Mi lugar favorito para la granja de impresión es la posición 3. (Que lamentablemente no queda a la vista desde la pasarela, hubiese sido completamente épico).

También hay que pensar, y creo que es muy importante, qué se va a hacer con las mesas que actualmente soportan las impresoras. Se van a quedar muy solitarias y si se quedan solitarias son razones que estamos regalando para que otros laboratorios se recalifiquen el espacio. En algunas ocasiones este espacio se puede usar para exhibir y hacer usables los inventos de GAME: recreativa y hóckey.

Actualmente hay una issue abierta respecto a "decoración de la nave" https://github.com/asrob-uc3m/actas/issues/37 **en la que se puede comprobar lo siguiente: una de las propuestas es tirar la cosa verde**. Además el rack de impresoras puede cumplir con la función de decorar la nave, por supuesto. Y si hay alguna balda en desuso se puede habilitar como "hall of fame de PrinterOne"

David-Estevez, 2018-03-18:
Yo voy a contribuir recordando que hay una serie de propuestas en actas sobre qué hacer con la nave, de las que salió la idea de la granja: https://github.com/asrob-uc3m/actas/issues/93#issuecomment-335903419

Siendo coherente con la issue, estoy a favor de tirar la cosa verde y poner en su lugar la granja.

GioSunrider, 2018-03-18:
yo tambien estoy a favor de desmontar todo eso. El otro dia comentamos que una de las mesas quede como lugar de soldadura, con la fuente y el osciloscopio. y creo que una vez desmontemmos todo eso, tambien se podria recolocar el armario 2, para asi "hacer bulto".

jgvictores, 2018-03-18:
Tema cosa verde, mínimo votación a nivel Asrob. Tengo la idea intuitiva de que conviene conservarlo, prefiero comentar por qué en persona.

Tema granja en general, no quería intervenir porque no quería cortar el rollo... Pero si es algo muy grande es posible que fuese bueno consultarlo a nivel departamento.

GioSunrider, 2018-03-18:
Mañana tenemos reunion de 11 a 15. Igual puedes pasarte y nos cuentas. Tema de la granja, creo que en el diseño de @Siotma vienen medidas "minimas" que tendremos que respetar para que entre todo, no se si eso se considera grande o no.

JorFru, 2018-03-19:
Para tranquilidad de @jgvictores puedo justificar que la tendencia actual para competiciones de robótica destructiva (uno de los pocos nichos de la robótica que usarían el citado deshecho verde) consiste en miniaturizar los competidores y limitarlos a materiales impresos para hacerlos más baratos y menos peligrosos.
Adjunto imagen de un competidor de tendencia actual.
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
Fuente: @esdrufao en Telegram, grupo @bricogeek

jgvictores, 2018-03-19:
Hemos estado midiendo esta mañana, hay espacio en la esquina para meter el estante de planta 100 cm * 60 cm sin tener que desmontar ni tirar lo verde.

La propuesta está en que una Raspi controle las impresoras vía Octoprint. Puede conectarse a directamente por cable a Internet de la toma de al lado, o vía wifi a router donde PCs actuales.

Si alguien intuye que lo que trato es que se perciba el menor número de cambios para que no peligre nuestro actual espacio, está en lo cierto.

Siotma, 2018-03-19:
Teniendo en cuenta los casos de uso que va a tener la granja de impresoras (uso por terceros, mantenimiento, paso de gente a su alrededor, ...), creo que es importante que se ubique en una zona no solamente con espacio suficiente para poner la estantería, sino también con buena accesibilidad y margen de maniobra para realizar la instalación de forma cómoda y poder hacer un mantenimiento mínimo sin quitar las impresoras de la estantería. Además, si la ubicación está apartada del paso, mejor para que nadie pueda derribar ni desplazar la estantería a su paso. Este asunto mejoraría si la estantería se pudiera anclar a la pared.

Dicho esto, también estoy de acuerdo con reducir los cambios en nuestro espacio de trabajo, a no ser que se tenga un apoyo general de la Asociación, pero **no considero que el espacio actualmente ocupado por el escenario verde sea espacio útil para ASROB**, por lo que si eventualmente perdiéramos un espacio de tamaño equivalente, seguiríamos exactamente igual que ahora.

Creo que **es importante que los trabajos en la granja comiencen pronto** para poder tenerla lista antes de que lleguen los exámenes y el verano, ya que si se queda a medias sería un gran problema. Como solución transitoria propongo que la granja se coloque inicialmente en la ubicación número 1, retirando la mesa de la fuente y el osciloscopio. En esa zona se podrían realizar los trabajos de construcción de la estantería y también se podrían hacer las pruebas necesarias con las impresoras al estar físicamente cerca de los ordenadores. **Sin embargo, esta ubicación provisional no es la mejor, y por tanto, no me gustaría que fuera definitiva.**

> Tema granja en general, no quería intervenir porque no quería cortar el rollo... Pero si es algo muy grande es posible que fuese bueno consultarlo a nivel departamento.

Todo lo contrario Juan, no cortas ningún rollo. Desde Printer One estamos dispuestos a hacer este trabajo para mejorar las condiciones de espacio de la nave, y las condiciones de uso de las impresoras. Creo que el Departamento podría ver con buenos ojos esta iniciativa, y tal vez hasta pueda darnos facilidades para encontrar una ubicación entre todos, o medios para anclar la estantería y darle más estabilidad.

Propongo que todos aquellos trámites que se crean necesarios hacer previamente se discutan por aquí, y se pongan en marcha para tenerlo claro a la vuelta de Semana Santa:

- [ ] Consultar el proyecto a nivel Departamento para analizar posibilidades de ubicación y anclajes.
- [ ] Discutir los cambios a realizar en nuestro espacio para ubicar la granja y consultarlos a todos los miembros de ASROB mediante una issue en actas.
- [ ] Poner en práctica las iniciativas que se desprendan de los puntos anteriores y **montar la granja**.

GioSunrider, 2018-03-19:
Yo veo incluso que podemos sobredimensionar la estantería de la granja, de esta manera "ocuparíamos espacio" y ademas seria mas fácil su manejo.

Siotma, 2018-03-20:
No hay baldas mucho más grandes que las que hemos propuesto. Por otra parte, la idea de la granja es desde su inicio, "mejorar el aprovechamiento del espacio". Me parece contraproducente cualquier intento de agrandar innecesariamente su tamaño.

GioSunrider, 2018-03-20:
Entonces a favor del comentario previo, en semana santa puede ser una buena oportunidad para aclarar esto.

David-Estevez, 2018-03-21:
> Consultar el proyecto a nivel Departamento para analizar posibilidades de ubicación y anclajes.

Yo me ofrezco voluntario para hablar con la persona correspondiente del Departamento (imagino que Ramón Barber),explicarles qué pretendemos hacer y consultar qué implementación sería la más apropiada.

David-Estevez, 2018-04-09:
Acabo de hablar hace un rato con Ramón Barber. Dice que le parece interesante la idea de la granja de impresoras y que, siempre que no nos salgamos del espacio que tenemos actualmente, no hay problema por parte del departamento para instalarla en nuestro espacio.

daavm, 2018-04-09:
Dado que la nueva impresora es tan grande, quizá deberíamos replantear el concepto de la estantería, ¿no?

Siotma, 2018-04-09:
Muchas gracias por gestionarlo @David-Estevez

Respecto a lo que propone @daavm , habría que medir las dimensiones definitivas de la nueva impresora (#57) y en base a ello plantear una estantería distinta o plantearse colocar esta nueva impresora en otro sitio. Sin embargo, las otras tres impresoras van a seguir necesitando un sitio y la estantería puede seguir siendo una solución para ellas...

daavm, 2018-04-09:
64x64cm @Siotma

JorFru, 2018-04-09:
Las impresoras viejas almacenadas de cara a la pared. Y la TronXY en medio
de La Nave en un altillo.

El lun., 9 abr. 2018 20:13, daavm <notifications@github.com> escribió:

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

Siotma, 2018-04-21:
Finalmente, esta issue se ha resuelto a nivel de asociación mediante https://github.com/asrob-uc3m/actas/issues/139.

La disposición de las impresoras será pegadas al muro de separación con la nave anexa, conforme a lo que indica el siguiente dibujo:

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

La estantería será de [este modelo](https://www.ractem.es/estanterias-media-carga/81-estanteria-c-max-200.html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) y tendrá las siguientes medidas:
- 2000mm de alto.
- 1500mm de ancho.
- 700mm de fondo.
- 4 baldas.

Haré el pedido de forma que lo envíen directamente a la Universidad a nombre de @David-Estevez .

JorFru, 2018-04-27:
Por mi dale!

El vie., 27 abr. 2018 0:17, Manuel Peña Fernández <notifications@github.com>
escribió:

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

GioSunrider, 2018-04-27:
PALANTE!

Siotma, 2018-04-27:
Comprada: 149,74€

Siotma, 2018-04-27:
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

David-Estevez, 2018-05-04:
El paquete ha sido recibido hoy con éxito, y se encuentra en nuestro espacio de trabajo habitual.

* El transportista se puso en contacto hoy conmigo para gestionar la entrega, pues no tenía muy claro dónde había que dejar el paquete y era voluminoso (y pesado).
* Me puse en contacto con el resto de asociados para tener ayuda de cara a llevarlo a la nave.
* Indiqué al transportista que descargase en conserjería, punto en el cual @davidvelascogarcia se unió para echarme una mano.
* Usando el carrito que se encuentra en la nave, llevamos los paquetes hasta el espacio de trabajo de ASROB. (Ver foto)

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

Gracias a @davidvelascogarcia por echarme una mano, porque sin duda no hubiese podido llevar ese pedazo de paquete yo solo hasta allí.

Siotma, 2018-05-11:
@David-Estevez @GioSunrider y compañía, deberían contarnos qué tal se dio esto... :wink:

David-Estevez, 2018-05-11:
@GioSunrider llegó hoy un poco antes de la reunión de Printer One, cuando estábamos reunidos los de RoboFactory, y comenzó a montar la estantería. Para evitar accidentes, y ya que estábamos un poco ociosos, Cecilia y yo decidimos ayudarle a montar la estructura, que finalmente colocamos contra el muro, en el lado más cercano al armario de los autómatas.

En ese punto los de RoboFactory nos fuimos al bar, así que @GioSunrider puede contar el final de la historia.

GioSunrider, 2018-05-15:
Lo primero adjunto fotos del unboxing de la estanteria.

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

Como cuenta @David-Estevez , él y Cecilia me ayudaron a contruir ya que todo era muy endeble y podria causar accidentes. La estructura se decidio colocar en esas pestañas para que Geonosis pudiera entrar y ser manejada sin problemas. Seguimos el manuel de instrucciones para su montaje y lo colocamos a la derecha en el muro como se muestra en la foto.

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

Posteriormente se instalaron las maderas y se colocaron las impresoras al final de la reunion y encadenaron debidamente como resultado final que se puede ver en la foto.

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

Siotma, 2018-05-19:
@GioSunrider cierra esta Issue que te lo has ganado

Closed 2018-05-19.

Thread 51 (2018-03-11):

Comprar un kit para construir una nueva impresora 3D

Siotma, 2018-03-11:
Esta es una parte muy atractiva de la subvención de Mejora y Modernización del parque.

Teniendo en cuenta que el importe total de la subvención han sido 455€, yo creo que deberíamos limitar el presupuesto de la impresora a 250€.

Además, como recomendación, creo que merece más la pena comprar una sola impresora de precio medio que intentar comprar dos de bajo presupuesto. Si compramos dos, tal vez no quepan todas al final en la Granja :rofl:

Propongo seguir la siguiente estructura:
- [x] Elegir modelo de impresora.
- [x] Comprar el kit de la impresora.
- [x] Recibir el kit de la impresora.
- [x] Bautizar la nueva impresora.
- [x] Abrir una nueva issue para gestionar su construcción.

Se abre el debate para elegir modelo, precio y proveedor!

daavm, 2018-03-11:
Creo que sabéis de sobra qué haría yo (2 Anets jej), pero creo que también sería buena idea comprar algo que no tengamos, algo de lo que podamos aprender. Quizá buscaría una tipo Delta, o una Core como decía @GioSunrider (aunque ésta se nos iría de precio probablemente).

JorFru, 2018-03-11:
Una CoreXY/HBot o bien una Delta.
Porfiiiii

GioSunrider, 2018-03-11:
Yo mi posicion tambien esta clara, creo que es mas atractiva una CoreXY, por tener una diferente, igual si valoramos precios podemos encontrar buenos precios, incluso en vez de kit, podriamos directamente comprar las piezas y montarla de 0.

JorFru, 2018-03-12:
La impresora se va a montar de cero y componente a componente fijíiiiisimo! Eso no lo dudes Giorgio.

Para convencer a @Siotma con a añadir un par de enlaces que se pueden leer en cosa de dos minutos. Y que presentan diseños cartesianos del tipo CoreXY. La Ultimaker y la Witbox, máquinas comerciales muy famosas de 1500€ usan este sistema. Por supuesto utilizando herramienta y mano de obra maker salen mucho más baratas, y estos diseños son de coste bajo, que ronda los 300€.

Esta primera usa varillas y rodamientos lineales para permitir el movimiento.
https://www.thingiverse.com/thing:2422839
Esta otra también usa varillas. Es mucho más grande y muchísimo más fea, pero está muy bien documentada y tiene un BOM muy claro con los precios puestos.
http://www.instructables.com/id/Vulcanus-V1-3D-Printer/

Esta otra difiere en que no usa varillas, si no que apoya ruedas directamente en el perfil de aluminio extruido.
https://openbuilds.com/builds/c-bot.1146/

Dando por hecho que se hará con perfiles de aluminio extruido, he estado mirando las opciones disponibles. Los famosos y disponibles V-Slot tienen la particularidad de que hay que comprar tuercas específicas o bien tunearlas con la Dremel
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
He visto los perfiles G-Slot, de MakerGal. Son de fabricación nacional y creo que en general molaría apostar por ellos. https://www.makergal.es/product-page/perfil-g-slot-2020-anodizado-negro
Más o menos se van entre 40 y 50€ en la perfilería comprándolo en MakerGal unos 8m. (he calculado que se usan 6m).

Termino aquí este comment, para reservar fuerzas si todavía no os he conseguido convencer.

GioSunrider, 2018-03-12:
No si eso ya sé que seguro @JorFru pero me refería a comprar rollo los perfiles, tornillería, etc en una ferretería, la placa elegir nosotros cual, la cama hacerla de la medida que queramos; vamos a montarnos un diseño y no un kit que ya viene todo preparado.

daavm, 2018-03-12:
A mi no me termina de convencer, pero si tuviésemos un precio detallado quizá sí. Veo que hay cosas que quizá ya tengamos en la nave que se puedan reutilizar. Alguien se anima a buscar el presupuesto? :)
Lo de tunear tuercas con la Dremel suena bien jeje

Siotma, 2018-03-16:
A mi me gustan todas las ideas que se han propuesto, aunque no podemos dejar de pensar en el global de la subvención para tener cuidado con los costes. Si queréis, el próximo día hacemos un inventario de los materiales disponibles en la nave para construir una nueva impresora. Mientras tanto, estaría genial tener, como dice @daavm, presupuestos detallados de las diferentes opciones.

GioSunrider, 2018-03-21:
Hemos encontrado [está impresora](https://m.gearbest.com/3d-printers-3d-printer-kits/pp_701647.html?wid=89&lkid=13503442) modelo CoreXY por un precio menor de 300 euros. La impresora puede ser un buen bicho metiéndole Bowden y doble extrusor. No sé si os convence.

JorFru, 2018-03-22:
La máquina sugerida por Jorge viene desde el almacén europeo, ya sabéis a
qué me refiero. Significa que no habrá sobresaltos.

Tiene cama caliente, por lo que permitirá a Printer One hacer el bruto con
ABS.
Tiene un tamaño de impresión muy chulo, 330 330 400. Y la máquina tiene
forma de cubo y mide 65cm. Es más grande que las Prusas que tenemos, que
ocupaban 50cm. Habrá que tenerlo en cuenta para el mueble del rack. Aunque
esta máquina quizás se puede plantear que su estructura sirva para soportar
otra máquina encima. No tengo ni idea, lo dejo como idea loca.

Yo me animaría a comprar esta máquina. Pros que veo:

   - Viene desmontada.
   - Trae todas las piezas(o debería)
   - Parece muy modificable
   - Empezaremos (por fin) a hacer pruebas con tubo bowden
   - Es tribarata!
   - Le gusta a Jorge

Contras no le veo ninguna destacable.

El 21 de marzo de 2018, 23:14, Jorge Ramos <notifications@github.com>
escribió:

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

--
*Jorge Frutos de Mingo*

Ingeniería Electrónica Industrial y Automática.
Asociación de estudiantes UC3Music.
Universidad Carlos III de Madrid.

Siotma, 2018-03-22:
A mi me encantaría poder comprar esta impresora, la verdad. Si fuera posible buscar por internet alguna referencia sobre cómo gestionan las facturas en Gearbest, tal vez en algún foro o algo. Es mucha pasta y hay que estar seguros.

Por otra parte, habría que adelantar la pasta...

Si resolvemos estas dos cuestiones antes de mañana, puede quedar pedida antes de irnos de vacaciones!

Siotma, 2018-03-23:
Acabo de hacer el pedido de la [impresora](https://www.gearbest.com/3d-printers-3d-printer-kits/pp_701647.html?wid=89&lkid=13503442).

Ha costado 232,51€. :tada:

JorFru, 2018-04-05:
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
Votación:
Cometer la obscenidad de colocar el embellecedor a la TronXY?

Siotma, 2018-04-07:
El martes día 3 recibí el aviso de llegada de la impresora en mi casa. Como no había nadie, la dejaron en un punto de recogida cercano.

El miércoles día 4 fui a por el paquete:

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

Y el jueves día 5 lo abrimos y empezamos el montaje!

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

La verdad es que queda de maravilla al lado de las demás :heart:

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

De momento la llamamos TronXY, pero se admiten nuevas sugerencias de nombres.

Siotma, 2018-04-07:
Issue de construcción abierta en #57

Cerrando.

Siotma, 2018-05-16:
Recibido reembolso en mi cuenta.

Closed 2018-04-07.

Thread 52 (2018-03-18):

Sustitución de los rodamientos lineales.

GioSunrider, 2018-03-18:
Dado a que se han percibido "traqueteos" en Hija, propongo sustituir los rodamientos líneales por igus.
Una de las ventajas que ofrecen es menor ruido, además de que no requieren ser engrasados.
Solo los he visto disponibles en Amazon. Adjunto [enlace](https://www.amazon.es/Igus®-Rodamiento-deslizamiento-drylin®-rj4jp/dp/B01M4JZ81S/ref=sr_1_1?s=tools&ie=UTF8&qid=1521332722&sr=1-1&keywords=Igus&dpID=41-MnCzDNXL&preST=_SX300_QL70_&dpSrc=srch).

Siotma, 2018-03-18:
Me parece muy buena idea comprar estos rodamientos para probarlos.

Yo he tenido buenas experiencias en [esta tienda](https://www.hta3d.com/es/igus-drylin-rj4jp-01-08-equivalente-a-lm8uu). Tienen envío 24h y si queremos comprar varias cosas igual nos interesa mirar aquí.

GioSunrider, 2018-03-18:
He estado echando un vistazo a la tienda, y tiene muy buenos precios, una vez hagamos lista de materiales podremos incorporar los rodamientos.

David-Estevez, 2018-03-18:
Por añadir experiencia de terceros, comentar que durante el tiempo que trabajé en BQ, mis compañeros probaron los rodamientos de IGUS y comentaron que no les terminaban de convencer porque se acababan desgastando muy rápidamente (no necesitan lubricación porque ellos mismos son el lubricante) y aumentando el juego de los mismos.

No obstante, y como esto son cosas que dijeron otros y no mi propia experiencia, os animo a que los probéis y documentéis si son adecuados para esta aplicación o no.

jgvictores, 2018-03-19:
En su día, lo que hablé con técnicos es que IGUS mola precisamente por la variedad de gamas que ofrece. Esto es, más que marca, hay que ver el producto en cuestión.

Tambien me comentaron que la tecnología esta donde el propio material es el lubricante sufre de lo que comenta @David-Estevez, con lo cual conviene pensar en la caña que se le va a dar. :-)

GioSunrider, 2018-03-19:
Muchas gracias por las aportaciones, lo tendremos mucho en cuenta, yo es un material que desconozco completamente, solo de lo poco que he visto por ahí. Valoraremos entonces el sustituirlos o no.

David-Estevez, 2018-03-19:
Si tenéis dudas puedo preguntar a ver si alguno se acuerda de lo que les pasaba en BQ a los rodamientos...

Siotma, 2018-03-19:
Sería muy útil conocer la experiencia de otros usuarios. De todas maneras, posiblemente la mejor opción sea realizar pruebas con nuestras impresoras ya que estos rodamientos no tienen un precio elevado.

Además, se al realizar el cambio, se podría aprovechar para identificar los rodamientos lineales LM8UU que se hayan estropeado; estoy casi seguro de que nos vamos a encontrar más de uno. Así, en caso de que los IGUS no nos terminen de convencer, podemos volver a colocar los LM8UU sustituyendo los estropeados por otros nuevos que compremos.

En ambas situaciones ganamos!

GioSunrider, 2018-03-19:
ME parece una gran opción, y respecto al la "autolubricación" del IGUS, seguro que echándole 3en1 se desgasta menos, aunque no lo necesite.

JorFru, 2018-03-20:
Echar cualquier otro tipo de lubricante es completamente contraindicado con IGUS.
Y no es que lo diga sólo el fabricante.

Lo siento pero no tengo tiempo para traerte las fuentes de mi argumento. Son casi las pi horas de la noche, quizás mañana...

daavm, 2018-03-20:
Yo uso 3en1 con los IGUS desde hará 5 meses y funciona de maravilla :)

GioSunrider, 2018-03-20:
Han tirado del lado consumista y de sacar pasta y a @JorFru han conseguido engañarle xD

David-Estevez, 2018-03-21:
Hombre, la gracia de los IGUS es precisamente que no hace falta lubricarlos...

Preguntaré y os digo si averiguo algo

JorFru, 2018-03-22:
Lo que hay que escuchar xD
qué poco confiaís!

Investigaré yo tambien! Reportaré por aquí los resultados

2018-03-21 11:42 GMT+01:00 David Estévez Fernández <notifications@github.com
>:

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

--
*Jorge Frutos de Mingo*

Ingeniería Electrónica Industrial y Automática.
Asociación de estudiantes UC3Music.
Universidad Carlos III de Madrid.

David-Estevez, 2018-03-26:
Lo que he averiguado preguntando ha sido básicamente lo que os dije:

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

Y
> Los de IGUS a nosotros en las pruebas mecánicas que hicimos se atascaban con el polvo... se generaba una capa en la superficie que hacía que con el tiempo no deslizasen como el primer día

Más que poner unos IGUS  me recomiendan comprar unos rodamientos de bolas no chinos y tener las varillas bien limpitas y engrasadas.

David-Estevez, 2018-03-26:
Más feedback, esta vez positivo:

> Yo me pasé hace poco de los LM8UU a los igus... y estoy MUY contento. También hay que decir que los LM8UU eran chinos, pero las vibraciones que tenía se han ido, ya no hace apenas ruido y no tengo que engrasar las varillas para que vayan de lujo 👍

Siotma, 2018-03-31:
Vistas las opiniones creo que merece la pena probarlos en nuestras carnes. Sobre todo teniendo en cuenta que no son muy caros...

GioSunrider, 2018-04-01:
Me parece perfecto, el próximo día podríamos ver cuántos necesitamos para poder realizar el pedido.

diegotrap, 2018-04-19:
Acabo de llamar a IGUS, os lo recomiendo, atienden muy bien dudas técnicas :) Me han desmontado un mito que tenía, lo que he aprendido:

* No hace falta que los rodamientos vayan precargados sobre el eje. Yo pensaba que sí y que eso era lo que causaba el juego y atascos de los que habla mucha gente. Ahora pienso que debe ser bastante sensibles a la alineación y por eso pueden tener desgaste prematuro, atascos o juego.
* No hace falta lubricar pero tampoco pasa nada si se lubrican.

Siotma, 2018-10-11:
Esto sigue pendiente, se le podría dedicar algo de presupuesto...

dmarcosm, 2018-10-16:
IGUS: https://fervi3d.com/mecanica/380-igus-rj4jp-01-08-equivalente-a-lm8uu.html

El precio unitario es de 1,30€, habría que ver cuanto queremos gastarnos y para cuántas de las impresoras daría :)

GioSunrider, 2018-10-16:
Yo de momento solo colocaria para hija, para probar. Si vemos que va bien podemos enfocarlo de cara al año que viene mas. con 8-10 igus tendriamos recambios.

Siotma, 2018-10-16:
El carro de X lleva 3 rodamientos. El carro de Y lleva 4. Si compramos alguno extra igual se pierde, a no ser que compremos suficientes como para ponerlos en otra...
Va a ser necesario tener recambios?

dmarcosm, 2018-10-16:
Yo llevo con los míos más o menos un año y no he necesitado recambios para nada. Yo compraría 14 y tendríamos para 2 impresoras :)

Siotma, 2018-10-16:
>
>
> Yo llevo con los míos más o menos un año y no he necesitado recambios para nada. Yo compraría 14 y tendríamos para 2 impresoras :)

14 son 18 euros. Igual es mucho. El objetivo de esta issue era probarlos para ver qué tal van.

A Blacky yo no le pondría porque no es nuestra. Geonosis no necesita porque solo tiene en Z. Spicy y Dédalo no recuerdo cuántos llevan...

De todas formas, yo soy partidario de comprar 7.

dmarcosm, 2018-10-16:
Spicy es Anet A8, lleva 7. Se los ponemos a Hija?

GioSunrider, 2018-10-16:
Yo soy partidario de solo 7 y para Hija.

GioSunrider, 2019-01-13:
Bloqueado por #83

GioSunrider, 2019-02-07:
Avances en #83

David-Estevez, 2019-02-07:
Si queréis comento cuando lleguen por aquí y así no tenemos que estar pendientes de #83 (y se puede cerrar)

GioSunrider, 2019-02-07:
Me parece perfecto, puedes cerrar la otra.

David-Estevez, 2019-02-12:
Habemus rodamientos:

GioSunrider, 2019-02-12:
Genial, asi el proximo dia podremos empezar a colocarlos y a probarlos.

David-Estevez, 2019-02-12:
Están ya en el armario, en la balda de Printer One

Closed 2023-09-28.

Thread 53 (2018-03-18):

Mejoras y proposiciones varias para nuestras impresoras

daavm, 2018-03-18:
Dado que hemos empezado a usar PLA tanto en Blacky como en Hija, propongo, tirando de la subvención, comprar ventiladores de capa para ambas, ya que esto mejoraría las impresiones.

Por otra parte, sugiero plantearnos la posibilidad de ponerle un segundo a extrusor a una de las impresoras (hija?). Lo dejo caer, para que lo discutamos.

JorFru, 2018-03-18:
El uno de los objetivos de ASROB y en particular de Printer One es llevar
la tecnología al máximo exponente.
Tenéis mi voto para el doble extrusor.

El 18 mar. 2018 19:42, "daavm" <notifications@github.com> escribió:

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

Siotma, 2018-03-18:
Los ventiladores son muy necesarios, y además son baratos. Podemos valorar los que hay [aquí](https://www.hta3d.com/es/componentes/electronica/ventiladores), y así agrupamos el máximo número de cosas en un mismo pedido.

Respecto a extrusores, también hay algunos [aquí](https://www.hta3d.com/es/componentes/extrusor/extrusores-completos).

GioSunrider, 2018-03-18:
Respecto a los ventiladores sin problemas, pero respecto a los extrusores, diría que mas que extrusores completos, tirar de motores, rodamiento,... Rollo a parte porque muchas de las piezas las podemos imprimir nosotros.
Propongo el siguiente [Hot End doble](https://www.hta3d.com/es/hotend-dual-v6-estilo-chimera-filamento-1.75-solo-piezas-metalicas), ya que también apoyo el doble extrusor.

Siotma, 2018-03-19:
Ese modelo que propones es fantástico!

Siotma, 2018-03-19:
Por cierto, yo recomiendo decantarnos por la opción con doble garganta de teflón. Este sistema es perfecto para imprimir PLA con Bowden, ya que el teflón llega desde el motor hasta el nozzle a través del mismo tubo, evitando cualquier atasco.

He leído que este sistema aguanta bien hasta los 245 grados, ya que por encima de esa temperatura el teflón se degrada; pero teniendo en cuenta el uso que se le va a dar en la nave, creo que es suficiente.

Si ocurriese la desgracia de que se estropeara el tubo de teflón, bastaría cortar la parte dañada, o si no, reemplazarlo. En [Aliexpress ](https://es.aliexpress.com/item/1M-PTFE-tube-Teflon-Pipe-for-1-75mm-or-3mm-Filament-of-3D-Printer-Parts/32818240272.html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) es super barato.

Siotma, 2018-05-06:
He encontrado ventiladores a buen precio en eBay:

- [40x40x20](https://www.ebay.es/itm/201633351488)
- [50x50x15](https://www.ebay.es/itm/202065718094)

He pensado en pedir uno de cada para probarlos.

Siotma, 2018-05-11:
Realicé el pedido de los ventiladores y llegaron el miércoles. El jueves los llevé a la asociación. Tienen buena pinta, están disponibles en una caja en la balda de Printer One.

jorgercobo, 2018-06-11:
Posible ventilador de capa: https://www.thingiverse.com/thing:2120906

Thread 54 (2018-03-19):

Compra de cámaras para RPi

GioSunrider, 2018-03-19:
Dado que Octoprint esta completamente operativo, mencionado en [#49](https://github.com/asrob-uc3m/impresoras-asrob/issues/49) y funcional, propongo la compra de dos cámaras para RPi que se colocaran una en cada balda para así controlar dos impresoras con la misma.
Propongo [este modelo](https://www.amazon.es/MagiDeal-M%C3%B3dulo-Megap%C3%ADxeles-Seguridad-Raspberry/dp/B06XCSQN7Q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) ya que lo considero que tiene buena calidad y no es caro.

daavm, 2018-03-20:
Dado que la Pi solo acepta una cámara "oficial", propongo comprar al menos una de las 2 USB. Así, si en algún momento decidimos usar una sola raspberry, no se nos queda una de las cámaras inutilizable.

Siotma, 2018-03-20:
Me preocupa la idea de poner una cámara "pelada".
Por una parte me gusta porque es barata y ocupa poco espacio, pero me disgusta que el cable sea corto y nos condicione para la ubicación de la Raspberry. Además, el sensor y la electrónica quedan muy expuestas y se pueden manchar o dañar.
Yo diría que fueran todas USB, para que la longitud del cable nos de más juego y esté más protegida con la carcasa. No hay ningún problema en utilizar un hub USB si se quieren conectar más de 4 dispositivos...

GioSunrider, 2018-03-20:
Era una de las propuestas pero si, me parece bien la compra de Camaras USB, lo unico que se nos sube de precio. El mas barato que he encontrado es [este modelo](https://www.amazon.es/Creative-73Vf077000001-Webcam-c%C3%A1mara-HD/dp/B00935Y7SE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).

David-Estevez, 2018-03-21:
Puede que también os pueda ayudar con esto, aunque sea para las pruebas. ¿Cuántas cámara necesitaríais?

GioSunrider, 2018-03-21:
Cualquiera USB o incluso si hay de Pi nos vale. no se necesita tampoco una calidad excesiva.

David-Estevez, 2018-03-21:
La pregunta es... ¿cuántas?

daavm, 2018-03-21:
En un mundo ideal, necesitamos 4. Pero con 2 de momento nos vale

David-Estevez, 2018-03-21:
Pues os podría proporcionar dos cámaras como la que habéis cogido prestada de RoboFactory.

GioSunrider, 2018-03-21:
Perfecto, muchas gracias. Ahora mismo nos valdría con solo una hasta que se haga el mueble de la granja 😊

David-Estevez, 2018-03-21:
Pues lo mismo de siempre, avisadme cuando sepáis la fecha de la próxima reunión y me paso a daros el material.

GioSunrider, 2018-03-21:
Perfecto jaajajajaj Muchas gracias 😄

Siotma, 2018-04-27:
Sé que ahora mismo nos las han prestado, pero creo que es algo temporal. Podríais referenciar por aquí una cámara válida para que las compremos con el dinero de la subvención? Si es en Amazon o similar, mejor que mejor.

David-Estevez, 2018-04-27:
La idea original de esas cámaras era formar parte de robots, pero de momento no hay ninguno planificado a corto plazo. De todas formas, no está de más conseguir alguna cámara más si tenéis presupuesto.

Por si sirviese de algo, aquí tenéis el link de las cámaras que os prestamos: https://www.pccomponentes.com/logitech-hd-webcam-c270

Siotma, 2018-04-27:
Lo suyo es que las de la granja, se compren con dinero de la granja que para eso se pidió. Esas que tenemos, pueden valer para cualquier otra cosa.

Alguien puede aportar algo sobre el modelo? Es adecuado? Compatible? Caro o barato?

Siotma, 2018-09-14:
En la reunión de ayer se planteó la idea de comprar estas cámaras en tiendas de segunda mano tipo CeX o CashConverters.

Recordad que se debe solicitar factura conforme con el artículo 12.B) de las condiciones de la convocatoria: https://www.uc3m.es/ss/Satellite/Cultura/es/TextoDosColumnas/1371240285442/

Creo que es una gran idea porque no se necesita de cámaras con grandes capacidades y tampoco tienen por qué ser todas iguales, así se dispondría de más dinero para otros gastos.

dmarcosm, 2018-10-02:
Link compra Raspberries: https://es.rs-online.com/web/p/products/1373331/

dmarcosm, 2018-10-02:
Link compra cámaras: https://www.amazon.es/Creative-73Vf077000001-Webcam-c%C3%A1mara-HD/dp/B00935Y7SE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

GioSunrider, 2018-10-02:
Actualmente disponemos 5 impresoras, luego necesitamos 5 cámaras para poder gestionar todas por igual.

Siotma, 2018-10-12:
Acabo de realizar el pedido de 5 cámaras.

GioSunrider, 2018-10-12:
Hooray!!!

Siotma, 2018-10-16:
Hoy he llevado las cámaras a la nave:
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

Closed 2018-10-16.

Thread 55 (2018-03-20):

Quedada de impresoras: trae la tuya!

Siotma, 2018-03-20:
Muchos de los miembros de ASROB tenemos impresoras en propiedad. Todos nosotros queremos nuestras impresoras como a la que más, y las tenemos bien cuidadas y puestas a punto.

Creo que sería muy interesante hacer una quedada en la Universidad en la que cada uno nos llevemos nuestra impresora y las pongamos todas a imprimir:
- Primero, porque **molaría muchísimo**. Calculo que podemos llegar a juntar más de 10 impresoras fácilmente, imagina todas imprimiendo a la vez.
- Segundo, porque es una oportunidad para **aprender unos de otros**. Podremos comprobar qué configuración electrónica, mecánica y de firmware utiliza cada uno, intercambiar impresiones sobre dificultades encontradas durante su uso o calibración y comprobar cómo lo ha resuelto cada uno.
- Tercero, porque con tantas impresoras juntas se pueden **hacer grandes cosas**. Podríamos plantear un reto de impresión, en el que entre todos imprimamos, por trozos, algo grandioso, como por ejemplo, [la mascota de ASROB](https://github.com/asrob-uc3m/recursos-digitales/tree/develop/logos/3d).

Para participar, solo haría falta que cada asistente aporte:
- Al menos, una impresora 3D, preferiblemente dotada de tarjeta SD para no tener que andar con PCs y aprovechar mejor el espacio.
- Filamento y soporte (se puede llegar a un acuerdo a priori sobre qué colores usar).
- Laca y herramientas de despegado de piezas.

Dadas las características de la actividad, creo que debería durar al menos "toda una mañana" o "toda una tarde". Molaría poder hacerlo un sábado pero yo no tengo potestad para abrir la universidad en sábado, así que no lo propongo.

Dejo aquí un doodle para que cada cual indique su preferencia de día y hora: https://doodle.com/poll/x4w4piwathbssqwd

GioSunrider, 2018-03-20:
I'M IN!

David-Estevez, 2018-03-21:
Igual es una idea de olla, pero si lo movemos con gente de fuera (Clone Wars, etc) igual podríamos montar un evento guapo, guapo.

* Pros:
    * Conocer a un montón de gente guay
    * Igual hasta dan créditos por una Printer Party :joy:

* Contras:
   * Limitación de espacio (aunque se podrían buscar alternativas)
   * Organización más costosa

Bueno, yo lo propongo como locura y a ver qué pasa...

daavm, 2018-03-21:
Me gusta la idea de @David-Estevez ,

Quizá lo más problemático como dices sería encontrar el espacio (sin salir de la uni), pero todo es ponerse

GioSunrider, 2018-03-21:
Me gusta también la idea, de hecho yo lo que propuse fue pedir permiso a la uni para organizar este evento en un aula grande y hacer eso, una Printer Party. Igual nos metemos en un jardín, pero molaria.

David-Estevez, 2018-03-21:
También se puede hablar con gente para intentar organizarlo en otro sitio con más espacio. Así sin pensarlo mucho se me ocurre el Medialab Prado, por ejemplo.

daavm, 2018-03-21:
Por listar otros sitios que estarían bien, se me ocurren el Open space de leganes (50 personas?), La Nave en villaverde (lanavemadrid.com)

GioSunrider, 2018-03-21:
Pero para eso habría ya que poner pasta verdad?

daavm, 2018-03-21:
Sería cuestión de mandar mails y ver qué necesitamos.

David-Estevez, 2018-03-21:
Si os mola la idea puedo hablar con la gente del MakeSpace Madrid a ver si se animan a ayudarnos a organizarlo.

daavm, 2018-03-22:
A mi me parece buena idea, así que diría que adelante con ello.

GioSunrider, 2018-03-22:
A mi también. Así que podemos mirarlo.

JorFru, 2018-03-22:
Si la organización de el resto de eventos que tengo me lo permiten, estoy
dentro chavales.
Me refiero al hackatón ASROB-UC3Music

2018-03-22 14:46 GMT+01:00 Jorge Ramos <notifications@github.com>:

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

--
*Jorge Frutos de Mingo*

Ingeniería Electrónica Industrial y Automática.
Asociación de estudiantes UC3Music.
Universidad Carlos III de Madrid.

Siotma, 2018-03-22:
Por una parte, me encantaría poder aspirar a un evento tan chulo como el que proponéis. El problema que le veo es que luego igual la asistencia es un fracaso...

La finalidad de esta issue no es tan ambiciosa y creo que podría ser un buen punto de partida organizar algo pequeño a nivel de ASROB, buscando fomentar la participación interna, para en el futuro organizar algo más grande si nos vemos con ganas.

Dado que actualmente en el doodle solamente hay apuntadas 3 personas, no sé si es buena idea querer volar tan alto cuando aún no hemos empezado a caminar.

daavm, 2018-03-22:
Si organizaciones más grandes como MakeSpace Madrid nos ayudan yo creo que la asistencia no tendría por qué ser un fracaso, no?

David-Estevez, 2018-03-27:
Yo he mandado un mail por si acaso y os voy diciéndo qué les parece la idea.

GioSunrider, 2018-03-31:
Como va a quedar la cosa al final?

Siotma, 2018-03-31:
De momento somos 3 apuntados! :sweat_smile:

JorFru, 2018-03-31:
Sí, y uno es un tío random que no conocemos de nada.
https://thesongswelove.files.wordpress.com/2014/11/giorgio.jpg?w=625&h=390&crop=1

El sáb., 31 mar. 2018 18:20, Manuel Peña Fernández <notifications@github.com>
escribió:

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

Siotma, 2018-04-07:
Me parece que de momento esta idea va a tener que replantearse, porque la participación no ha tenido mucho éxito.

jgvictores, 2018-04-08:
La idea mola... A ver si conseguimos a más gente para el día 12-13. :- )

Repito link: https://doodle.com/poll/x4w4piwathbssqwd

cc: @diegotrap ??
cc: ((@asrob-uc3m/impresoras inserten vuestros contactos aquí))

jgagom, 2018-04-08:
Me apunto a llevar la mía si es el 12! Aunque habrá 3h en las que tendré que estar en la nave con el autómata porque tengo clase. Tiene muy buena pinta el evento, a ver si se anima más gente!

Siotma, 2018-04-09:
Parece que podemos todos el jueves por la tarde, conque voy a establecer ese día y lo rulamos por los grupos para ver si más gente se anima! :wink:

Siotma, 2018-04-09:
Yo no podré llegar hasta las 18:00 o algo más tarde, pero en cuanto llegue me pongo al día!

Thread 56 (2018-03-21):

Actualizar router ASROB

David-Estevez, 2018-03-21:
Ya que estáis en proceso de montar una granja de impresoras, y nuestro router está empezando a fallar (yo por ejemplo soy incapaz de conectarme a él desde el portátil), propongo la compra de uno en condiciones.

Si no teníais contemplado el gasto, puedo cederos un par de webcam de RoboFactory (https://github.com/asrob-uc3m/impresoras-asrob/issues/54#issuecomment-374954608) para que podáis comprar uno con el dinero que os ahorréis, y así ganamos todos.

GioSunrider, 2018-03-21:
Tengo que ver por casa, igual nos vale uno que tengo yo que está sin usar y que lo podría ceder sin problema. Pero igual nos merece la pena comprar uno en condiciones. Podemos debatirlo sin más. Y gracias @David-Estevez por el ofrecimiento de las cámaras.

JorFru, 2018-03-22:
Yo tengo en casa cinco o seis router de timofónica y otras empresas
similares. Sé que no valen para nada.

Si hubiese que comprar uno nuevo, hace no mucho discutí con Daeste cuál era
el adecuado para ASROB. Los miré en Amazon y salían a 40 paveles. Creo que
era un ASUS con Gigabit y con WiFi bibanda. Tendría que refrescarlo.
Si hay que decidir cuál, avisadme y lo busco.

El 21 de marzo de 2018, 16:56, Jorge Ramos <notifications@github.com>
escribió:

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

--
*Jorge Frutos de Mingo*

Ingeniería Electrónica Industrial y Automática.
Asociación de estudiantes UC3Music.
Universidad Carlos III de Madrid.

Siotma, 2018-03-22:
Hay que tener en cuenta que el caso de uso del router de la granja es bastante básico:

- Un router con varios puertos capaz de establecer una LAN cableada con las raspis y con un PC de control.

No necesitamos ni Gigabit, ni doble banda ni nada :laughing: el único requisito es la fiabilidad para que el aparato funcione de forma estable durante un tiempo indefinido.

Por tener, yo también tengo un router en casa. Es un comtrend con 4 puertos y wifi g.

David-Estevez, 2018-03-22:
Todas esas features son pensando en que ese router pueda ser aprovechado por el resto de grupos activos de la asociación sin perjudicar el buen funcionamiento de la granja.

Pero oye, abiertos a donaciones estamos :blush:

Siotma, 2018-03-31:
El router que pongamos en la granja, se debería quedar en ella permanentemente. Es posible que a la hora de realizar ciertas acciones con él, el servicio pudiera quedar afectado o interrumpido. Pudiendo dedicar un router cutre a la granja, yo no me complicaría la vida compartiendo uno muy bueno.

Siotma, 2018-05-01:
Related https://github.com/asrob-uc3m/impresoras-asrob/issues/65#issuecomment-385659743

GioSunrider, 2018-11-27:
Cierro esta issue dado que como se muestra en #98 se ha instalado un router permanente para gestionar la granja de impresoras, ademas de que el router de la asociacion, actualmente en uso por Robodevastation, se le ha habilitado una conexion en la roseta como se muestra en #65 . Abrire una issue en actas cuando encuentre el router por casa para donarlo.

Closed 2018-11-27.

Thread 57 (2018-04-07):

Montaje de Geonosis

Siotma, 2018-04-07:
Esta issue es para documentar y gestionar el proceso de montaje de la nueva impresora.

Para cerrar esta issue al menos:

- [x] Se construirá la impresora por completo, documentando gráficamente el proceso y el resultado.
- [x] Colocar la electrónica y los cables con doble ración de epicness.
- [x] Se reflejarán los problemas surgidos durante el montaje y se aportarán ideas para resolverlos.
- [x] Se realizará la primera impresión.
- [x] Se documentarán los perfiles de impresión y los archivos de configuración en este repositorio.

El último día estuvimos siguiendo [este manual](http://nathan.vertile.com/blog/2018/01/11/tronxy-x5s-build-guide/) de montaje y también fue útil [este otro](http://diy3dtech.com/gearbest-tronxy-x5s-3d-printer-manual/).

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

Manos a la obra!

daavm, 2018-04-09:
La impresora ha quedado montada entre el pasado jueves y la mañana de hoy. Hemos hecho la primera impresión (un calicat!) y no ha salido para nada mal :) Dejo algunas fotos del proceso y de dicha impresión:

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

Además, @JorFru ha hecho un cable management de los suyos :D
## **Antes:**
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
## **Después:**
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

daavm, 2018-04-09:
**Problemas encontrados durante el montaje:**

- Uno de los perfiles no tenía la rosca bien hecha y los tornillos no apretaban. Tras intentar poner arandelas para que apretase sin éxito, optamos por darle la vuelta y usar el lado sin forma (?), ya que no era imprescindible en ese caso usarla con la orientación "correcta"
- Según comenta @JorFru, el cable de uno de los motores de Z no llega bien a la placa al hacer el buen cable management, le faltan unos 10cm, por lo que habría que hacer un empalme para que quede bien del todo.
- La cadeneta horizontal que va por encima de la cama estaba algo defectuosa. Uno de los extremos no enganchaba bien con el anterior eslabón y por lo tanto quedaba un poco caída (con el tiempo podría llegar a caer más y chocar con la cama supongo). Hemos optado por ponerle una brida y ha quedado arreglado, al menos de forma temporal.
- La pieza donde se atornilla la cadeneta del eje Z tenía los agujeros muy pequeños y al principio no entraban los tornillos. Simplemente los hemos agrandado un poco con un destornillador y el problema ha quedado resuelto.

**Otras observaciones:**
Falta por poner la tapa/ventilador de la placa. Apoyo una idea que ha dado @JorFru, y es que es una pena tapar por completo una placa que ha quedado tan bien. La sugerencia es imprimir un soporte para el ventilador que deje más a la vista la placa (como el que tiene Hija, por ejemplo). También cabe la posibilidad de cortar el acrílico que ya tenemos :)
Por último, la cama nos ha parecido un poco cutre. De primeras, al calibrar la impresora por primera vez se ve que nos hemos acercado demasiado y ha quedado una pequeña marca, que no es muy notable pero ahí está. Hemos hablado de que quizá no sería mala idea cambiar la base de acrílico por un cristal de 330x330mm, que no sería muy caro.

Siotma, 2018-04-09:
El resultado es fantástico!

Creo que puedo ayudar en el tema del espejo: [en IKEA los tienen de 30x30](https://www.ikea.com/es/es/catalog/products/39151700/) :+1:

GioSunrider, 2018-04-10:
Creo que si ponemos cristal la plancha magnetica va a servir de poco por el peso del cristal. Mejor imprimiria las piezas de las esquinas.

daavm, 2018-04-10:
> Creo que si ponemos cristal la plancha magnetica va a servir de poco por el peso del cristal. Mejor imprimiria las piezas de las esquinas.

No te sigo. Qué tiene que ver el peso del cristal?

GioSunrider, 2018-04-10:
que pude haber movimientos faciles de que se vaya mientras imprime, como en algun momento haya un minimo error y roce la punta puede desplazar con mayor facilidad el cristal, a eso me refiero.

daavm, 2018-04-10:
A mi me gusta también más la solución de las piezas impresas, que conste (por aquello de hacerlo nosotros), pero el cristal con el iman no se mueve con un toquecito.

GioSunrider, 2018-04-10:
Si has hecho pruebas con cristal votare a favor, pero creo que con la lamina de PEI hay muchas diferencias que no se pueden aplicar a un cristal.

David-Estevez, 2018-04-10:
Le pongas lo que le pongas no se va a mover porque la base sólo se desplaza en Z

GioSunrider, 2018-04-10:
Por moverse me refiero, que el extrusor choca con una pieza impresa, y esta al hacer la fuerza la cama se acabe desplazando, pero oye, si lo veis con fuerza adelante jajajajaja a mi me gustan mas las pinzas de extremos.

GioSunrider, 2018-04-12:
Hombre en cuanto a precio igual unas planchas de neodimio se nos va la olla ajajajajaja
Y en cuanto a eso como queráis, si queréis imanes adelante, no me opondré xF

David-Estevez, 2018-04-12:
Planchas no, con poner uno en cada esquina es suficiente. Un plancha yo creo que no la despegas ni de coña (igual tú sí, pero por tu fuerza sobrehumana :sweat_smile: ).

GioSunrider, 2018-04-12:
Jajajaajajaja es que creo que @daavm se refería por imanes a planchas que es lo que trajo un día, pero si, igual poniendo imanes en las direcciones de las camas sale un buen resultado.

daavm, 2018-04-12:
Yo hablaba de planchas de estas flexibles, pero lo de los imanes no es mala idea :+1:

Siotma, 2018-04-27:
@dmarcosm cierra esta issue como acordamos ayer.

JorFru, 2018-06-21:
https://youtu.be/4DUhI9M5A28

Closed 2018-04-27.

Thread 58 (2018-04-15):

Nombre para la TronXY

Siotma, 2018-04-15:
Necesitamos bautizar nuestra impresora, ya que quedó pendiente de #51 .

De momento he recopilado las ideas que se han ido dando:

- TronXY (el más original).
- StarKiller (nombre del planeta que destruye mundos en Star Wars VII).
- DeathStar (la Estrella de la Muerte dos veces destruida).
- Geonosis (planeta donde se fabrican droides de combate en el que C3PO dice la famosa frase de "robots fabricando robots, qué obscenidad").
- Caliprinter (porque se parece a un cubo de calibración).
- Borg (Cubo Borg es el nombre de el transporte interestelar de los aliens Borg en la saga Star Trek).
- C-Borg (como Borg pero suena a ciborg).
- XY-Borg (como Borg, pero suena parecido a ciborg y además mola porque es una CoreXY).
- Mjölnir (Como el martillo de Thor Dios del trueno! Porque nadie la va a poder levantar más que los dignos de ello)

Se aceptan todo tipo de sugerencias y comentarios.

Propongo seguir el siguiente esquema:
- [x] Lluvia de ideas hasta el próximo domingo.
- [ ] Votación.

David-Estevez, 2018-04-15:
Caliprinter (porque se parece a un cubo de calibración)

JorFru, 2018-04-16:
Sugiero el nombre "Borg"
Se que es un nombre feo, pero tiene su explicacion.
Cubo Borg es el nombre de el transporte interestelar de los aliens Borg en la saga Star Trek.

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

GioSunrider, 2018-04-16:
Ya que te pones ponle C-Borg, que hasta si lo pronuncias parece un ciborg xD

JorFru, 2018-04-16:
C-Borg, definitivo

Siotma, 2018-04-16:
XY-Borg?

Actualizo la lista..

David-Estevez, 2018-04-16:
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

:joy: :joy: :joy:

GioSunrider, 2018-04-16:
Y, Mjölnir!? Como el martillo de Thor Dios del trueno! Porque nadie la va a poder levantar más que los signos de ello jajajajaajajaj

Siotma, 2018-04-21:
Hoy es el último día para aportar ideas, mañana abriré votación con los nombres que haya.

Siotma, 2018-04-22:
Votación abierta hasta el próximo jueves en https://goo.gl/forms/p1yVrF4RrPuYFcl52

Siotma, 2018-04-26:
Acabo de cerrar la votación. De 8 votantes, Geonosis ha sacado 4 votos, más que ninguna otra. Los resultados se pueden ver pulsando el enlace del form: https://goo.gl/forms/p1yVrF4RrPuYFcl52 .

TronXY: 3 votos.
StarKiller: 2 votos.
DeathStar: 1 voto.
**Geonosis: 4 votos.**
Caliprinter: 2 votos.
Borg: 1 voto.
C-Borg: 3 votos.
XY-Borg: 0 votos.
Mjölnir: 1 voto.
El que queráis, pesados: 1 voto.

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

Adorad a Geonosis!

Closed 2018-04-26.

Thread 59 (2018-04-18):

Extrusor de pellets

dmarcosm, 2018-04-18:
Hago la propuesta de hacernos un extrusor de pellets. Dicho extrusor funcionaría usando restos de pla (que tenemos MUCHOS restos), y usaría un tornillo sinfín para empujar los pellets por un barrel/cuerpo modificado (más ancho). En el armario hay algunos materiales que podríamos usar para este proyecto si nos animamos a llevarlo a cabo.
Ideas, sugerencias y opiniones son agradecidas :+1:

GioSunrider, 2018-04-18:
A mí como idea me mola, y a ver cuando montemos la granja me ofrezco como tributo para la ayuda jajjaajaj

JorFru, 2018-04-18:
Le veo futuro a la idea, me uno!
Podemos tomar ideas de este proyecto:
mahor.xyz

rsre, 2018-04-18:
Tengo entendido que el PLA se degrada con cada ciclo de vida. Un paper sobre el asunto: https://www.google.es/url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

Joder, en el móvil es imposible copiar el enlace de verdad.

GioSunrider, 2018-04-18:
Si, se degrada, obviamente no vamos a conseguir grandes piezas pero podemos cubrir muchas que no necesitamos que queden bien del todo. Y también tenemos mucho PLA roto antes del uso así que en ese sentido vamos bien.

dmarcosm, 2018-04-18:
> Le veo futuro a la idea, me uno!
Podemos tomar ideas de este proyecto:
mahor.xyz

De hecho lo que tenía en mente es casi lo mismo que ese proyecto!

> Tengo entendido que el PLA se degrada con cada ciclo de vida.

Yo pensaba mas de cara a usar filamentos rotos que tenemos como dice Jorge. También a usar pellets comprados directamente (el kg está a unos... 8/9€). Y sobre todo... por el progreso! Todo es probar :D

David-Estevez, 2018-04-19:
Tenéis a alguien que hizo esto mismo: Diego Trapero. Quizá él os pueda aconsejar sobre la viabilidad de este proyecto basado en sus experiencias.

jgvictores, 2018-04-19:
cc @diegotrap : )

diegotrap, 2018-04-19:
Sí, mi trabajo de fin de grado fue un extrusor de pellets, aún lo tengo. Creo que os referís a un extrusor para impresora 3D, no de filamento, pero os cuento mi experiencia igual.

Todos los archivos los publiqué: https://github.com/diegotrap/filament_extruder. Hay sketches de Arduino, modelos 3D, cuadernos de iPython... Los resultados están en mi TFG: https://e-archivo.uc3m.es/handle/10016/20112 (sorry por los 77Mb).

Un extrusor de filamento doméstico económicamente no tiene sentido y es muy dificil de hacer que produzca filamento con diámetro consistente. Para aprender sí que puede valer si tienes interés.

Un extrusor tipo Mahor sí que puede funcionar. Económicamente tampoco es un ahorro pero para probar a reciclar, para usar materiales raros y para aprender sí que vale. No sé como funcionará, Miguel Angel Salmerón [dice que va muy bien](https://www.youtube.com/watch?v=OsXVroP8Dg4).

dmarcosm, 2018-10-15:
Cierro por no haber ganas de hacerlo y por tener proyectos más interesantes a la vista! Si eso reabrimos en el futuro :)

Closed 2018-10-15.

Thread 60 (2018-04-21):

Compras para la granja de impresoras

Siotma, 2018-04-21:
En la última reunión identificamos algunas cosas que hay que comprar para la granja.

La idea es ir proponiéndolas por esta Issue para que no se nos olviden.

Si alguien compra algo, primero debe quedar acordado aquí, no vaya a ser que lo compremos por duplicado. Recordad que hay que pedir factura con la siguiente información:

> Universidad Carlos III
Dpto. Ingeniería de Sistemas y Automática
Avda. de la Universidad 30
Leganés 28911
CIF: Q2818029G

- [ ] Regleta de 5 metros con mínimo 8 tomas de corriente, e interruptor. (Para las impresoras, el router y las raspberrys).
- [ ] Regleta de 3 metros con mínimo 5 tomas de corriente e interruptor. (Para poder poner hasta 2 PCs, 2 pantallas y la Arcade).
- [ ] Cámaras web #54
- [ ] Placas RaspberryPi y tarjetas SD #49
- [ ] Cables Ethernet
- [ ] MOSFET para Geonosis.
- Se aceptan propuestas hasta el miércoles 3 mayo a las 23:59.

David-Estevez, 2018-04-21:
Ojo, si las compras son a china, los que llevan las cuentas prefieren que no se facture a nombre de la Universidad, sino a nombre de la asociación (que va a estar complicado) o a nombre de la persona que lo compra. Al memos eso nos dijeron la última vez...

Siotma, 2018-04-21:
Exacto! No lo he puesto porque en mi cabeza todas las compras necesarias se pueden hacer en una ferretería de barrio, pero en caso de que lleguemos a pensar en aliexpress o similar hay que tener eso muy en cuenta!

GioSunrider, 2018-04-23:
Y unos interruptores GPIO para poder apagar las impresoras a través de las RPis?

JorFru, 2018-04-24:
Anoto que la TronXY necesita un MOSFET para la cama, el suyo se pone horroroso de caliente. Es una mejora que añadirá seguridad a nuestra granja. Cuestan en torno a 8€. También se podría mirar comprar dos, por si surge una nueva impresora con la misma electrónica mierder.

Siotma, 2018-04-26:
El tema de los interruptores GPIO no me convence. De momento vamos a intentar montar la granja y eso vendrá en el futuro, una vez todo funcione.

Lo que sí me parece urgente es lo del MOSFET. Lo añado.

Seguid comentando!

Siotma, 2018-04-29:
Me he dado cuenta de que esta issue es exactamente eso que digo que no se debe hacer, citándome a mi mismo:

> Issues con tareas abstractas o muy abiertas no son eficientes porque siempre aparecen nuevas cosas que hacer y parece que es impsible cerrarlas. Además, este tipo de issues, así como las ideas que se dan en ellas, se pierden con el tiempo...

Declarada inválida.

Closed 2018-04-29.

Thread 61 (2018-04-24):

Puesta a punto de Geonosis

JorFru, 2018-04-24:
Abro issue para comentar las mejoras que se le harán a esta máquina.

Problema detectado: los cables del hot-end se calientan, no mucho pero se hacen notar, a lo largo de todo el cable. Esto seguramente sea por la baja calidad del cableado y su sección escasa. Habría que recablear con cable siliconado, hay stock en el armario, en la zona "maraña de cables".

- [ ] Recablear hot-end
- [x] Resolver Thermal Runaway del Hotend ( https://github.com/asrob-uc3m/impresoras-asrob/issues/61#issuecomment-386885856 ).
- [x] Imprimir soportes de motores X e Y : https://www.thingiverse.com/thing:2613150
- [x] Imprimir un mejor ventilador de capa, actualmente gran parte del aire va casi directo al extrusor: https://www.thingiverse.com/thing:2706922/#files
- [x] Ajustar y tensar correas.
- [ ] Recolocar la pantalla para que se vea mejor desde esa altura.

dmarcosm, 2018-04-25:
Otra mejora que se le hará es imprimir los soportes de los motores de X e Y: https://www.thingiverse.com/thing:2613150
Otra cosa interesante que deberíamos imprimir es un mejor ventilador de capa. Actualmente gran parte del aire va casi directo al extrusor: https://www.thingiverse.com/thing:2706922/#files
Por último, hay que ajustar las tensiones de las correas y valorar si queremos hacer algún cambio a los rodamientos de las correas, ya que están como torcidos y hacen que estén moviendose arriba y abajo todo el rato.

dmarcosm, 2018-04-25:
Se me olvidó comentar el tema de la pantalla. Quizá no sea necesario al ponerla en la estantería. Pero si se va a quedar a la altura a la que está ahora, sería interesante mover la pantalla a la esquina superior derecha de la estructura, ya que tan abajo no se ve nada.

JorFru, 2018-04-25:
Para lo que dice David sobre la pantalla, habría que comprobar si los
cables llegan o en su caso se pueden empalmar.
Yo sugiero imprimir una chorripieza para colocar la pantalla en ángulo.

2018-04-25 12:31 GMT+02:00 dmarcosm <notifications@github.com>:

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

--
*Jorge Frutos de Mingo*

Ingeniería Electrónica Industrial y Automática.
Asociación de estudiantes UC3Music.
Universidad Carlos III de Madrid.

dmarcosm, 2018-04-27:
> Hay que ver también porque ayer cuando fuimos a imprimir, en la cuarta capa, se desplaza completamente. @anacarnerero y yo probamos a tensar las correas pero seguida el mismo problema. Hay que investigar el porque, ya que en ambos gcodes realiza exactamente el mismo desplazamiento.

A qué velocidad se estaban imprimiendo esos gcode?

Siotma, 2018-04-27:
Respecto a la pantalla, me gusta más la idea en ángulo, pero abajo, que subirla arriba, ya que estorbaría el campo de visión hacia la maravilla que es esta impesora imprimiendo.

dmarcosm, 2018-04-27:
> Hay que ver también porque ayer cuando fuimos a imprimir, en la cuarta capa, se desplaza completamente. @anacarnerero y yo probamos a tensar las correas pero seguida el mismo problema. Hay que investigar el porque, ya que en ambos gcodes realiza exactamente el mismo desplazamiento.

Me acabo de acordar que uno de los primeros días que imprimimos pasó lo mismo, y llegué a la conclusión de que era culpa de sobreextrusión. De vez en cuando dejaba pegotes, y si da la casualidad de que cruza por encima de ese pegote, intenta llevarselo por delante y pierde pasos. Quizá puede ir por ahí el problema.

Siotma, 2018-04-28:
> De vez en cuando dejaba pegotes, y si da la casualidad de que cruza por encima de ese pegote, intenta llevarselo por delante y pierde pasos.

Eso es un problema muy habitual con cualquier impresora. Habría que calibrar los pasos/mm del extrusor y seguir perfeccionando los perfiles, sobre todo jugar con la retracción...

David-Estevez, 2018-04-28:
Lo extraño es que siempre la impresión de estropee en el mismo punto exacto... Tiene más pinta de ser cosa del gcode...

dmarcosm, 2018-04-28:
Yo creo que justo por eso @daeste. Va dejando pegotes, pero no siempre vuelve a pasar por ellos de forma que quiera atravesarlos.
Entonces digamos que en la linea 645 de gcode deja el pegote, y en la 756 lo intenta atravesar. Eso va a pasar siempre que se use ese gcode, dejando el desplazamiento siempre en la misma altura.

David-Estevez, 2018-04-29:
Pero la pérdida de pasos por pegotes, que también la he sufrido alguna vez en Dédalo, hace que se pierdan pasos en distintas capas y que no siempre se pierda la misma cantidad de pasos. En mi experiencia, no suele ser tan repetible.

Siotma, 2018-05-06:
En la reunión del pasado jueves, Geonosis no pudo imprimir ninguna pieza al dar sucesivos errores de Thermal Runaway del extrusor. Se sospecha que el problema es que el ventilador de capa echa aire directamente sobre el hotend.

Propongo:
- Ejecutar el [PID Tuning](http://reprap.org/wiki/G-code/es#M303:_Run_PID_tuning) para asegurarnos de que el regulador PID de temperatura está bien ajustado.
- Taponar parcialmente la salida del aire del ventilador de capa para ver si el problema desaparece.

En [este manual](http://nathan.vertile.com/blog/2018/01/11/tronxy-x5s-build-guide/#x-and-y-carriage) dice:

> [...] I suggest printing this cooling system and installing it now: https://www.thingiverse.com/thing:2706922. You'll also need this adapter plate, if the included flan is a blower type: https://www.thingiverse.com/thing:2765424. The standardshroud will work OK as well, but is much less convenient, as the metal case covers the entire hot end. So, you can print one once you get your first printer set up!

Queda fuera de servicio hasta resolverse este problema.

dmarcosm, 2018-06-14:
En una de las sesiones anteriores se colocaron en Geonosis las piezas que imprimió Dédalo. Todo bien exceptuando que el ventilador de capa podía llegar a chocar con los perfiles, así como tener que cambiar la dirección del endstop de X en Marlin.
Para solventar lo primero, optamos en la siguiente reunión por imprimir unas piezas nuevas (@GioSunrider sabe cuáles son), que ya quedaron colocadas, y que colocaba el ventilador encima del extrusor en lugar de a un lado.

Siotma, 2018-06-16:
Parece ser que las piezas nuevas que menciona @dmarcosm son estas: https://www.thingiverse.com/thing:2828421

Siotma, 2018-06-16:
En la última reunión se reimprimió la pieza que sujeta el ventilador del extrusor, porque había quedado muy frágil con ABS. Al parecer es un problema de diseño porque con PLA también quedaron algunas paredes muy finas. Sin embargo, al montarlo todo sobre la impresora ya quedó más sólido. Para añadir fiabilidad, añadimos pegamento termofusible para que diera consistencia a las piezas una vez colocadas.

El ventilador de capa también está fijado con cola termofusible a la parte superior.

El acabado es muy bueno, y el ventilador de capa consigue enviar bastante aire sin enfriar el extrusor. Se deben realizar pruebas de impresión para confirmar que este problema está por fin resuelto.

Este es el aspecto actual del extrusor de Geonosis:

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

dmarcosm, 2018-06-21:
Hoy hemos empezado a afinar un perfil de Slic3rPE para Geonosis. Esta es la pieza que mejor ha podido imprimir tras afinar algunos ajustes:
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
No estoy seguro de si el ventilador de capa está funcionando del todo bien (es posible que se esté saliendo algo de aire por arriba y que a la pieza no le llegue lo suficiente), pero por lo general la pieza ha quedado muy muy fina. Ha impreso a unos 80mm/s

GioSunrider, 2018-11-27:
Necesito actualizacion de est issue, creo que @dmarcosm imprimio ya los soportes de los motores

Siotma, 2018-11-27:
> creo que @dmarcosm imprimio ya los soportes de los motores

los imprimí yo con hija: https://github.com/asrob-uc3m/impresoras-asrob/issues/90

GioSunrider, 2018-12-15:
Por el plan de issues genéricas dejo pendiente lo que hay que hacer. Además que está sigue en #114 y está casi completado. Dejo pendiente a @JorFru encargado del recableado ya que demostró habilidades que el resto no, con un grandísimo resultado.

Closed 2018-12-15.

Thread 62 (2018-04-26):

La MEGA de Blacky ha muerto

Siotma, 2018-04-26:
Hay que comprar una nueva Arduino MEGA para Blacky, pues la que tenía ha muerto.

Se puede reutilizar https://github.com/asrob-uc3m/impresoras-asrob/issues/48#issuecomment-372278058 :

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

Adjunto foto:

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

Siotma, 2018-04-27:
Alguno tiene Amazon Prime para conseguir la OPCION 1 con envío gratis?

David-Estevez, 2018-04-27:
Independientemente de que se compre una placa nueva, crees que merece la pena reparar la placa quemada?

Siotma, 2018-04-27:
Podría merecer la pena, pero no para ponerla en una impresora, sino más bien para tenerla para prototipar...

David-Estevez, 2018-04-27:
Sí, mi idea era más bien tenerla "de repuesto" por si alguna vez hace falta echarle mano para lo que sea.

dmarcosm, 2018-04-27:
Quizá sería lógico comprobar primero con otra RAMPS (la de Hija, mismamente), que ningún otro componente se ha visto afectado, así si hay que comprar más cosas las compramos de una sola vez, no?

GioSunrider, 2018-04-27:
>Alguno tiene Amazon Prime para conseguir la OPCION 1 con envío gratis?

Yo, y podria comprarla sin problemas. Pero la idea de @dmarcosm me parece muy adecuada.

Siotma, 2018-04-28:
Además, yo creo que la placa se quemó por culpa de un contacto indirecto de la cadena de anclaje con la electrónica. Tiene pinta de que la parte quemada actuó de fusible evitando daños mayores. De todas formas, cuanto antes pidamos la placa, antes podremos hacer pruebas y volver a tener a Blacky operativa.

> Yo, y podria comprarla sin problemas.

Recuerda solicitar factura acorde con la normativa de subvenciones, disponible [aquí](https://www.uc3m.es/ss/Satellite/Cultura/es/TextoDosColumnas/1371240285442/) (ver artículo 12).

GioSunrider, 2018-04-29:
Si sale mas barato adelante, yo en ebay jamas he comprado nada asi que no tengo opiniones.

Siotma, 2018-05-06:
Aceptada la compra entonces. Compraré dos unidades para tener una de repuesto y prototipado.

Siotma, 2018-05-11:
Realicé el pedido y llegó el miércoles. El jueves lo llevé a la nave.

@GioSunrider estuvo realizando el cambio de placa y nos puede contar más detalles...

GioSunrider, 2018-05-15:
Hay pocos detalles que añadir, lo primero se subió el Marlin a la placa sin ningún problema y se conecto a la ramps con comprobación de las conexiones. Una vez instalado todo, se procedio a la conexion de la fuente de alimentacion. Se encendio correctamente y al ir a hace Home All, se apago de repente. En ese punto desconecte la fuente de alimentación y efectivamente olia a quemado y el regulador de la nueva placa habia muerto. @Siotma intento sustituirlo por el de la anterior pero no coincidian asi que se queda como tarea pendiente.

Siotma, 2018-05-19:
En la última reunión, realicé un proceso de diagnóstico de la placa que se quemó:

En la reunión anterior se quemó el regulador de la MEGA, pero comprobé si seguía funcionando por USB: afirmativo, la placa está en buen estado, tan solo le falta el regulador para funcionar alimentada por VIN, por tanto no sirve para las impresoras. El regulador que llevaba es un AMS1117-5.0 formato SOT223. Al desoldar el que tenía, se rompió el pad 2 en la placa, pero está disponible a través del tab, por lo que yo creo que se podría poner uno nuevo. No obstante, no sé si merece la pena ponerle un regulador o dejarla para prototipar por USB. Digo esto, teniendo en cuenta que hay otras dos nuevecitas que compramos (https://github.com/asrob-uc3m/impresoras-asrob/issues/62#issuecomment-386871106).

Actualmente la placa está en el armario, dentro de una bolsa con una nota que explica lo anterior.

Foto:

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

Siotma, 2018-05-19:
Aprovechando que tenía una MEGA funcional, pero sin regulador, pensé que era una oportunidad perfecta para diagnosticar el fallo de Blacky que había acabado con el regulador: En una placa sin regulador, no se puede quemar el regulador, y en caso de sobre consumo, al estar conectada por USB, la protección del puerto apagaría todo el sistema. Así lo hice.

Conecté la placa a la RAMPS de Blacky y fui conectando cables poco a poco, comprobando que funcionaba cada uno:
1. Conecté el extrusor y probé a calentar: funcionaba de forma intermitente. Comprobé que la clema de la RAMPS estaba en mal estado y solo hacía contacto si apretabas con el dedo. Sustituí la clema por una nueva y el problema se solucionó. El extrusor calentaba bien.
2. Conecté la cama y probé a calentar. Todo correcto.
3. Cogí un pololu y fui probando todos los zócalos con él, y con el motor del extrusor: los zócalos de X, Y, Z, E0, funcionan correctamente.
4. Cogí todos los pololus y los fui probando en el zócalo del eje X con el motor del extrusor: todos los pololus están en buen estado.
5. Coloqué cada pololu en su posición y fui probando los ejes, finales de carrera incluidos. Todo correcto. Tan solo detecté que un cable del motor del eje Y estaba despeluchado a la altura del conector y corría riesgo de hacer cortocircuito con los pines cercanos. Cambié el crimp y lo dejé saneado.
6. Conecté la pantalla y probé a controlar la impresora desde ella: funcionó correctamente.

A estas alturas la placa tenía todas las conexiones y funcionaba correctamente. El puerto USB no parecía estar sufriendo. Así que me la jugué, flasheé otra MEGA nuevecita y se la puse, conectando todo poco a poco igual que lo he descrito antes.

El resultado fue satisfactorio y di a Blacky por arreglada, coloqué la placa en su sitio y la pusimos a imprimir:

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

Closed 2018-05-19.

Thread 63 (2018-04-26):

Cable management en Dédalo

Siotma, 2018-04-26:
Los cables de Dédalo son un peligro para todos y para sí misma.

Ahora que le hemos puesto una placa nuevecita, molaría dejar la impresora en condiciones para que dure funcionando mucho tiempo, para ello propongo, al menos:

- [x] Aumentar la longitud del cable del ventilador de capa, y conducirlo paralelo a los demás cables que van al extrusor.
- [x] Revisar que ningún cable estorba el movimiento de ningún eje.
- [x] Imprimir un soporte donde atornillar la OVM20.
- [x] Imprimir un soporte para la pantalla (por ejemplo [este](https://www.thingiverse.com/thing:848151)).
- [ ] Investigar si se puede modificar el Marlin para poder dar la vuelta el cable del motor Y para que quede orientado igual que los demás.
- [ ] Cambiar el cable de potencia de la cama por otro con mayor sección.

Y como extra:

- [x] EXTRA: quitar todas las bridas y retirar el cableado.
- [x] EXTRA: Separar todos los cables e identificarlos.
- [x] EXTRA: Conducirlos con nuevas bridas por las varillas de manera eficiente.

JorFru, 2018-04-26:
Claramente soy indispensable, me asigno el trabajo de cables.

Siotma, 2018-04-27:
En efecto, los cables que manejan mucha corriente sería importante valorar el cambiarlos por los de silicona que tenemos.

Respecto a los cables de los motores, termistores y finales de carrera, la sensación que me dio ayer es que son suficientemente largos (algunos incluso sobra un buen trozo), pero que llevan tanto tiempo en la misma posicion que están viciados y acartonados. Yo propongo soltarlos completamente y replantear su trazado. Sobre todo hay que evitar que se enreden y que estorben el movimiento de los ejes.

David-Estevez, 2018-04-27:
Creo que me voy a tener que presentar al título de "Rey de las ñapas"... :see_no_evil: :see_no_evil: :see_no_evil:

Siotma, 2018-05-06:
En la última reunión, @dmarcosm y yo hicimos los siguientes progresos:

- Alargamos el cable del ventilador de capa con los cables existentes en el armario y le pusimos un conector para conectarlo directamente a lo pines de la OVM20Lite.
- Analizamos el cableado de la impresora, y detectamos que había muchos cables con una longitud mayor de la necesaria. Estos cables tenían varias vueltas innecesarias para quedar pegados a las varillas.
- Retiramos la mayor parte de las bridas para liberar los cables y replantear su trazado.
- Recondujimos los cables de:
  - El extrusor, el ventilador de capa y el termistor.
  - El final de carrera del eje Y.
  - El final de carrera del eje Z.

Que @dmarcosm añada si se me ha olvidado algo.

Siotma, 2018-05-06:
Es urgente disponer de un soporte para dejar la placa instalada. Tal vez nos valga el que tenía la antigua placa, aunque sea de forma temporal. @David-Estevez , podrías traerlo?

David-Estevez, 2018-05-06:
Sin problema! :+1:

David-Estevez, 2018-05-07:
Ya los tenéis, están puestos en Dédalo

Siotma, 2018-05-13:
En la reunión del último jueves continuamos revisando la longitud de los cables y fijamos la placa a la impresora.

Además, colocamos una cadeneta para conducir los cables de potencia y el termistor de la cama.

Cada vez queda menos para volver a tenerla funcionando.

Siotma, 2018-05-19:
@dmarcosm tiene nueva información sobre esto :wink:

dmarcosm, 2018-05-22:
En la última reunión ya quedaron todos los cables con la longitud deseada y medianamanete colocados (hasta que no tengamos una caja para la placa no terminaría de colocarlos).
Estuvo imprimiendo a la perfección (dentro de lo que cabe) unas piezas para el ventilador de capa de Geonosis :)

CinnabarCinnamon, 2019-02-14:
Se ha comenzado el recableado de Dédalo, se ha ajustado (cortar y soldar) las longitudes de los cables de Y y X.

CinnabarCinnamon, 2019-02-14:
El cableado de Z y Extrusor están a medio camino, Dédalo que inutilizable hasta que se acabe.

GioSunrider, 2019-02-14:
Se ha colocado ademas el LCD, como se ve en #129

CinnabarCinnamon, 2019-02-21:
Se da por finalizada la colocación de cables. Cerrando issue.
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

GioSunrider, 2019-02-21:
Se ha hecho una prueba de impresion durante la charla de @JorFru para el GUL.

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

Closed 2019-02-21.

Thread 64 (2018-04-29):

Comprar regletas para la granja de impresoras

Siotma, 2018-04-29:
Hay que comprar regletas que lleven alimentación hasta la granja de impresoras y sistemas auxiliares.

De momento se ha detectado la necesidad de dos regletas, y se ha medido su longitud:

- [x] Comprar regleta de 5 metros con mínimo 8 tomas de corriente, e interruptor. (Para las impresoras, el router y las raspberrys).
- [x] Comprar regleta de 3 metros con mínimo 5 tomas de corriente e interruptor. (Para poder poner hasta 2 PCs, 2 pantallas y la Arcade).
- [ ] Instalar las regletas.

Las compraré esta semana en Bricomart / Leroy Merlin o similar para poder instalarlas en la próxima reuníon.

Siotma, 2018-04-30:
Hoy he comprado dos regletas:

- 5 metros y 6 tomas con interruptor (dado que el router va a estar conectado permanentemente ya no hacen falta tantas tomas, en un futuro se pueden colgar nuevas regletas de esta.
- 3 metros y 6 tomas con interruptor.

Total 13,98€

Siotma, 2018-05-04:
En la reunión de ayer, se instalaron las regletas en su lugar:

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

David-Estevez, 2018-05-04:
Puede que sea conveniente hacerles algún tipo de ASROB-marca para que se sepa que son nuestras (y que, concretamente, son de la granja).

Closed 2018-05-04.

Thread 65 (2018-04-29):

Dotar la granja de impresoras de conexión a internet

Siotma, 2018-04-29:
Por lo que tengo entendido, la granja de impresoras necesitaría tener:
- una conexión en red local para poder ser gestionada (obligatorio) (al necesitar varias tomas, puede que se necesite un switch).
- conexión a internet para obtener imágenes y estados de las impresiones por Telegram (para esto hace falta un router).

Para ello, creo que hace falta lo siguiente:

- [x] decidir si la instalación se hará con un router wifi que de servicio al resto de actividades de la asociación, o se usará un router no wifi dedicado.
- [ ] seleccionar un switch para tener al menos 8 puertos disponibles (2 PCs + 4 raspberrys + ampliaciones futuras).
- [x] instalar el router y el switch en la granja de impresoras.
- [x] medir la longitud de cables ethernet para cablear la granja de impresoras.
- [x] comprar los cables ethernet.
- [x] instalar los cables ethernet.
- [x] dejar la instalación robusta: el switch sujeto a la estantería y los cables bien conducidos sin que nada cuelgue ni toque el suelo.

Siotma, 2018-04-29:
Esto puede tener relación con #56 , pero mi intención en un principio, como ya he dicho otras veces es que la infraestructura de la Granja sea permanente, mientras que el router pueda ser de quita y pon, por lo tanto no se podrían unir las dos funciones en un solo aparato. Además, la granja no necesita WiFi...

David-Estevez, 2018-04-29:
La roseta está actualmente activada, de hecho el router se puede usar actualmente  para conectarse a internet a través de él (tiene IP asignada y configurada).

Yo aquí veo dos posibilidades (y si alguien ve algún fallo/cosa mejorable en lo que digo que avise):
1. Dejar el router permanentemente conectado a internet y a la granja, y configurarlo de forma que sea sencillo activar / desactivar el wifi durante las reuniones de la asociación para que la gente pueda tener acceso a internet a través de este router.
2. Instalar un nuevo router / switch que funcione de forma permanente, y que se conecte a este nuevo router el/(los router/s que se vaya a usar en las reuniones como subred/es.

Siotma, 2018-04-30:
Comparto las cuestiones que proponeis, pero en cualquiera de ellas, parece clara la necesidad de comprar un switch.

Que yo sepa, las rosetas dan internet, pero no tienen DHCP. Si te conectas a ellas con una IP fija, tienes internet, que es como funcionaban los ordenadores cuando estaban puestos junto a la lona.

Propongo comprar un switch y utilizar el método empírico: si somos capaces de ponerlo en marcha, el router puede ser de quita y pon. Si no somos capaces, tendremos que hacernos con un router que poner de forma permanente.

El que dice @GioSunrider [lo tienen en el MediaMarkt de Leganés](https://tiendas.mediamarkt.es/p/switch-tplink-8-puertos-ethernet-gigabit-1196973) por 30€. Lo podríamos comprar y probar la próxima reunión...

Siotma, 2018-04-30:
> La roseta está actualmente activada, de hecho el router se puede usar actualmente para conectarse a internet a través de él (tiene IP asignada y configurada).

Soy consciente, pero en un principio había pensado en utilizar las dos rosetas: una para la granja y otra para el router... aunque la verdad es que la idea de conectar uno al otro también es perfectamente válida.

Si me dais luz verde, podría comprar el switch que os comento en el anterior mensaje hoy o mañana.

David-Estevez, 2018-04-30:
El problema de la solución "doble" es que necesitas una IP para cada dispositivo, y actualmente sólo disponemos de una.

Entiendo que un switch convierte una IP en una red, y que cualquiera de los dispositivos conectada a esa red puede conectarse a Internet a través de la puerta de enlace del switch. No obstante, me informaré sobre esto para hablar 100
% seguro.

jgvictores, 2018-04-30:
Abreviando mucho a base de poner cosas muy específicas de nuestras circunstancias:
- Switch: básicamente funciona como un ladrón a nivel físico. Si lo conectásemos directamente a la roseta activa, necesitaríamos una IP estática por equipo, que se piden al Departamento. Tenemos creo que 3 IPs (router+PC+PC), que ya es bastante considerando que a nivel Departamento (y mundial) hay escasez.
- Router: Ofrece servicio NAT (Network Address Translation), que es una especie de ladrón a nivel lógico. Con una sola IP estática puede distribuir Internet a varios equipos, ya que asigna IPs locales a nivel interno. Como único inconveniente está el acceder a los equipos desde fuera de esa red interna (dejando de lado port forwarding, que tiene sus implicaciones prácticas), pero esto a nivel ciber-seguridad hasta es conveniente.

Una opción (creo que esto se puede hacer) es poner el router a la roseta, proporcionando internet al supuesto futuro switch. Esto es, usar un switch como una ampliación de la red local del NAT que ofrece el router. Con esta solución solo usamos la roseta activa y 1 IP única (solución bastante ecológica). Extendiendo sobre esta idea, la granja tiene conectividad entre sí aun quitando el router.

jgvictores, 2018-04-30:
BTW, incluso un router como el nuestro puede hacer cosas bastante chulas, como DHCP y/o asignar IPs por MAC.

Los más avanzados hasta dan DNS, este creo que no soporta, pero todo es cuestión de firmware... ^^

David-Estevez, 2018-04-30:
Entonces hace falta o bien un switch de capa 3 (que sería como un router pero con una sola interfaz [ethernet]) o bien una de las siguientes opciones:

1. Un router al que se conecte todo y que pueda activar/desactivar de forma sencilla el WiFi.
2. Dos routers (aprovechando que tenemos varias IPs): uno fijo conectado a la granja y otro de quita y pon para las reuniones.

Siotma, 2018-05-01:
Muchas gracias @jgvictores y @David-Estevez por la exposición de las diferentes opciones factibles y viables.

Obviamente, en ASROB estamos comprometidos con la ecología de IPs, por lo que un router que genere una subred local es la opción más interesante.

> Dos routers (aprovechando que tenemos varias IPs): uno fijo conectado a la granja y otro de quita y pon para las reuniones.

Esta es mi opción preferida, ya que así se reducen las posibilidades de que por tocar en la granja algo se estropee. Además así seguimos teniendo la flexibilidad de poder mover el router a cualquier parte de la nave que queramos. Incluso ahora que los armarios están pegados a la lona, se podría usar alguna roseta de las que hay detrás para el router.

No es fácil encontrar routers sin wifi. He encontrado [este en Amazon](https://www.amazon.es/dp/B004UC9V8Q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) que tiene buena pinta. Nos valdría durante un tiempo hasta que necesitemos más puertos y compremos el switch.

> Un router al que se conecte todo y que pueda activar/desactivar de forma sencilla el WiFi.

Si alguien conoce un modelo de router con botón para activar o desactivar el WiFi, que lo diga.

David-Estevez, 2018-05-01:
He estado pensando que si vais a hacer tareas de mantenimiento de las Pi, quizá os interese buscar un poco más a ver si hay alguno con botón para el WiFi (no confundir con WPS). De esta forma os podéis conectar a la red local en la que están las Pis y entrar por SSH a ellas, por ejemplo.

jgvictores, 2018-05-01:
De una búsqueda rápida por curiosidad... De este [foro](https://community.netgear.com/t5/General-WiFi-Routers/which-model-of-router-have-a-wifi-on-off-button/td-p/1122821) -> este [manual]( http://www.downloads.netgear.com/files/GDC/WNR1000V3/WNR1000v3_SM_24SEPT2010.pdf) donde cita claramente "Wireless On/Off button".

https://www.amazon.com/NETGEAR-RangeMax-Wireless-Router-WNR1000-100NAS no es la v3, pero hasta pone "SCHEDULED WIFI ON/OFF - Conveniently program access times and conserve up to 30% of power". Cuando menos, interesante.

David-Estevez, 2018-05-01:
Pero en este caso lo que se busca no es que el WiFi esté programado, sino que se pueda encender sólo cuando se necesite sin tener que entrar en la configuración del router, ¿no?

Siotma, 2018-05-01:
Lo que estáis proponiendo es un router WiFi dedicado para la granja, y que se pueda usar el wifi para configurarla cómodamente. O es un router WiFi compartido para la granja y otras actividades?

David-Estevez, 2018-05-01:
Lo primero, dedicado con WiFi para facilitar configuraciones / mantenimiento de raspis.

Siotma, 2018-05-01:
El enlace de @jgvictores mola, pero es de amazon.com, en amazon.es he encontrado [este que también es de NetGear](https://www.amazon.es/Netgear-JNR3210-100PES-tecnolog%C3%ADa-puertos-Ethernet/dp/B009WRYDQE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) y tiene un par de botones grandes en el frontal (uno WIFI y otro WPS), más uno de on/off trasero.

Siotma, 2018-05-01:
Madre mía, no había visto bien el precio. Vamos a buscar otro :rofl:

jgvictores, 2018-05-01:
> Pero en este caso lo que se busca no es que el WiFi esté programado, sino que se pueda encender sólo cuando se necesite sin tener que entrar en la configuración del router, ¿no?

Sí sí, en el manual de la WNR 1000v3 pone "Wireless On/Off button" que es eso. Voy a quitar el enlace a Amazon, pq ese modelo no tiene ese botón.

> Madre mía, no había visto bien el precio. Vamos a buscar otro rofl

Toca seguir buscando.

Siotma, 2018-05-01:
Teniendo en cuenta que los ordenadores de la nave van a estar conectados permanentemente a este router, ¿es muy disparatado pensar que se podría activar y desactivar el WiFi desde alguno de ellos, entrando en la página de configuración?

Siotma, 2018-05-01:
Found: https://www.amazon.es/TP-Link-N300-TL-WR841N-inal%C3%A1mbrico-esencial/dp/B001FWYGJS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

Siotma, 2018-05-01:
Planteé mal la pregunta. Más bien quería decir que si era crítico el botón o podríamos pasar sin él viendo que no éramos capaces de encontrar uno con botón.

David-Estevez, 2018-05-01:
Crítico no es, como bien dices al haber ordenadores conectados a esa red se podría activar mediante el panel de configuración.

De todas formas ese router que has pasado tiene muy buena pinta. Y por ese precio casi podemos hacer bote y pillar otro para renovar el actual.

Siotma, 2018-05-01:
Creo que resumiendo, se han tomado dos decisiones:
- Usar un router dedicado para la granja de impresoras, y otro distinto para el resto de actividades de la Asociación (conectar PCs, y otros equipos durante las reuniones).
- Se ha seleccionado el modelo de router TP-Link-N300-TL-WR841N .

Si no hay más opiniones puedo comprar las dos unidades mañana en [Media Markt](https://tiendas.mediamarkt.es/p/router-inalambrico-tplink-wifi-n300-4-ethernet-2-antenas-mimo-1150574).

GioSunrider, 2018-05-01:
Yo tengo la.propuesta de dejar directamente router y un switch directamente fijos (anclados a la pared por ejemplo), con la posibilidad de encender y apagar wifi. De esta manera no se anda quitando y poniendo nada.
El switch daría servicio a la granja y a lo que se coloque en la pared y dejas libres los puertos del router y puedes conectar por cable directamente a ellos

David-Estevez, 2018-05-01:
Lo de duplicar el router es para minimizar los problemas y cortes de servicio que pueda tener la granja al hacer cualquier cosa con la red. Si los dos routers que se instalen tienen el botón de apagado, no haría falta quitar nada, se podrían quedar los dos puestos.

GioSunrider, 2018-05-01:
Lo que no entiendo bien es la función del segundo router. IMHO, lo único que va a dar es problemas a la hora de conexiones y duplicados de wifi y demás. Y si los mantenemos separados, veo un poco innecesario el tener dos redes.

David-Estevez, 2018-05-02:
La red WiFi de la asociación siempre ha existido para crear red locales para los robots y para tener una conexión de más calidad que Eduroam (que apenas llega a nuestra esquina). Lo único es que para que esté disponible hay que sacar el router del armario, y por ello algunos grupos de trabajo directamente no lo usan (pura pereza :sweat_smile: ). Lo que se propone es añadir una segunda red con un segundo router, como infraestructura para las impresoras.

* **¿Por qué no usar el mismo router?** Porque la red de la asociación suele ser fruto de experimentos y cambios de configuración que pueden afectar al buen funcionamiento de la granja por motivos ajenos a ella.
* **¿Por qué un router WiFi si no es necesario para las impresoras?** Porque es más sencillo encontrar un router con WiFi que sin WiFi, además de que es más cómodo a la hora de realizar el mantenimiento de las impresoras.
* **¿Por qué no quitar directamente el router original y dejar sólo el de la granja?** Porque hay miembros de la asociación que todavía lo usan. Además, se prevé que si es sencillo activarlo y desactivarlo, pudiendo dejarlo siempre fuera, más miembros lo usarán en el futuro.

Siotma, 2018-05-07:
Hoy he recogido el router, estará disponible en la próxima reunión de Printer One.

He abierto la caja para comprobar el contenido, incluye:
- router, con botón de WiFi On/Off
- adaptador de corriente
- cable Ethernet de 1 metro más o menos
- guía de instalación rápida

Siotma, 2018-05-11:
@David-Estevez estuvo probando el router y nos podrá contar sus impresiones.

La idea es que este primer router se configure para conectarse a la roseta de la esquina y pueda servir internet por los 4 puertos y por WiFi, pudiéndose desactivar este último con el botón.

Una vez esté configurado, se puede empezar a montar octoprint.

jgvictores, 2018-06-19:
> conf_router_printer_one.zip

Posible que haya un lugar donde este fichero pueda tener algo de más visibilidad que en medio de issue?

GioSunrider, 2018-10-08:
No es necesario la compra de un switch dado que con el propio router podremos dar servicio a todas las RPi disponibles.

GioSunrider, 2018-10-08:
Urgen comprar los cables Ethernet, mi proposicion es hacerlos nosotros a medida, comprar [este cable sin crimpar](https://www.amazon.es/K%C3%B6nig-CMP-UTP6R50-Cable-Ethernet-metros/dp/B00652MRMQ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) y dos paquetes [de estos conectores ](https://www.amazon.es/Ociodual-Conector-Ethernet-Crimpar-Crimpadora/dp/B017T2QSC0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). Yo tengo crimpadora RJ45 y he realizado instalaciones anteriormente por lo que me ofrezco para hacerlo.

Siotma, 2018-10-11:
Fantástico!

Siotma, 2018-10-12:
Acabo de pedir el cable y los conectores!

GioSunrider, 2018-10-12:
GENIAL!!

Siotma, 2018-10-16:
Hoy he llevado el cable y los conectores a la nave:
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

GioSunrider, 2018-10-17:
El proximo dia me llevare la crimpadora y realizaremos el corte y crimpado de los cables

jgvictores, 2018-11-07:
Como se indica en https://github.com/asrob-uc3m/impresoras-asrob/issues/65#issuecomment-385474422 falta por activar la roseta. No tiene ningún sentido que de un día para otro [el único grupo activo que usa el router actualmente](https://github.com/asrob-uc3m/actas/issues/167#issuecomment-430046600) y [teniendo este router asignada la roseta 11-25L](https://github.com/asrob-uc3m/actas/issues/67#issuecomment-286799156) se quede sin conectividad.

Me puedo encargar de poner la incidencia CASO de la Universidad. ¿Qué identificador tiene la otra roseta?

PeterBowman, 2018-11-07:
> ¿Qué identificador tiene la otra roseta?

11-25D. Hay otra a la izquierda de esta y la que estamos usando: 11-25V.

jgvictores, 2018-11-07:
Ok, ya vi. La `V` nada, es un RJ11 y necesitamos RJ45. Está activada la `11-25I` (Izquierda) y tenemos que solicitar la `11-25D` (Derecha).

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

jgvictores, 2018-11-07:
Se ha creado la incidencia con id 89403: Petición de activación de la roseta 11-25D de la nave 1.0B06.

PeterBowman, 2018-11-07:
En Robot Devastation estamos usando nuestro propio router, un D-Link gris almacenado en una de las baldas azules del armario. Hoy hemos estado explorando varias opciones para no interferir con vuestro grupo, y esta es una solución satisfactoria: conectar el router a una de las rosetas de la zona vallada (HORUS/TIAGo). He enchufado el cable ethernet al puerto número 8 y no ha habido problemas ni necesidad de configurar nada. No estoy seguro de que ambas wifis (RD/granja) no interfieran, lo indicaré aquí la próxima vez que pueda comprobarlo.

@GioSunrider gracias de nuevo por cederme la roseta para la sesión de hoy. Al comenzar la tarde apagaste la wifi de la granja, te lo recuerdo de cara a vuestra próxima sesión.

GioSunrider, 2018-11-08:
De nada @PeterBowman para eso estamos. Gracias por el recordatorio. Y cualquier problema que surja más adelante no dudes en contar con printer 😊

PeterBowman, 2018-11-17:
Confirmo que nos han habilitado la salida 11-25D de la roseta de conexiones, funciona y podemos usar el router como lo llevábamos haciendo hasta ahora, con el router de la granja funcionando en paralelo. Muchas gracias @jgvictores por tu gestión en remoto, creo que se puede cerrar ya esta issue.

GioSunrider, 2018-11-17:
GENIAL!!! Muchas gracias @jgvictores !! Procedo a cerrar la issue.

Closed 2018-11-17.

Thread 66 (2018-04-29):

Comprar cadenetas portacables para las impresoras

Siotma, 2018-04-29:
Ha llegado el momento de que todas las impresoras tengan los cables bien canalizados. Si os gustaron las cadenetas de Geonosis, aquí hay cantidad: he encontrado esta maravilla en un proveedor de confianza de eBay:

- [15x20](https://www.ebay.es/itm/Cadena-Portacables-15x20-1m-CNC-Impresora-Carrier-Cable-Drag-Chain-Wire-I0139-/202184716787)
- [10x10](https://www.ebay.es/itm/Cadena-Portacables-10x10-1m-CNC-Impresora-Carrier-Cable-Drag-Chain-Wire-I0138-/202184710341)
- [10x20](https://www.ebay.es/itm/Cadena-Portacables-10x20-1m-CNC-Impresora-Carrier-Cable-Drag-Chain-Wire-I0140-/202184721639)

Tareas:

- [x] Medir la longitud de las cadenetas necesarias.
- [x] Realizar el pedido.
- [x] Recepcionar el material.
- [ ] Instalar las cadenetas.

Siotma, 2018-05-06:
La longitud necesaria de las cadenetas para cada eje es de unos 30cm. Teniendo en cuenta que tenemos 3 impresoras, lo suyo sería comprar 3 metros de cadenetas.

Propongo comprar un modelo de cada de los mencionados en el mensaje anterior:
- 10x10, para el eje Y, ya que solamente necesita llevar dos cables de alimentación de la cama y dos del termistor. Así el tamaño es compacto y es más fácil encontrar un hueco para ella.
- 15x20, para el eje Z, ya que tiene que llevar los cables del motor del eje X, el endstop del eje X, y todos los del extrusor.
- 10x20, para el eje X, ya que tiene que llevar los cables del extrusor: hotend, termistor y ventiladores.

Siotma, 2018-05-11:
Recibí el paquete el miércoles, y el jueves llevé las cadenetas a la nave. Están disponibles dentro de una caja en la balda de Printer One.

Realizamos la primera instalación de una de ellas en el eje Y de Dédalo.

Siotma, 2018-09-28:
Teniendo en cuenta la antigüedad de la Issue, y teniendo en cuenta la [nueva política de issues](https://github.com/asrob-uc3m/impresoras-asrob/issues/89#issuecomment-422891053), doy la compra por finalizada. Para la instalación de las cadenetas en las impresoras se deberá abrir una nueva.

Closed 2018-09-28.

Thread 67 (2018-04-29):

Comprar un MOSFET para Geonosis.

Siotma, 2018-04-29:
@JorFru dijo en #60 que sería buena idea ponerle un MOSFET a Geonosis cuanto antes.

He encontrado [este](https://www.ebay.es/itm/MKS-MOSFET-Extrusor-Cama-Caliente-Impresora-3D-Heating-Control-Bed-Extruder-I093-/202154694034) de un proveedor de confianza de eBay. Sin embargo, los que tenéis una Anet estáis más puestos que yo en el tema...

Tareas:
- [x] Discusión y selección de un MOSFET adecuado.
- [x] Realizar el pedido del MOSFET.
- [x] Recepcionar el MOSFET.
- [x] Instalar el MOSFET en Geonosis.

dmarcosm, 2018-04-30:
Ese mismo que propones es el que he comprado yo para mi Anet @Siotma. Diría que es el indicado, aunque creo que @JorFru puede aportar más en este caso.

JorFru, 2018-04-30:
Todos cumplen con lo que necesitamos

El lun., 30 abr. 2018 3:49, dmarcosm <notifications@github.com> escribió:

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

GioSunrider, 2018-04-30:
En mi caso el que esta es [este](https://www.amazon.es/gp/product/B0714JXQT7/ref=oh_aui_detailpage_o03_s00?ie=UTF8&psc=1). Sin ningun problema en envio y sin ninguna queja de el.

Siotma, 2018-05-06:
Gracias por vuestro asesoramiento. Damos por bueno entonces el modelo seleccionado.

Siotma, 2018-05-11:
Realicé el pedido y llegó el miércoles. El jueves lo llevé a la nave y @GioSunrider nos tiene qué contar qué tal se le dio montarlo.

GioSunrider, 2018-05-15:
Instale el MOSFET sin ningún problema. siguiendo el esquema de conexiones de la siguiente foto.

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

Para ello tuve que añadir la tercera conexión de la fuente de alimentación, ademas de meter también los cables del ventilador que estaban un poco mal sacados, y fijarlos al marco de Geonosis. Adjunto foto del resultado.

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

Ademas se probo a ver si calentaba la cama y sin ningun problema. Asi que cierro issue.

Closed 2018-05-15.

Thread 68 (2018-04-29):

Comprar una fuente de alimentación decente para Hija

Siotma, 2018-04-29:
Todos nos acordamos de aquella mala racha de fuentes de alimentación #28 #33 #35 etc..

La fuente de alimentación actual de Hija Resurrection no es de las más prometedoras de las que tenemos. Además, dada su forma, no podemos fijarla a la estructura de la impresora. Según tengo entendido, fuentes de alimentación de este estilo son fiables y además se pueden fijar en impresoras P3steel como Hija:

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

He encontrado varios proveedores:
- eBay [uno](https://www.ebay.es/itm/Fuente-de-alimentacion-12V-30A-360W-Impresora-3D-Switching-Power-Supply-I0015-/201636784333) y [dos](https://www.ebay.es/itm/12V-30A-360W-Impresora-3D-Fuente-conmutada-ALIMENTADOR-LED-TRANSFORMADOR-I0015-/201998587004)
- orballoprinting [uno](https://orballoprinting.com/gl/electronica/77-fuente-de-alimentacion-300w-25a.html)
- hta3d [uno](https://www.hta3d.com/es/fuente-alimentacion-compacta-dc-12v-33a-400w)

Además, se le podría poner un adaptador:
- [una idea](https://www.ebay.es/itm/Conector-220V-panel-tipo-C14-interruptor-fusible-Arduino-Impresora-3D-K022-/201882461448) con pieza comprada para cables estándar (más esta [carcasa impresa](https://www.thingiverse.com/thing:2158480)).
- [otra idea](https://www.youtube.com/watch?v=eZxkhMWENZU), con pieza impresa.

Tareas:
- [x] Seleccionar el modelo de fuente compatible con el requisito de que debe ser fácil de instalar en la impresora.
- [x] Realizar el pedido.
- [x] Recibir el pedido.
- [x] Imprimir la [pieza adaptadora](https://www.thingiverse.com/thing:2158480).
- [x] Instalar la fuente de alimentación en Hija Resurrection

Siotma, 2018-05-06:
A mi me mola la de HTA3D

GioSunrider, 2018-05-06:
A mi me parece también la mejor opción.

Siotma, 2018-05-25:
En la reunión de ayer se comenzó el montaje de la fuente de alimentación de Hija Resurrection.

Fue necesario modificar el cableado que hizo @GioSunrider porque la luz del interruptor se encendía constantemente. Con el nuevo cableado solamente se enciende cuando está en la posoción ON.

También ajustamos la posición de los agujeros para fijar las piezas entre sí con tornillos.

Calibré la tensión de salida a 12,20 V.

Pusimos el cable de alimentación de la RAMPS. Falta otro para la cama caliente y otro para los ventiladores y otros sistemas futuros.

Este es el estado actual:

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

Siotma, 2018-06-03:
En la última reunión se finalizó el montaje de la fuente de alimentación de Hija Resurrection.

Se colocaron 3 parejas de cables:
1. AWG16 rojo y negro para la RAMPS (alimentación de la electrónica, potencia del extrusor, motores).
2. AWG16 rojo y negro para la cama caliente (potencia de la cama a través del relé).
3. AWG18 (más finos) para los ventiladores.

La fuente se montó ancló a la impresora con 2 tornillos M4.

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

Los cables que salen de la fuente son demasiado largos, pero esto es adrede, la idea es que tras el cable management de la impresora, veamos cuál es la longitud necesaria y en su caso, los cortemos a medida.

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

Los ventiladores se conectorizaron utilizando conectores JST disponibles en el armario, y las bananas que usaban antes, se han devuelto a una de las cajas componentes electrónicos.

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

Se probó el correcto funcionamiento de la fuente de alimentación, probando a calentar la impresora y mover todos los motores.

La fuente que tenía Hija Resurrection ahora está en el armario, y yo propongo que se la pogamos a Blacky...

Issue cerrada.

Siotma, 2018-10-14:
Piezas actualizadas via 0363e391158485261eb205cfc239e86b738a5702

Closed 2018-06-03.

Thread 69 (2018-04-29):

Comprar rodamientos y poleas para las correas de Dédalo

Siotma, 2018-04-29:
Las correas de Dédalo están tensadas sobre rodamientos lisos. Muchas veces se han roto las piezas de plástico que ponemos sobre ellos para que las correas no se salgan. Además, las piezas de plástico que mueven las correas, no tienen el mejor acabado y a veces podrían patinar. He encontrado [estos rodamientos](https://www.ebay.es/itm/2x-Rodamiento-con-pestana-F608zz-Cojinete-Bolas-Impresora-3d-Reprap-Prusa-I0107-/201996659081) que tienen el mismo formato que los que tenemos, pero llevan un saliente que nos podría valer. Además, también estaría bien comprar [poleas como estas](https://www.ebay.es/itm/POLEA-GT2-20-DIENTES-8MM-BORE-ALUMINIO-PULLEY-IMPRESORA-3D-REPRAP-PRUSA-CNC-I063-/201726015423) que nos garanticen mayor fiabilidad a la hora de mover los ejes.

Tareas:
- [x] Decidir si son necesarios estos cambios.
- [x] Medir para comprobar la compatibilidad de estas piezas.
- [x] Realizar el pedido.
- [x] Recibir las piezas.
- [ ] Instalar las piezas en Dédalo.

Siotma, 2018-05-06:
Yo creo que estos cambios mejorarán la fiabilidad de la impresora, y su robustez de cara a largas horas de impresión.

El jueves pasado realicé las medidas y las piezas propuestas con compatibles.

Siotma, 2018-05-11:
Realicé el pedido y llegó el miércoles. El jueves lo llevé a la nave y tratamos de montar las primeras piezas en Dédalo.

Hubo un problema inesperado, y es que las poleas tienen el agujero demasiado ancho, habrá que imprimir una especie de casquillo para adaptar los 8mm de diámetro interno de las poleas a los 5mm de diámetro de los ejes de los motores.  Entretanto, @David-Estevez nos prestó un par de poleas del AI Hockey.

Los rodamientos quedan perfectos, pusimos los del eje X, quedan pendientes los del eje Y.

Siotma, 2018-09-28:
Colocar los rodamientos en el eje Y sería una tarea fantástica ahora que la asociación está llena de gente nueva con ganas :smiley:

Siotma, 2018-11-30:
En la última reunión (por fin) se instalaron (¡aleluya!) los rodamientos en el eje Y. En las siguientes fotos se puede comprobar cómo quedaron. También se apretó la sujección del motor del eje Y ya que estaba bastante suelto.

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

Desafortunadamente, la correa de Dédalo quedó destensada tras el proceso y no nos dimos cuenta a tiempo, por lo que se requiere de su tensado para ponerla en servicio.

Closed 2018-11-30.

Thread 70 (2018-05-01):

Comprar cables para recablear las impresoras

Siotma, 2018-05-01:
Relacionado con #66 , cuando recableemos las impresoras seguramente nos hagan falta cables más largos.

He encontrado los siguientes cables en grupos de 3 y 4, que vienen ya cortados y crimpados:

- [2 cables de 3 pines hembra-hembra 70cm](https://www.ebay.es/itm/202034957430)
- [2 cables de 4 pines hembra-hembra 70cm](https://www.ebay.es/itm/202034942973)

Posibles items a recablear: finales de carrera, motores, termistores, ventiladores, extrusores y camas.

Hay que tener en cuenta el tipo de cable que se debe utilizar para cada componente de la impresora: se debe usar mayor sección para alimentar la cama o el extrusor, sin embargo el resto de componentes deberían poder alimentarse con los cables que propongo sin problemas.

Para los cables del extrusor y la cama se podrían usar los cables de silicona que hay en el armario.

Tareas:
- [x] Revisar los cables que tenemos actualmente en el armario.
- [x] Contabilizar qué tipos de cables y cuántas unidades necesitamos.
- [x] Realizar el pedido.
- [x] Recepcionar el material.
- [ ] Instalar los cables.

Siotma, 2018-05-06:
El pasado jueves se revisaron los cables que tenemos en el armario: el grosor es muy variado, pero casi todos son de colores rojo y negro. Los más finos (AWG 28), que serían los adecuados para recablear los motores, termistores y endstops, solamente están disponibles en colores rojo y azul, y además, no hay suficiente cable como para recablear todas las impresoras.

Por tanto, esta compra parece necesaria.

Yo creo que se podrían comprar 5 unidades de cada producto, para tener en total 10 cables de cada.

Añadir que en la última reunión llevé una donación de los cables que tenía antes mi impresora. Muchos de ellos están ya conectorizados y se podrían utilizar en caso de que hagan falta:

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

Siotma, 2018-05-11:
Realicé el pedido y llegó el miércoles. Sin embargo, han llegado solo la mitad de los cables. Estoy en contacto con la tienda para resolverlo...

Siotma, 2018-09-28:
Teniendo en cuenta la antigüedad de la Issue, y teniendo en cuenta la [nueva política de issues](https://github.com/asrob-uc3m/impresoras-asrob/issues/89#issuecomment-422891053), doy la compra por finalizada. Para la instalación de los cables en las impresoras se deberá abrir una nueva.

Closed 2018-09-28.

Thread 71 (2018-05-01):

Colocar QR / URL de la web de impresoras cerca de las impresoras

David-Estevez, 2018-05-01:
Para intentar solucionar casos de amnesia temporal o pereza aguda, ¿qué os parece si imprimimos la url de la web de impresoras (http://asrob.uc3m.es/printers/) en formato QR y/o directamente como URL y pegamos el cartel cerca de las impresoras?

Un posible sitio sería la estantería de la granja, cuando esté instalada.

David-Estevez, 2018-05-02:
Posibles funciones:

* Acceso directo a estado de las impresoras (operativa/ no operativa).
* Acceso directo a instrucciones sobre cómo ser operador.
* Acceso directo a manuales de uso.
* Acceso directo a hojas de reserva.
* Acceso directo a issues en caso de incidencia.

Todo ello pensando en novatos / personas vagas (me incluyo en lo segundo).

dmarcosm, 2018-06-16:
Sugerencia: Y si lo imprimimos en 3D? :smirk:
Sería imprimir una base cuadrada en filamento blanco, y a mitad de impresión cambiar al filamento negro para la parte del propio QR

jgvictores, 2018-06-16:
> Sugerencia: Y si lo imprimimos en 3D? :smirk:

[Aquí](https://github.com/asrob-uc3m/robotDevastation-openrave-models/issues/4#issuecomment-373781813) documentamos cómo hicimos uso de https://github.com/welshjf/blender-local-qrcode

Closed 2023-09-28.

Thread 72 (2018-05-02):

Comprar cinta de doble cara para el montaje de la granja

Siotma, 2018-05-02:
Teniendo en cuenta la cantidad de cosas que vamos a montar sobre la granja, me da miedo que el SAV nos lleve a soluciones de dudosa calidad. Teniendo en cuenta que el mobiliario es un bien escaso, y que debe quedar bien instalado, he pensado que:

- Debemos evitar atornillar sobre las mesas o sobre la estantería, para evitar los agujeros.
- Debemos evitar las bridas para sujetar los componentes ya que se pueden mover. Sí que las podríamos usar para sujetar cables.
- Debemos evitar por todos los medios la cinta de embalar, cinta americana o cinta aislante para que no se quede todo pegajoso.

Creo que una cinta de doble cara es una solución ideal, si es de buena calidad y se pone con duidado.

dmarcosm, 2018-05-02:
El otro día cuando movimos los armarios salió un rollo muy grande de cinta de doble cara (a menos que no fuese cinta de doble cara)

Siotma, 2018-05-02:
Hoy he comprado esta cinta en Leroy Merlin: 7,75€.

La idea es que esté disponible en la nave antes de que sea necesaria, de forma de que nadie caiga en la tentación de utilizar ninguna otra cosa. Por las referencias de uso anteriores que tengo, esta cinta pega más que los tornillos, así que hay que usarla con cabeza :sweat_smile:

Puede que haya algunos retales por el armario, pero así usamos la misma para todo.

Instrucciones:
1. limpiar superficies antes de usar
2. no tocar el adhesivo directamente con los dedos
3. presionar fuerte durante unos segundos tras su instalación.

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

dmarcosm, 2018-05-02:
> Recuerdas dónde estaba? Mañana lo podemos mirar.

Armario de la derecha

Siotma, 2018-05-06:
En la última reunión, dejé la cinta de doble cara en el armario.

Es cierto que tenemos otra, pero es distinta:
- La que tenemos es gruesa y acolchada, y fácil de romper con los dedos. La verdad es que pega bastante, pero no es resistente a esfuerzos. Es buena candidata para sujetar cosas con poco peso, o para instalaciones temporales.
- La nueva es más fina y va reforzada con una malla, como la cinta americana. Pega una barbaridad, así que esta debe usarse solo para instalaciones permanentes.

Closed 2018-05-06.

Thread 74 (2018-05-08):

Comprar estación de soldadura

dmarcosm, 2018-05-08:
He visto esta estación de soldadura, con pistola de aire caliente incluída, y creo que nos podría venir muy bien para la mesa de soldadura: https://www.impextrom.com/es/estacion-de-soldadura-digital-doble-operaciones-smd-baku-601d-p999982500

¿Os parece buena idea comprarla? Se aceptan sugerencias de los masters de la soldadura :D

JorFru, 2018-05-09:
Yo la tengo. la he dado mucho trote y aguanta. Tiene potencia de sobra y el aire es cómodo de usar.
Las puntas que trae son KK, pero sirven para tirar un año o dos.

David-Estevez, 2018-05-09:
Yo también la tengo y le doy mis bendiciones.

GioSunrider, 2018-05-10:
Yo doy tambien doy las bendiciones, con el feedback de @JorFru y @David-Estevez, me parece la idea cojonuda.

David-Estevez, 2018-05-10:
Si os parece guay la idea, el siguiente paso sería buscar financiación para la estación.

GioSunrider, 2018-10-08:
Traslado a [Actas #138](https://github.com/asrob-uc3m/actas/issues/138)

Closed 2018-10-08.

Thread 75 (2018-05-10):

Una torre no funciona

DiegoGarciaX2, 2018-05-10:
Emite un pitido

David-Estevez, 2018-05-11:
Algún dato más sería de ayuda:

* ¿Qué torre es la que falla (de las tres o cuatro que tenemos)?
* ¿Cómo es el pitido (los ordenadores suelen pitar de forma distinta según el error)?

GioSunrider, 2018-10-08:
Encargo a @DiegoGarciaX2 que traslade la issue a actas.

Closed 2018-10-08.

Thread 76 (2018-05-15):

Renovacion de las fotos de la impresoras

GioSunrider, 2018-05-15:
Hoy se va a proceder a la renovacion de las fotos de las impresoras 3D. Para ello me llevare la Camara Reflex con un flash externo y con ayuda de los circuitos impresos haremos una especie de "estudio" improvisado. Posteriormente procesare y editare las imagenes con ayuda de Photoshop y colgaremos los resultados. Tanto las fotos originales como las procesadas se almacenaran en esta issue y en cada una de las carpetas de las impresoras.

GioSunrider, 2018-05-15:
Utilizando a @Siotma como soporte de sujeccion del circuito impreso usado y se han tomado las siguientes fotos.

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

Closed 2018-05-15.

Thread 77 (2018-05-19):

Comprar un cable para la tarjeta microsd de Geonosis

Siotma, 2018-05-19:
La posición del MOSFET (#67) dificulta un poco la colocación de la tarjeta SD en Geonosis...

Podría ser buena idea comprar un cable como este para tener el puerto de la SD más a mano. Desde un punto de vista de un uso intensivo, también de esta manera evitamos que de tanto meter y sacar la tarjeta en la placa, esta pueda acabar deteriorándose.

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

GioSunrider, 2018-10-08:
Dado a que se va a realizar la conexión por octoprint no seria necesario la compra de este cable.

Closed 2018-10-08.

Thread 78 (2018-05-19):

Configurar y documentar el PC de ASROB

Siotma, 2018-05-19:
Slic3r ha sacado por fin la versión 1.3.0 stable.

Esta versión permite hacer virguerías con los perfiles, recomiendo echar un vistazo las notas: https://github.com/slic3r/Slic3r/releases/tag/1.3.0

Principalmente creo que nos interesa por:
- Las pruebas que he hecho con versiones beta han dado como resultado calidades de impresión mucho más altas que con cualquier otra versión que he probado. Los resultados del slicing son mucho más inteligentes.
- Puedes elegir cualquier parámetro como "acceso directo" y estará disponible para cambiarlo desde la ventana principal.
- Slicing adaptativo: utiliza altura de capa variable para adaptarse fielmente a la forma de las piezas.
- Con este Slic3r se puede prescindir de Repetier, lo que facilitaría la vida a la hora de mantener los perfiles actualizados.
- Es compatible con Octoprint (aunque no sé cómo exactamente).
- Ahora que tenemos por delante una importante tarea de puesta a punto de los perfiles, sería bueno partir de la última versión para obtener los mejores resultados.
- Tengo un perfil bastante bueno del que podemos partir.

Pido ayuda a @David-Estevez y a @jgvictores para ayudarnos a la hora de instalarlo, para que aparezca en el menú inicio y sea ejecutable desde la sesión de invitado. De hecho, creo que tanto vosotros como nosotros agradeceríamos que se documentara el proceso necesario para conseguir esto.

Tareas:
- [ ] Decidir si se instalará Slic3r 1.3.0 en los equipos.
- [ ] Instalar Slic3r 1.3.0 y hacerlo accesible desde el menú inicio, y ejecutable desde la sesión de invitado.
- [ ] Desarrollar los perfiles de impresión.
- [ ] Documentar el uso de este nuevo software a nivel usuario.
- [ ] Accesos directos de cada una de las instancias de Octoprint.
- [ ] Configuración de la sesión de invitado (actualmente está un poco muerta)

BONUS:
Si se decide instalar Slic3r 1.3.0 propongo instalar primero una nueva distribución de [Lubuntu](https://help.ubuntu.com/community/Lubuntu/GetLubuntu) por aquello de tenerlo todo actualizado, que sea estable y que nos dure mucho tiempo.
- [x] Decidir si se instalará una nueva versión de Lubuntu.
- [x] Buscar una versión con fama de ser estable.
- [x] Instalar Lubuntu.
- [x] Documentar los resultados.

Siotma, 2018-05-19:
Esto principalmente estaría relacionado con los problemas de estabilidad que nos ha dado la versión 14.04 actualmente instalada.

Además, la instalación de Slic3r actualmente está dando problemas porque los nuevos perfiles a veces no se guardan y al reiniciar el ordenador se pierden los cambios.

Por último, viendo que tenemos una torre en mal estado (#75 ) puede ser un buen conejillo de indias sobre el que probar todo esto que propongo.

jgvictores, 2018-05-21:
He estado jugando con `Slic3r 1.3.1-dev` ([`master`](https://github.com/slic3r/Slic3r) de [hace 6 días](https://github.com/slic3r/Slic3r/tree/ae7fdfe227ef65cf565db87c1d92a40978013bea)) sobre Ubuntu 16.04 y todo bien. Usé el comando `apt` de  https://github.com/slic3r/Slic3r/wiki/Running-Slic3r-from-git-on-GNU-Linux#ubuntu-1604 para instalar las dependencias, y las tres líneas de https://github.com/slic3r/Slic3r/wiki/Running-Slic3r-from-git-on-GNU-Linux#build-slic3r para compilar.

Buenas impresiones con todos los parámetros por defecto; simplemente ajustar las temperaturas y el diámetro del filamento. Nada más en particular que comentar. Antiguamente todo estaba en un `.ini`, y ahora está troceado en 3 ficheros `.ini` (print/filament/printer) pero los parámetros son los mismos.

Yendo a la propuesta específica:
- `slic3r-1.3.0-linux-x64.tar.bz2` parece bastante autocontenido, y `Slic3r-1.3.0-x86_64.AppImage` lo debería ser (creo que es tipo `snap`, que hacen portables). Y de fuente si no. :+1:
- Pese a esto, pensando en cualquier otro software que se quiera meter a los PCs, me inclino un poco más por 16.04 que 18.04. A favor de 16.04 es la comodidad de la mayor parte de la documentación actual de cualquier cosa incluye los nombres de los paquetes de 16.04. A favor de 18.04 es que cada día todo tenderá más hacia 18.04. :smile:

PD: Detalles de instalación de Lubuntu en los anexos de https://github.com/asrob-uc3m/impresoras-maintenance-manual-i3

Siotma, 2018-05-22:
La idea es que el proceso sea fácil, fiable, fácil de documentar y que dure. Pero lo que funcione hoy también funcionará dentro de un año si es estable. La idea no es volvernos locos y actualizar todos los días. Una vez el sistema esté levantado y funcione bien, se puede quedar así largo tiempo hasta que haya motivos suficientes para actualizar (copia de seguridad mediante).

Si ahora está más documentada la 16.04, tal vez sea mejor idea usar esa.

dmarcosm, 2018-06-12:
Ayer quedó el ordenador actualizado a Lubuntu 16.04, sin problemas :+1:

GioSunrider, 2019-11-15:
En la reunion de ayer se habilito una mesa fija para poder volver a darle uso al ordenador.

MrTommyGuns, 2019-11-26:
En la ultima reunión estuve jugando un poco con el PC y añadí a Cura (tiene una versión un poco vieja pero aparentemente tira guay) una impresora y además se añadió el perfil de la misma (Spicy, que siendo del rollo de Hija, Blacky y Dedalo se podrian usar igualmente) y de paso uno que me descargué para testear a Geonosis.
Queda pendiente probar que funciona todo correctamente, pero tiene buena pinta y está preparado para poder slicear alguna pieza sin necesidad de que todos los miembros lleven su ordenador para poder imprimir.

MrTommyGuns, 2020-02-13:
Se ha estado usando el ordenador en la reunión de hoy para slicear unas cuantas piezas y se ha hecho sin mayor problema del que supone manejar un ordenador antiguo, así que por mi parte cerraba esta issue que me da que está caducada y el PC ya es funcional

Closed 2023-09-28.

Thread 79 (2018-06-03):

Cable management en Hija Resurrection

Siotma, 2018-06-03:
Ahora que Hija Resurrection ya tiene nueva fuente de alimentación (#68) ha llegado el momento de asear el cableado, con ayuda de las últimas adquisiciones de cables (#70) y cadenetas portacables (#66).

Tareas:

- [ ] Identificar el mejor camino de deberían seguir los cables (recomiendo planificar cadenetas en los tres ejes).
- [ ] Imprimir las piezas necesarias para sujetar las cadenetas a la impresora.
- [ ] Modificar la longitud de los cables para que puedan seguir el camino desde su origen hasta su destino.
- [ ] Colocar las cadenetas.
- [ ] Comprobar que la impresora puede alcanzar cualquier posición y que ningún cable estorba ni limita su movimiento.
- [ ] Comprobar que ningún cable cuelga de la impresora.

Finalizando esto, se avanzaría en #42

CinnabarCinnamon, 2019-02-07:
La pieza que iba a adaptar la sujeción de la cadena a la estructura de Hija se ha partido. Hay que reimprimirla.

CinnabarCinnamon, 2019-02-07:
@Siotma ¿Tienes algún modelo de enganche entre el extrusor de Hija/Blacky y la cadena?

CinnabarCinnamon, 2019-02-07:
Hemos encontrado estas dos piezas.

[E3DV6_Chain_Stepper_Mount_V4.zip](https://github.com/asrob-uc3m/impresoras-asrob/files/2842117/E3DV6_Chain_Stepper_Mount_V4.zip)
[E3DV6_Open_Chain_Long_Solo_V4.zip](https://github.com/asrob-uc3m/impresoras-asrob/files/2842118/E3DV6_Open_Chain_Long_Solo_V4.zip)

GioSunrider, 2019-02-15:
cuando comencemos el cable managment de hija, podemos aprovechar para colocarle los rodamientos nuevos de #52

MrTommyGuns, 2019-11-26:
Dejo constancia por aquí de que se intentó realizar y dejar de la mejor manera posible este asunto, pero debido a falta de material (aka bridas) hay que darle un repaso.

Por otro lado sería interesante imprimir una caja para la electrónica que facilite este punto, ya que la que había esta destrozada.

GioSunrider, 2019-11-27:
sugiero ahora que los cables tienen la mdida correcta, colocar las cadenas y que queden mas ocultos, tal y como refleja el primer comentario de la issue.

Closed 2023-09-28.

Thread 80 (2018-06-16):

Sustituir la fuente de alimentación de Blacky

Siotma, 2018-06-16:
Recientemente se ha renovado la fuente de alimentación de Hija Resurrection (#68). Por tanto, había quedado libre la fuente de alimentación que esta usaba. Se trata de la fuente cuya pegatina puede leerse [aquí](https://github.com/asrob-uc3m/impresoras-asrob/issues/33#issuecomment-346625263).

En la última reunión se ha instalado dicha fuente en Blacky, sustituyendo a la que ya tenía (que se referencia [aquí](https://github.com/asrob-uc3m/impresoras-asrob/issues/35#issuecomment-349630642)). Se ha hecho esto al encontrar las siguientes ventajas:

- La fuente que tenía Blacky no era tan cómoda de utilizar al tener el interruptor colgando de un cable. La fuente de alimentación que se ha instalado, tiene el interruptor integrado.
- La fuente que tenía Blacky necesitaba una carga de 10Ohm en el canal de 5V para funcionar correctamente (si no se pone, el canal de 12V puede caer a 9,5V al demandar mucha potencia). La fuente que se ha instalado no necesita de esto.
- Además, los cables de la fuente sustituida eran más cortos y quedaban algo tensos, mientras que los de la fuente que se ha instalado llegan de forma cómoda hasta la electrónica.

Tras sustituir la fuente de alimentación, se hicieron varias pruebas de impresión satisfactorias.

La fuente que retiramos de Blacky la hemos dejado en el armario.

Este es el aspecto de Blacky imprimiendo con la nueva fuente instalada:

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

Closed 2018-06-16.

Thread 81 (2018-07-02):

Calidad de las impresiones de Dedalo

GioSunrider, 2018-07-02:
Ultimamente Dedalo, cada vez que imprime tiene perdida de pasos del motor y su calidad no es la de esperar. Pongo foto del ultimo resultado. Hay que investigar mas este problema.

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

dmarcosm, 2018-10-05:
Al cambiar la placa de Dédalo a la OVM20 Lite, hemos ganado el soporte para ajustar los drivers de los motores con los potenciómetros que esta tiene. Sería un buen primer paso ajustarlos para ver si se corrigen esas pérdidas de pasos :+1:

JorFru, 2018-10-08:
Hemos subido un poquito la corriente de los drivers.
Hemos seguido esta guía. http://www.dima3d.com/motores-paso-a-paso-en-impresion-3d-iii-calibracion-de-corriente/
La OVM en teoría es: I = V x 2
Antes de tocar hemos medido 0.250V en cada driver. Eso son 0.5A

Lo hemos dejado en 0.350V en cada driver (excepto en Z que lo hemos dejado a 0.250V). Lo cual son 0.700A de corriente.
Hemos notado que los drivers se calentaban un poco más, pero no más de 60ºC
Con ventilación de electrónica no se nota ninguna temperatura anómala.

dmarcosm, 2018-10-08:
Al subirlos ha mejorado la impresión?

GioSunrider, 2018-12-15:
Dédalo en principio está operativa. Procedo a cerrar la issue.

Closed 2018-12-15.

Thread 82 (2018-09-13):

It's a trap

JorFru, 2018-09-13:

JorFru, 2018-09-16:
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

JorFru, 2018-09-17:
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
Spicy caldito from la abuela

JorFru, 2018-09-17:
La ANET llegó justo en el momento oportuno. En La Nave de ASROB se congregaron nueve nuevas personas en la primera reunión de PrinterOne del curso
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
Vídeos del montaje:
https://www.youtube.com/watch?v=dK14sc66EE8
https://www.youtube.com/watch?v=Sgs6Ly7aKj8

dmarcosm, 2018-09-19:
Añadida carpeta de la Anet al repositorio de impresoras! https://github.com/asrob-uc3m/impresoras-asrob/tree/master/Anet

David-Estevez, 2018-09-19:
Hay que darla de alta en la web/bot?

dmarcosm, 2018-09-19:
> Hay que darla de alta en la web/bot?

Yo no lo haría hasta que tengamos nombre definitivo. Así evitamos luego tener que entrar a cambiarlo otra vez :D

GioSunrider, 2018-10-03:
Foto de la Anet acabada.

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

dmarcosm, 2018-10-16:
> Hay que darla de alta en la web/bot?

Ahora sí hay que darle de alta! Spicyyy!!

JorFru, 2018-10-16:
Hoy se ha hecho el cable management.
Asigno a la gente que me acuerdo que ha participado. Quien falte, que se apunte.

Foto del logro desbloqueado:
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

GioSunrider, 2018-10-16:
> > Hay que darla de alta en la web/bot?
>
> Ahora sí hay que darle de alta! Spicyyy!!

Ya esta la issue puesta, keep calm, hoy le hemos hecho las fotos. Mañana las subire y se le podra dar de alta.

David-Estevez, 2018-10-21:
Ya está dada de alta en la web

Thread 83 (2018-09-13):

Cambio Extrusor Blacky

GioSunrider, 2018-09-13:
Al igual que en hija se propone un cambio completo del extrusor. @Siotma tiene un modelo que iria perfecto para blacky, por lo que le invoco para que como en hija nos diga las piezas y el modelo.

Siotma, 2018-09-14:
La idea de este extrusor es que lleva el filamento a través de un mismo tubo de teflón desde la zona de empuje directamente hasta la zona caliente, por lo que no hay interfaces donde pueda quedar atascado. Desatascar este extrusor es tan fácil como cortar el trozo de tubo donde esté el atasco, en el peor de los casos.
En mi experiencia esto no es necesario ya que el plástico desliza por el interior del tubo sin problema aunque esté frío: he llegado a quitarle el filamento a mi impresora sin calentar y solamente hay que hacer una pequeña tracción para conseguirlo.

El concepto es el siguiente:

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

Siotma, 2018-09-19:
Sí, mi intención es que ambas impresoras utilicen el mismo sistema.
**Pero**, una vez instaladas las piezas de #84 en Hija, se debería revisar qué modificaciones o mejoras se quieren añadir antes de imprimir un nuevo kit para Blacky.

Siotma, 2018-10-16:
Lo pongo para considerarlo: Blacky es del departamento y ponerle un nuevo extrusor puede ser un cambio bastante significativo... Tal vez habría que consultarlo y/o solicitar la financiación del extrusor por parte del Departamento para que no corran el riesgo de ir perdiendo porcentaje de posesión sobre la impresora :laughing:

GioSunrider, 2018-10-17:
Me parece perfecto, @David-Estevez, ¿podrias ponerte tu en contacto par ver la solucion del tema?

David-Estevez, 2018-10-20:
:+1:

David-Estevez, 2018-10-29:
Lo he consultado con el jefe de departamento y me ha dado el ok tanto al cambio como a la financiación por parte del departamento.

Pasadme los enlaces de lo que queréis comprar y hacemos el pedido.

Siotma, 2018-10-31:
La modalidad que yo propongo sería la de trueque: el extrusor ya lo hemos comprado con la subvención, pero nos hacen falta otras piezas para otras impresoras. En breve postearé una lista con enlaces.

Siotma, 2018-11-07:
El extrusor costó 9.24€ (ver [aquí](https://github.com/asrob-uc3m/impresoras-asrob/issues/85#issuecomment-425716268)). Sin embargo, un extrusor equivalente vale más de 20€ en España (ver [aquí](https://fervi3d.com/extrusion/116-extrusor-e3dv6-completo-clon.html)).

Propongo como trueque la compra de 7 unidades de rodamiento **Igus RJ4JP 01-08 - Equivalente a Lm8uu** por un valor de 1,30€/unidad, total 9,10€ más envío.

Enlace al artículo: https://fervi3d.com/mecanica/380-igus-rj4jp-01-08-equivalente-a-lm8uu.html

El proveedor propuesto es solamente orientativo. Si se encuentra el mismo producto en otro proveedor más conveniente no habría problema.

GioSunrider, 2018-12-15:
Sigue en #45

GioSunrider, 2018-12-15:
Reabrir para que cuando pueda @David-Estevez nos confirme la decisión del departamento.

GioSunrider, 2019-01-13:
Bloquea a #52 cuando @David-Estevez nos confirme dicha decision.

David-Estevez, 2019-02-07:
Los rodamientos han sido pedidos. Os aviso cuando lleguen.

David-Estevez, 2019-02-07:
Seguimos en #52

Closed 2019-02-07.

Thread 84 (2018-09-14):

Nuevo extrusor para Hija

Siotma, 2018-09-14:
En la próxima reunión llevaré un Hotend para montar en Hija.

Sería ideal que además se llevaran impresas las siguientes piezas:

- [x] [1x Carro del eje X y 1x prensa de la correa](https://www.thingiverse.com/thing:701087)

- 3 piezas del [L3Kv2](https://www.thingiverse.com/thing:1855673):
  - [x] [1x Wade_L3K_v2_Idler.zip](https://github.com/asrob-uc3m/impresoras-asrob/files/2393904/Idler.zip)
  - [x] [1x Wade_L3K_v2_Idler_hodler.zip](https://github.com/asrob-uc3m/impresoras-asrob/files/2393905/Idler_hodler.zip)
  - [x] [1x Bearing_Washer.zip](https://github.com/asrob-uc3m/impresoras-asrob/files/2393911/Bearing_Washer.zip)

- 2 piezas Remix del [L3K](https://www.thingiverse.com/thing:512338), pero diseñado para poder meter el tubo de teflón hasta el Barrel:
  - [x] [1x Wade_L3K_custom_flange_1.75_v2_mirrored.stl.zip](https://github.com/asrob-uc3m/impresoras-asrob/files/2394024/Wade_L3K_custom_flange_1.75_v2_mirrored.stl.zip)
  - [x] [1x Wade_L3K_custom_body_1.75_centered.stl.zip](https://github.com/asrob-uc3m/impresoras-asrob/files/2384181/Wade_L3K_custom_body_1.75_centered.stl.zip)

- Creación propia:
  - [x] [1x Body_E3dv6_Washer.zip](https://github.com/asrob-uc3m/impresoras-asrob/files/2393912/Body_E3dv6_Washer.zip)
  - [x] Extra ventilador de capa: [1x Blower_duct.zip](https://github.com/asrob-uc3m/impresoras-asrob/files/2394029/Blower_duct.zip)

Que empiece el reto!

Siotma, 2018-09-14:
La idea es que los que estén interesados en imprimir cualquiera de las piezas, se apunten con un comentario para evitar duplicaciones...

dmarcosm, 2018-09-18:
Este carriage es al que hay que meterle una tuerca a mitad de impresión? Si es así, que tipo de tuerca exactamente?
Yo puedo imprimir un set entero, pero aviso de que será morado/rosa de BQ.

dmarcosm, 2018-09-18:
Antes de imprimir creo que mejor estar seguros. Hemos estado mirando los STLs y no nos cuadra que sea para un Bowden, básicamente porque la pieza que sujeta el motor y la que sujeta el hotend es la misma, o sea que sería directo.
Entonces, nos planteamos que vamos a seguir con un extrusor directo en vez de un bowden o qué hacemos @Siotma
Por otra parte, faltan piezas como los engranajes y la pieza que sujeta el rodamiento, o reutilizamos las que ya tiene la impresora?

Siotma, 2018-09-18:
La tuerca es una M4, pensaba que lo ponía en la página de la pieza. Cuando lo imprimí yo, no me cabía M4 y tuve que poner M3, que también va bien pero baila un poco.

Los STLs tienen la ventaja de servir **tanto para extrusión directa como para bowden**. En un primer momento lo pondríamos como directo y una vez la impresora esté funcional se puede imprimir un par de piezas para convertirlo en bowden.

Los engranajes yo diría que se pueden reutilizar los del mismo extrusor, porque ya lo hicimos con Blacky.

Lo que sí se me olvidó fueron las piezas del idler.

Voy a actualizar el primer post con nuevas piezas.

Siotma, 2018-09-18:
Tal y como se puede ver en [esta issue](https://github.com/asrob-uc3m/impresoras-asrob/issues/45#issuecomment-368879177), no hace falta cambiar los engranajes.

Siotma, 2018-09-18:
Actualizado primer post con más información.

Siotma, 2018-09-18:
Aún más piezas disponibles !

Recomiendo no hacer más de un kit hasta que lo hayamos probado y visto los problemas...

dmarcosm, 2018-09-19:
He añadido los botoncitos de checklist para ir marcando las que hayamos impreso para este set. Para evitar esto basicamente:

> La idea es que los que estén interesados en imprimir cualquiera de las piezas, se apunten con un comentario para evitar duplicaciones...

dmarcosm, 2018-09-19:
Like por los soportes ya incluídos en el STL de la pieza más grande. Acabo de descubrir que no eran parte de la pieza :D

dmarcosm, 2018-09-20:
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

Siotma, 2018-09-28:
Las piezas se montaron en la reunión del pasado lunes, junto con un extrusor que aporté yo mientras se gestiona la compra de los nuevos en #85

El montaje mecánico quedó resuelto, tan solo falta apretar bien el hoten en caliente para que no se desenrosque, y hacer el cableado. Este es el estado actual:
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

Entre las ventajas que presenta este extrusor está el hecho de que no hay que andar enroscando y desenroscando tornillos para meter y sacar el filamento, sino que basta con retirar la lengüeta con los dedos para liberarlo:

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

El tubo de teflón va desde el hobbed bolt hasta el heatblock por lo que el filamento nunca cambia de interfaz mientras está frío, lo que previene los atascos:

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

dmarcosm, 2018-09-28:
> En lo que respecta a esta issue, @dmarcosm debería tener el honor de cerrarla

No! Falta la tobera del ventilador!!

MrTommyGuns, 2018-10-06:
En la reunión no llegamos a apretar el hotend (no sé se si hizo fuera de ella) y los cables falta ponerlos bien con bridas (no dio tiempo)

JorFru, 2018-10-06:
Gracias Tommy, queda pendiente entonces, editado.
Cuando termiéis esta issue, acuérdate de marcar los checkboxes de arriba y cuando esté todo completo (ventilador de capa instalado) se podrá cerrar la issue.

Siotma, 2018-10-13:
En la última reunión (8 de octubre), continué los trabajos en Hija:
- Deshice el apaño del cableado, ya que podía quedar pellizcado entre la estructura. Se acordó que el cableado del extrusor se debe guiar con una cadeneta: #66 #99
- Soldé el ventilador blower de 40x40x20 para el ventilador de capa.
- Añadí una vuelta de cinta aislante en la zona donde se ancla el hotend para evitar que se mueva, ahora queda bien fijo.
- Apreté a conciencia el hotend, en frío y luego en caliente.
- Realicé una prueba de cubo de impresión, satisfactoria:

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

- También comprobé que el nuevo extrusor admite retracciones grandes sin problema de atascos: llegué a probar más de 20mm de retracción.
- Probé con éxito a insertar el filamente utilizando el motor del extrusor.
- Probé con éxito a extraer el filamento utilizando el motor del extrusor.
- Probé con éxito a extraer el filamento en frío utilizando el motor del extrusor.

Siotma, 2018-10-13:
Tras ello, puse a Hija a imprimir su propio ventilador de capa, que quedó estupendamente:

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

Siotma, 2018-10-14:
Piezas actualizadas via 0363e391158485261eb205cfc239e86b738a5702

Siotma, 2018-10-16:
Hoy se ha completado el montaje del ventilador de capa. Se han realizado [dos pruebas de impresión](https://www.thingiverse.com/thing:922740) con Hija Resurrection que han dado como resultado una nueva caja para RaspberryPi:

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

La renovación del extrusor de Hija ha sido todo un éxito y se puede dar la issue por cerrada. @dmarcosm procede.

Closed 2018-10-16.

Thread 85 (2018-09-14):

Comprar nuevos extrusores

Siotma, 2018-09-14:
La idea es comprar extrusores de estos si la experiencia de la próxima semana es buena.

https://es.aliexpress.com/item/Best-price-J-head-Hotend-with-cooling-Fan-for-1-75-3-0mm-12v-V6-bowden/32810935651.html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

Están pensados tanto para extrusión directa como para Bowden. La idea de este extrusor es que lleva el filamento a través de un mismo tubo de teflón desde la zona de empuje directamente hasta la zona caliente, por lo que no hay interfaces donde pueda quedar atascado. Desatascar este extrusor es tan fácil como cortar el trozo de tubo donde esté el atasco, en el peor de los casos.
En mi experiencia esto no es necesario ya que el plástico desliza por el interior del tubo sin problema aunque esté frío: he llegado a quitarle el filamento a mi impresora sin calentar y solamente hay que hacer una pequeña tracción para conseguirlo.

El concepto es el siguiente:

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

Además, yo añadiría al pedido:

- [Tubo de teflón extra](https://es.aliexpress.com/item/1M-PTFE-tube-Teflon-Pipe-for-1-75mm-or-3mm-Filament-of-3D-Printer-Parts/32818240272.html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).
- [Barrels extra](https://es.aliexpress.com/store/product/5-pcs-bowden-wade-V6-hotend-Heat-Break-Throat-for-1-75-3-00-mm-Filament/1494743_32810212860.html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).
- [Heatblocks extra](https://es.aliexpress.com/store/product/3D-printer-heating-block-V6-heating-block-fit-j-head-hotend-kossel-and-prusa-i3/1494743_32812503617.html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). [También vulcano](https://es.aliexpress.com/item/3D-printer-Volcano-hot-end-eruption-heater-block-heating-block-free-shipping/32812527380.html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).
- [Racores extra](https://es.aliexpress.com/item/1-pcs-3D-Printer-Pneumatic-Fittings-PC4-M6-Bore-4mm-For-4mm-PTFE-Tube-Connector-Coupler/32812770027.html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).
- [Alguna pieza de silicona antiadherente para probar](https://es.aliexpress.com/store/product/1-PC-New-E3D-V6-Silicone-Sock-heating-block-set-1-75-3-0mm-Heated-Block/1494743_32865931652.html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)

Estimo un precio de unos 40-45€ por todo. La idea es aumentar la robustez y la fiabilidad de las máquinas, por lo que los gastos se podrían cargar a la subvención de Granja de Impresoras 3D.

Acciones a realizar:

- [x] Discutir la cantidad de extrusores a comprar y las piezas extra.
- [x] Realizar el pedido.
- [x] Recibir el pedido.

Siotma, 2018-09-26:
En la última reunión llevé un extrusor como el que comento que tenía por casa. Lo instalé y quedó bastante bien en Hija, además los asistentes mostraron interés en comprarlo para las demás impresoras.

Propongo una lista de la compra que sería:

| Item | Precio | Cantidad | Subtotal |
|:-:|:-:|:-:|:-:|
| Extrusor | 9.14€ | 3 | 27.42€ |
| Racores | 0.43€ | 3 | 1.29€ |
| 1m de teflón | 0.75€ | 2 | 1.5€ |
| Barrels | 0.50€ | 5 | 2.5€ |
| Heatblocks + funda | 2.04€ | 5 | 10.20€ |
| Heatblocks vulcano | 0.81€ | 2 | 1.62€ |
| Envío | 2.37€ | 1 | 2.37€ |
| **TOTAL** |   |   | **44.38€** |

Con esto, yo creo que habría material para extrusores por un largo tiempo.

Opiniones!

GioSunrider, 2018-09-27:
ADELANTE!

Siotma, 2018-09-28:
Alguna otra opinión? Podemos añadir [algún](https://es.aliexpress.com/store/product/1-pcs-4020-Blower-Cooling-Fan-40x40x20mm-DC-12V-3D-printer-parts-J-head-hotend-Reprap/1494743_32809789302.html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) [ventilador](https://es.aliexpress.com/item/5015-12-V-y-24-V-refrigeraci-n-Turbo-ventilador-sin-escobillas-3D-impresora-2Pin-para/32874940278.html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) yo creo ...

dmarcosm, 2018-09-28:
Aparte del ventilador (para Geonosis), quizá estaría bien comprar algún kit de nozzles y agujas?

Siotma, 2018-09-30:
> kit de nozzles y agujas

Voy a ver si encuentro algo en este vendedor...

Siotma, 2018-09-30:
Pedido!

He añadido los ventiladores, los [nozzles de 0.4 y de 0.5](https://es.aliexpress.com/item/5-pcs-3D-printer-V5-V6-nozzle-for-1-75mm-filament/32811224171.html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) y también [agujas](https://es.aliexpress.com/item/Best-peice-10-pcs-Nozzle-Cleaning-0-2mm-1-2mm-Drill-Bits-for-3D-Printer-Nozzle/32812095832.html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).

| Item | Precio | Cantidad | Subtotal |
|:-:|:-:|:-:|:-:|
| Extrusor | 9.24€ | 3 | 27.72€ |
| Racores | 0.43€ | 3 | 1.29€ |
| 1m de teflón | 0.75€ | 2 | 1.5€ |
| Barrels | 0.30€ | 5 | 1.5€ |
| Heatblocks + funda | 2.06€ | 5 | 10.30€ |
| Heatblocks vulcano | 0.82€ | 2 | 1.64€ |
| Ventilador 40x40x20 | 1.13€ | 1 | 1.13€ |
| Ventilador 50x50x15 | 1.04€ | 1 | 1.04€ |
| Nozzle 0.4 | 0.12€ | 5 | 0.57€ |
| Nozzle 0.5 | 0.12€ | 5 | 0.57€ |
| Kit 10 agujas 0.2 0.3 0.4 | 4.00€ | 1 | 4.00€ |
| Envío | 3.40€ | 1 | 3.40€ |
| Descuento | 1.75€ | 1 | 1.75€ |
| **TOTAL** |   |   | **52.80€** |

Siotma, 2018-10-11:
Me he dado cuenta de que esta compra tiene más sentido ponerla en la subvención de Modernización. Hay presupuesto suficiente así que presentaré el gasto contra esa subvención.

GioSunrider, 2018-10-14:
Pregunta, de este kit, sobraba un extrusor? es que he caido que una mejora para spicy seria comprarle uno de estos y ponerla bowden.

Siotma, 2018-10-16:
Se han comprado 3 extrusores:
- 1 es para reponerme a mi el de Hija.
- Los otros dos están disponibles. Habría que ver dónde los colocamos.
  - Sería interesante ponerle uno a Dédalo por Bowden, ya que mejoraría muchísimo su volumen de impresión.
  - El otro hay que pensarlo...

GioSunrider, 2018-10-17:
Por mi parte dejaria a Dedalo en directo por varias razones:
 - La primera es que me gustaria dejar una impresora en directo, pendientes de lo que pase con Blacky en #83
 - La segunda es que pensando que hay mucho filamento de 3mm el cambio seria bastante a largo plazo. No me gustaria tener en el armario un extrusor pudiendo mejorar las otras.
 - La tercera es que pasaria lo mismo con Blacky. Habría que ver si @David-Estevez le parece adecuado. (En el caso de Spicy pasaria lo mismo con @JorFru).
 - Creo que Spicy mejora una verdadera barbaridad la calidad de impresion colocandole bowden.

dmarcosm, 2018-10-17:
Yo también soy partidario de ponérselo a Dedalo. Primero, tendríamos el mismo diámetro de filamento en todas las impresoras. No hay una necesidad extrema de usar los filamentos de 3mm que tenemos, porque están todos bastante "pasados" digamos. Y segundo por lo que comenta @Siotma del espacio de impresión. Ahora mismo no llega a los 100mm en Z...
El segundo se lo pondría a la Anet pero dejándolo directo.

Siotma, 2018-10-19:
Hoy ha llegado el pedido. Lo llevaré en la próxima reunión.

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

Siotma, 2018-10-19:
La discusión sobre en qué impresora se deben instalar los extrusores da para una nueva issue: #107

Esta, que era para la compra, se da por cerrada.

Closed 2018-10-19.

Thread 86 (2018-09-15):

Cristal para Geonosis

GioSunrider, 2018-09-15:
Dado que Geonosis se encuentra actualmente sin cristal, me propongo a gestionar su colocación. Para ello dispongo de un cristal (de nevera) de grandes dimensiones que actualmente se encuentra en mi pueblo. El próximo día que vaya para allá lo traeré y solo haría falta con un cortavidrios, del que también dispongo hacerlo a medida.

IviPartida, 2018-09-15:
Perfecto, el dia que lo hagas si necesitas ayuda cuenta conmigo🤙🏾

GioSunrider, 2018-10-17:
Ayer lleve (Por fin) el cristl para Geonosis, con la ayuda de @MrTommyGuns y @L4g0 cortamos el cristal y se instalo en geonosis.

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

Closed 2018-10-17.

Thread 87 (2018-09-17):

OVM20 Anet Edition beta from Staticboards

dmarcosm, 2018-09-17:
Le he comentado la posibilidad a Javier, de staticboards, de que Printer One forme parte del equipo de testers de la nueva placa OVM20 Anet Edition que están preparando. Le he comentado que tenemos una Anet A8 y una Tronxy X5S, que esta última utiliza una placa réplica de la de la Anet y que quizá estaría bien testear la placa en otros modelos que no sean la Anet A8.
La idea le ha gustado y el precio sería el mismo que para los demás testers: 20€. Considerando los precios que tienen estas placas habitualmente, he de decir que es un precio más que aceptable. El total con envío incluído serían 26€.
Los cambios de esta placa con respecto a la original de Anet (o Tronxy en este caso) son, que recuerde:
- Mosfet de calidad para evitar incendios que quemen un edificio de la uni otra vez
- Drivers TMC2208 para los motores de los ejes X e Y (silenciosos)
- Electrónica de calidad
- Más que no recuerdo

Estaría bien discutir si aceptamos y ver quién la podría comprar.

JorFru, 2018-09-18:
Este vídeo nos dará el SAV necesario para comprarla.
https://youtu.be/5a57VacYQJY

Siotma, 2018-09-18:
Apoyo la compra. De eso va Printer One, de investigar y probar cosas nuevas.

Podría encargarme de la compra, pero mi disponibilidad es reducida. Si me dejais por aquí las instrucciones mejor que mejor.

dmarcosm, 2018-09-18:
Gracias @Siotma! Imagino que habría que enviarla a la uni. Si me dáis la dirección concreta le digo a Javier que me haga la proforma y te paso el link directamente para que pagues Manu, así no te es demasiado problema!

Siotma, 2018-09-18:
La dirección de facturación la encontrarás aquí: https://www.uc3m.es/ss/Satellite/Cultura/es/TextoDosColumnas/1371240285442/

Artículo 12, B.

La dirección de envío, ponedla a casa de @GioSunrider , o al despacho de @David-Estevez .

GioSunrider, 2018-09-18:
Cuanto tarda la placa? @dmarcosm no me importa recibirla, pero dependiendo igual nos merece la pena que llegue a la uni.

JorFru, 2018-09-18:
Enviadla al casillero de David Estévez, no tiene fallo.

También me apunto habilitar un casillero para ASROB. UC3Music tiene uno y
funciona divino.

2018-09-18 19:48 GMT+02:00 Jorge Ramos <notifications@github.com>:

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

--
*Jorge Frutos de Mingo*

Ingeniería Electrónica Industrial y Automática.
Asociación de estudiantes UC3Music y ASROB.
Universidad Carlos III de Madrid.

GioSunrider, 2018-09-18:
La verdad que el casillero seria muy clave, así tampoco dependemos de David. Y podemos enviar todo lo relacionado allí para que cualquiera lo pueda coger.

Siotma, 2018-09-18:
La verdad es que un casillero sería muy interesante. Se merece una Issue en Actas! :wink:

JorFru, 2018-09-18:
> La verdad es que un casillero sería muy interesante. Se merece una Issue en Actas! wink

Podréis contar con ello, he abierto https://github.com/asrob-uc3m/actas/issues/156
Pero no estará disponible para este pedido. Conted con él para el siguiente.

JorFru, 2018-09-19:
Leed https://github.com/asrob-uc3m/actas/issues/156#issuecomment-422821575
tenemos casillero pero en el Sabatini.

Siotma, 2018-09-19:
Pago realizado!

Siotma, 2018-09-28:
Artículo recibido!

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

Closed 2018-09-28.

Thread 88 (2018-09-19):

Propuestas y votación nombre nueva impresora - Anet A8

dmarcosm, 2018-09-19:
Esta issue es para proponer nombres para la nueva impresora (https://github.com/asrob-uc3m/impresoras-asrob/issues/82) y su posterior votación. Dejad los nombres propuestos en un comentario y antes de la próxima reunión votaremos las propuestas que haya para dejar el firmware cambiado de forma definitiva.

Las propuestas hasta el momento son las siguientes:
- Spicy
- Easy Fire
- Charmander
- Mustafar
- Arden Lyn
- Darth Fire
- Red Hot Chili Printer

JorFru, 2018-09-19:
Yo le daría un nombre que recuerde la habilidad innata que tiene esta máquina por arder espontáneamente.

IviPartida, 2018-09-19:
Easy Fire

dmarcosm, 2018-09-19:
Charmander

David-Estevez, 2018-09-19:
Mustafar

JorFru, 2018-09-19:
A mí me mola el rollo SW
Como es negra, podría llamarse Darth Fire

David-Estevez, 2018-09-19:
Red Hot Chili Printer

GioSunrider, 2018-09-19:
Kaiburr, son los cristales que dan poder a los sables de luz.

L4g0, 2018-09-19:
Spicy 💯

dmarcosm, 2018-09-26:
Voten! Abierto hasta el domingo!
https://goo.gl/forms/FsQwZYA145B3FTd93

GioSunrider, 2018-09-27:
Nuevo formulario, debido a los errores del anterior. Queda abieto hasta el domingo.
https://goo.gl/forms/gM2HX9JpW5oOw5Cd2

GioSunrider, 2018-09-30:
El resultado de la votación ha sido el siguiente:

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

Luego el nuevo nombre de la impresora es Spicy. Se ha añadido la etiqueta correspondiente y asigno a @dmarcosm para que realice el cambio de carpeta correspondiente.

dmarcosm, 2018-10-05:
> asigno a @dmarcosm para que realice el cambio de carpeta correspondiente.

Hecho

Closed 2018-09-30.

Thread 89 (2018-09-19):

Actualización firmware de Spicy Caldito

JorFru, 2018-09-19:
@GioSunrider cambió el firmware de Spicy Caldito, del firm original de la ANET a un Marlin modificado por él, que no es la última versión.

Los resultados antes y después del cambio de firmware:
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
El calicat de la izquierda es con el firm original, el de la derecha es con el Marlin de Gio.
Ambos el mismo GCODE

Presiento que hay que ajustar aceleraciones.

dmarcosm, 2018-09-19:
Creo que esto deberíamos ponerlo en la issue de puesta a punto, para evitar tener 8 issues solo de la Anet :(

JorFru, 2018-09-19:
Organízalo tú entonces
Mi idea era abrir una issue para cada parte de la máquina.

- Firmware/placa
- Extrusor
- mecánica

por ejemplo, como hay con las otras máquinas.

Siotma, 2018-09-19:
Un gran número de issues no son un problema si solamente se requiere una o dos acciones máximo para resolverlas. Las issues estilo "puesta a punto de X" no han demostrado funcionar porque se pierden los avances en las diferentes tareas y los nuevos las ven con miedo de todo el trabajo que hay que hacer. Pienso que el sistema de issues está concebido para un enfoque como el que propongo.

Los veteranos deberíamos intentar abrir issues lo más "atómicas" posibles, aunque sean muchas. De esta manera cada una no duraría abierta más de una o dos semanas desde que se empieza a trabajar hasta que se termina, mientras que ahora tenemos issues a medias, que llevan abiertas meses y nadie se acuerda de por dónde se iba.

dmarcosm, 2018-09-20:
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

No lo decía con ánimo de ofender a nadie.

> ... Las issues estilo "puesta a punto de X" no han demostrado funcionar ...

Quizá entonces deberíamos replantear los "puesta a punto de X" como proyectos y no como issues, ya que se quedan ahí eternamente sin ser cerrados nunca.

dmarcosm, 2018-09-30:
En la próxima actualización hay que aprovechar a cambiar el nombre por Spicy, tal y como ha salido elegido en #88

JorFru, 2018-10-01:
Actualmente está flasheada con el nombre "Spicy", creo recordar.

En esta issue voy a documentar el tema de ajuste de aceleraciones en Spicy. Ya que desde que se cambió el firmware original, no imprime igual de bien, y posiblemente sea esta razón. Buscaré los ajustes que traía por defecto y los pondré en el Marlin que tiene actualmente. Creo que se puede hacer desde la pantalla, o hace falta flashear.

dmarcosm, 2018-10-01:
Aunque se pueda hacer desde la pantalla, diría que mejor dejarlo cambiado en el firmware (por lo que pueda pasar). Así mismo, aprovecharía para actualizar a Marlin 1.1.9 :D

GioSunrider, 2018-10-01:
Cómo dice @dmarcosm es la oportunidad para cambiar al nuevo marlin, y de paso hacerlo en todas las impresoras. Así los nuevos también aprenden esa parte.

GioSunrider, 2018-12-15:
En la última reunión actualice el firmware de Spicy por Marlin 1.1.9., el mismo que tengo yo en casa, añadidos los custom comanda y habilitado el cambio de filamento. Mañana subiré los archivos de configuración al repo.

GioSunrider, 2018-12-16:
Subidos archivos en 21e93f3
Tienen el añadido de lenguaje ya que esta pensado para PLA y PETG, en vez de ABS y PLA.

Closed 2018-12-16.

Thread 90 (2018-09-21):

Piezas para Geonosis!

dmarcosm, 2018-09-21:
Geonosis necesita piezas nuevas para mejorar su estructura!

De momento solo son 2 piezas para los motores de X e Y, y ya veremos si necesitamos algo más adelante :)
- [ ] Sujecciones motores X e Y: https://www.thingiverse.com/thing:2613150/files

GioSunrider, 2018-09-21:
Rehacer el ventilador de capa lo necesita, pero no me acuerdo que piezas eran.

dmarcosm, 2018-09-21:
No es este, es parecido. Pero me gusta más, porque no queda el ventilador tan vertical y no tiene tantas posibilidades de morir de un golpe: https://www.thingiverse.com/thing:2659499/files

GioSunrider, 2018-09-22:
Pero no es el mismo ventilador, esa pieza no valdría, nuestro ventilador el aire sale por un lateral no por toda la superficie

dmarcosm, 2018-09-23:
Quizá este: https://www.thingiverse.com/thing:2828421/files
(aunque lo de que el nuestro sea vertical no sería un problema porque hay una pieza-adaptador imprimible)

JorFru, 2018-09-23:
Opinión personal justificable:
Ese ventilador radial enano que trae la Tronxy y que estáis obcecados en
usar es una absoluta basura.
Merece la pena gastarse 4 pavos en un ventilador nuevo. Un 40mm axial, o
uno radial más grande, como el de la A8.

Saludos xD

El dom., 23 sept. 2018 11:43, dmarcosm <notifications@github.com> escribió:

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

dmarcosm, 2018-09-23:
Me suena que en la última compra vino un ventilador centrífugo, más grande que el que tiene ya geonosis, pero que me confirme @Siotma

Siotma, 2018-09-27:
Efectivamente, compramos dos: #53

GioSunrider, 2018-09-27:
Compraria otro compatible con el nuevo extrusor que se instale en Blacky y pondría uno en Geonosis, como lo veis?

dmarcosm, 2018-09-27:
No entiendo tu pregunta @GioSunrider. Si ya tenemos 2 comprados, y uno va para blacky, ya nos sobra uno para geonosis, no?

dmarcosm, 2018-09-28:
Ah, vale. No lo había pensado :+1:

Siotma, 2018-10-13:
Con uno de los ventiladores que tenemos, se podría plantear algo como esto: https://www.thingiverse.com/thing:2819859 Yo propongo ponerlo primero solamente en un lado, porque ahora solo tenemos uno. Si para cuando llegue el envío de AliExpress vemos que hace falta uno en cada lado, se puede poner otro.

Siotma, 2018-10-13:
Alguien se ha puesto ya con este reto?

Siotma, 2018-10-27:
En la última reunión, Hija imprimió las dos sujecciones de motores:

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

Respecto a los ventiladores de capa, @jorgercobo y yo estuvimos dándole vueltas. Hemos pensado en volver a colocar las piezas originales y poner una tobera por dentro para dirigir mejor el aire al disipador y que no pegue en el hotend. Cuando tengamos claro cómo debe hacerse, abriremos otro reto de impresión.

Closed 2018-10-27.

Thread 91 (2018-09-24):

Tampones para sello Feria de Asociaciones

JorFru, 2018-09-24:
Necesitamos tener impreso, para disponer de ello el miércoles, el siguiente item que consiste en un tampón para sello con el logo de ASROB. Se usará para validar a la gente que pase por el stand de ASROB en la gymkhana.
La pieza no tiene el tamaño correcto todavía, hay que escalarlo.
2-3cm de ancho, con 3cm de altura para que se pueda coger con la mano sin mancharse de tinta, a ser posible.
[ASROBstamp.zip](https://github.com/asrob-uc3m/impresoras-asrob/files/2410172/ASROBstamp.zip)

También he preparado otro sello, de regalo, para obtener más puntos en el reto de impresión. Está dentro del zip.

Hoy a mediodía voy a llevar filamento flexible de FFF color "azul topacio" para que se imprima.

GioSunrider, 2018-09-24:
Lo imprimo a la hora de comer en casa en PLA, a la hora de comer, y lo llevo esta tarde.

GioSunrider, 2018-09-25:
El sello quedo en el armario listo para su uso, se colgara posteriormente foto de él.

JorFru, 2018-09-25:
Yo tengo uno en filaflex, pero no quedó nada bien la primera capa.
Lo probaremos.

El mar., 25 sept. 2018 23:40, Jorge Ramos <notifications@github.com>
escribió:

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

Siotma, 2018-09-28:
Cómo fue este reto?

GioSunrider, 2018-09-29:
Falta la foto que no lo hicimos pero bueno, el plan chupa poca tinta pero sirvió para su cometido.

JorFru, 2018-10-01:
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
Imprimí esto, descuidando la máquina y la primera capa (la importante para el resultado final del sello) no quedó del todo bien.
Al volver a intentar imprimirlo tuve un atasco interesante.

El día D por problemas organizativos no pude llevar la pieza impresa a la feria.

L

JorFru, 2018-10-01:
@GioSunrider te mereces cerrar la Issue

Closed 2018-10-01.

Thread 92 (2018-09-24):

Mejoras extrusor Spicy Caldito

JorFru, 2018-09-24:
He impreso esta pieza con Spicy y la he colocado
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
El archivo: https://www.thingiverse.com/thing:2133328

dmarcosm, 2018-09-28:
> así que no conviene perderla de vista

@JorFru si es posible, súbela a a carpeta de la Anet!

Closed 2018-10-08.

Thread 93 (2018-09-24):

Formación como Operador

MrTommyGuns, 2018-09-24:
Hola wenas,

Me gustaría formarme como operador, así que lo pongo por aquí de forma oficial, por si algún voluntario que tenga algún espacio libre que nos vaya bien a los 2 me quiere formar.

O vamos, decidme la mejor opción que creáis vosotros si es así.

Thaanks!

GioSunrider, 2018-09-24:
Mira bien donde poner la issue.
https://github.com/asrob-uc3m/operadores/issues

Closed 2018-09-24.

Thread 94 (2018-09-25):

Cinturón/arnés para sujetar la cámara

JorFru, 2018-09-25:
Para la primera propuesta de https://github.com/asrob-uc3m/actas/issues/161 convendría disponer de un montaje para la cámara FPV. Casco, arnés, cinturón...
Sólo con el fin de no tener que andar detrás de la persona que está realizando la actividad.

Ideas?

Thread 95 (2018-10-03):

OVM20 ANET edition para Geonosis

JorFru, 2018-10-03:
Staticboards nos ha regalado su última creación para que la probemos como betatesters. Conviene instalarla lo antes posible para ir reportando a Javier Loureiro (Staticboards) las sugerencias y bugs de la nueva placa.

La placa original de la Tronxy irá al armario. El MOSFET que actualmente lleva Geonosis se moverá a Spicy #96

dmarcosm, 2018-10-06:
Pues no sé. Ahora después digo a Javier que os meta a uno de los dos en el grupo de betatesters, que yo estoy hasta arriba ahora.

JorFru, 2018-10-06:
De cabeza entro en ese grupo.
No tengo tiempo
pero para hablar de electrónica estoy siempre disponible.

Siotma, 2018-10-06:
Puntualizar que no ha sido un regalo: https://github.com/asrob-uc3m/impresoras-asrob/issues/87

JorFru, 2018-10-16:
Componentes pedidos. Estarán aquí a partir del 28 de octubre, creo.

Siotma, 2018-11-03:
@JorFru , algún dato interesante del último día para que conste?

JorFru, 2018-11-03:
El proveedor se equivocó y me mandó AMS1117-3.3 en vez de AMS1117-5.0
Conseguiré los reguladores correctos para instalarlos el lunes o martes después de la OSHWDem

Siotma, 2018-11-20:
Parece que la placa quedó reparada en la última sesión. @JorFru trató de flashear Marlin 1.1.9 sin éxito.

Hoy he estado investigando. He conseguido instalar la placa de la Anet en Arduino IDE siguiendo el tutorial: https://trello.com/c/QRIYELJA/311-configurar-arduino-ide-para-actualizar-el-firmware-a-partir-de-c%C3%B3digo-fuente

También he editado los archivos de configuración (adjuntos).

Sin embargo, no he sido capaz de subir ningún firmware a la placa porque parece que no tiene bootloader. @dmarcosm dice que puede ocurrir que al programarla se borre, así que igual eso fue lo que le ocurrió a @JorFru . Habrá que usar un ISP, en Arduino tenemos este el USBTinyISP. En el siguiente enlace aparecen los esquemáticos de los conectores: https://cdn-learn.adafruit.com/downloads/pdf/usbtinyisp.pdf

Según @dmarcosm hay que conectarlo así.
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

[Configuration_Geonosis.zip](https://github.com/asrob-uc3m/impresoras-asrob/files/2601415/Configuration_Geonosis.zip)

GioSunrider, 2018-12-15:
Me gustaría que actualizados el estado de la placa, si esta es funcional ya mismo, podéis proceder a cerrar la issue

GioSunrider, 2018-12-20:
Siguiendo el tutorial de staticsboards, que @Siotma proporciono, logre subir con exito el marlin 1.1.9, aunque los fichero que ha y en el repo de @dmarcosm estan mal configurados, ya que la pantalla ni la placa eran las correctas.
Cuando se fue a comprobar la placa ocurrio lo siguiente....

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

Se rompio el conector usb, por lo uqe planteo dos soluciones al problema.
1. Si @JorFru puede repararlo, tiene via libre para hacerlo ya que la placa podemos actualizarla via programador, pero, no podemos conectarla a octoprint.
2. Retornar a la paca original de TronXY

JorFru, 2018-12-28:
Creo que puedo hacerlo.
Me propongo como plazo las dos primeras semanas de Enero.

Si necesitáis la máquina con el USB en funcionamiento antes de este periodo, podéis hacer lo que queráis, pero no me puedo comprometer a hacerlo en una fecha concreta.

GioSunrider, 2018-12-28:
No, no ha prisa, es más SAV, ya que todavía no hemos visto a geonosis quemando plástico. Pero no hay problema en tenerla parada, hay otras 4 Impresoras. Así que por mi parte tienes vía libre para ponerte con ella cuando puedas, te dejo encargado de esta issue para que hagas lo que creas mejor.

Siotma, 2019-01-13:
>
>
> Siguiendo el tutorial de staticsboards, que @Siotma proporciono, logre subir con exito el marlin 1.1.9, aunque los fichero que ha y en el repo de @dmarcosm estan mal configurados, ya que la pantalla ni la placa eran las correctas.

Según dices, utilizaste las fuentes de @dmarcosm , sin embargo, yo te había dejado un zip con la configuración en [mi post](https://github.com/asrob-uc3m/impresoras-asrob/issues/95#issuecomment-440414586). Supongo que no lo viste. Estuve configurándolo un buen rato y busccando información para asegurarme de lo que hacía... debería funcionar bien.

GioSunrider, 2019-01-13:
Pues la verdad que no lo vi, seria subir ese a ver si funciona, pero antes hay que arreglar la placa.

JorFru, 2019-01-26:
Jorfru ejecutó y @GioSunrider miró.
Siento no dejarte el placer de soldarla tron. La siguiente te la haces tú.

Estará disponible para montarse en la siguiente reunión.

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

GioSunrider, 2019-01-30:
Se ha intalado y subido el marlin que @Siotma configuro, funciona perfectamente menos por el LCD que ha y que configurarlo.

GioSunrider, 2019-01-30:
Sigo sin poder arreglarlo, para poder subir el marlin hay poner la placa tipo Anet V1.0 (Optiboot) para que se suba correctamente.

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

JorFru, 2019-01-31:
Yo en su día también hice muchos intentos para poner a funcionar esa pantalla LCD y no lo conseguí.

Siotma, 2019-02-14:
>
>
> Se ha intalado y subido el marlin que @Siotma configuro, funciona perfectamente menos por el LCD que ha y que configurarlo.

Mentira! Hoy @GioSunrider y yo hemos intentado hacer pruebas de movimiento con Geonosis y al hacer homing, el regulador de 5V HA VUELTO A ARDER! :tired_face:

Necesitamos volver a colocar la placa antigua y poner la impresora a funcionar. Lleva casi un año en la asociación y ahora que tiene un V6 no puede estar parada...

JorFru, 2019-05-08:
Cuál es el estado actual?
La OVM se ha vuelto a freír? La reparo si hace falta.

Me da mucha pena ver esta máquina parada, sobre todo por el extrusor grueso que tiene y no le estamos dando uso.

MrTommyGuns, 2019-05-08:
Yep, sigue frita...
Yo le volvería a poner la placa anterior y pa lante a funcionar...
Si no me equivoco también tenemos placas donadas del hackatón. Podemos ver cuales rentan para cada impresora
Para nuestra impresora casta necesitariamos una plaquita de estas open supongo

GioSunrider, 2019-05-08:
Mi idea es poner la ovm 20 lite para la nueva a democratizar, una buena mecánica con una buena placa. La ovm anet sigue frita, quedamos en que habria que reparar y probarla una a una, y a geonosis ponerle su placa original.

GioSunrider, 2019-05-09:
@JorFru cambio de nuevo el regulador. Esta vez ardio nada mas encender. Hemos decidido quitar la placa y volver a la orginal. Ahora vuelve a funcionar y se estan haciendo n uevas pruebas de impresion.

GioSunrider, 2019-05-09:
Doy esta issue por cerrada dado que no se va a utilizar esa placa.

JorFru, 2019-05-09:
Pruebas de impresión satisfactorias. La placa antigua funciona correctamente, su firmware (Marlin 1.1.6) parece funcionar correctamente.

Closed 2019-05-09.

Thread 96 (2018-10-03):

MOSFET de la cama para Spicy

JorFru, 2018-10-03:
Geonosis, después de recibir la OVM20 ANET edition #95 , donará su MOSFET a Spicy. Hay que instalarlo.

JorFru, 2018-10-03:
Un poco overengineered pero me mola la idea.

JorFru, 2018-10-06:
En la reunión del 3 de octubre se empezó con el montaje de este nuevo componente, pero no se terminó. Se puede imprimir actualment pero sólo con cama fría.
Urgente terminar esta issue.

Thread 97 (2018-10-05):

Ideas Proyectos - Subvenciones curso 2018-2019

dmarcosm, 2018-10-05:
Vayamos dejando aquí las ideas de proyectos que se nos vayan ocurriendo, ya que no tardando mucho tendremos que pedir las subvenciones de este curso (sabemos fechas @GioSunrider?)

GioSunrider, 2018-10-05:
Todavía no tengo ni idea, pero si, de momento una de mantenimiento de la granja de impresoras hay que pedir.

dmarcosm, 2018-10-05:
Como idea loca propongo montarnos una Prusa Blackbelt, es decir, añadirle una cinta motorizada a una de las impresoras tipo prusa que tenemos. El proyecto en sí no sería demasiado complicado, ya que sería, a grandes rasgos, usar el motor del eje Y para hacer girar una cinta de un material X alrededor de la cama caliente. Habría que ver si habría que aumentar el tamaño de la impresora por debajo para que cupiese el mecanismo, pero no lo veo muy complicado :)

GioSunrider, 2018-10-06:
Yo pediría dos subvenciones entonces, una de mantenimiento del parque de impresoras y otra de proyecto de mejora. En la de mejora podemos incluir perfilería y demás, así también tenemos dinero y margen de maniobra.

dmarcosm, 2018-10-06:
Lo de la AM8 lo veo muy factible, además no nos costaría demasiado. Quizás haría en general una subvención de "Creación y mejora de impresoras", y detallar dentro todo lo que queremos hacer

GioSunrider, 2018-10-06:
Yo lo decía por la compra de filamento! Qué cogería solo una subvención para la compra de varios tipos de filamento e investigar.

dmarcosm, 2018-10-06:
> Yo lo decía por la compra de filamento! Qué cogería solo una subvención para la compra de varios tipos de filamento e investigar.

Subvención para material? Tipo perfilería, filamento, mejoras de impresoras (aka autolevel, bases, etc..)

dmarcosm, 2018-10-06:
> Todavía no tengo ni idea, pero si, de momento una de mantenimiento de la granja de impresoras hay que pedir.

Realmente, qué hay que mejorar exactamente en la granja de impresoras? O sea, tenemos algo pensado?

GioSunrider, 2018-10-07:
Perfilería, y bueno la tronxy necesita una buena mano de muchas cosas, igual sería la que se llevaría todo el presupuesto.

dmarcosm, 2018-10-15:
Propongo también transformar una de las impresoras que tenemos con RAMPS a multicolor, con doble extrusor, lo cual sería muy interesante para los soportes solubles :)

dmarcosm, 2018-10-16:
- Cambio de extrusor de Dedalo, a 1.75mm
- Añadir laser engraver/cutter a una impresora (anet, por ejemplo)

GioSunrider, 2018-10-17:
Propongo aglutinar, una unica subvencion de "mejora y mantenimiento de la granja de impresoras." De esta manera tenemos margen para aplazar ideas y asi tambien dejamos subvenciones para el resto de la asociacion.

dmarcosm, 2018-10-17:
Yo pienso que deberíamos pedir al menos 2 subvenciones separadas. Por no generalizarla tanto y que luego quizá algo no podamos pasarlo por esa, pero el experto en subvenciones es @Siotma.

GioSunrider, 2018-10-17:
Hay que ver cuantas subvenciones se piden en general de asociacion, porque si pedimos todos, dos igual son muchas.

dmarcosm, 2018-10-17:
> Uno de los años (no recuerdo si el pasado o antes de eso) sí que estaba regulado el número máximo por asociación. Una posible "trampa" es pedirla a título individual como alumno, que también se puede.

En vez de a título personal, se podrían pedir en nombre del grupo? O tiene que ser asociación per se? De todas formas yo creo que no saldrán tantas peticiones para todo asrob, así que no me preocuparía.

David-Estevez, 2018-10-17:
O a título personal, o bajo una asociación.

GioSunrider, 2018-11-05:
Vale chicos, hay que saber que queremos pedir exactamente. @dmarcosm no te vengas arriba que hay que aglutinar todo lo que podamos, dado a que tiene pinta que vamos a estar limitados, también hay que pensar que nos dará tiempo a hacer menos de un año.

David-Estevez, 2018-11-05:
Como he sugerido por el grupo de RoboFactory, primero apuntad qué es lo que queréis pedir (si hubiese dinero/subvenciones ilimitadas) y a partir de eso trabajamos.

También estaría guay que hicieséis un desglose de las cosas que harían falta en cada proyecto y cuánto estimáis que costarían.

A partir de eso haremos nuestra magia de siempre.

Thread 100 (2018-10-08):

Call4Makers OSHWDEM - Grupo Printer One

dmarcosm, 2018-10-08:
Holi,

Sigue abierto el Call4Makers de la oshwdem, propongo intentar llevar algo del grupo. Opiniones? Propuestas? Insultos?

dmarcosm, 2018-10-08:
Parece que ya está pedido a nombre de Asrob. Porfa @JorFru coméntalo en una issue en actas.

David-Estevez, 2018-10-08:
Hecho: https://github.com/asrob-uc3m/actas/issues/169  (yo también estaba en el ajo)

Closed 2018-10-08.

Thread 101 (2018-10-08):

Alimentacion de RPi's para la granja

GioSunrider, 2018-10-08:
Comprar cables microusb, [este pack de 5](https://www.amazon.es/MaGeek-Sincroniza-Samsung-Motorola-Colores/dp/B01A7BVDES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) seria suficiente y dos bases dobles como [este pack](https://www.amazon.es/Cargador-Luvfun-Tecnolog%C3%ADa-tel%C3%A9fonos-inteligentes/dp/B07FX8434B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)

Siotma, 2018-10-11:
Buena opción!

dmarcosm, 2018-10-12:
Vería más lógico comprar una base con 4 USBs https://www.google.es/aclk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, así no gastariamos tantos enchufes.

Siotma, 2018-10-12:
Las raspis puede que estén separadas en dos baldas, como lo están ahora mismo las impresoras, por lo que parece interesante tener dos adaptadores distintos. Además la opción de dos bases es más barata que la de una base.

Siotma, 2018-10-12:
Acabo de hacer el pedido de la propuesta de @GioSunrider

GioSunrider, 2018-10-12:
Genial!

Siotma, 2018-10-16:
Hoy he llevado a la nave los adaptadores de 5V, y también he recibido los cables en mi casa:

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

Closed 2018-10-16.

Thread 102 (2018-10-08):

Comprar nuevos filamentos

Siotma, 2018-10-08:
Para apurar el presupuesto de las subvenciones, @GioSunrider y yo hemos pensado en pedir bobinas de filamento. Se aceptan sugerencias.

JorFru, 2018-10-08:
Yo quiero esto papi
https://www.materials3dimpresion.com/pla_ep.php?l=0

dmarcosm, 2018-10-08:
- https://fillamentum.com/products/pla-extrafill-vertigo-grey o https://fervi3d.com/fiberlogy-easy-pla/335-722-fiberlogy-easy-pla-vertigo.html
- https://smartmaterials3d.com/es/tienda-smart/20-smartfil-flex.html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
- https://smartmaterials3d.com/es/smartfil-pla/72-smartfil-pla-mix.html
No se cuanto dinero hay pero quizá nos interesa probar el Nylon: https://fervi3d.com/fiberlogy-nylon-pa12/448-903-nylon-pa12-black.html#/25-diametro-175_mm/28-tamano-m_750_g

GioSunrider, 2018-10-09:
Para variar un poco de filamentos yo propongo PETG de Fiberlogy que tiene muy buena calidad. https://www.3dpenedes.com/es/filamento/973-pet-g-azul-transparente.html

dmarcosm, 2018-10-09:
Cuánto hay sobrante @Siotma?

GioSunrider, 2018-10-09:
No era mucho, unos 60 creo recordar, pero lo de los filamentos lo dejaremos para la ultima semana de octubre no vaya a ser que necesitemos algo antes y no podamos.

Siotma, 2018-10-11:
Tienen todos muy buena pinta.

Una vez veamos el dinero disponible, realizaré la compra :wink:

Siotma, 2018-10-19:
Esta cesta de la compra liquidaría las subvenciones:

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

dmarcosm, 2018-10-19:
> Esta cesta de la compra liquidaría las subvenciones:
>
> 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

A mi me parece correcto :)

GioSunrider, 2018-10-20:
Se que no viene a cuento pero... y algo de estaño? en general estamos muy necesitados de el, se podria incluir?

dmarcosm, 2018-10-20:
La cosa es que el filamento es algo que hay qee comprar vía la issue de material común, no? De hecho creo que ya está puesto allí.

GioSunrider, 2018-10-20:
Me refería para terminar de cuadrar las cuentas.

dmarcosm, 2018-10-20:
Pero habría que quitar algún filamento entonces, porque con lo poco que "sobra" no compras demasiado estaño xD
(si hay que quitar alguno yo pasaría del Smart Glow)

GioSunrider, 2018-10-20:
Yo quitaría el smart glow, además para así comprar kits para el ajuste del extrusor para las otras impresoras.

JorFru, 2018-10-20:
Del estaño me encargo yo. Dedicad el presupuesto de Printer para filamentos y componentes.

Siotma, 2018-11-07:
Hoy se han comprado 4 filamentos:
- https://fervi3d.com/smartfil-flex-93a/13-89-flex.html#/25-diametro-175_mm/27-tamano-s_330_g/34-color-sapphire
- https://fervi3d.com/fiberlogy-petg/330-717-fiberlogy-petg-tr-navy-blue.html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
- https://fervi3d.com/esencial-pla/406-790-pla-fervi3d-esencial.html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
- https://fervi3d.com/fiberlogy-easy-pla/444-895-fiberlogy-easy-pla-onix.html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

Siotma, 2018-11-18:
Los filamentos llegaron hace unos días. Los llevaré en la próxima reunión:

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

Closed 2018-11-18.

Thread 98 (2018-10-08):

Instalación Octoprint

GioSunrider, 2018-10-08:
Arrastrado de #49. Se necesita la instalacion de Octoprint para dar salida con 3 RPi's y 5 camaras para el control de las impresoras.
Los pasos a seguir son:

- [x] Clonar la RPi que @dmarcosm tiene con dos estancias.

- [x] Imprimir el [Protector de la RPi 3B](https://www.thingiverse.com/thing:922740)

- [x] Creacion de 5 bots de Telegram con el nombre de la Impresora

- [x] Añadir los bots al grupo de telegram de [impresoras](https://telegram.me/joinchat/ADT1EAoc4Ds9nBXp4Hj9dw)

- [x] Colocacion de la RPi

- [x] Colocacion del Router

- [x] Cablear RPi con impresoras

- [ ] Colocar Camaras Octoprint

[EDIT]

- [ ] Configurar Camaras

- [ ] Imprimir [soporte](https://www.thingiverse.com/thing:2587839) para las Camaras

- [ ] Configurar los Bots

dmarcosm, 2018-10-08:
En cuanto pueda subo los archivos o una guía para no retrasar esto más. Also, propongo no imprimir una caja para cada raspberry, y en su lugar hacernos/diseñarnos una caja en la que meter las 3 raspberries. Podríamos hacer un taller para aprender freecad haciendo la caja (@siotma?), o que alguien se encargue. Ahí dejo la propuesta

GioSunrider, 2018-10-08:
Dado que las Rpi's están colocadas en distintos lugares mejor separadas que juntas.

GioSunrider, 2018-10-08:
Arrastrado tambien de #65

dmarcosm, 2018-10-08:
> Dado que las Rpi's están colocadas en distintos lugares mejor separadas que juntas.

Yo lo decía sobre todo por no tener ahí 3 raspberries sueltas. Siendo la intención cerrar todo (caja de filamentos, cerrar granja), vería muy lógico cerrar todas las Pi's en una caja, ya que además no vamos a tener que tocarlas para nada.

GioSunrider, 2018-10-08:
Lo dejaría de plan a futuro, seguro que esas carcasas se pueden reutilizar en un futuro. Pero de momento busco la rapidez de instalación.

David-Estevez, 2018-10-08:
> Podríamos hacer un taller para aprender freecad haciendo la caja (@Siotma?), o que alguien se encargue. Ahí dejo la propuesta

Me ha contado un pajarito que en el GUL ante este tipo de peticiones hacen que la persona que lo pide dé el taller... dejo ahí la idea... :thinking:

dmarcosm, 2018-10-08:
> > Podríamos hacer un taller para aprender freecad haciendo la caja (@Siotma?), o que alguien se encargue. Ahí dejo la propuesta
>
> Me ha contado un pajarito que en el GUL ante este tipo de peticiones hacen que la persona que lo pide dé el taller... dejo ahí la idea...

Yo no tengo problema alguno en aprender Freecad para hacer un taller :D

> Lo dejaría de plan a futuro, seguro que esas carcasas se pueden reutilizar en un futuro. Pero de momento busco la rapidez de instalación.

Llevamos meses sin hacer octoprint y ahora tenemos prisa en ponerlas en una caja? Hasta que no se adjudiquen en febrero las nuevas subvenciones tenemos bastantes cosas para hacer, así que no veo la prisa en ningún lado.

Si os apetece el taller lo podemos preparar (algo no muy advanced)

David-Estevez, 2018-10-08:
Si no, siempre quedan los tutos de Obijuan: https://www.youtube.com/watch?v=2_DbFzFV9D4&list=PLmnz0JqIMEzWQV-3ce9tVB_LFH9a91YHf

GioSunrider, 2018-10-15:
Durante el puente me traje las dos RPi a casa y siguiendo el tutorial que @dmarcosm realizo ([Ver Enlace](https://github.com/asrob-uc3m/impresoras-asrob/blob/master/octoprint/guia_segunda_instancia.md)), he creado dos estancias en ambas Pi's. Ademas de actualizar y corregir los errores encontrados en el proceso y añadir algunos apartados en el mismo.

dmarcosm, 2018-10-15:
Como dato, en un futuro no muy lejano se intentará hacer todo en un solo script que el usuario pueda ejecutar con un solo comando, así podremos publicarlo y que lo use quien quiera :)
Sobre la instalación, es posible que vaya el jueves, así que si no queda hecho en la reunión y dejas las Pi's allí me encargo @GioSunrider

GioSunrider, 2018-10-15:
En el armario se quedaran. Mañana comenzaremos la instalacion de una de ellas, ya que es la unica que tendria carcasa.

dmarcosm, 2018-10-15:
Cuidado con lo de añadir los 5 bots al grupo. Se puede crear un spam rico rico.

GioSunrider, 2018-10-15:
La idea es usar el grupo que hay de impresoras 3D, no el de printer, de control de Octoprint. Deshabilitar las tajetas SD por Marlin, de esta manera se verifica el uso por parte de un operador, ademas de restringir su uso local y ternerlas controladas por ahi los admins.

dmarcosm, 2018-10-15:
> La idea es usar el grupo que hay de impresoras 3D, no el de printer, de control de Octoprint. Deshabilitar las tajetas SD por Marlin, de esta manera se verifica el uso por parte de un operador, ademas de restringir su uso local y ternerlas controladas por ahi los admins.

Me parece correcto, pero no del todo. Te quedas sin posibilidad de imprimir offline.

Siotma, 2018-10-16:
Las ideas que habéis dado están muy bien, pero no hay que perder de vista que la granja necesitará un tiempo de puesta a punto durante el cual no se podrá dejar las impresoras sin SD, hasta que toda la infraestructura de octoprint:
- [ ]  funcione
- [ ] se haya documentado y
- [ ] se haya formado a la gente para usarla.

El sistema que mencionais, por tanto, es a lo que hay que tratar de llegar, pero no es un futuro cercano. Hay que ponerlo a prueba para encontrar la mejor configuración.

GioSunrider, 2018-10-17:
Ayer se imprimio con hija una de las cajas para las RPi's. De esta manera han quedado ya dos debidamente protegidas con carcasa (Ver Foto).

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

Faltaria por tener una tercera carcasa para la que tiene @dmarcosm en su casa. Lo propongo como RETO DE IMPRESION, se puede dividir en dos personas, para tenerla como esta a dos colores, ¿Algun voluntario?

GioSunrider, 2018-10-27:
En la ultima reunion coloque las RPi en la granja

![photo5954216383850065662](https://user-images.githubusercontent.com/10605193/47605850-
49f42580-da0c-11e8-9a60-7a945df80286.jpg)

 y crimpe los cables necesarios a medida para dotar de internet a la granja.

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

Ademas @anacarnerero diseño una pieza para la colocación del router.

Siotma, 2018-10-28:
Imprimiendo parte de arriba de la caja (top) en color negro.

GioSunrider, 2018-10-30:
Imprimiendo parte de abajo de la caja (Bottom) en color blanco

GioSunrider, 2018-11-02:
En la pasada reunion se termino la colocacion de las RPi como se puede observar en la foto la colocacion.

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

Ademas se conectaron todos los cables hechos a medida y su correspodiente alimentacion. Solo faltaria la colocacion de las Camaras y unir con el cable impresora y RPi.

Ademas se completo la parte de red conectando y colocando el router que dara soporte a la granja, en el perto de Ethernet libre se conecto la torre del ordenador. Se adjunta foto del router colocado. para ello @anacarnerero diseño una pieza que se imprimio, despues de hacerle algun ajuste se coloco y cableo.

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

GioSunrider, 2018-11-05:
Se han creado y añadido los bots al grupo de gestion de las impresoras. Para su creacion se ha determinado median el (Nombre de la impresora)_Printer_bot.

GioSunrider, 2018-11-05:
Para el proximo dia se añadiran a Octoprint y se realizara la gestion de la informacion que envien al grupo.

GioSunrider, 2018-11-15:
Propongo [este soporte](https://www.thingiverse.com/thing:2587839) para hija, blacky y spicy. Para Dédalo y para genoosis habría que buscar alternativas.

GioSunrider, 2018-11-27:
He añadido un edit al comentario inicial, para laconfiguracion de las camaras hay que seguir el tutorial de configuracion proporcionado por @dmarcosm en la siguiente [pagina web](http://thomas-messmer.com/index.php/14-free-knowledge/howtos/79-setting-up-octoprint-for-multiple-printers) y traducirlo para añadirlo a nuestro tutorial. Me pondre esta tarde en la reunion con ello.

GioSunrider, 2018-11-27:
La RPi de Spicy y Geonosis queda asignada con una IP estatica http://192.168.0.100/ y http://192.168.0.100:5001/ respectivamente.

jorgercobo, 2018-12-13:
Se han etiquetado las RPi que controlan cada impresora:
- __100__:
  - Spicy: http://192.168.0.100/
  - Geonosis: http://192.168.0.100:5001/
- __101__:
  - Dedalo
- __102__:
  - Hija Rs
  - Blacky

jorgercobo, 2018-12-13:
El tty al que se conectan las impresoras está configurado de forma automática y puede que los puertos no se mantegan al reiniciar la RPi, además es necesario para la configuración de las webcams fijar el tty de cada impresora. Para ello hay que buscar los ttyUSB que ahora no aparecen, para ello voy a seguir [esta guia](https://forum.level1techs.com/t/solved-octoprint-help-no-serial-no-ttyusb/110536/21). Estoy haciendo estas pruebas en 102.

jgvictores, 2018-12-13:
Te recomendaría:
1. No demasiado caso al tutorial, salvo que quizás ayude el `sudo modprobe ftdi-sio`
1. Un `tail -f /var/log/syslog` para ver qué ocurre cuando se conectan los dispositivos físicamente (parecido a [dmesg](https://github.com/asrob-uc3m/tutoriales/blob/master/software/linux/bash.md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)).
1. Lo que más me preocuparía es que al tener el las impresoras el mismo adaptador, no se controla qué ttyUSB es cuál. Aquí una posible solución, que los diferencia en base a qué conector se conectan físicamente: https://stackoverflow.com/questions/5421008/how-to-uniquely-identify-two-identical-usb-serial-adapters-in-linux (related: https://github.com/asrob-uc3m/impresoras-asrob/issues/2#issuecomment-283737116)

jorgercobo, 2018-12-13:
Muchas gracias. El [tutorial](http://thomas-messmer.com/index.php/14-free-knowledge/howtos/79-setting-up-octoprint-for-multiple-printers) que estamos siguiendo para configurar todo tambien usa ese método. Para la siguiente reunión queda pendiente seguir con lo que sugiere @jgvictores.
En 102:
  - Pendiente identificar cada impresora mediante udevd. Por ahora se hace automático y parece funcionar, pero aseguremonos.
  - Las reglas para las webcams están configuradas y los daemons duplicados y corriendo.
  - Falta por hacer:
    - HaProxy Configuration
    - Tras la parte de las webcams: Another steps follows :) ... We have to make the new instance visible behind HaProxy.

jorgercobo, 2018-12-19:
- HaProxy ya está configurado, a traves de http://192.168.0.102/webcam/ y http://192.168.0.102/webcam2/ se puede acceder a ambas camaras. En webcam se ve la ventana de error de webcams de octoprint como se ha configurado y en webcam2 se ve la pantalla de control de mjpg_streamer. Queda pendiente estudiar las reglas de HaProxy para poder acceder a las webcams mediante /webcam... independientemente de la URL de origen ya que ahora hay que forzar la URL absoluta en Hija al fallar debido al puerto 5001 en la URL.
- El problema de las webcams persiste. Algo que antes no habiamos mencionado es que el led de una de las camaras no se enciende. Esto ocurre tanto en 100 como en 102, **¿puede ser un problema de alimentación?**. Mediante lsusb aparecen ambas webcams pero al ejecutar `tail -f /var/log/syslog` se ve el siguiente mensaje de error de forma periódica:
    Dec 19 17:34:44 octopi pi: Starting USB webcam
    Dec 19 17:34:44 octopi MJPG-streamer [5627]: starting application
Dec 19 17:34:44 octopi MJPG-streamer [5627]: MJPG Streamer Version: git rev: 821c330ea6bbb5fbed98d48e00aac156e923161b
Dec 19 17:34:44 octopi MJPG-streamer [5627]: Using V4L2 device.: /dev/video0
Dec 19 17:34:44 octopi MJPG-streamer [5627]: Desired Resolution: 640 x 480
Dec 19 17:34:44 octopi MJPG-streamer [5627]: Frames Per Second.: 10
Dec 19 17:34:44 octopi MJPG-streamer [5627]: Format............: JPEG
Dec 19 17:34:44 octopi MJPG-streamer [5627]: TV-Norm...........: DEFAULT
Dec 19 17:34:44 octopi MJPG-streamer [5627]: init_VideoIn failed

Tambien adjunto el estado de cada servicio por si aporta info:

pi@octopi:/etc/init.d $ systemctl status webcamd.service
● webcamd.service - LSB: webcam daemon
   Loaded: loaded (/etc/init.d/webcamd; generated; vendor preset: enabled)
   Active: active (running) since Thu 2018-12-13 16:17:04 UTC; 6 days ago
     Docs: man:systemd-sysv-generator(8)
   CGroup: /system.slice/webcamd.service
           ├─ 454 /bin/bash /root/bin/webcamd
           └─5406 sleep 30

Dec 19 17:28:13 octopi mjpg_streamer[5317]: MJPG-streamer [5317]: Format............: JPEG
Dec 19 17:28:13 octopi mjpg_streamer[5317]: MJPG-streamer [5317]: TV-Norm...........: DEFAULT
Dec 19 17:28:43 octopi pi[5404]: Starting USB webcam
Dec 19 17:28:43 octopi mjpg_streamer[5405]: MJPG-streamer [5405]: starting application
Dec 19 17:28:43 octopi mjpg_streamer[5405]: MJPG-streamer [5405]: MJPG Streamer Version: git rev: 821c330ea6bbb5fbed98d48e00aac156e9231
Dec 19 17:28:43 octopi mjpg_streamer[5405]: MJPG-streamer [5405]: Using V4L2 device.: /dev/video0
Dec 19 17:28:43 octopi mjpg_streamer[5405]: MJPG-streamer [5405]: Desired Resolution: 640 x 480
Dec 19 17:28:43 octopi mjpg_streamer[5405]: MJPG-streamer [5405]: Frames Per Second.: 10
Dec 19 17:28:43 octopi mjpg_streamer[5405]: MJPG-streamer [5405]: Format............: JPEG
Dec 19 17:28:43 octopi mjpg_streamer[5405]: MJPG-streamer [5405]: TV-Norm...........: DEFAULT

pi@octopi:/etc/init.d $ systemctl status webcamd2.service
● webcamd2.service - LSB: webcam2 daemon
   Loaded: loaded (/etc/init.d/webcamd2; generated; vendor preset: enabled)
   Active: active (running) since Thu 2018-12-13 16:17:04 UTC; 6 days ago
     Docs: man:systemd-sysv-generator(8)
   CGroup: /system.slice/webcamd2.service
           ├─449 /bin/bash /root/bin/webcamd2
           └─508 ./mjpg_streamer -o output_http.so -w ./www-octopi -p 8081 -i input_uvc.so -d /dev/videoBLACKY -r 640x480 -f 10 -d /dev

Dec 13 16:17:05 octopi mjpg_streamer[508]: MJPG-streamer [508]: Frames Per Second.: 10
Dec 13 16:17:05 octopi mjpg_streamer[508]: MJPG-streamer [508]: Format............: JPEG
Dec 13 16:17:05 octopi mjpg_streamer[508]: MJPG-streamer [508]: TV-Norm...........: DEFAULT
Dec 13 16:17:05 octopi mjpg_streamer[508]: MJPG-streamer [508]: www-folder-path......: ./www-octopi/
Dec 13 16:17:05 octopi mjpg_streamer[508]: MJPG-streamer [508]: HTTP TCP port........: 8081
Dec 13 16:17:05 octopi mjpg_streamer[508]: MJPG-streamer [508]: HTTP Listen Address..: (null)
Dec 13 16:17:05 octopi mjpg_streamer[508]: MJPG-streamer [508]: username:password....: disabled
Dec 13 16:17:05 octopi mjpg_streamer[508]: MJPG-streamer [508]: commands.............: enabled
Dec 13 16:17:05 octopi mjpg_streamer[508]: MJPG-streamer [508]: starting input plugin input_uvc.so
Dec 13 16:17:05 octopi mjpg_streamer[508]: MJPG-streamer [508]: starting output plugin: output_http.so (ID: 00)

jorgercobo, 2018-12-20:
Pendiente de bajar la resolución de las camaras o los fps ya que el problema puede ser de ancho de banda

GioSunrider, 2019-11-15:
En la reunion de ayer se movio el router cerca del ordenador y se instalo en su lugar un switch de 8 puertos que dara servicio a la granja de impresoras. Haria falta imprimir un soporte para que ambos queden fijos. Ademas haria falta un Rpi mas que de servicio a la nueva impresora ademas de Spicy.

GioSunrider, 2019-11-28:
foto de la instalacion del switch

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

GioSunrider, 2019-11-28:
Se necesita terminar de configurar la segunda estancia de RPi que controla a Dedalo y Geonosis.
Se ha bajado la calidad de las Webcams que controlan a la Moebyus One y a Spicy.
Se ha conseguido que la camara de Blacky funcione, queda revisar el resto.

Closed 2023-09-28.

Thread 99 (2018-10-08):

Cadenas Spicy

DiegoGarciaX2, 2018-10-08:
Hay que imprimir adaptadores para instalar las cadenas del eje x e y en Spicy caldito

DiegoGarciaX2, 2018-10-08:
https://www.thingiverse.com/thing:1905344/remixes
Estos adaptadores deberian de funcionar, habria que poner una pequeña expansion horizontal (sobre 1mm)

Siotma, 2018-10-11:
No estoy de acuerdo, esos adaptadores no tienen agujero pasante, como necesitan las cadenetas que hemos comprado. Además, las piezas que has enlazado tienen el macho en la parte externa y la hembra en la interna, mientras que las cadenetas que tenemos van al revés.

Véase #66 para detalles sobre las cadenetas.

Siotma, 2018-10-11:
Buenas candidatas serían las siguientes piezas:

- https://www.thingiverse.com/thing:3072331
- https://www.thingiverse.com/thing:3072340
- https://www.thingiverse.com/thing:2862157

Que comience el reto!

CinnabarCinnamon, 2019-02-07:
Buscando sujeciones para cadenas en Hija hemos encontrado piezas útiles para esta issue.
[E3DV6_Open_Chain_Long_Solo_V4.zip](https://github.com/asrob-uc3m/impresoras-asrob/files/2842126/E3DV6_Open_Chain_Long_Solo_V4.zip)
[E3DV6_Chain_Stepper_Mount_V4.zip](https://github.com/asrob-uc3m/impresoras-asrob/files/2842127/E3DV6_Chain_Stepper_Mount_V4.zip)

Closed 2023-09-28.

Thread 103 (2018-10-11):

Comprar muelles para las camas calientes

Siotma, 2018-10-11:
Desgraciadamente, algunas impresoras, como Hija Resurrection, tienen muelles lamentables en la cama caliente, que dificultan su calibración y mantenimiento. Propongo comprar nuevos muelles para todas las impresoras que los necesiten: https://fervi3d.com/mecanica/188-muelles-cama-calienta-pack-4unidades.html

dmarcosm, 2018-10-16:
Muelles, tambien en Fervi3d: https://fervi3d.com/mecanica/188-muelles-cama-calienta-pack-4unidades.html

1,50€ por cada 4 unidades :+1:

Siotma, 2018-11-07:
Hoy se han comprado 3 kits de 4 muelles en https://fervi3d.com/mecanica/188-muelles-cama-calienta-pack-4unidades.html

Siotma, 2018-11-18:
Los muelles llegaron hace unos días. Los llevaré en la próxima reunión:

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

Closed 2018-11-18.

Thread 104 (2018-10-14):

Reestructuración carpetas de impresoras

Siotma, 2018-10-14:
Actualmente las carpetas de las impresoras contienen muchísima información valiosa que, por desgracia, es inútil porque nadie sabe qué es qué. Además está mezclada información importante con otra que ya no es necesaria. Ejemplos:
- En negro, archivos obsoletos.
- En rojo, archivos desactualizados.

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

Ahora que estamos a punto de implantar Octoprint, propongo actualizar esto y crear una estructura de carpetas del estilo:

- [Nombre Impresora]
  - Slic3r
  - Marlin
  - Linux
  - Otras...

Por otra parte, la carpeta Parts corre el riesgo de crecer de forma descontrolada, por lo que propongo subdividirla con nuevas carpetas para facilitar la localización de las piezas (ver Carpeta de Hija Resurrection: 0363e391158485261eb205cfc239e86b738a5702 ).

dmarcosm, 2018-10-15:
voy a hacer una reestructuración rápida con la idea de @Siotma y vemos qué más cambios podemos hacer :)

GioSunrider, 2018-12-16:
Se ha procedido al cambio de Carpetas y a la reestructuracion, muy buen trabajo, @Siotma y @dmarcosm , cerrad alguno la issue que os lo ha beis ganado.

Closed 2018-12-28.

Thread 105 (2018-10-14):

Mejora de Extrusor de Spicy

GioSunrider, 2018-10-14:
Actualmente tengo una pieza para un extrusor V6 de sobra, ademas de una sujecion de correas. Como en #85 se compraron extrusores de sobra, propongo la implementacion de el sistema Bowden para spicy. Este sistema mejoraria la calidad de las impresiones, ademas de reducir esfuerzo mecanico a los motores.

dmarcosm, 2018-10-14:
No creo que sea lo idóneo. Hemos planteado comprar/pedir subvención para experimentar con nuevos filamentos. Uno de los filamentos que muy probablemente probemos sea flexible. Flexible ≠ bowden. Dejaría al menos una impresora con extrusor directo no sólo por el motivo de cuando investiguemos con flexible, si no porque quizá alguien quiere imprimir con flexible. Todo bowden no :(

GioSunrider, 2018-10-14:
mi idea era dejar en extrusor directo a blacky por varios motivos:
1. Espacio, el marco creo que no es el idoneo para bowden.
2. Es del departamento.
3. Por los motivos de poder imprimir flexible

Ademas tambien dejaria en directo a dedalo, luego ya serian dos impresoras que tendriamos en directo.

Siotma, 2018-10-16:
De acuerdo con que usen directo Blacky + Spicy. Había oído que para Anet hay una pieza mágica que permite imprimir con Filaflex no?

Siotma, 2018-10-19:
Teniendo en cuenta lo bien que imprimen las ANET (o al menos siempre habeis dicho eso), yo trataría de perfeccionar su extrusor antes de dar por hecho que lo vamos a cambiar. Hay ANETs que imprimen en flexible con el extrusor stock + la pieza que dice @dmarcosm . Yo creo que deberíamos intentar que Spicy fuera en esa dirección.

Spicy está nueva. Si imprime bien en su estado actual, cambiarle el extrusor es un riesgo de que empiece a fallar. Solo debe hacerse en caso de que ninguna otra impresora lo necesite más, y yo creo que no es el caso.

Además, no se puede dar por hecho que al ponerle Bowden la calidad va a aumentar, porque el sistema es más complejo y puede dar fallos.

Siotma, 2018-10-27:
En la última reunión se intentó imprimir con Spicy con PLA y se vio que el engranaje que mueve el filamento hacia el extrusor da saltos. Esto provocó que no se pudiera imprimir con Spicy. Invoco a los dioses de las ANET para tratar de solventar este problema. Caso de no ser posible, propongo cambiar el hotend completo por uno de los nuevos, previo acuerdo con @JorFru

dmarcosm, 2018-10-27:
A qué temperatura estaba imprimiendo, por curiosidad?

JorFru, 2018-10-28:
Antes de decidir el cambio de piezas, se debería de investigar mejor las causas del problema.
Lo primero que se me ocurre es reducir la distancia de retracción. Cuando retrae, el filamento se enfría, y cuando vuelve a empujar no fluye porque está frío. 2mm debería de ser suficiente para extrusión directa.
Todos los problemas que yo he tenido con ella en el extrusor han sido por distancia de retracción incorrecta.

Siotma, 2018-10-31:
De acuerdo @JorFru , seguiremos investigando.

GioSunrider, 2018-12-15:
Realizado el cambio en #120 esto ya no es necesario ya que no ha vuelto a haber problemas al respecto. Procedo a cerrar la discusión.

GioSunrider, 2018-12-15:
También debido a #107 en la que se acordó la colocación de los extrusores.

Closed 2018-12-15.

Thread 106 (2018-10-15):

Actualización general a Marlin 1.1.9

dmarcosm, 2018-10-15:
Como hemos dicho en #104, es hora de actualizar todas nuestras impresoras a Marlin 1.1.9, la última versión estable.
He dejado los archivos de todas las impresoras menos Spicy ya actualizadas. Añadir que aun después de arreglar la OVM20 de Geonosis, no se debe instalar el firmware que hay subido, ya que queda cambiar cosas como el modelo de la placa y los motores de X e Y (@JorFru)
Por otra parte, necesito @Siotma que me confirmes si sabes si los drivers que utilizan Dédalo, Blacky e Hija son A4988 o DRV8825. Marlin por defecto coge los A4988, así que si alguna placa usa los DRV habrá que cambiarlo antes de subir nada (no queremos humo!)

Todos los archivos actualizados han quedado subidos al git en una rama de desarrollo, para no perder los archivos antiguos hasta que estemos seguros (aunque esto es git, todo se recupera :D) https://github.com/asrob-uc3m/impresoras-asrob/tree/

- [x] Hija
- [x] Blacky
- [x] Dedalo
- [ ] Spicy

Siotma, 2018-10-16:
Gran trabajo David. Estamos en proceso de actualizaciones.

Por cierto, Dédalo lleva DRV8825 via https://www.staticboards.es/productos/ovm20-lite/
Por favor, indícanos qué cambios hay que hacer para que los soporte...

Siotma, 2018-10-16:
Blacky e Hija llevan A4998 via https://www.pccomponentes.com/bq-kit-de-electronica-ramps-1-4

dmarcosm, 2018-10-16:
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

Ya ha quedado hecho, pero para la próxima aquí podéis ver qué cambios hay que hacer. Es simplemente definir el modelo que estemos usando: https://github.com/asrob-uc3m/impresoras-asrob/commit/efa813dfe8ea802819b449c747f9eb1dba94f0f2

Siotma, 2018-10-16:
Blacky actualizada. Hemos modificado los archivos via 6c78d1ae91d9864f3c4328e8c9b3b81d6aa9a9ba
- El archivo Configuration.h tenía los endstop invertidos. Lo hemos invertido a mano.
- Hemos habilitado el custom menu.

Siotma, 2018-10-16:
Dedalo actualizada. Hemos modificado los archivos via 506d392906b08315b79a63e381e4fb5b81fca3f7
- Al archivo Configuration.h le faltaban líneas de tipo //DEDALO en los DRV.
- Hemos habilitado el custom menu.

dmarcosm, 2018-10-16:
> Hemos habilitado el custom menu.

Esto es...?

GioSunrider, 2018-10-16:
> > Hemos habilitado el custom menu.
>
> Esto es...?

Aceso directo a los principales comandos, como cooldown, prepare y demas, aunque en realidad se le puede poner lo que quieras.

Siotma, 2018-10-16:
Es lo que comenté en https://github.com/asrob-uc3m/impresoras-asrob/issues/84#issuecomment-425507793
Habilitando el custom menu se añade una opción nueva al menú principal, donde puedes añadir hasta 5 comandos personalizados. Lo ideal es poner ahí lo que más se usa para no tener que estar buscándolo entre los submenús, y además puede haber combinaciones de varias cosas. Todo lo que haya aquí está a 2 clics de la pantalla principal. Por ejemplo se puede configurar así:
- Precalentar + home.
- Enfriar.
- Home.
- Introducir filamento.
- Extraer filamento.

En 506d392906b08315b79a63e381e4fb5b81fca3f7 y 6c78d1ae91d9864f3c4328e8c9b3b81d6aa9a9ba se puede comprobar los comandos que hemos puesto hoy. En un futuro, el uso dirá cuáles es más interesante tener.

GioSunrider, 2018-10-16:
Yo probaria el de cambio de filamento, mientras esta en impresion, igual conviene tenerlo mas a mano...

dmarcosm, 2018-10-16:
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

Interesante cuanto menos!

Siotma, 2018-10-16:
> Yo probaria el de cambio de filamento, mientras esta en impresion, igual conviene tenerlo mas a mano...

> - Introducir filamento.
> - Extraer filamento.

dmarcosm, 2018-10-17:
> Si pero eso en mitad de la impresion no se si llegaria a funcionar, y creo recordar que habia un comando el nuevo marlin que lo permitia directamente.

Es lo que se llama en Marlin Pausa Avanzada. Básicamente aparca el nozzle a un lado para poder hacer el cambio de filamento. Es interesante pero creo que activar eso y también el autolevel cuando se lo pongamos a geonosis nos va a causar problemas de memoria.

Siotma, 2018-10-19:
Una cosa es actualizar el firmware y otra distinta probar nuevas funciones. Sin duda, los custom commands nos pueden ayudar con la Pausa Avanzada, pero  primero hay que ponerle el nuevo firmware a todas las impresoras y documentarlo bien para poder cerrar esta issue. Luego ya se abrirá otra para jugar con nuevas funciones, sabiendo que siempre podemos volver atrás.

> Añado a actualizar Spicy.

Spicy aún no tiene ficheros de Marlin en el repo :cry:

Siotma, 2018-10-31:
Hoy he flasheado el nuevo Marlin en Hija. Ha habido que hacer varias modificaciones porque había muchas líneas que no estaban marcadas con //Hija_Resurrection. Creo que ya está todo bien. El commit es: 8a2e7166380248934b6436cc1ec6ddb0ca36be21

Siotma, 2018-11-03:
Según tengo entendido, no es trivial actualizar a Spicy y a Geonosis:

- Spicy actualmente lleva un firmware especial para ANET flasheado por @GioSunrider, él puede aportar más datos.
- Geonosis lleva actualmente el firmware original, y no tenemos las fuentes.

Para actualizarlas, se debería abrir otra issue y discutir más detenidamente el modo de proceder.

Creo que esta issue se puede dar por cerrada con éxito y @dmarcosm puede ir haciendo el pull request.

GioSunrider, 2018-11-04:
Para que conste Spicy esta flasheada con el Marlin denominado SkyNet, en el fondo es un Marlin 1.1.8., actualemente lo tengo disponible en mi perfil de Git, [Link](https://github.com/GioSunrider/X-WING-Anet-A8/tree/master/Marlin%201.1.8%20-%20X-WING). En mi opinion seria conveniente actualizar a Marlin 1.1.9. y fuera.

Closed 2018-11-03.

Thread 107 (2018-10-19):

Discusión: renovación de extrusores.

Siotma, 2018-10-19:
Recientemente hemos comprado nuevos extrusores y materiales accesorios: https://github.com/asrob-uc3m/impresoras-asrob/issues/85#issuecomment-431419187

Sin embargo, no está claro qué impresoras van a recibirlos:
- Uno ya está satisfactoriamente instalado en Hija: https://github.com/asrob-uc3m/impresoras-asrob/issues/84
- Quedan dos para repartir entre Blacky, Geonosis, Dédalo y Spicy.

Hay que tener en cuenta que el próximo año con nuevas subvenciones se podrán comprar más.

Esta issue es para decidir en qué impresora se colocarán los extrusores. Luego habrá que abrir otras issues para su colocación, o reutilizar las existentes: #105 #83

Siotma, 2018-10-19:
Pego ideas sacadas de #85 :

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

Siotma, 2018-10-19:
Mi primera aportación nueva es que, siendo los extrusores de ASROB, y siendo especiales para bowden, sería una pena que Geonosis se quedara sin uno (Geonosis e Hija son las únicas impresoras propiedad de ASROB y debería ser una prioridad que funcionen adecuadamente).

Por otra parte, sigo pensando que Dédalo es un buen candidato a obtener uno de estos extrusores teniendo en cuenta que tiene el extrusor más antiguo de todos, y que además condiciona mucho su volumen de impresión.

A Blacky: le vendría bien un extrusor como los que hemos comprado porque ahora se atasca de vez en cuando, pero hay que tener cuidado con cambiarle piezas porque es del departamento.

A Spicy: es una impresora nueva y funciona correctamente, por lo que no veo urgencia en cambiar su extrusor.

dmarcosm, 2018-10-19:
Yo a Geonosis no le cambiaría el extrusor, el que trae me parece que es decente (al menos más decente que el de Spicy).
Mantengo lo de que se lo pondría a Spicy pero sería conveniente tener alguna impresora con extrusor directo.

Siotma, 2018-10-19:
Hay que tener en cuenta que para instalar un extrusor como el puesto en Hija (#84) hay que tener los siguientes elementos:
- [1x Hobbed Bolt](https://fervi3d.com/extrusion/156-tornillo-ranurado-extrusor-m8.html)
- [3x Rodamiento 608ZZ](https://fervi3d.com/mecanica/154-rodamiento-608zz-8x22x7mm.html)
- 1x Eje 8mm diametro 20 mm largo

En su momento yo doné un kit para Hija en https://github.com/asrob-uc3m/impresoras-asrob/issues/42#issuecomment-362639453 , pero lo suyo no es eso. Actualmente sólo Hija, Blacky y Dédalo tienen ya estas piezas. Para el resto habría que comprarlas.

GioSunrider, 2018-10-20:
> Mi primera aportación nueva es que, siendo los extrusores de ASROB, y siendo especiales para bowden, sería una pena que Geonosis se quedara sin uno (Geonosis e Hija son las únicas impresoras propiedad de ASROB y debería ser una prioridad que funcionen adecuadamente).
>
Esta noche pense lo mismo y por las mismas razones, ademas de que poniendole un reductora tendriamos la posibilidad de que no perdiera pasos al extruir.

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

Referido a esto añadiria a la subvencion uno o dos kits de estos, ya que podemos prescindir de un filamento y comprar esto que casi es mas necesario ademas de tener asi respuestos.

dmarcosm, 2018-10-20:
> Yo a Geonosis no le cambiaría el extrusor, el que trae me parece que es decente (al menos más decente que el de Spicy).

Con esto quería decir que hay que pensar que no es lo mismo extrusor que hotend. Pienso que Geonosis tiene un hotend aceptable, y que lo que necesita ser cambiado es el extrusor, por esto:
> poniendole un reductora tendriamos la posibilidad de que no perdiera pasos al extruir.

GioSunrider, 2018-10-21:
Yo a Geonosis le cambiaba todo, nos quitaríamos de muchos problemas. Y lo que dice Manu, son la prioridad que funcionen bien.

dmarcosm, 2018-10-21:
Pero si ese hotend ya funciona bien, no es necesario cambiarlo "para que funcione bien", porque ya lo hace. Cambiando el extrusor ya nos quitaríamos de "todos" los problemas y dejaríamos el otro hotend libre para otra impresora.

Siotma, 2018-10-23:
Propongo mañana desmontar el hotend de Geonosis y valorar opciones de mejorarlo.

GioSunrider, 2018-10-23:
Me parece perfecto.

Siotma, 2018-10-27:
Además, téngase en cuenta esto respecto a Spicy: https://github.com/asrob-uc3m/impresoras-asrob/issues/105#issuecomment-433620314

GioSunrider, 2018-11-27:
La propuesta es, Colocar un volcano a Geonosis con el V6 dado a su volumen de impresion sea mas aprovechado, ademas de a Blacky, y el Hot-End de Geonosis colocarselo a Dedalo cuando se gaste todo el filamento de 3 mm que actualmente tenemos.

Thread 108 (2018-10-22):

Las solicitudes de operador no se están respondiendo

JorFru, 2018-10-22:
Ejemplo:
https://github.com/asrob-uc3m/operadores/issues/42
26 días sin respuesta.

dmarcosm, 2018-10-22:
Están en el grupo de impresoras y cuando lo han comentado se les ha dicho que hasta que no haya varias funcionales no es posible hacerlo (hace 2 semanas). Sí es verdad que ahora mismo ya funcionan tanto la Anet como Hija y se podría hacer la formación.

GioSunrider, 2019-02-03:
He realizado una pregunta general a todos los implicados para ver si siguen o no interesados, si no recibo respuesta en un par de semanas cerrare sus respectivas issues. Si siguen interesados ya buscaremos forma de realizarles la formacion.

Closed 2019-02-03.

Thread 109 (2018-10-24):

Engranajes para la OSHWDem 2018

GioSunrider, 2018-10-24:
Tal y como se comento por el grupo de Telegram, hay un reto de "Clone Wars" para la OSHWDem 2018. Las especificaciones del reto se encuentran en [este repositorio](https://github.com/brico-labs/Reto-Clonewars-Oshwdem-2018).
El reto consiste en llenar una pared de engranajes, y que mejor que nosotros para diseñar los que llevaremos como asociacion. Mi idea es llevar un minimo de 2, uno como asrob y otro como Printe One.
El primero de asrob seria el N34: [Reto Clone Wars OSHWDem 2018](https://github.com/asrob-uc3m/impresoras-asrob/blob/master/Reto%20Clone%20Wars%20OSHWDem%202018/N34-ASROB.FCStd)

GioSunrider, 2018-10-24:
Tambien habria que diseñar uno que ponga Printer One e imprimirlos. ¿Algun voluntario?

dmarcosm, 2018-10-24:
> El primero de asrob seria el N34: Reto Clone Wars OSHWDem 2018

Sube el stl, porfi

GioSunrider, 2018-10-24:
No consigo generarlo, puedes intentarlo tu?

GioSunrider, 2018-10-25:
Al generar el gcode daba error de pieza, se ha pasado por una aplicación web que @Siotma recomendó y se han reparado los STL. Actualmente los archivos correctos son las extensiones .3mf que vienen indicados como repaired.

GioSunrider, 2018-10-25:
Además se vio que la impresión era demasiado larga, por lo que se propone como reto de impresión en casa, ¿algún voluntario?

GioSunrider, 2018-10-26:
Lo he probado, y no termina de generar bien el STL Como con esta pagina.

dmarcosm, 2018-10-26:
Pues a mí me lo acaba de generar sin problemas, habrá que actualizar el Slic3r del PC de la nave por si fuera cosa de la versión. Lo digo sobre todo de cara a no tener que andar con ñapas, que es lo que es abrir una página más

GioSunrider, 2018-10-26:
Tenemos al rey de las ñapas en nuestras filas, no creo que las papas sean el problema 😂😂😂😂

David-Estevez, 2018-10-26:
🤟🏻

GioSunrider, 2018-10-27:
He puesto a imprimir en Negro el Engranaje de Printer One. Dejo pendiente de quien lo desee el de Asrob, a ser posible que no sea ni blanco ni negro.

Siotma, 2018-10-28:
La página de la que habla @GioSunrider es https://tools3d.azurewebsites.net/ (editado también en su comentario). Es de uso libre, solo hace falta una cuenta de microsoft (el hotmail del messenger mismamente).

> Como dato, y para evitar tener que usar otros sitios, Slic3r auto repara el STL cuando ve que tiene errores. Al importarlo lo hace automágicamente :)

No conozco ninguna herramienta de reparación capaz de hacer lo que hace esta.

Siotma, 2018-10-28:
Leyendo las [condiciones del reto en la página oficial](https://github.com/brico-labs/Reto-Clonewars-Oshwdem-2018), veo que los archivos disponibles para el engranaje N-34_ASROB **no cumple con los requisitos**, ya que no tiene agujero pasante. Además, tampoco veo que nos hayamos apuntado en la [lista de participantes](https://docs.google.com/spreadsheets/d/1SnokEGJ45Vu7sOCrKUwsjmvuEwmsKIhkQNeIIfKUH_w/edit#gid=0)...

@GioSunrider, alguna idea?

GioSunrider, 2018-10-28:
Tenia pensado apuntarnos, una vez impresos correctamente, por si no daba tiempo a imprimirlos.

GioSunrider, 2018-11-08:
Hija imprimió el ultimo engranaje.

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

GioSunrider, 2018-11-08:
Engranajes guardados y listos para llevar a la OSHWDem!!

GioSunrider, 2018-11-12:
Se entregaron los engranajes y quedaron colocados en la pared! ademas adjunto las fotos y videos en los que se pueden ver lo bien que han quedado.

[Publicacion Instagram ASROB](https://www.instagram.com/p/BqA1MprHL6A/?utm_source=ig_web_options_share_sheet)

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

Con esto doy por concluido el reto y cierro issue.

Closed 2018-11-12.

Thread 110 (2018-11-07):

Comprar piezas necesarias para extrusores geared

Siotma, 2018-11-07:
Hoy se han comprado piezas para hacer nuevos extrusores geared:
- 6x [rodamientos 608Z](https://fervi3d.com/mecanica/154-rodamiento-608zz-8x22x7mm.html)
- 2x [hobbed bolt](https://fervi3d.com/extrusion/156-tornillo-ranurado-extrusor-m8.html)
- 1x [varilla M8 lisa 200mm](https://fervi3d.com/extrusion/156-tornillo-ranurado-extrusor-m8.html)

GioSunrider, 2018-11-08:
Cuando puedas @Siotma podrías añadir los enlaces?

GioSunrider, 2018-11-08:
Muchas gracias!

Siotma, 2018-11-18:
Las piezas llegaron hace unos días. Las llevaré en la próxima reunión:

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

Closed 2018-11-18.

Thread 112 (2018-11-12):

Hacer ballestas

VentressAsajj, 2018-11-12:
Me acordé de ponerlo @GioSunrider @dmarcosm ¿cuándo hacemos las ballestas?
Tweet:
https://twitter.com/fisadev/status/1059631656250806274
Thingiverse:
https://www.thingiverse.com/thing:1995091
Cómo montarla
https://t.co/8zYOswTtnr

GioSunrider, 2018-11-12:
Organizamos un taller de ballestas 😂😂

VentressAsajj, 2018-11-13:
Vamos. Cuando es la próxima reunión de printerone? yo tengo que ser operadora, debo poner otra issue ( como digas que sí te mato jajaja )

MrTommyGuns, 2018-11-13:
La próxima reunión es Jueves de 6 a 9

GioSunrider, 2018-11-13:
Eso es sigue lo que te ha dicho Tommy, vivan las issues 🤣🤣

dmarcosm, 2018-11-13:
> Vamos. Cuando es la próxima reunión de printerone? yo tengo que ser operadora, debo poner otra issue ( como digas que sí te mato jajaja )

El jueves las imprimimos!!

VentressAsajj, 2018-11-13:
Pues si el jueves se imprimen, no creo que sea necesario hacer el curso intensivo de operadora ni poner la puuuññññetera issue :joy:

dmarcosm, 2018-11-13:
Imprimir las piezas de la ballesta te vale como parte de la formación de operadora :)

jorgercobo, 2018-11-15:
Primer intento de impresión

jorgercobo, 2018-11-15:
Falta una de las piezas laterales y los tornillos

Closed 2023-09-28.

Thread 113 (2018-11-15):

Nuevo carro para Blacky

jorgercobo, 2018-11-15:
Vamos a ponerle a Blacky el carro que ya está funcionando en Hija #84

- 3 piezas del [L3Kv2](https://www.thingiverse.com/thing:1855673):
  - [x] [1x Wade_L3K_v2_Idler.zip](https://github.com/asrob-uc3m/impresoras-asrob/files/2393904/Idler.zip)
  - [x] [1x Wade_L3K_v2_Idler_hodler.zip](https://github.com/asrob-uc3m/impresoras-asrob/files/2393905/Idler_hodler.zip)
  - [x] [1x Bearing_Washer.zip](https://github.com/asrob-uc3m/impresoras-asrob/files/2393911/Bearing_Washer.zip)

- 2 piezas Remix del [L3K](https://www.thingiverse.com/thing:512338), pero diseñado para poder meter el tubo de teflón hasta el Barrel:
  - [x] [1x Wade_L3K_custom_flange_1.75_v2_mirrored.stl.zip](https://github.com/asrob-uc3m/impresoras-asrob/files/2394024/Wade_L3K_custom_flange_1.75_v2_mirrored.stl.zip)
  - [x] [1x Wade_L3K_custom_body_1.75_centered.stl.zip](https://github.com/asrob-uc3m/impresoras-asrob/files/2384181/Wade_L3K_custom_body_1.75_centered.stl.zip)

- Creación propia:
  - [x] [1x Body_E3dv6_Washer.zip](https://github.com/asrob-uc3m/impresoras-asrob/files/2393912/Body_E3dv6_Washer.zip)
  - [x] Extra ventilador de capa: [1x Blower_duct.zip](https://github.com/asrob-uc3m/impresoras-asrob/files/2394029/Blower_duct.zip)

Que empiece el reto!

GioSunrider, 2018-11-27:
Algún voluntario para imprimirlo en casa? Es necesario imprimirlo en casa dado que el tiem po de impresion excede el tiempo de cualquier reunion normal.

GioSunrider, 2018-12-05:
Imprimiendo todo menos el carro en Hija y Blacky

GioSunrider, 2018-12-07:
Blacky imprimio su propio Duct como muestra la foto.

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

E hija imprimioo el resto de piezas, hubo una pequeña perdida de pasos, se valorara si la piezas sirven o no en la siguiente reunion.

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

GioSunrider, 2018-12-14:
Se ha reimpreso el boddy ya que se sufrio un desplazamiento de capa y no quedo bien alineado. el resto de piezas se pueden usar sin problemas.
Cierro issue y abro una nueva para el cambio de extrusor, ya que se comenzo con el cambio.

Closed 2018-12-14.

Thread 114 (2018-11-15):

Cambio extrusor para Geonosis

jorgercobo, 2018-11-15:
Se ha decidido cambiar el extrusor de Geonosis a un v6 con bloque Volcano de nozzle 1,2. Para ello se necesitan las siguientes piezas:

- 3 piezas del [carro](https://www.thingiverse.com/thing:2865870):
  - [x] [1x Duct.stl.zip](https://github.com/asrob-uc3m/impresoras-asrob/files/2586589/Duct.stl.zip)
  - [x] [1x CR-10_HD-modular-mount-V6_mount-cover__40mm-fan_v1.stl.zip](https://github.com/asrob-uc3m/impresoras-asrob/files/2586593/CR-10_HD-modular-mount-V6_mount-cover__40mm-fan_v1.stl.zip)
  - [x] [1x v6_mont_x5s_v4.stl.zip](https://github.com/asrob-uc3m/impresoras-asrob/files/2586594/v6_mont_x5s_v4.stl.zip)
  - [x] [1x autolevel.stl.zip](https://github.com/asrob-uc3m/impresoras-asrob/files/2586587/autolevel.stl.zip)

[EDIT]

- [x] [Duct Volcano](https://www.thingiverse.com/thing:3265261)

GioSunrider, 2018-11-27:
Imprimiendolo en casa para ver si esta tarde lo puedo llevar para comenzar su montaje.

Siotma, 2018-11-27:
Imprimiendo el duct en Hija.

jorgercobo, 2018-11-27:
Se ha comenzado a montar el carro, pero hay un problema con las tuercas traseras. Pendiente de volver a montarlo en la siguiente reunión

jorgercobo, 2018-11-27:
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

GioSunrider, 2018-12-07:
Se imprimio en Blacky el soporte del Autolevel, ya que, como se ve en la foto, es donde tambien va colocado el End-Stop.

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

Ademas como se ven en la foto anterior se termino de colocar el resto del extrusor a falta de colocar el ventilador de capa, el cual se realizo el cambio y se soldó.

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

No se pudo colocar, ya que el Duct no esta adaptado para la cabeza Volcano, para ello, he diseñado una [pieza nueva para poder poder el ventilador](https://www.thingiverse.com/thing:3265261)
El proximo dia se imprimira y se colocara.

GioSunrider, 2018-12-20:
En la pasada reunion lleve el nuevo duct, esta vez, con los cambios necesarios. Se instalo y quedo perfecto. por lo que queda como satisfactorio el cambio de extrusor.

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

JorFru, 2019-05-09:
El nozzle actualmente instalado en geonosis, aunque en su inscripción lateral se puede leer claramente 1.2, este nozzle es de 0.8mm aunque Giorgio diga lo contrario.
El calibre digital chino dicta que son 0.8, y los chorretes que suelta miden 0.8 también.
conclusión: 0.8

Closed 2018-12-20.

Thread 115 (2018-11-30):

Tensar y alinear la correa del eje Y de Dédalo

Siotma, 2018-11-30:
La correa del eje Y de Dédalo quedó destensada tras finalizar #69 . Hay que tensarla, para lo cual hay que desmontar la cama caliente. Propongo que se aproveche la ocasión para alinear la correa ya que actualmente tiene cierto ángulo y esto provoca esfuerzos e imprecisiones. Propongo imprimir una pieza sencilla (un prisma sería suficiente) que haga de suplemento.

CeciliaVa, 2018-12-05:
Hoy @MrTommyGuns, @CinnabarCinnamon y yo hemos alineado y tensado la correa, aunque no hemos impreso ningún tipo de prisma supletorio. No sé si esta pieza era necesaria o era sólo una sugerencia.

GioSunrider, 2018-12-15:
Revise la alineacion de la correa y me pareció correcta. Yo tampoco se a que prisma se refiere @Siotma pero la impresora en teoría debería funcionar sin problemas.

GioSunrider, 2018-12-15:
@CeciliaVa o @MrTommyGuns proceder alguno a cerrar la issue que os lo habéis ganado.

MrTommyGuns, 2018-12-15:
Cerraamos!

Siotma, 2019-01-11:
Básicamente me refería a instalar algún suplemento bajo la cama que haga que el movimiento de la correa sea horizontal y no inclinado, de esta forma el polígono que circunscribe la correa no se deforma al moverse la cama, lo que evita tensiones y destensiones indeseadas.

Me he entretenido dibujando esta imagen para que se entienda lo que quiero decir: como se puede ver, entre la posición extrema de la cama (1mm) y la posición central de la cama (90mm) la forma de la correa (línea verde) cambia si esta está desnivelada; pero estando nivelada siempre mantiene la misma forma:
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

Si echamos cuentas sacamos que la correa cuando está desnivelada puede sufrir esfuerzos de tensión y destensión, llegando a modificar su longitud significativamente, mientras que estando nivelada eso no ocurre:
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

A la vista de esto, considero que tener la correa nivelada alarga la vida de la mecánica y también mejorará la precisión de las impresiones.

Siotma, 2019-01-11:
Por lo descrito en el comentario anterior, ayer añadí unos suplementos bajo la cama de dédalo que corregían el desnivel:

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

Siotma, 2019-01-12:
Las piezas, por cierto, las saqué de aquí: https://www.thingiverse.com/thing:181524/files

[belt-y-clamp-gt2.zip](https://github.com/asrob-uc3m/impresoras-asrob/files/2751964/belt-y-clamp-gt2.zip)

Closed 2018-12-15.

Thread 116 (2018-11-30):

Instalar nuevos muelles en Dédalo

Siotma, 2018-11-30:
En la última reunión, @madelgj y @CeciliaVa instalaron los muelles comprados en #103 en Dédalo. Quedaron muy bien y realmente han mejorado la estabilidad de la base de impresión. Debido a #115, habrá que desmontarlos y volver a ponerlos, pero el crédito es para ellas de cualquier manera así que pueden cerrar la issue.

Para muestra una foto:

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

CeciliaVa, 2018-12-05:
Hoy @MrTommyGuns, @CinnabarCinnamon y yo, con la colaboración de @DiegoGarciaX2, tras reajustar la dirección del eje Y y tensar la correa de ese mismo eje (#115) hemos colocado los nuevos muelles y calibrado a Dédalo :smiley: :tada:

Closed 2018-12-15.

Thread 117 (2018-11-30):

Instalar nuevos muelles en Blacky

Siotma, 2018-11-30:
En #103 se compraron nuevos muelles. Están en el armario. Tareas:

- [x] Sustituir los muelles que tiene Blacky actualmente en la cama caliente por los nuevos.
- [x] Nivelar la cama caliente de Blacky.

CinnabarCinnamon, 2019-01-18:
Nuevos muelles instalados. Los antiguos se han guardado en la caja "RODAMIENTOS".
Cama nivelada. Se puede imprimir.
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

Closed 2019-01-18.

Thread 118 (2018-11-30):

Instalar nuevos muelles en Hija Resurrection

Siotma, 2018-11-30:
En #103 se compraron nuevos muelles. Están en el armario. Tareas:

- [x] Sustituir los muelles que tiene Hija Resurrection actualmente en la cama caliente por los nuevos.
- [x] Nivelar la cama caliente de Hija Resurrection.

CinnabarCinnamon, 2019-01-18:
Muelles sustituidos. Cama nivelada.
Se ha adherido el cartón a la cara inferior de la cama.
Se puede imprimir.
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

Closed 2019-01-18.

Thread 119 (2018-12-14):

Cambio de extrusor Blacky

GioSunrider, 2018-12-14:
Viene de #113, pese a los problemas que se citan ahi, en la ultima reunion se comenzo el cambio de extrusor, desmontando el anterior. Blacky queda en el estado de la foto hasta la proxima reunion que llevare las piezas que faltan.

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

GioSunrider, 2018-12-20:
En la ultima reunion se termino de colocar el nuevo extrusor de Blacky. Tambien se coloco el ventilador de capa. por lo que esta issue se da por cerrada.

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

GioSunrider, 2018-12-20:
Solo faltaria calibrarla, recomiendo hacerlo despues de cambiar los muelles de la cama.
Y realizar pruebas de impresion.

Siotma, 2019-01-12:
En la última reunión se detectó que el ventilador de capa de Blacky se había partido. Aprovechando que diseñé una segunda versión del que tenía, imprimimos esa. Dejo la pieza aquí. He detectado que la carpeta Parts de Blacky está casi vacía: #121

[Blower_duct_v2.zip](https://github.com/asrob-uc3m/impresoras-asrob/files/2751967/Blower_duct_v2.zip)

Closed 2018-12-20.

Thread 120 (2018-12-14):

Cambio de Bloque Spicy

GioSunrider, 2018-12-14:
En la ultima reunion, al ir a imprimir con Spicy, nos percatamos de una GRAN atasco en ella. Ademas de ello me percate de que el bloque de spicy tenia fugas por doquier, asi que aprovechando que habia que desmontar, procedimos a cambiar el bloque y nozzle, ya que tenemos un buen stock de ellos.

Se le coloco un nozzle de 0,4 y se deshizo el atasco. Adjunto foto del resultado final.

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

Closed 2018-12-14.

Thread 121 (2019-01-12):

Documentar las piezas de Blacky

Siotma, 2019-01-12:
La carpeta de piezas de Blacky (https://github.com/asrob-uc3m/impresoras-asrob/tree/master/Blacky/Parts) está actualmente casi vacía y muy desactualizada. Teniendo en cuenta que recientmente se ha instalado un nuevo extrusor (#119) se debería aprovechar para actualizarla.

P.D.: Nótese que el nuevo ventilador de capa es la V2 que he dejado [aquí](https://github.com/asrob-uc3m/impresoras-asrob/issues/119#issuecomment-453742406)

CinnabarCinnamon, 2019-01-30:
Se ha subido los archivos .stl de varias piezas de extrusor y LCD de Blacky a la carpeta Parts.

Closed 2019-01-30.

Thread 122 (2019-01-13):

Donacion Chasis Anet A8

GioSunrider, 2019-01-13:
En la ultima reunion, lleve la ultima donacion realizada a Printer One. Un chasis completo de Anet A8. Venia montado, asi que lo desmontamos y almacenamos para tener piezas de recambio para Spicy.

GioSunrider, 2019-01-13:
Foto ajunta del chasis

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

Closed 2019-01-13.

Thread 123 (2019-01-13):

Tensores Spicy X e Y

GioSunrider, 2019-01-13:
En la ultima reunion, aprovechando que #122 vino con el Tensor del eje Y, se desmonto e instalo en spicy, dando como resultado la siguiente imagen.

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

El siguiente paso a recorrer seria la discusion, impresion e instalacion del tensor del eje X, por lo que propongo el siguiente proceso:

- [x] Discusión sobre que tensor colocar

- [ ] Impresion del Tensor

- [ ] Colocacion del Tensor

CinnabarCinnamon, 2019-02-07:
Piezas encontradas para tensor:

[X-axis-Right_2017.zip](https://github.com/asrob-uc3m/impresoras-asrob/files/2842201/X-axis-Right_2017.zip)
[BIG-thumbscrew.zip](https://github.com/asrob-uc3m/impresoras-asrob/files/2842202/BIG-thumbscrew.zip)
[pulley-Toothed_bearing.zip](https://github.com/asrob-uc3m/impresoras-asrob/files/2842203/pulley-Toothed_bearing.zip)
[tensioner-Thick.zip](https://github.com/asrob-uc3m/impresoras-asrob/files/2842204/tensioner-Thick.zip)

GioSunrider, 2019-02-14:
ya que hay que imprimirm, imprimiremos mejor la misma pieza que lleva [Hija](https://github.com/asrob-uc3m/impresoras-asrob/tree/master/Hija%20Resurrection/Parts/X%20axis)

CinnabarCinnamon, 2019-02-14:
La pieza impresa sirve para Blacky, NO para Spicy.

GioSunrider, 2019-02-15:
Sigue para Blacky en #136

GioSunrider, 2019-02-15:
Para no tener que imprimir una pieza nueva del eje X, propongo el siguiente [tensor](https://www.thingiverse.com/thing:3078070) asi ni necesita sustitucion de correa por ser demasiado pequeña ni una piezaq entera nueva. El proximo dia, podemos imprimir y colocarlo.

MrTommyGuns, 2019-02-21:
Adjunto Link para imprimir un tensor bien hot.
https://www.thingiverse.com/thing:1428253

L4g0, 2019-02-28:
Instalado tensor eje X :smile:
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

Closed 2019-02-28.

Thread 124 (2019-01-13):

Filamento PETG: Primeras pruebas

GioSunrider, 2019-01-13:
En la ultima reunion comence la realizacion de pruebas con el filamento comprado con el dinero de la ultima subveccion.
Realice los cambios pertinentes en el Perfil que tengo para Hija Resurrection, en Simplify 3D, obteniendo como resultado la siguiente piramide.

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

Destacar que la impresion fue buena, los hilos de las retracciones son debidos a que en mi perfil tiene una velocidad muy superior a la que el motor admite y no realizo ninguna durante la impresion.
Una vez ajustados estos parametro subire el perfil al repo.
Para ajustar el perfil segui [el articulo](https://bitfab.io/es/blog/petg-impresion-3d/) del blog de Bitfab escrito por @diegotrap sobre el PETG.

GioSunrider, 2019-10-20:
Se ha usado el filamento sin problemas y procedo a cerrar la issue.

Closed 2019-10-20.

Thread 125 (2019-01-30):

Ventilador de capa Dédalo

CinnabarCinnamon, 2019-01-30:
El ventilador de capa de Dédalo produce un error de thermal runaway, habrá que hacer otro diseño o inventar algo para colocarlo de manera que apunte a la pieza.

CinnabarCinnamon, 2019-02-21:
Gracias a Víctor por su aportación, te
[piezaventilador2.zip](https://github.com/asrob-uc3m/impresoras-asrob/files/2890573/piezaventilador2.zip)
[pieza centilador.zip](https://github.com/asrob-uc3m/impresoras-asrob/files/2890574/pieza.centilador.zip)

nemos piezas para el ventilador.

GioSunrider, 2019-02-28:
Resulta que hemos encontrado una colocacion mejor y hemos usado la misma pieza pero sin dimensionar.

https://www.thingiverse.com/thing:823412/files

GioSunrider, 2019-02-28:
Tampoco vale esa pieza, así que he optado por rediseñarla. El carro ha quedado medio desmontado así que queda fuera de servicio hasta su finalización.

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

GioSunrider, 2019-05-09:
He rediseñado unas piezas para el ventilador. Se encuentran publicadas en el siguiente enlace:
https://www.thingiverse.com/thing:3618964
Solo hay que imprimir y colocarlo.

GioSunrider, 2019-05-09:
Se ha dejado en Spicy imprimiendo el Ducto, quedarian pendientes las otras dos piezas.

CeciliaVa, 2019-07-03:
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
:sparkles: Ahora la correa ha quedado bien puesta y el ventilador de capa perfectamente instalado. :sparkles:

Closed 2019-07-04.

Thread 126 (2019-02-03):

Videos para la formacion de operadores

GioSunrider, 2019-02-03:
Proveniente de [asrob-uc3m/operadores/#22](https://github.com/asrob-uc3m/operadores/issues/22) os propongo que una reunion la dediquemos a la realizacion de estos videos.
Podemos salir varios y documentar el video todo el proceso de impresion.
¿Alguno que quiera echarme una mano?

GioSunrider, 2019-02-07:
Para la creacion de los videos se va a realizar una [milestone](https://github.com/asrob-uc3m/impresoras-asrob/milestone/3), en la que cada issue se vera reflejado una idea y un guion pequeño de dicho video.
El proceso que propongo para la realizacion de estos videos es el siguiente:

- [ ] Especificar el canal de difusion

- [ ] Lista y proposicion de videos

- [ ] Duracion de los videos

- [ ] Contenido y Guion de los videos

- [ ] Colocar en la web

- [ ] Difusion y distribucion del contenido

GioSunrider, 2019-02-07:
La propuesta de videos es la siguiente:

- Github y repo de perfiles

- Presentando a la Granja

- Imprimiendo mi primera pieza

- Calibracion

- Cambio de filamento

- Pantalla

- Slicer

- Juntando el perfil

- Postimpresion

- Principales Errores

- (Extra) Octoprint

GioSunrider, 2019-02-07:
La propuiesta es la realizacion de videos cortos, claros y concisos. Y el canal de difusion seria una Lista de Reproduccion en el [Canal de Youtube de la Asociacion](https://www.youtube.com/user/asrobuc3m/videos).

Closed 2023-09-28.

Thread 127 (2019-02-07):

Video 1. Presentacion de la granja

GioSunrider, 2019-02-07:
En esta issue reflejaremos el guion y la produccion del video de presentacion de la granja, asi como el material audiovisual del mismo.

GioSunrider, 2019-02-07:
Imagenes de las impresoras para utilizar.

https://drive.google.com/file/d/1Esr2Bw1mX4VhRgQrtKhgr3Jn0qyi5ILj/view?usp=sharing

L4g0, 2019-02-07:
## Guión

¡Hola! Bienvenidos al curso de manejo e impresión 3D de asrob uc3m.

Para empezar os vamos a presentar a nuestras máquinas.

Del proyecto Clone Wars han nacido **Hija Resurrection**, **Blacky** y **Dédalo**

La primera es una prusa i3 steel (más info [en la descripición](http://wiki.asrob.uc3m.es/index.php/RepRap:_HIJA)). Actualmente se encuentra con un nozzle de cosas

La segunda se trata de una Prusa Air 3 (más info [en la descripición](http://wiki.asrob.uc3m.es/index.php/RepRap:_BLACKY))

**Dédalo** se trata de una Prusa i2. Esta es la única de nuestras impresoras que utiliza filamento de 3 mm (más info [en la descripición](https://www.reprap.org/wiki/File:Clon-28-Dedalo.jpg))

**Geonosis** es la última de nuestras adquisiciones. Es un modelo TronXY X5S y es la única impresora CoreXY que tenemos por el momento.

**Spicy** (caldito para los amigos) es el conocido modelo Anet A8, adquirida a través de una donación.

Closed 2023-09-28.

Thread 128 (2019-02-07):

Vídeo 2. Github

L4g0, 2019-02-07:
## Guión

### Github
Hola, en este vídeo vamos a explicar cómo funciona la administración de nuestras impresoras. En asrob utilizamos el sistema de issues de **Github** como forma de organización.

### Reserva
El uso de las impresoras es libre y gratuito, solamente se requiere ser **operador de impresión** y traer tu propio filamento.

Para formarte como operador es necesario apuntarse creando una issue en [el repo de operadores](https://github.com/asrob-uc3m/operadores/issues) y bajo la supervisión algún compañero operador, imprimir correctamente 3 piezas. Una vez eres operador eres libre de imprimir (con reserva previa) y de formar a otras personas.

Se puede consultar el estado de las impresoras y reservarlas [aquí](http://wiki.asrob.uc3m.es/printers/).

### Repo Perfiles
En el repositorio de impresoras, que puedes encontrar [en la descripción del vídeo](https://github.com/asrob-uc3m/impresoras-asrob) se encuentran los perfiles de impresión personalizados y las incidencias o mejoras disponibles para cada impresora.

Consulta nuestros otros vídeos para aprender cómo configurar las impresoras.

Un saludo y nos vemos en el próximo vídeo.

Closed 2023-09-28.

Thread 129 (2019-02-07):

Soporte para pantalla LCD de Dédalo

CinnabarCinnamon, 2019-02-07:
Se necesita fijar la pantalla de Dédalo de modo que no esté colgada de los cables de la impresora.
La principal idea es imprimir y emplear el mismo modelo de pieza que las que sujetan la placa electrónica.

CinnabarCinnamon, 2019-02-14:
Encontrada pieza para soporte:
[smart_controller_2004_mount.zip](https://github.com/asrob-uc3m/impresoras-asrob/files/2866000/smart_controller_2004_mount.zip)

CinnabarCinnamon, 2019-02-14:
Se ha impreso el soporte y se ha atornillado a la placa. Falta por determinar cómo fijaremos a placa a la impresora.

CinnabarCinnamon, 2019-02-14:
Soporte y pantalla fijados a la impresora.
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

Closed 2019-02-14.

Thread 130 (2019-02-07):

Vídeo 4. Principales errores

L4g0, 2019-02-07:
## Guión

En este vídeo veremos los problemas más típicos con los que nos podemos encontrar durante la impresión.

### Thermal Runaway
El primero, y el más importante que nos puede aparecer se llama **THERMAL RUNAWAY**. Este error se muestra por la pantalla LCD de la impresora y detiene por completo el funcionamiento de la misma.

Este error aparece cuando durante la impresión hay una caída de temperatura, tanto en la cama como en el extrusor, de 5ºC.

Para subsanar este error es necesario un reinicio completo de la impresora. También será necesario revisar la colocación del ventilador de capa en caso de que el error sea debido al extrusor. Para saber si está bien colocado nos fijaremos si está apuntando al bloque caliente o a la punta del nozzle. En el primer caso, bajaremos un poco la distancia del ventilador y en el segundo revisaremos nuestro perfil de impresión. En el perfil de impresión revisaremos la potencia del ventilador de capa: en caso de estar por encima del 100% lo bajaremos hasta dicho valor.

### Atasco
Si la impresora deja de extruir plástico a mitad de impresión, lo más probable es que haya habido un atasco. Si esto ocurre, pondremos una incidencia en el repositorio de Github (ver vídeo de Github).

### Falta de adhesión en la primera capa caliente
Si observamos que en la primera capa el filamento no se pega a la cama, realizaremos los siguientes pasos:

- Si vemos que el nozzle está muy separado de la cama caliente en su posición de reposo, calibraremos la cama (recomendamos ver el vídeo de calibración).

- En caso de estar bien calibrada, probaremos subiendo la temperatura de la cama y sobre todo **no olvidarnos de echar LACA.**

### Desplazamiento de capas
Si durante la impresión percibimos un desplazamiento en alguno de los ejes, reduciremos la velocidad que tenemos ajustada en el perfil de impresión. En caso de que el desplazamiento persista, revisaremos tanto las correas (vídeo calibración) como la electrónica. En caso de haber revisado todo y no encontrar el error, se debe poner una incidencia en las Issues (ver vídeo Github).

Estos son los principales problemas que nos solemos encontrar. Puedes encontrar otros problemas comunes en el [link de la descripción](https://www.leon-3d.es/guia-de-resolucion-de-problemas/).

Gracias por vernos y nos vemos en el próximo vídeo.

Closed 2023-09-28.

Thread 131 (2019-02-07):

Video 3. Calibración y Cambio de Filamento

MrTommyGuns, 2019-02-07:
## Guión
### Calibración
Hola, en este vídeo vamos a explicar la calibración básica de nuestras impresoras.

### Qué tenemos que Calibrar

- Cama caliente.
- Tensión de las correas.

### Calibración de la Cama Caliente

Esta es una calibración básica, fundamental para conseguir una buena impresión.
Esto determinará la calidad de impresión de la primera capa, por lo que un mal ajuste nos podría llevar a que se nos despegara la pieza de la cama y la impresión se viera interrumpida.

Para proceder al ajuste, necesitaremos encender la impresora y hacer un "auto-home", después deberemos evaluar la altura del "nozzel"; este debe de quedar a una altura que ligeramente por encima de la cama. Si consideramos que está muy por encima o muy por debajo, deberemos ajustar la altura con el final de de carrera del eje Z (deberemos ir haciendo auto-home para comprobar el ajuste). Una vez realizado esto, procederemos a ajustar la cama con las palometas de las esquinas.
Una vez más, el primer paso será hacer auto-home y desactivar los motores.
El siguiente paso consiste en introducir un folio entre el nozzel y la cama, e iremos deslizando el carro de nuestra impresora por las esquinas; tendremos que ir apretando o aflojando las palometas, de tal forma que al mover el carro podemos notar un ligero roce en el folio. Debemos intentar que situando el carro en las distintas esquinas, el rozamiento entre el nozzel y la cama sea similar.

_**Observaciones:** TronXY además de tener las 4 palometas de las esquinas, tiene 2 más. Para ajustar esta impresora deberemos aflojar estas 2 palometas extra y realizar la calibración de la cama como es habitual. Una vez realizado, deberemos volver a apretar estas palometas hasta que estas estén ejerciendo fuerza._

### Calibración de las Correas

Lo primero que deberemos revisar es las tensión de las correas. Para ello bastará con ver que las correas están lo suficientemente tensadas. De no ser así podríamos tener problemas de impresión.

Para proceder al ajuste, deberemos tensar las correas que veamos que no están suficientemente tensadas (o destensar las que están demasiado tensas) usando los tensores en el caso de que los tengan.

!Ojo! No todas las impresoras tienen tensores y esto puede variar a medida que las vayamos mejorando.

En el caso de que no los tengan se deberá informar y no intentar solucionarlo.

### Cambio de Filamento

El primer paso será precalentar el hotend.

Deberemos tener cuidado mientras manejamos el filamento teniendo en todo momento sujeto el extremo, asegurándonos que no se nos enrede y deberemos colocarlo en el soporte.

Una vez caliente el hotend, procederemos a introducir el filamento de la forma que corresponda para cada impresora (Ver imágenes del vídeo).

Una vez terminada la impresión, deberemos retirar el filamento, para ello deberemos asegurarnos que el hotend sigue caliente. En el caso de impresoras como Spicy, deberemos pulsar el botón, extruir un poco de filamento apretando con la mano y estirar del filamento para extraerlo.

**_En caso que se nos atasque el filamento, deberemos cortarlo (dejando un poco de margen) y advertir mediante una issue del problema._**

Un saludo y nos vemos en el próximo vídeo.

Closed 2023-09-28.

Thread 132 (2019-02-14):

Video 5. Partes de una Impresora

MrTommyGuns, 2019-02-14:
## Guión
###
Hola, en este vídeo vamos a explicar las partes de nuestra impresora.

### Partes Principales
* Cama caliente.
* Extrusor.
* Placa Controladora.
* Pantalla.
* EndStop.
### Cama Caliente

Es la superficie de impresión de nuestra impresora. Todas las impresoras de la asociación tienen un cristal sobre ella, sobre la que hay que rociar con laca antes de imprimir. Otra parte importante son los tornillos de ajuste, los cuales sirven para nivelar la cama.

### Extrusor

Se compone de 3 partes principalmente:

- _Barrel._ Pieza por donde se introduce el filamento en primera instancia.
- _Bloque._ Pieza que se calienta hasta conseguir la temperatura adecuada para fundir el material.
- _Nozzel._ Pieza que consta de un agujero que puede tener diferentes dimensiones por la cual se extruye el filamento.

### Placa Controladora

Esta es la placa encargada de controlar la impresora. En algunos casos (como en el caso de la Anet, _Spicy_), conectaremos a ella la tarjeta microSD con los diseños que queremos imprimir a ella.

### Pantalla

Ademas de visualizar las opciones, tenemos los botones y los controles para manejar la impresora de forma directa (sin tener que conectar a ella un PC).

### EndStop

Son unos pequeños interruptores que tenemos al final de los ejes que sirven para que la impresora se oriente y sepa donde se encuentra cuando hacemos un _Set Home_.

Un saludo y nos vemos en el próximo vídeo.

Closed 2023-09-28.

Thread 133 (2019-02-14):

Video 6. PostImpresión

MrTommyGuns, 2019-02-14:
## Guión
### PostImpresión
Hola, en este vídeo vamos a explicar que hacer al terminar de imprimir una pieza.

### Qué tenemos que realizar

* Despegar la pieza.
* Retirar el filamento.
* Apagar la impresora.

### Despegar la pieza

Una vez terminada la pieza, deberemos de proceder a despegarla. Para ello tenemos varias opciones. La primera de ellas y más simple será tirar de ella y con un poco de suerte se despegará sin problemas. Otra opción es tratar de pasar la espátula entre la cama y la pieza. Si ninguna de las opciones anteriores han surgido efecto, lo mejor será esperar a que la cama se enfrie y de esa forma conseguiremos sacarlas sin problema.

### Retirar filamento.

Tras terminar de imprimir deberemos retirar el filamento. Para más detalles ver el vídeo de _Calibración y Cambio de Filamento_.

### Apagar la impresora

Antes de irnos, tras terminar de imprimir y una vez retirado el filamento, tenemos que apagar la impresora.

Un saludo y nos vemos en el próximo vídeo.

Closed 2023-09-28.

Thread 134 (2019-02-14):

Video 7.  Imprimiendo mi primera pieza

MrTommyGuns, 2019-02-14:
## Guión
### Imprimiendo mi primera pieza
Hola, en este vídeo vamos a realizar una impresión para mostraros los pasos uno a uno.

### Pasos previos antes de imprimir
* Tener la impresora calibrada
* Generar el gcode de la pieza que vamos a imprimir
* Introducir la MicroSD

### Procedemos a imprimir

Lo primero que deberemos realizar es un _AutoHome_, acto seguido deberemos precalentar el extrusor (y podemos precalentar la cama ya de paso) e introducimos el filamento _(ver el vídeo de Calibración y Cambio de Filamento)_.

Lo siguiente que tenemos que rociar la cama con una ligera capa de laca.

Acto seguido, podemos poceder a seleccionar nuestra pieza y ponerla a imprimir.

¡Ahora solo nos queda esperar a que acabe!

Un saludo y nos vemos en el próximo vídeo.

Closed 2023-09-28.

Thread 135 (2019-02-14):

Charla Impresoras 3D en Jornadas Técnicas del GUL

JorFru, 2019-02-14:
Hola, abro issue para pedir préstamo.

Me he presentado para dar una charla en las JT del GUL https://cursos.gul.es/xxxiii-jornadas-tecnicas-del-gul

Me gustaría llevar a la charla a Dédalo, para que los asistentes vean las abominaciones mecánicas que se construían con pocos recursos, a fin de calmar el SAV.
El objetivo es llevarla para enseñar, quizás ponerla a imprimir pero sería raro.

Más datos: jueves 18 febrero, de 16 a 18h, 1.1.G04.
Si alguien se anima a ayudarme con la charla, invitado está.

GioSunrider, 2019-02-14:
Ahora mismo dedalo no puede imprimir a falta de terminar su cable managment. Por el prestamos sin problema, yo mismo puedo echarte un cable con la charla si lo necesitas.

JorFru, 2019-02-14:
Okey, gracias por la info y el ofrecimiento.
Continuamos la colaboración por chat privado.
Si alguien más se anima que se manifieste

David-Estevez, 2019-02-15:
>  las abominaciones mecánicas que se construían con pocos recursos, a fin de calmar el SAV.

:unamused:

GioSunrider, 2019-02-26:
Dejo aqui la foto del evento con dedalo habiendo acabado de imprimir y @JorFru exponiendo de fondo.

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

JorFru, 2019-05-08:
Aquí dejo la documentación generada
https://github.com/JorFru/Charlas/tree/master/JornadasT%C3%A9cnicasGUL/XXXIII

Desde aquí otra vez agradecer a Coleóptero, Obijuan y todo Clone Wars.
Sobre todo por la cantidad de diapositivas que dejaron de sus charlas anteriores y he podido reutilizar.

Closed 2019-05-08.

Thread 136 (2019-02-15):

Tensor Eje X Blacky

GioSunrider, 2019-02-15:
Se ha impreso un tensor para el eje X para blacky, identico al que leva hija. En la proxima reunion se colocara.

GioSunrider, 2019-02-21:
Se ha colocado el tensor en blacky.

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

Closed 2019-02-21.

Thread 137 (2019-02-21):

Mejoras Spicy

MrTommyGuns, 2019-02-21:
Abro esta issue para ir documentando y mejorando a Spicy.

Propongo esta página para ir mirando las mejoras: https://www.staticboards.es/blog/mejoras-anet-a8/

- [ ] Botón para encendido. _(@JorFru approves)_

- [ ] Mejora estructura eje X.

- [x] Tensor eje X. _(Issue #123 )_

- [x] Final de carrera Z.

- [ ] Aros para muelles cama caliente.

- [ ] Reforzar interior delantero.

- [ ] Reforzar interior trasero.

- [ ] Soldar cables directamente a la cama. _(@JorFru approves)_

- [x] Cambiar soporte ventilador carro https://github.com/asrob-uc3m/impresoras-asrob/issues/153

- [ ] Cambiar el conjunto caliente por un V6

GioSunrider, 2019-11-15:
En la reunion de ayer se imprimi e instalo la mejora del final de carrera del Eje Z.

MrTommyGuns, 2019-12-06:
Si no recuerdo mal, en la reunión de ayer @JorFru y yo comentamos la posibilidad de ponerle un extrusor nuevo a Spicy y chetarla un poquete ya que tenemos extrusores para cambiar en el armario.

Esto podría ser una mejora bastante guay para Spicy.

GioSunrider, 2019-12-07:
A mí modo de ver prefiero que el extrusor bondtech del armario vaya para blacky o geonosis, y me decanto más por geonosis, ya que el motor sufre mucho y ponerle la reductoras ayudara a este problema

Closed 2023-09-28.

Thread 138 (2019-02-26):

Rodamientos Lineales

GioSunrider, 2019-02-26:
Dado que los igus comprados en #52 seguramente acaben en hija, y el otro dia al colocar el tensor de Blacky #136 observe que el estado de algunos de ellos es mas que cuestionable. Propongo hacer una prueba, esta consiste en imprimir nosotros en PETG los igus. He hablado con algun amigo y me ha dicho que el los estuvo usando sin problema.

Closed 2023-09-28.

Thread 139 (2019-03-01):

Nos donan una Cube Pro

JorFru, 2019-03-01:
Hola
Pues eso, que nos regalan una impresora casta.

Un profesor de bioingeniería nos la regala porque se han comprado una MK3 y les funciona mejor.
Nos sugiere que le hagamos una conversión al lado del bien (open source).

Le he sugerido quedar el 4 o 5 de marzo de 2019, para ir a verla y traerla si nos mola. Voy yo. Si alguien quiere acompañarme, quedamos. Cuando me conteste pongo fecha y hora.

Hay que empezar a pensar un nombre para ella jijijiji

GioSunrider, 2019-03-02:
Ueeee palantisimo, tenemos además material de sobra para dedicarle.

JorFru, 2019-03-05:
Lista de modificaciones (por orden de urgenicia)

- [ ] Trucar el tema cartuchos de filamento. (cuesta 100€ cada 900€ de filamento oficial)

- [ ] Instalar electrónica libre. (Da mucho morbo y es necesario para trastear)

- [ ] Instalar sistema multifilamento (multicolor y/o multimaterial).

Por parte del antiguo dueño estamos completamente autorizados a todo esto.

MrTommyGuns, 2019-10-10:
Esto deberíamos seguirlo en #142 (?)

GioSunrider, 2019-10-20:
Afirmativo, continuamos en #142

Closed 2019-10-20.

Thread 140 (2019-03-21):

PROPUESTA: Donación Plotter_LSM

Lucas-LSM, 2019-03-21:
Hola gente de ASROB:

Tengo un plotter freehardsoftware, (CNC arduino) para donar. Os dejo link de youtube de cómo es:

https://www.youtube.com/watch?v=-GkaaUIY3kc

Es una copia del plotter de 4xiDraw

Qué decís?

GioSunrider, 2019-03-21:
No se como andamos de espacio, pero por mi adelante, cuanto mas mejor xD

JorFru, 2019-04-03:
Actualizo con que tenemos muy poco espacio disponible.
Necesitaríamos upgradear a una segunda estantería.
De hecho la CNC de @DiegoGarciaX2 la tenemos ahora mismo en un emplazamiento poco adecuado, y también habría que buscarla hueco.

¿Qué os parece mover las cajas de filamento de la balda baja de la estantería a la balda última?
Así dejaríamos la CNC de Diego abajo, y tendríamos hueco para el plotter de Lucas.
Las cajas cerradas no cogen polvo, y las nuevas máquinas también quedarán protegidas del polvo.

MrTommyGuns, 2019-04-03:
Me parece una buena solución lo de pasar las de filamento arriba y aprovechar la balda baja, al menos por el momento.
Si podemos en el futuro tener 2 estanterias o algo del estilo ya se verá como organizarlo mejor.

JorFru, 2019-04-03:
Calculo que, de conseguir estantería por la vía habitual, llegaría mínimo en marzo del 2020.

GioSunrider, 2019-04-04:
Por mí sin problema también.

Lucas-LSM, 2019-04-04:
Pues cuando lo tengais y me digais la acerco

Obtener Outlook para Android<https://aka.ms/ghei36>

________________________________
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

JorFru, 2019-05-08:
Todavía estamos organizando el espacio y no tenemos mucho disponible. Próximamente te avisamos.
Gracias Lucas.

Closed 2023-09-28.

Thread 141 (2019-05-08):

Soporte de filamento para Spicy

MrTommyGuns, 2019-05-08:
Hace unos meses el soporte para filamento de Spicy murió.
El tema está en que tenemos varias impresoras que imprimen correctamente y nos faltan soportes si las queremos poner a imprimir todas.
Sugiero la siguiente pieza para hacerle un soporte:

https://www.thingiverse.com/thing:2162266

Por el momento la he impreso para mi anet y parece que funciona correctamente.

MrTommyGuns, 2019-05-08:
Si lo hacemos, sugiero ponerle una capa de pegamento caliente fina como antideslizante y la estabilidad mejora una barbaridad

GioSunrider, 2019-05-09:
Buena idea, se esta imprimiendo en Hija ahora mismo.

MrTommyGuns, 2019-05-09:
En la tarjeta de hija está el gcode del soporte y los conos están en la de Spicy, por si queréis reutilizarlos...
A los conos les faltaba poner algo más de relleno

GioSunrider, 2019-05-09:
he borrado la tarjeta entera... eso no se deja ahi...

GioSunrider, 2019-05-09:
Se han impreso las dos piezas, una vez se coloquen se subira la foto y quedara por cerrada la issue.

JorFru, 2019-05-09:
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

JorFru, 2019-05-09:
Mejoras de pegamento caliente por @MrTommyGuns

Closed 2019-05-09.

Thread 142 (2019-05-17):

Misión: Descastarización

MrTommyGuns, 2019-05-17:
Actualizacion 2023

Link previos de alguien que cambio la electronica:
https://dyzedesign.com/2018/09/cube-pro-total-conversion-step-by-step-guide/
https://dyzedesign.com/2018/10/our-cube-pro-total-conversion-part-2/
https://dyzedesign.com/2018/11/our-cube-pro-total-conversion-part-3/

Pasos a seguir:

- [x] Desmontar el "suelo".

- [x] Sacar la placa controladora.

- [x] Desenchufar todos los cables y mirar la potencia de la fuente (24V).

- [x] Investigar la electrónica, cables y clasificar mediante etiquetas.

- [ ] Instalar electrónica 12V

- [ ] Instalar fuente 12V

- [ ] Instalar SSR para el hotend

- [ ] Revisar si los ventiladores son de 12 o 24V y conectarlos o reemplazarlos.

Hasta ahora la idea es mantener el idler, motor, hotend y nozzle originales. Ya que cambiar cualquiera de estas piezas requeriría diseñar un carro nuevo. Tenemos otro hotend original de repuesto, en caso de que sea necesario.

Resumen de asuntos de voltaje:
- El hotend original va a 24V. Más o menos unos 3A. No queremos cambiar el hotend porque requiere rediseño del carro.
- Los motores van a lo que le eches, 24V tienen más par a altas velocidades que a 12V. Pero mismo par a bajas valocidades. Nos quedamos con motores a 12V.
- Cabina calefactada: el calefactor que dispone la máquina es a 230V y ya incluye relé, no necesita SSR (relé de estado sólido) ya que la inercia térmica de la cabina es grande.
- Cama caliente no tenemos por ahora. No es dificil de instalar, pero es una modificación que no urge.

Conclusión asuntos de voltaje:
Podemos instalar electrónica a 12V (la cual disponemos en el armario), y usar el hotend a 24V usando un relé de estado sólido. [Aquí](https://github.com/asrob-uc3m/impresoras-asrob/issues/20#issuecomment-294284368) se puede leer por qué no se puede usar un relé normal.
Necesitaríamos dos fuentes de alimentación. La de 24V original, y una segunda a 12V como tradicionalmente hacemos reviviendo fuentes de ordenadores antiguos. Sin embargo una fuente ATX de ordenador no cabría en la zona originalmente designada a la electrónica, por lo que sugiero pillar una fuente de 12V estilo [Mean-Well](https://es.aliexpress.com/item/33031624276.html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,searchweb201602_7,searchweb201603_53) con un pequeño tamaño, ya que no requerimos más de 50W. Tenemos en el armario.

Ejemplo de [descastización](https://dyzedesign.com/2018/09/cube-pro-total-conversion-step-by-step-guide/) llevada a cabo por otros pavos.

JorFru, 2019-05-17:
Yo fui quien cortó los tres cables del termómetro.
Si alguien me quiere culpar, disponible estoy.

Es que está muy mal diseñado macho, tiene cables que llegan por un tubo y que la mayoría de esos cables van a un conector pero algúno otro va a otro conector de otra parte de la placa. Y se meten destrangis por sitios raros.

El asunto es que lo corté porque seguramente no vayamos a usar esa sonda de temperatura por el momento, el cable estaba dando mucho por culo para el desmontaje. Y cuando lo usemos ya tendremos tiempo de conectorizar ese cable o tomar decisiones. Además primero debemos de caracterizar el sensor y ver si está en Marlin.

GioSunrider, 2019-10-20:
Seguido de #139
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

MrTommyGuns, 2019-12-06:
Ayer se abordó el tema otra vez con muchas ganas hasta que vimos que necesitamos electronica a 24V que no tenemos (la que tenemos funciona a 12V).

Una de las opciones propuestas es adquirir una electrónica de Ender 3, que funciona a 24V.

JorFru, 2019-12-08:
https://dyzedesign.com/2018/09/cube-pro-total-conversion-step-by-step-guide/
Documentación del proceso de descastización por parte de otra gente que ha hecho lo mismo con la bicha.

MrTommyGuns, 2019-12-08:
Muy buena documentación!

Eso sí, la lista de materiales se va un poco de precio jajaja

GioSunrider, 2019-12-08:
Se podria meter como subveccion, denmocratizarla asi que no veo problema en el precio.

Thread 143 (2019-05-22):

Conos para filamento

MrTommyGuns, 2019-05-22:
Creo muy conveniente que imprimamos una serie de conos, tubos o lo que sea para centrar los filamentos en los soportes.

En mi opinion son más útiles los conos porque se adapta a los tropecientos tipos de bobinas que tenemos, pero es más engorroso colocarlos si no se plantea el mecanismo adecuadamente.

Ejemplo: [https://www.thingiverse.com/thing:767317](url)

fervh, 2019-10-24:
[cono.zip](https://github.com/asrob-uc3m/impresoras-asrob/files/3768816/cono.zip)

MrTommyGuns, 2019-11-26:
Finalmente se realizó la impresión de 2 de estos [conos](https://www.thingiverse.com/thing:767317)
(Adjuntaré foto cuando sea posible)
Creo que al menos deberíamos hacer un par más.

Thread 144 (2019-05-22):

Creación de Perfiles de Impresión

MrTommyGuns, 2019-05-22:
Creo que deberíamos tener una serie de perfiles básicos creados para cada impresora, para que cada persona que quiera utilizar las impresoras no se tenga que liar a hacer un perfil que muy probablemente de errores.

Los que hay subidos creo que están muy desactualizados ya que las maquinas han cambiado bastante en algunos casos.

Por lo que he visto la mayor parte de la gente que usa las impresoras usa Cura, pero por otro lado nunca está demás tener perfiles de diferentes slicers.

Propongo que a medida que se van utilizando las impresoras, si el resultado de impresión ha sido aceptable, se suba el perfil usado para partir de una base utilizable que podamos usar habitualmente y fijándonos en los detalles ir puliendo el perfil. Tal vez incluso si usaramos todos el mismo perfil podríamos aportar mejoras consiguiendo un punto de impresión óptimo, pero siempre hay detalles que gustan a unos más que otros así que siempre se pueden retocar a gusto del consumidor.

Resumiendo, tener unos buenos perfiles de base sería muy necesario en mi opinión.

GioSunrider, 2019-05-22:
Me parece muy buena idea, así podemos ir perfilando distintos tipos de slicers y los vamos puliendo.

MrTommyGuns, 2019-12-06:
Actualmente, tenemos los perfiles de Hija, Spicy y Blacky, que imprimen bastante bien partiendo del mismo perfil aunque molaria personalizarlos para cada una, mejorandolo para las prestaciones de cada una.

Por otro lado, se ha creado un perfil de impresión que fue un buen punto de inicio para Dedalo por parte de @DiegoGarciaX2 y otro para la nueva impresora por parte de @MarioPrinter.

Todos ellos han sido creados para Cura y se irán subiendo a la carpeta correspondiente para cada una.

DiegoGarciaX2, 2019-12-07:
Donde subo el perfil?

DiegoGarciaX2, 2019-12-07:
el la carpeta de dedalo?

GioSunrider, 2019-12-08:
Sigue la estructura de las carpetas y subirlo cada uno donde corresponde. Y a ser posible mencionar el commit en la issue para tenerlo referenciado.

Closed 2023-09-28.

Thread 145 (2019-06-04):

Electrónica de Geonosis

JorFru, 2019-06-04:
Abro issue nueva para hablar de la placa nueva. La conversación anterior está en #95
Después de la vuelta a la electrónica original de Geonosis, me encuentro con que no funciona, la semana pasada sí funcionaba bien.

¿Qué fue lo último que se hizo?
¿Se han hecho pruebas de impresión después de atornillar la placa?
P.D.: issue de cable managing pronto

MrTommyGuns, 2019-06-04:
Lo último que se hicieron fueron pruebas de impresión...
Mientras se hacía una de ellas estabamos montando el ventilador y se paró porque presuntamente le di al botón se reset y no volvimos a ponerla a imprimir porque era tarde y así poder realizar el montaje más cómodamente...
El otro día yo intenté usarla y la pantalla no funcionaba...
Se lo comenté a Gio y me dijo que estaba dando problemas pero que sí que iba.
Eso es toda la info que tengo

JorFru, 2019-06-04:
a mí tampoco me ha funcionado

Añado estatus:
Pantalla en blanco (bueno, azul)
Por USB reconoce el CH340 pero no el puerto serie.

Pasos que sugiero:
Desmontar la placa de todos los tornillos y probarla al aire. Parece que algo ha salido mal en el montaje.
Puede ser que se esté reiniciando todo el rato? No sé.

GioSunrider, 2019-06-05:
Primera labor para hacer mañana!

JorFru, 2019-07-02:
La pasada semana le eché un vistazo y tiene mucha pinta de electrónica frita.
Ahora que tenemos RAMPS y MEGAs, podríamos hacer un cambio de la electrónica de Geonosis.

GioSunrider, 2019-07-19:
Ayer @MrTommyGuns y yo, recableamos la impresora, y se instalo una OVM 20 Lite. Se ha subido el Marlin en a37f707. Queda pendiente hacer Octoprint ya que no tenemos adaptador de pantalla y la hemos perdido, ademas de la impresion por SD.

Closed 2019-07-19.

Thread 146 (2019-06-05):

Actualizar finales de carrera virtuales en Marlin

MrTommyGuns, 2019-06-05:
No sé como se llamará esto, pero resulta que Hija y Blacky (si no recuerdo mal), tienen un error de "bloqueo" en la cama por lo que sea, provocando que cuando se va a imprimir no se pueda usar todo el espacio de la cama.

JorFru, 2019-06-05:
Hija y Blacky tienen una cama más grande de la configurada en Marlin
Por eso "sienten" una limitación del movimiento de la cama que trunca las piezas antes de llegar al borde de la cama.
También hay que comprobar el X e Y offset a la hora de slicear.
Normalmente Cura trae un par de centímetros muertos en X e Y. Esta es la distancia entre el punto de homing y el principio de la cama. No en todas las impresoras es el mismo.
No sé si este parámetro también está en Marlin. De ser así se juntan los dos y termina imprimiendo en la esquina posterior derecha.

JorFru, 2019-06-05:
Hija y Blacky tienen una cama más grande de la configurada en Marlin
Por eso "sienten" una limitación del movimiento de la cama que trunca las piezas antes de llegar al borde de la cama.
También hay que comprobar el X e Y offset a la hora de slicear.
Normalmente Cura trae un par de centímetros muertos en X e Y. Esta es la distancia entre el punto de homing y el principio de la cama. No en todas las impresoras es el mismo.
No sé si este parámetro también está en Marlin. De ser así se juntan los dos y termina imprimiendo en la esquina posterior derecha.

MrTommyGuns, 2019-12-06:
Actualmente hemos realizado pruebas de impresión y las impresoras imprimen con buena calidad. No se han observado estos fallos por lo que cierro la issue hasta que vuelvan a observarse.

Closed 2019-12-06.

Thread 147 (2019-09-03):

Cambio de Llaves

GioSunrider, 2019-09-03:
Solicito a @Siotma que un dia se acerque y haga un cambio de llaves a @MrTommyGuns ya que va a ser el segundo responsable del grupo.

Siotma, 2019-09-14:
Las llaves se entregaron el día 11 de septiembre, tal y como consta en https://github.com/asrob-uc3m/actas/issues/201

Queda pendiente actualizar la web para que conste el nuevo propietario de las llaves.

El seguimiento de las acciones pendientes se continuará en el repo de actas, que es donde debe hacerse.

Closed 2019-09-14.

Thread 148 (2019-09-11):

Colaboración con asociación TesLab Electric

Lucas-LSM, 2019-09-11:
Hola, hace poco que se ha creado esta asociación por parte de la carrera de eléctrica. Vamos a hacer una actividad dentro de dos semanas el miércoles 25 de septiembre en el MakerSpace de 13 a 15 horas, que va de reparar pantallas de móvil.
Queríamos preguntaros si nos podéis echar una mano con la difusión, e incluso si queréis colaborar o aportar a este tipo de actividades.

Saludos!

JorFru, 2019-09-11:
Estoy yo al frente de las Redes Sociales y creo que sí sería posible.
Lo consultaremos hoy en la reunión.

Tiene buena pinta.

Thread 149 (2019-10-13):

Fallo extrusor Hija

MrTommyGuns, 2019-10-13:
La racha de funcionamiento de impresoras a finalizado y ya tenemos a hija sin funcionar correctamente.
En la feria de asociaciones se sacó e imprimió alguna pieza pero más tarde falló y en la ultima reunión no se pudo imprimir nada debido a un fallo en el calentamiento del hotend.

MrTommyGuns, 2019-10-17:
Se ha detectado que se ha partido una patilla de un transistor de la placa de control.

Se va a aprovechar para cambiar dicha placa, realizando el cable management.

MrTommyGuns, 2019-10-17:
Seguiremos en #151 con la misión. Habiendo encontrado el error, cierro la issue. :)

Closed 2019-10-28.

Thread 150 (2019-10-13):

Uso de filamento por los operadores

MrTommyGuns, 2019-10-13:
Deberíamos resolver cuanto antes el problema/dilema de la cantidad de plástico de la asociación usado por los operadores.

La mejor opción yo diría que es poner limites en los gramos de las impresiones, de tal modo que si se utiliza este plástico no sea de forma abusiva para un uso personal.

A parte de eso habría que poner un límite en el cual se dejará de poder imprimir con el plástico de forma personal (punto para dar una palmadita en el hombro y decirle al susodicho que se gaste 10€ y compre una bobina xD).

GioSunrider, 2019-10-13:
Esto creo que iría mejor en actas. Y de hecho creo que ya hay issue, aunque esté cerrada.

jgvictores, 2019-10-14:
> Esto creo que iría mejor en actas. Y de hecho creo que ya hay issue, aunque esté cerrada.

Síp, era la intención de https://github.com/asrob-uc3m/actas/issues/61. Aunque se trate de lo mismo, me gusta más cómo se plantea el problema aquí. Si lo queréis mover, ahí está el botón de `Transfer issue`. :smiley:

MrTommyGuns, 2019-11-26:
Teniendo en cuenta como se está llevando finalmente este asunto, creo que hemos dado con una buena dinámica.
A todos los nuevos operadores se les ha dicho que para imprimir lleven su propio filamento en el caso que sea para uso personal.
Si es para uso interno de la asociación, ya sean mejoras para las impresoras, proyectos de otras ramas... Se usará el filamento de la asociación.
Como siempre, puede que haya situaciones en las que se pueda usar el filamento de la asociación para uso personal, siempre que sea de manera puntual, haya algún punto de interés y/o se compense por otro lado (casos más concretos, que a mi parecer tampoco pasa nada).
Pero dejaría cerrado el asunto con esta propuesta si os parece bien.

GioSunrider, 2019-11-27:
A mi me parece lo correcto.

David-Estevez, 2019-11-27:
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

jgvictores, 2019-11-27:
Opino lo mismo. Parece buena idea, pero tb parece una cosa muy horizontal.

Mejor una PR sobre estatutos, y votar sobre el merge.

Como pequeño aporte: ¿Quizás alguna cláusula de pago comisión en fungible? No sé, si alguien va a pulirse 5-10 bobinas, pues tal vez tenga sentido que aporte 1 bobina a la Asociación por compensar desgaste o algo.

GioSunrider, 2019-11-28:
Creo que actualmente nadie trabaja a ese volumen, el grupo de primer es quizá el que más hasta y tenemos filamento que nos va a durar años

jgvictores, 2019-11-29:
Nos han llegado a pedir ciertos trabajos de elevado volumen y siempre se quedó en el aire debido al vacío en cuanto a estatutos.

GioSunrider, 2019-11-29:
Yo creo que ese tipo de trabajos deberian de aportar su propio plastico. Y se regirian por lo mismo motivo de los operadores de uso personal.

MrTommyGuns, 2019-11-29:
Estoy de acuerdo, deberían de llevar su material y/o darnos la pasta para pillar el material necesario para hacer lo que sea

jgvictores, 2019-11-29:
Lo que comentaba era respecto a un % adicional proporcional al utilizado, para compensar por el uso/desgaste/mantenimiento de las impresoras como tal.

GioSunrider, 2019-11-29:
Ahhh vale val, ya lo entinedo, y tambien me parece correcto. Ya que somos quienes las mantenemos y cuesta horas de trabajo tenerlas a punto.

Closed 2023-09-28.

Thread 151 (2019-10-17):

Cambio de Placa de Control de Hija

MrTommyGuns, 2019-10-17:
Como se comentó en #149 hija murió y vamos a cambiar la placa de control. Seguiremos documentando en esta issue.

GioSunrider, 2019-10-20:
Se va a aprovechar a hacer #79 ya que hay que revisar todo.

MrTommyGuns, 2019-11-26:
Finalmente se realizó el cambio de placa e hija queda finalmente funcional.
Se observó que los motores no estaban correctamente sujetos, lo cual provocaba que fallaran, se desmontaron y montaron, quedando funcionales, pero potencialmente pueden volver a fallar.
Queda pendiente imprimir una caja en condiciones para la placa.
Gracias a todos los que metieron mano para dejarla on point.

Closed 2019-11-26.

Thread 152 (2019-10-20):

Nueva incorporacion a la familia.

GioSunrider, 2019-10-20:
Tal y como se dijo en [actas](https://github.com/asrob-uc3m/actas/issues/197) y aunque no hay hueco todavia para su uso, tenemos una nueva incorporacion.
Los detalles de la impresora se encuentran en la otra issue pero hay que seguir unos pasos para "darle de alta" en nuestro sistema.
Los pasos son:

- [ ] Hoja de Reserva

- [ ] Ponerle nombre

- [ ] Colocarla en su sitio definitivo

[MORE]

- [ ] Instalacion con Rpi junto con Spicy para Octoprint.

A su vez empieza la gestion, empezar a proponer nombres para ella. Daremos un tiempo de margen y comenzara el resto.

GioSunrider, 2019-11-15:
En la reunion de ayer, realizamos una colocacion que parece ser la definiva para comenzar su uso hace falta colocar una rpi para añadirle octoprint.

MrTommyGuns, 2019-11-26:
En la ultima reunión se recolocaron algunas impresoras, incluida esta dotandola de un espacio aparentemente definitivo.

Se realizó una prueba de impresión y a pesar de que la primera capa fue un fracaso la pieza remontó con un resultado bastante bueno.

Closed 2023-09-28.

Thread 153 (2019-11-19):

Mejoras carro Spicy

JorFru, 2019-11-19:
Recomiendo añadir esta mejora a Spicy Caldito. https://www.thingiverse.com/thing:2326111
Yo tuve esta modificación en la mía y ayudaba mucho en caso de atasco, ya que puedes ver directamente el filamento pasar desde los engranajes del extrusor hasta que entra por el barrel.

Fácil de enebrar el filamento al cargarlo, fácil de desatascar. Y sobre todo que los nuevos pueden ver cómo es por dentro el asunto.
Respecto a la pregunta: ¿Hay que darle matarile al radiador?
La respuesta es: Sí, hay que cortarlo con una sierra. Es aluminio y se tardan tres segundos.
Este radiador es en un 80% inefectivo, y el ventilador un poco más de lo mismo.

Es una pieza muy fácil de imprimir y que aporta bastante creo yo. Y ya va preparando el camino a meterle un V6, que Spicy se lo merece.

MrTommyGuns, 2019-11-26:
Se realizó la impresión de la pieza y @fervh la instaló.
Tal vez sea preciso instalar unos tornillos más adecuados para que el ventilador se adapte apropiadamente.
Dejo la issue abierta para que @fervh la cierre si lo desea y pongamos alguna fotillo del resultado

luciagz02, 2019-11-28:
Ya se han instalado los tornillos adecuados y el ventilador encaja en su sitio.
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

Closed 2019-11-28.

Thread 154 (2019-11-21):

Impresora Ender PRO en usufructo

VentressAsajj, 2019-11-21:
Buenas, tengo una impresora Ender 3 PRO metida en la caja, recien comprada. Por problemas de sonido no la puedo montar en casa. He pensado que puedo dejarla en la asociación hasta que pueda llevármela a casa, cosa que no se cuándo ocurrirá. A cambio del espacio esa improsora está a disposición de la asociación.
El tema de filamento y compra de material en caso de avería deberíamos de dejarlo claro.
No se si hay algo reglado.

GioSunrider, 2019-11-21:
Guiate de ejemplo del prestamo que realizo @JorFru con Spicy, aqui esta la [issue](https://github.com/asrob-uc3m/impresoras-asrob/issues/82) en la que establecio los terminos.

Por el tema del filamento note preocupes, se establece como cualquier impresora. de la asocicacion, es decir como se discute en #150

VentressAsajj, 2019-11-23:
@GioSunrider estoy de acuerdo con los términos de la impresora de @JorFru Lo mismo para la mía.

MrTommyGuns, 2020-02-13:
Hay que dotar a la impresora de un nombre official.

Que empiece la lluvia de ideas!!

MrTommyGuns, 2020-02-13:
Hoy se ha realizado el montaje de la impresora y se han impreso algunas piezas con resultados más que satisfactorios

Closed 2023-09-28.

Thread 155 (2019-11-28):

Nombre para la nueva incorporacion

GioSunrider, 2019-11-28:
Como se establece en #152 tenemos que poner un nombre la nuestra pequeña, asi que que comiencen las propuestas.

David-Estevez, 2019-11-30:
Suegra

GioSunrider, 2019-12-07:
- Moeby Dick

- Moby Dick

MarioPrinter, 2019-12-07:
**NOMBRES PROPUESTOS:**
- Moeby Dick
- Moby Dick
- Suegra
- Flashy
- White
- Mr White
- Whity
- Little sister (y a la cube pro Big Daddy)
- Maincra

David-Estevez, 2019-12-07:
Blancanieves (o Snow White si os sentís internacionales)

Petikuis, 2019-12-12:
A mi me gusta la de Moeby Dick

GioSunrider, 2019-12-19:
Abierta votacion en https://forms.gle/h8whnzjjYJ5YPVbS8 os dejo una semanita.

JorFru, 2019-12-28:
¿Bueno cómo va esto?

GioSunrider, 2019-12-31:
Y cerramos el año con el nuevo nombre decidido. Moeby Dick ha sido el ganador. Procedere a los tramites para incorporarla en todos los lados.
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

Closed 2020-02-13.

Thread 156 (2019-11-28):

Ventilador Spicy Quemó

MrTommyGuns, 2019-11-28:
El ventilador de Spicy ha salido en llamas haciendo honor a su nombre (en realidad solo salio humo), más concretamente el cable que se ha fundido.

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

Necesitaremos un ventilador de repuesto.

MrTommyGuns, 2019-12-06:
He encontrado el ventilador que tenía mi aneto, el cual ya no me sirve porque cambie el sistema de extrusion.

Así que lo dono para arreglar a Spicy y solucionado jiji

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

Closed 2019-12-22.

Thread 157 (2019-12-06):

Hija no imprime en ABS

MrTommyGuns, 2019-12-06:
Cuando se intenta calentar a Hija con la suficiente temperatura da error en el extrusor.
Deberíamos mirar porqué puede ser... Tal vez sea cosa del marlin que esté capado a modo de seguridad para que no se caliente en exceso.

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

JorFru, 2019-12-07:
también habría que ponerle una funda de siicona "calcetín", ya que hija está equipada con un bloque caliente tipo E3D V6 y en el armario tenemos calcetines de sobra.
Pero lo que dice Tommy tiene toda la lógica.

Closed 2023-09-28.

Thread 158 (2020-02-13):

Movimiento X Geonosis

MrTommyGuns, 2020-02-13:
He estado poniendo a punto a Geonosis.

Para ello he estado ajustando los pasos/mm de la impresora y actualizando el marlin (cuando funcione todo correctamente lo subiré).

El problema reside en que el eje X se mueve en vertical y no tengo la más mínima idea de porqué puede ser, ya que el eje Y que funciona con el mismo mecanismo funciona a la perfección, pero he sido incapaz de configurar el eje X.

jgvictores, 2022-02-27:
Entiendo q cerrado via https://github.com/asrob-uc3m/impresoras-asrob/issues/160 : )

Closed 2022-02-26.

Thread 159 (2020-02-27):

Refuerzo Estructura Spicy

MrTommyGuns, 2020-02-27:
Hay que investigar en el siguiente link cual son las piezas que le valen a Spicy para posteriormente imprimirlo ya que considero que es una mejora que dota a la impresora de una notable rigidez, que falta le hace.

[Anet A8 Brackets to Reduce X-Axis Motion](https://www.thingiverse.com/thing:1872162)

GioSunrider, 2020-02-27:
Personalmente no recomiendo esta mejora, la quite de la impresora, no da mucha mas estabilidad y es muy engorrosa, recomiendo mejor esta otra.

https://www.thingiverse.com/thing:1672959

Closed 2023-09-28.

Thread 160 (2021-01-05):

Préstamo temporal de la tronxy aka Geonosis

MrTommyGuns, 2021-01-05:
Durante el segundo cuatrimestre voy a realizar un TFG donde muy probablemente tenga que imprimir piezas de tamaños superiores a los que mis impresoras de casa pueden abordar, por lo que me gustaría tomar prestada a Geonosis y llevármela a casa durante un tiempo este segundo cuatrimestre para poder realizar dichas piezas y pruebas.

Dada la situación supongo que no resultará ningún problema, por lo que si no recibo objeciones, la cogeré cuando pueda/la necesite(previo aviso por esta issue para que esté localizada y demás) .

Trataré de hacer un perfil de cura en primer lugar y así ya de paso podemos tener algo decente para el futuro.

JorFru, 2021-01-05:
Por mí es un sí.
Además, Tommy es uno de los participantes má activos de Printer One y tiene mis bendisiones.

MrTommyGuns, 2022-02-26:
Finalmente se **devolvió** el **14/09/2021** (se me pasó documentarlo por aquí en su momento).

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

Fue mejorada con refuerzos estructurales, una base más estable con filamento flexible a modo de patas para que no se deslice, un cambio de ventilador de capa junto con la pieza correspondiente y luces led con un interruptor para ver como va quedando la impresión bajo unas condiciones de luz nulas, entre otras, además de actualizaciones y ajustes de marlin.

Cumplió con su objetivo y me ayudó a realizar mi TFG con honor, esfuerzo y algún que otro quebradero de cabeza.

Se pueden ver los resultados [aquí](https://github.com/MrTommyGuns/Binaural3D) y a la bicha trabajando [aquí](https://www.instagram.com/stories/highlights/17895145640163810/).

Closed 2022-02-26.

Thread 161 (2021-02-06):

Cambio de directorios OctoPrint 0.18.0

MrTommyGuns, 2021-02-06:
He estado configurando una Raspi para poner en mi casa el tema de OctoPrint con las dos instancias y al parecer los directorios que hay que clonar para realizar la segunda instancia han cambiado con las nuevas actualizaciones.

Adjunto un video donde hace toda la instalación de Octoprint y realiza varias instancias para la misma Raspi.

[Octoprint Tips and Plugins - Octopi Images - Chris's Basement](https://www.youtube.com/watch?v=K0A-sIUBFfU&feature=emb_logo)

Deberíamos actualizar la guía que tenemos en la aso o al menos indicarlo. Creo que hasta la versión 0.17 lo que teníamos es válido.

Closed 2023-09-28.

Thread 162 (2023-09-28):

Dédalo Revival

CarlosME17, 2023-09-28:
Intento de revivir Dédalo.

## Reparar
- [ ] Mirar el estado de la mecánica.
- [ ] Mirar el estado del firmware/Marlin.
- [ ] Mirar electrónica y conexiones.
- [ ] Probar a imprimir alguna pieza.

## Mejoras
- [ ] Reimprimir piezas mecanicas.

Thread 163 (2023-09-28):

Geonosis Revival

CarlosME17, 2023-09-28:
Intento de revivir Geonosis.

## Reparar
- [ ] Mirar el estado de la mecánica.
- [ ] Mirar el estado del firmware/Marlin.
- [ ] Mirar electrónica y conexiones.
- [ ] Probar a imprimir alguna pieza.

## Mejoras
- [ ] Reimprimir piezas mecánicas.
- [ ] Actualizar electrónica.

jgvictores, 2025-01-11:
Resumen 18 de diciembre de 2024:

- Estuvimos mirando el manual de https://github.com/bigtreetech/Manta-M8P
- Comprobamos que los jumpers estaban ya para driver UART, y hemos colocado los drivers
- Extrajimos la tarjeta SD y cambiado la contraseña del wifi (al de mi móvil, de momento)
- Accedimos a la bigtree colocado en la impresora, vía ssh

Pending https://www.klipper3d.org/ entre otras muchas cosas.

jgvictores, 2025-01-15:
De pg 31/37, la nuestra es CB1 (aparece en red como `BTT-CB1`):
Login name: biqu
Password: biqu

[Uploading BIGTREETECH MANTA M8P V2.0 User Manual.pdf…]()

jgvictores, 2025-01-15:
Note that we already have: `/dev/serial/by-id/usb-Klipper_stm32h723xx_2C002B001351313433343333-if00`

jgvictores, 2025-01-15:
The command line of `make flash FLASH_DEVICE=` was already in the bash history.

MarckArthur, 2025-01-15:
probar utilizando ortoprint usando la ip de la impresora

jgvictores, 2025-01-22:
Vía web vía IP de la impresora:
```
Klipper reports: ERROR

Option 'position_endstop' is not valid in section 'stepper_z1'

Once the underlying issue is corrected, use the "RESTART"
command to reload the config and restart the host software.
Printer is halted
```

Nótese tb que está el Klipper log ( https://www.klipper3d.org/ ) y el Moonracker log ( https://moonraker.readthedocs.io/en/latest/ ). Viendo https://www.klipper3d.org/OctoPrint.html puede interesar OctoPrint y no Moonracker, pero aún no sé lo que es nada.

jgvictores, 2025-01-22:
```bash
 $ sudo service klipper status

● klipper.service - Klipper 3D Printer Firmware SV1
     Loaded: loaded (/etc/systemd/system/klipper.service; enabled; vendor preset: enabled)
     Active: active (running) since Wed 2025-01-15 15:38:25 UTC; 6 days ago
       Docs: https://www.klipper3d.org/
   Main PID: 801 (python)
      Tasks: 2 (limit: 1017)
     Memory: 32.7M
        CPU: 6.052s
     CGroup: /system.slice/klipper.service
             └─801 /home/biqu/klippy-env/bin/python /home/biqu/klipper/klippy/klippy.py /home/biqu/printer_data/config/printer.cfg -I >

Jan 15 15:38:25 BTT-CB1 systemd[1]: Started Klipper 3D Printer Firmware SV1.
```

jgvictores, 2025-01-22:
The files that appear via the web interface are those of `/home/biqu/printer_data/config`.

jgvictores, 2025-01-22:
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

Esto según https://github.com/Klipper3d/klipper/issues/4413#issuecomment-866253490 es que no le gusta que en `generic-bigtreetech-manta-m8p-V2_0.cfg` hayan ciertas cosas en la sección `stepper_z1` (porque prefiere tirar de `stepper_z1`, los considera duplicados), así que modificada sección `stepper_z1`:

```diff
- position_endstop: 0
- position_max: 270
- position_min: -5.0
- homing_speed: 8
- second_homing_speed: 3
- homing_retract_dist: 3
+ #j#position_endstop: 0
+ #j#position_max: 270
+ #j#position_min: -5.0
+ #j#homing_speed: 8
+ #j#second_homing_speed: 3
+ #j#homing_retract_dist: 3
```

Con esto ya no salen esos errores, sino que sale toda una sección buena `System Loads`:

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

jgvictores, 2025-01-22:
He estado jugando con los `Endstop` y detecta bien `Triggered` (cuando no se tocan) y `Open` (cuando se pulsan) en X, Y, Z. Entiendo que Z1 no sería necesario.

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

jgvictores, 2025-01-22:
Desde `Dashboard` intenté un Home All, y petó:

```
Klipper reports: SHUTDOWN

Unable to read tmc uart 'stepper_x' register IFCNT
Once the underlying issue is corrected, use the
"FIRMWARE_RESTART" command to reset the firmware, reload the
config, and restart the host software.
Printer is shutdown
```

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

jgvictores, 2025-01-22:
> Unable to read tmc uart 'stepper_x' register IFCNT

Según https://www.reddit.com/r/BIGTREETECH/comments/t7fm2h/getting_unable_to_read_tmc_uart_stepper_x/ hay que """Edite para, con suerte, salvar a otra persona que obviamente no lee las instrucciones lo suficientemente bien: recibía el mensaje "No se puede leer el registro IFCNT del tmc uart 'stepper_x'" porque no había conectado la fuente de alimentación de 24 V al "Motor". "Terminales de alimentación" del Octopus, por lo que los controladores paso a paso no recibían energía. Los conecté y todo está funcionando. Me lo perdí porque no había tenido que conectar una placa base como esta antes, así que si recibe este error, verifique que sus controladores estén recibiendo energía."""

jgvictores, 2025-01-29:
`DUMP_TMC STEPPER=stepper_x`

```
17:38
Unable to read tmc uart 'stepper_x' register GCONF
17:38
========== Queried registers ==========
17:38
SGTHRS:     00000000
17:38
TPOWERDOWN: 00000014 tpowerdown=20
17:38
COOLCONF:   00000000
17:38
TCOOLTHRS:  00000000
17:38
TPWMTHRS:   00000000
17:38
IHOLD_IRUN: 00081919 ihold=25 irun=25 iholddelay=8
17:38
SLAVECONF:  00000200 senddelay=2
17:38
========== Write-only registers ==========
```

jgvictores, 2025-01-29:
https://klipper.discourse.group/t/error-message-unable-to-read-tmc-uart-stepper-x-register-ifcnt/13945/7

jgvictores, 2025-01-29:
Se ha movido!

Parece que la lógica de los end-stops está invertida, para que se moviese X al darle a home tuve que mantenerlo pulsado. ^^

jgvictores, 2025-02-05:
> PD: También sería estético/conveniente cambiar los cables que puse por unos jumpers puentecillo de toda la vida.

Hecho!

> Parece que la lógica de los end-stops está invertida, para que se moviese X al darle a home tuve que mantenerlo pulsado. ^^

WIP, see https://www.reddit.com/r/klippers/comments/zp361r/endstop_trigger_setup/

jgvictores, 2025-02-05:
> Issue now regarding movement on Z axis: one motor shakes and the other motor seems not to move. Will review similar issues, may be due to cables but also current setup.

Vale no: one Z motor shakes, the other Z motor seems not to move, but the extruder does sound.

jgvictores, 2025-02-19:
Hecho:
- run_current: 0.800 en todos
- quemar fusible al activar cama

Ver:
- https://github.com/Klipper3d/klipper/blob/master/config/printer-tronxy-x5s-2018.cfg

jgvictores, 2025-02-26:
Por documentar lo que tenemos:

- bigtreetech cb1 v2.2
- manta m8p v2.0
- tmc 2226 v1.0 (x5)

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

jgvictores, 2025-03-12:
Pendiente:

Ver en placa el hueco que dejó el fusible, para ubicarlo en https://github.com/bigtreetech/Manta-M8P/blob/7151bd90f7e4223c01d95c6de6a844ac7fb60438/V2.0/Hardware/BIGTREETECH%20MANTA%20M8P%20V2.0-SIZE.pdf y sacar su nombre/identificador.

En https://github.com/bigtreetech/Manta-M8P/blob/7151bd90f7e4223c01d95c6de6a844ac7fb60438/V2.0/Hardware/BIGTREETECH%20MANTA%20M8P%20V2.0-SCH.pdf se ven claramente tres fusibles (F11, F12, F13) de 15 A, pero mejor sacar cuál es por ubicación puesto que en https://github.com/bigtreetech/Manta-M8P/issues?q=is%3Aissue%20state%3Aopen%20fuse me pareció ver menciones a otros valores.

jgvictores, 2025-03-12:
La inscripción es `JF 15A`, y en foros se refieren a ellos como `1808`.

Coincide la figura exacta con [Fusible JF 15A 125V 1808 nuevo y original de JFC2410-2150FS](https://spanish.alibaba.com/product-detail/JFC2410-2150FS-new-and-original-JF-1600101002040.html).

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

jgvictores, 2025-03-12:
Cosas que he hecho:
1. Ajustar mejor el volumen de impresión (límites más al límite ^^) vía https://github.com/asrob-uc3m/impresoras-asrob/commit/476626dc8487dfbce9fd517ea25e8f490362faf5
2. Solicitar el fusible:

> Como reemplazo, teniendo en que lo más importante es que sea rápido, 15A y su factor forma, me parece que la mejor opción es:
> https://www.amazon.es/piezas-fusible-15A250V-rotura-JFC2410-2150FS/dp/B0B4HLQTQP
> (hay un par de opciones más: https://www.hta3d.com/es/fusible-rapido-1808-10a-15a-20a-reemplazo-para-skr-2 parece oficial pero luego no parece que tengan 15A en stock sino 10A y 20A; por otro lado https://www.amazon.es/piezas-fusible-15A250V-rotura-JFC2410-2150FS/dp/B0B4HLQTQP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 también coincide en serigrafía pero pinta raruno y sería esperar por lo menos un mes).

jgvictores, 2025-03-12:
Está petando al rato con error:
> MCU 'mcu' shutdown: ADC out of range
> Sensor 'extruder' temperature -80.587 not in range 0.000:275.000
> This generally occurs when a heater temperature exceeds
its configured min_temp or max_temp.

Primero pensé que era porque quité el fusible bueno para medirlo, pero ahora leyendo el mensaje pienso que puede ser debido a la configuración del sensor (en https://github.com/asrob-uc3m/impresoras-asrob/commit/c062aca39db726131cd6737388fbd00145b2a6ff cambié el sensor, pero conste que estuvo funcionando bastante rato con esa config, ahora peta casi al momento).

jgvictores, 2025-04-03:
Fusibles!

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

jgvictores, 2025-04-09:
Fusible reemplazado! 🎉

Now:
```
MCU 'mcu' shutdown: ADC out of range

Sensor 'extruder' temperature -88.203 not in range 0.000:275.000

This generally occurs when a heater temperature exceeds
its configured min_temp or max_temp.
Once the underlying issue is corrected, use the
"FIRMWARE_RESTART" command to reset the firmware, reload the
config, and restart the host software.
Printer is shutdown
```

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

Related:

- https://www.reddit.com/r/klippers/comments/1bkc00g/why_klipper_wont_just_tell_us_which_heater_sensor

jgvictores, 2025-08-06:
Esta conexión es terriblemente sospechosa. Aparentemente:
- Sospechoso (rodeado en rojo): Cable que parece que lleva a sensor temperatura extrusor, conectado al conector de la placa identificado como VUSB que ni está marcado en manual como que se emplea demasiado.
- Tiene más sentido: Cable que parece que lleva a sensor temperatura cama, conectado al primer conector empezando por abajo de THB-TH3.

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

Pending también revisar tema fans.

jgvictores, 2025-08-06:
Okiii ya no hay problema de fuera de rango [0-275] (mide 28.8 grados) en extrusor!

Ahora no calienta:

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

jgvictores, 2025-09-24:
> * Eje extrusor.

Confirmo que intercambiando en placa conector X y extrusor, el motor extrusor se mueve como si fuese el X.

Thread 164 (2023-09-28):

Spicy Revival

CarlosME17, 2023-09-28:
Intento de revivir Spicy.

## Reparar
- [ ] Mirar el estado de la mecánica.
- [ ] Mirar el estado del firmware/Marlin.
- [ ] Mirar electrónica y conexiones.
- [ ] Probar a imprimir alguna pieza.

## Mejoras
- [ ] Reimprimir piezas mecanicas.
- [ ] A lo mejor actualizar electronica.

CarlosME17, 2023-09-28:
Mirado mecánica y electrónica: Todo bien.

Thread 165 (2023-09-28):

Blacky revival

CarlosME17, 2023-09-28:
Intento de revivir Blacky.

## Reparar
- [x] Mirar el estado de la mecánica.
- [ ] Mirar el estado del firmware/Marlin.
- [x] Mirar electrónica y conexiones.
- [ ] Probar a imprimir alguna pieza.

## Mejoras
- [ ] Reimprimir piezas mecanicas.
- [ ] A lo mejor actualizar electronica.
