asrob-uc3m/impresoras-asrob/Spicy/Marlin/Configuration.h

#define CONFIGURATION_H
#define CONFIGURATION_H_VERSION 010109
#define STRING_CONFIG_H_AUTHOR "GioSunrider " // Who made the changes. //GS
#define SHOW_BOOTSCREEN
#define STRING_SPLASH_LINE1 "Spicy Loading "             // will be shown during bootup in line 1 //GS
#define STRING_SPLASH_LINE2 "Marlin " SHORT_BUILD_VERSION // will be shown during bootup in line 2 //GS
#define SERIAL_PORT 0
#define BAUDRATE 115200 //GS
  #define MOTHERBOARD BOARD_ANET_10 //GS
#define CUSTOM_MACHINE_NAME "Spicy " //GS
#define MACHINE_UUID "ff413aeb-bf85-48af-abdd-d7e8c9626c0f" //GS
#define EXTRUDERS 1
#define DEFAULT_NOMINAL_FILAMENT_DIA 1.75 //GS
#define POWER_SUPPLY 0
#define TEMP_SENSOR_0 5
#define TEMP_SENSOR_1 0
#define TEMP_SENSOR_2 0
#define TEMP_SENSOR_3 0
#define TEMP_SENSOR_4 0
#define TEMP_SENSOR_BED 5
#define TEMP_SENSOR_CHAMBER 0
#define DUMMY_THERMISTOR_998_VALUE 25
#define DUMMY_THERMISTOR_999_VALUE 100
#define MAX_REDUNDANT_TEMP_SENSOR_DIFF 10
#define TEMP_RESIDENCY_TIME 6   // (seconds)
#define TEMP_HYSTERESIS 3       // (degC) range of +/- temperatures considered "close" to the target one
#define TEMP_WINDOW     1       // (degC) Window around target to start the residency timer x degC early.
#define TEMP_BED_RESIDENCY_TIME 6   // (seconds)
#define TEMP_BED_HYSTERESIS 3       // (degC) range of +/- temperatures considered "close" to the target one
#define TEMP_BED_WINDOW     1       // (degC) Window around target to start the residency timer x degC early.
#define HEATER_0_MINTEMP 5
#define HEATER_1_MINTEMP 5
#define HEATER_2_MINTEMP 5
#define HEATER_3_MINTEMP 5
#define HEATER_4_MINTEMP 5
#define BED_MINTEMP 5
#define HEATER_0_MAXTEMP 275
#define HEATER_1_MAXTEMP 275
#define HEATER_2_MAXTEMP 275
#define HEATER_3_MAXTEMP 275
#define HEATER_4_MAXTEMP 275
#define BED_MAXTEMP 130
#define PIDTEMP
#define BANG_MAX 255     // Limits current to nozzle while in bang-bang mode; 255=full current
#define PID_MAX BANG_MAX // Limits current to nozzle while PID is active (see PID_FUNCTIONAL_RANGE below); 255=full current
#define PID_K1 0.95      // Smoothing factor within any PID loop
  #define PID_FUNCTIONAL_RANGE 15 // If the temperature difference between the target temperature and the actual temperature
  #define DEFAULT_Kp 21.0 //GS
  #define DEFAULT_Ki 1.25 //GS
  #define DEFAULT_Kd 86.0 //GS
#define BED_LIMIT_SWITCHING
#define MAX_BED_POWER 255 // limits duty cycle to bed; 255=full current
#define PREVENT_COLD_EXTRUSION
#define EXTRUDE_MINTEMP 160  // 160 guards against false tripping when the extruder fan kicks on.
#define PREVENT_LENGTHY_EXTRUDE
#define EXTRUDE_MAXLENGTH 200
#define THERMAL_PROTECTION_HOTENDS // Enable thermal protection for all extruders
#define THERMAL_PROTECTION_BED     // Enable thermal protection for the heated bed
#define USE_XMIN_PLUG
#define USE_YMIN_PLUG
#define USE_ZMIN_PLUG
#define ENDSTOPPULLUPS
#define X_MIN_ENDSTOP_INVERTING true  // set to true to invert the logic of the endstop.
#define Y_MIN_ENDSTOP_INVERTING true  // set to true to invert the logic of the endstop.
#define Z_MIN_ENDSTOP_INVERTING true  // set to true to invert the logic of the endstop.
#define X_MAX_ENDSTOP_INVERTING false // set to true to invert the logic of the endstop.
#define Y_MAX_ENDSTOP_INVERTING false // set to true to invert the logic of the endstop.
#define Z_MAX_ENDSTOP_INVERTING false // set to true to invert the logic of the endstop.
#define Z_MIN_PROBE_ENDSTOP_INVERTING true  // set to true to invert the logic of the probe.
#define ENDSTOP_INTERRUPTS_FEATURE
#define DEFAULT_AXIS_STEPS_PER_UNIT   { 100, 100, 400, 100 } //GS
#define DEFAULT_MAX_FEEDRATE          { 400, 400, 8, 50 } //GS
#define DEFAULT_MAX_ACCELERATION      { 2000, 2000, 100, 10000 } //GS
#define DEFAULT_ACCELERATION          300     // X, Y, Z and E acceleration for printing moves  //GS
#define DEFAULT_RETRACT_ACCELERATION  1000    // E acceleration for retracts  //GS
#define DEFAULT_TRAVEL_ACCELERATION   800    // X, Y, Z acceleration for travel (non printing) moves //GS
#define DEFAULT_XJERK                 10.0 //GS
#define DEFAULT_YJERK                 10.0 //GS
#define DEFAULT_ZJERK                  0.3  //GS
#define DEFAULT_EJERK                  5.0  //GS
#define Z_MIN_PROBE_USES_Z_MIN_ENDSTOP_PIN
#define X_PROBE_OFFSET_FROM_EXTRUDER 0   // X offset: -left  +right  [of the nozzle]
#define Y_PROBE_OFFSET_FROM_EXTRUDER 0   // Y offset: -front +behind [the nozzle]
#define Z_PROBE_OFFSET_FROM_EXTRUDER 0   // Z offset: -below +above  [the nozzle]
#define MIN_PROBE_EDGE 10
#define XY_PROBE_SPEED 6000
#define Z_PROBE_SPEED_FAST HOMING_FEEDRATE_Z
#define Z_PROBE_SPEED_SLOW (Z_PROBE_SPEED_FAST / 2)
#define Z_CLEARANCE_DEPLOY_PROBE   10 // Z Clearance for Deploy/Stow
#define Z_CLEARANCE_BETWEEN_PROBES  5 // Z Clearance between probe points
#define Z_CLEARANCE_MULTI_PROBE     5 // Z Clearance between multiple probes
#define Z_PROBE_LOW_POINT          -2 // Farthest distance below the trigger-point to go before stopping
#define Z_PROBE_OFFSET_RANGE_MIN -20
#define Z_PROBE_OFFSET_RANGE_MAX 20
#define X_ENABLE_ON 0
#define Y_ENABLE_ON 0
#define Z_ENABLE_ON 0
#define E_ENABLE_ON 0 // For all extruders
#define DISABLE_X false
#define DISABLE_Y false
#define DISABLE_Z false
#define DISABLE_E false // For all extruders
#define DISABLE_INACTIVE_EXTRUDER true // Keep only the active extruder enabled.
#define INVERT_X_DIR false
#define INVERT_Y_DIR false
#define INVERT_Z_DIR true
#define INVERT_E0_DIR false
#define INVERT_E1_DIR false
#define INVERT_E2_DIR false
#define INVERT_E3_DIR false
#define INVERT_E4_DIR false
#define X_HOME_DIR -1
#define Y_HOME_DIR -1
#define Z_HOME_DIR -1
#define X_BED_SIZE 220  //GS
#define Y_BED_SIZE 220  //GS
#define X_MIN_POS -33
#define Y_MIN_POS -10
#define Z_MIN_POS 0
#define X_MAX_POS X_BED_SIZE  //GS
#define Y_MAX_POS Y_BED_SIZE  //GS
#define Z_MAX_POS 225         //GS
#define MIN_SOFTWARE_ENDSTOPS
  #define MIN_SOFTWARE_ENDSTOP_X
  #define MIN_SOFTWARE_ENDSTOP_Y
  #define MIN_SOFTWARE_ENDSTOP_Z
#define MAX_SOFTWARE_ENDSTOPS
  #define MAX_SOFTWARE_ENDSTOP_X
  #define MAX_SOFTWARE_ENDSTOP_Y
  #define MAX_SOFTWARE_ENDSTOP_Z
#define HOMING_FEEDRATE_XY (100*60)
#define HOMING_FEEDRATE_Z  (4*60)
#define EEPROM_SETTINGS   // Enable for M500 and M501 commands
#define EEPROM_CHITCHAT   // Give feedback on EEPROM commands. Disable to save PROGMEM.
#define BUSY_WHILE_HEATING            // Some hosts require "busy" messages even during heating
#define PREHEAT_1_TEMP_HOTEND 205 //GS
#define PREHEAT_1_TEMP_BED     55 //GS
#define PREHEAT_1_FAN_SPEED     0 // Value from 0 to 255
#define PREHEAT_2_TEMP_HOTEND 240 //GS
#define PREHEAT_2_TEMP_BED     90 //GS
#define PREHEAT_2_FAN_SPEED     0 // Value from 0 to 255
#define PREHEAT_3_TEMP_HOTEND 210 //GS
#define PREHEAT_3_TEMP_BED     40 //GS
#define PREHEAT_3_FAN_SPEED     0 // Value from 0 to 255
#define PREHEAT_4_TEMP_HOTEND 230 //GS
#define PREHEAT_4_TEMP_BED    100 //GS
#define PREHEAT_4_FAN_SPEED     0 // Value from 0 to 255
#define NOZZLE_PARK_FEATURE //GS
  #define NOZZLE_PARK_POINT { (X_MIN_POS + 10), (Y_MAX_POS - 10), 30 }
  #define NOZZLE_PARK_XY_FEEDRATE 100   // X and Y axes feedrate in mm/s (also used for delta printers Z axis)
  #define NOZZLE_PARK_Z_FEEDRATE 5      // Z axis feedrate in mm/s (not used for delta printers)
#define PRINTJOB_TIMER_AUTOSTART
#define LCD_LANGUAGE es //GS
#define DISPLAY_CHARSET_HD44780 JAPANESE
#define SDSUPPORT
#define ZONESTAR_LCD              // Requires ADC_KEYPAD_PIN to be assigned to an analog pin.
#define SOFT_PWM_SCALE 0
#define SERVO_DELAY { 300 }
