asrob-uc3m/impresoras-asrob/(commit log)

2016-06-21 Add files via upload
    Archivos de configuración de la impresora Hija Resurrection
2016-06-21 Archivos de configuración - Hija Resurrection
2016-06-21 Archivos de configuración - Blacky
2017-03-02 First commit for the firmware
    This is the Marlin 1.0.2-2 uploaded today to Hija Resurrection. Appears
    to work fine.
    [Configuration.h, Configuration_adv.h, Marlin Logo.dxf, Menu Plans.xlsx]
2017-03-06 Firmware wipe and reorganization
    [Configuration.h, Configuration_adv.h, Marlin Logo.dxf, Menu Plans.xlsx]
2017-03-14 Configuration.h de Blacky
    Primera versión
    [Configuration.h]
2017-04-28 Increased thermal runaway hysteresis and period
    [Configuration.h]
2017-04-28 Bed sizes adjusted
    [Configuration.h]
2017-05-03 Increased Thermal Runaway parameters and bed size adjusted
    [Configuration.h]
2017-10-03 Configuración inicial de Dedalo
2017-10-05 Add Dedalo's original Configuration.h file
    [Configuration.h]
2017-10-30 actualizado script de invitado
2017-10-30 Configuracion Actualizada de Dedalo
2017-11-13 New configuration files for Hija Resurrection
    [Configuration.h, Configuration_adv.h]
2017-11-28 Informacion de Print, Filament y Printer de Dedalo
2017-12-06 Add Dedalo custom parts
    [frame-vertex-no-foot.stl, frame-vertex.stl, mounting_plate.stl, wade_custom_obijuan.stl]
2017-12-09 Add Dedalo new parts
    [160mm_spool_holder_prusa.stl, S26_Jonaskuehling_gregs_wade_v3_arcol_jhead_x1.stl, x-carriage.stl]
2018-02-02 New extruder configuration and parts
    [Configuration.h, Gregs_Wade_Big_Gear_47.stl, Gregs_Wade_Body.stl, Gregs_Wade_Idler.stl, Gregs_Wade_Small_Gear_9.stl]
2018-02-02 New X carriage
    [x-carriage-24to30-gt2.stl]
2018-02-12 New extruder steps/mm
    [Configuration.h]
2018-02-15 PLA temperatures preset adjusted
    [Configuration.h]
2018-02-15 PLA temperature preset adjusted
    [Configuration.h]
2018-02-26 New BQ RAMPS for Hija Resurrection
    [Configuration.h, Configuration_adv.h]
2018-05-15 Rename Geonosis folder
    [Configuration.h, Configuration_adv.h]
2018-05-15 Remove Tronxy temporal folder
    [Configuration.h, Configuration_adv.h]
2018-09-19 First Anet commit
    [Anet_A8_Fan_Optimized.stl]
2018-09-19 Changed anet folder name
    [Anet_A8_Fan_Optimized.stl]
2018-09-19 Added geonosis Parts folder
    [Anet_A8_Fan_Optimized.stl]
2018-09-19 Added Geonosis Parts
    [Sym_equerre_moteur_X.STL, equerre_moteur_X.STL]
2018-10-03 renamed Spicy foler
    [Anet_A8_Fan_Optimized.stl]
2018-10-14 Parts up to date. Folder reorganized.
    [Bearing_Washer.stl, Blower_duct.stl, Body_E3dv6_Washer.stl, Gregs_Wade_Big_Gear_47.stl, Gregs_Wade_Body.stl, Gregs_Wade_Idler.stl, Gregs_Wade_Small_Gear_9.stl, Idler.stl]
2018-10-15 Reestructuración carpetas impresoras #104
    [Anet_A8_Fan_Optimized.stl, Configuration.h, Configuration_adv.h]
2018-10-15 Updated all but Spicy to 1.1.9
    [Configuration.h, Configuration_adv.h]
2018-10-16 Updated Dedalo drivers
    [Configuration.h]
2018-10-16 Blacky files updated
    [Configuration.h, Configuration_adv.h]
2018-10-24 Renamed fcstd1 to fcstd
    [N34.FCStd]
2018-10-31 Hija Resurrection files updated
    [Configuration.h, Configuration_adv.h]
2018-11-09 Printing profile
2019-01-30 Actualización partes Blacky
    [Bearing_Washer.stl, Blower_duct_v2.stl, Body_E3dv6_Washer.stl, Idler.stl, Idler_hodler.stl, Soporte_lcd.stl, lcd-hinge.stl]
2019-02-21 Enlace a piezas de repuesto
    Originalmente son para la impresora "Prusa I3 Hephestos" en la que se basa nuestra querida Blacky.
2019-06-05 Perfil para Cura
    Perfil base de Cura para realizar impresiones en Spicy.
    Sugiero utilizar este perfil para futuras impresiones e ir mejorandolo y adaptandolo a las necesidades de la máquina.
2019-06-05 Perfil Cura Hija
    Perfil base de Cura para realizar impresiones en Hija.
    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
2019-10-31 Update steps per unit
    [Configuration.h]
2020-04-01 Update Version Marlin 2.0.5.2
    [Configuration.h, Configuration_adv.h]
2021-02-23 Marlín Funcional y Pulido
    Subo la última versión del marlin funcional fixeado por Giorgio ya que la anterior subida no funcionaba.
    Además he terminado de pulir los pasos por mm del extrusor.
    Cuando me pasó Gio el marlin tuve problemas para compilarlo. Se solucionaron descargando el marlin de aquí:
    https://github.com/MarlinFirmware/Marlin/issues/15705
    [Configuration.h]
